NicolaiFransen/Semester-Project-PED1/Reports/P0/P0.tex

\input{../Preamble/Preamble}
\usepackage[export]{adjustbox}

\newcommand\tab[1][1cm]{\hspace*{#1}}

\begin{document}
	
\begin{titlingpage}

\newcommand{\HRule}{\rule{\linewidth}{0.1mm}} % Defines a new command for the horizontal lines, change thickness here

\vspace*{-2cm}
\begin{figure}[htbp]
	\begin{center}
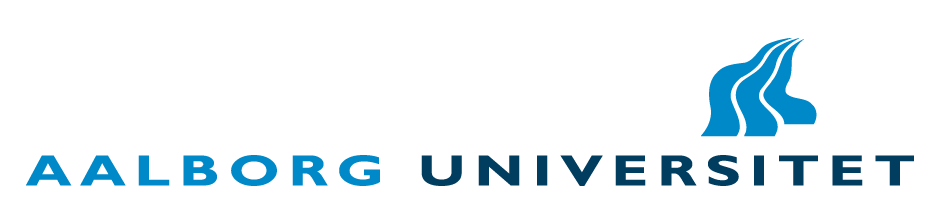
[picture p1: Reports/Pictures/AAU_logo.png]
		
		\label{aau_logo}
	\end{center}	
\end{figure}

\vspace*{2cm}
\begin{figure}[htbp]
	\begin{center}
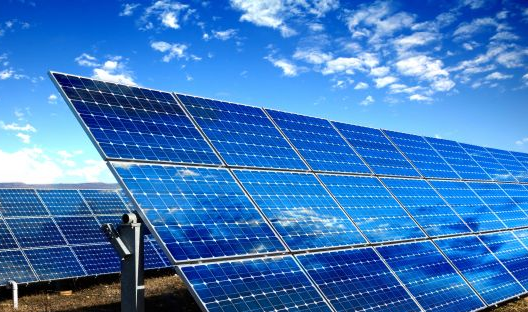
[picture p2: Reports/Pictures/frontpage_pvpanel.png]
		
		\label{frontpage}
	\end{center}	
\end{figure}

\begin{center}
\vspace*{0.5cm}
\HRule \\[0.8cm]
{\huge \bfseries \textsc{DC-DC Converter for PV Module Integration}}\\[0.2cm]
\HRule \\[1.5cm]

\textsc{\textbf{Estefanía Ruiz, Aitor Teran, Nicolai H. Fransen, Jesper Kloster, Thassilo Lang \& Nicolás Murguizur Bustos}}

\vspace*{1cm}
\textsc{\textbf{Supervisors: Lajos Török \& Dezso Sera}}
\end{center}
\end{titlingpage}

\vspace*{1cm}
\begin{table}[H]
	\begin{tabular}{l l} 
		\textbf{Title} &  \textbf{DC-DC Converter for PV Module Integration} \\ 
		\textbf{Semester} & \textbf{$7^{th}$ INTRO}  \\ 
		\textbf{Project Period} & \textbf{10.09.2018 - 19.12.2018}  \\ 
		\textbf{ECTS} &  \textbf{10}\\ 
		\textbf{Supervisors} & \textbf{Lajos Török \& Dezso Sera}  \\ 
		\textbf{Group} & \textbf{INTRO-760}  \\ 
	\end{tabular}
\end{table}

%\vspace*{1cm}
\begin{center}	
	\vspace{40pt}
	\begin{minipage}{0.4\linewidth}
		\centering
		\hrule
		\vspace{12pt}
		Estefanía Ruiz\\ 
		20181097
	\end{minipage}
	\hspace{10pt}
	\vspace{40pt}
	\begin{minipage}{0.4\linewidth}
		\centering
		\hrule
		\vspace{12pt}
		Aitor Teran\\ 
		20186474	
	\end{minipage}
	\hspace{10pt}
	\vspace{40pt}
	\begin{minipage}{0.4\linewidth}
		\centering
		\hrule
		\vspace{12pt}
		Nicolai H. Fransen\\
		20181094
	\end{minipage}
	\hspace{10pt}
	\begin{minipage}{0.4\linewidth}
		\centering
		\hrule
		\vspace{12pt}
		Jesper Kloster\\
		20181081 
	\end{minipage}
	\hspace{10pt}
	\begin{minipage}{0.4\linewidth}
		\centering
		\hrule
		\vspace{12pt}
		Thassilo Lang\\ 
		20186559 
	\end{minipage}
	\hspace{10pt}
	\vspace{20pt}
	\begin{minipage}{0.4\linewidth}
		\centering
		\hrule
		\vspace{12pt}
		Nicolás Murguizur Bustos\\ 
		20181086
	\end{minipage}
\end{center}

%\vspace{3cm}
\begin{tcolorbox}
\textbf{Synopsis:}\newline
PV modules must work at their maximum power point in order to achieve the highest overall efficiency. Several environmental conditions can affect the output power of the PV modules.\newline
This project will address these problems, by implementing a MIC including a MPPT algorithm. The MIC will minimize the power losses and therefore increase the efficiency.\newline
The purpose of this report is to define the boundaries of the project. This includes the main objectives and the initial research. Furthermore there have been included a gantt chart of the entire project.
\end{tcolorbox}

\vspace*{0.5cm}
\textbf{By signing the document, members of the group accepts that the entire group have participated in the work of the report. Therefore, all members vouch for the content of the report, and confirms that it doesn't include plagiarism.}

\clearpage
\tableofcontents

\input{docs/preface.tex}
\input{docs/summary.tex}
\input{docs/Nomenclature.tex}

\input{docs/introduction/introduction.tex}
\input{docs/problemAnalysis/problemAnalysis.tex}
\input{docs/background/background.tex}
\input{docs/futureWork/futureWork.tex}
\input{docs/appendix/appendix}

%\clearpage

\printbibliography

\end{document}
