NicolaiFransen/Semester-Project-PED1/Reports/P1/docs/frontpage.tex

\pdfbookmark[0]{Front page}{label:frontpage}%
\begin{titlepage}
\vspace*{\fill}
    \backgroundsetup{
    scale=1.1,
    angle=0,
    opacity=1.0,  %% adjust
    contents={}
    }
  \addtolength{\hoffset}{0.5\evensidemargin-0.5\oddsidemargin} %set equal margins on the frontpage - remove this line if you want default margins
  \noindent%
  {\color{white}\fboxsep0pt\colorbox{aaublue}{\begin{tabular}{@{}p{\textwidth}@{}}
    \begin{center}
    \Huge{\textbf{
      DC-DC Converter for PV Module Integration% insert your title here
    }}
    \end{center}
    \begin{center}
      \Large{
        %Development of a predictive model% insert your subtitle here
      }
    \end{center}
    %\vspace{0.2cm}
   \begin{center}
    {\Large
     Estefanía Ruiz, Aitor Teran, Nicolai Fransen, Jesper Kloster, Thassilo Lang,  Nicolás Murguizur Bustos% insert names separated by comma
    }\\
    \vspace{0.4cm}
    {\large
      Energy Technology, INTRO-760, 2018-12% insert name of study, group number, year-month
    }
   \end{center}
   \vspace{0.2cm}
%% Comment this section in if you are doing Bachelor or Master Project   
   \begin{center}
    {\Large
      Master's Project
      %Bachelor Project
    }
   \end{center}
  \end{tabular}}}
  \vfill
  \begin{center}
    % comment this line in for English version
    %\includegraphics[width=0.2\paperwidth]{AAUgraphics/aau_logo_circle_da} %comment this line in for Danish version
  \end{center}
\end{titlepage}
\clearpage
