NicolaiFransen/Semester-Project-PED1/Reports/P1/docs/Appendix/openloop_ripple_sim.tex

%%% Appendix including ripple stuf %%%

\chapter{Open-loop ripple results}
\vspace{-1cm}
The measurements of the current and the voltage ripples are included in this section. Furthermore the section is divided in the simulation and experimental results.
 \label{app:OL_ripple}
 
\section{Simulation}
The figures in this section show the waveforms of the current and voltage ripples under worst case conditions. These conditions have been described during the calculations of the passive components in section \ref{component_sizing}. The maximum, minimum and mean values are read and used to calculated the ripples in section \ref{opsimresult}. The data from the simulations have been loaded into Matlab to achieve accurate readings.

Figure \ref{fig:inductor_ripple} shows the current ripple in the inductor. The maximum and minimum currents are read as $I_{max} = 3.465A$ and $I_{min} = 3.135A$, with a mean at $\widebar{I_L} = 3.3A$.

Figure \ref{fig:output_voltage_ripple} shows the voltage ripple at the output capacitor. The maximum and minimum voltages are read as $V_{max} = 55.156$ and $V_{min} = 54.879V$, with a mean at $\widebar{V_{out}} = 55.018V$. 

Figure \ref{fig:input_voltage_ripple} shows the voltage ripple at the input capacitor. The maximum and minimum voltages are measured as $V_{max} = 36.9419V$ and $V_{min} = 36.905V$, with a mean at $\widebar{V_{in}} = 36.9235V$.

\begin{figure}[H]
	\begin{minipage}[c]{0.5\textwidth}
		\centering
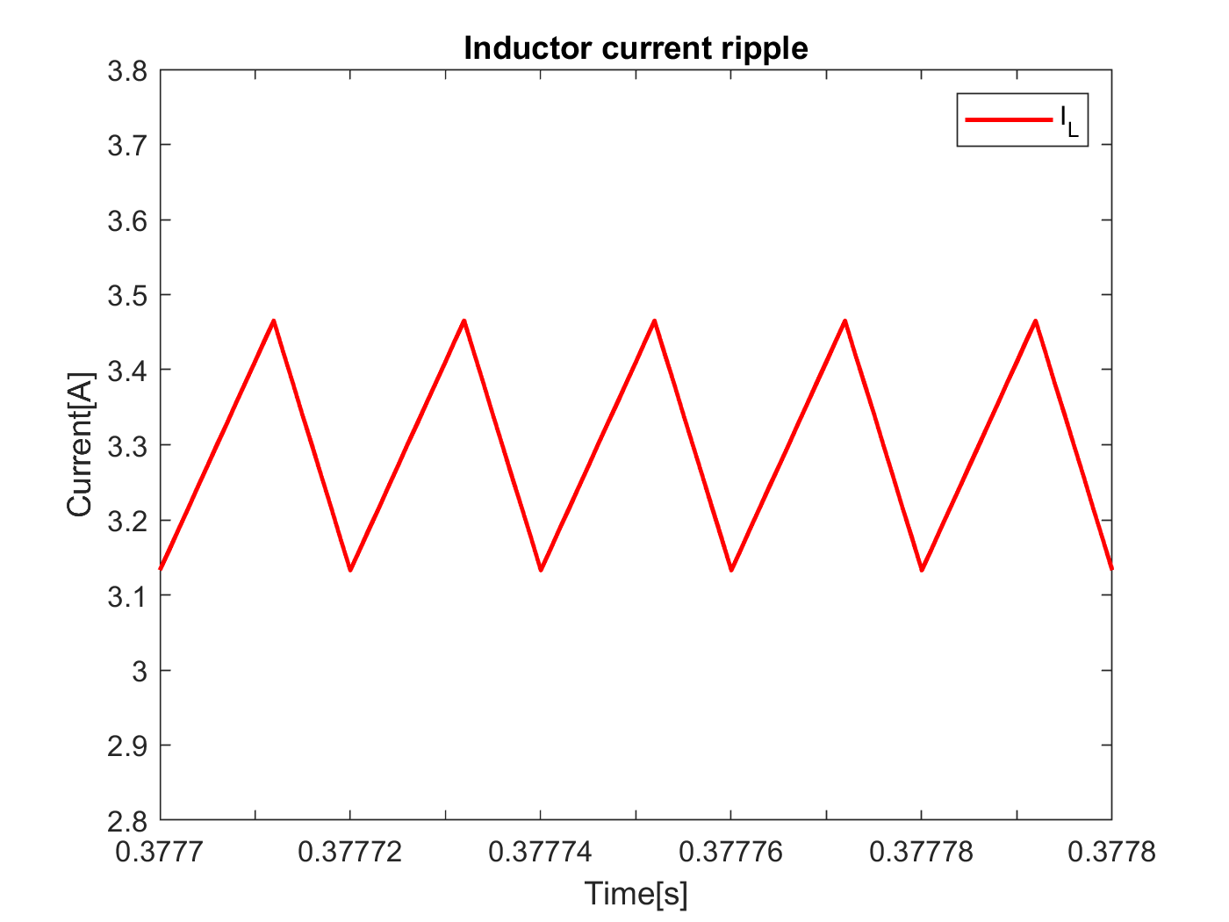
[picture p7: Reports/Pictures/P1/Open_loop_simulation/open_loop_IL_ripple.png]
		 % Left picture
		\caption{Inductor current ripple.}
		\label{fig:inductor_ripple}
	\end{minipage}
	\hfill
	\begin{minipage}[c]{0.5\textwidth}
		\centering
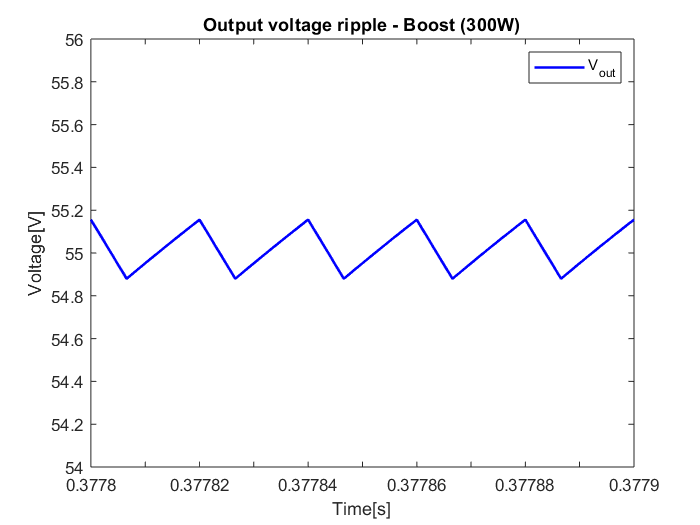
[picture p8: Reports/Pictures/P1/Open_loop_simulation/open_loop_Vout_ripple.png]
		 % Right picture
		\caption{Output voltage ripple.}
		\label{fig:output_voltage_ripple}
	\end{minipage}  
\end{figure}

\begin{figure}[H]
	\begin{center}
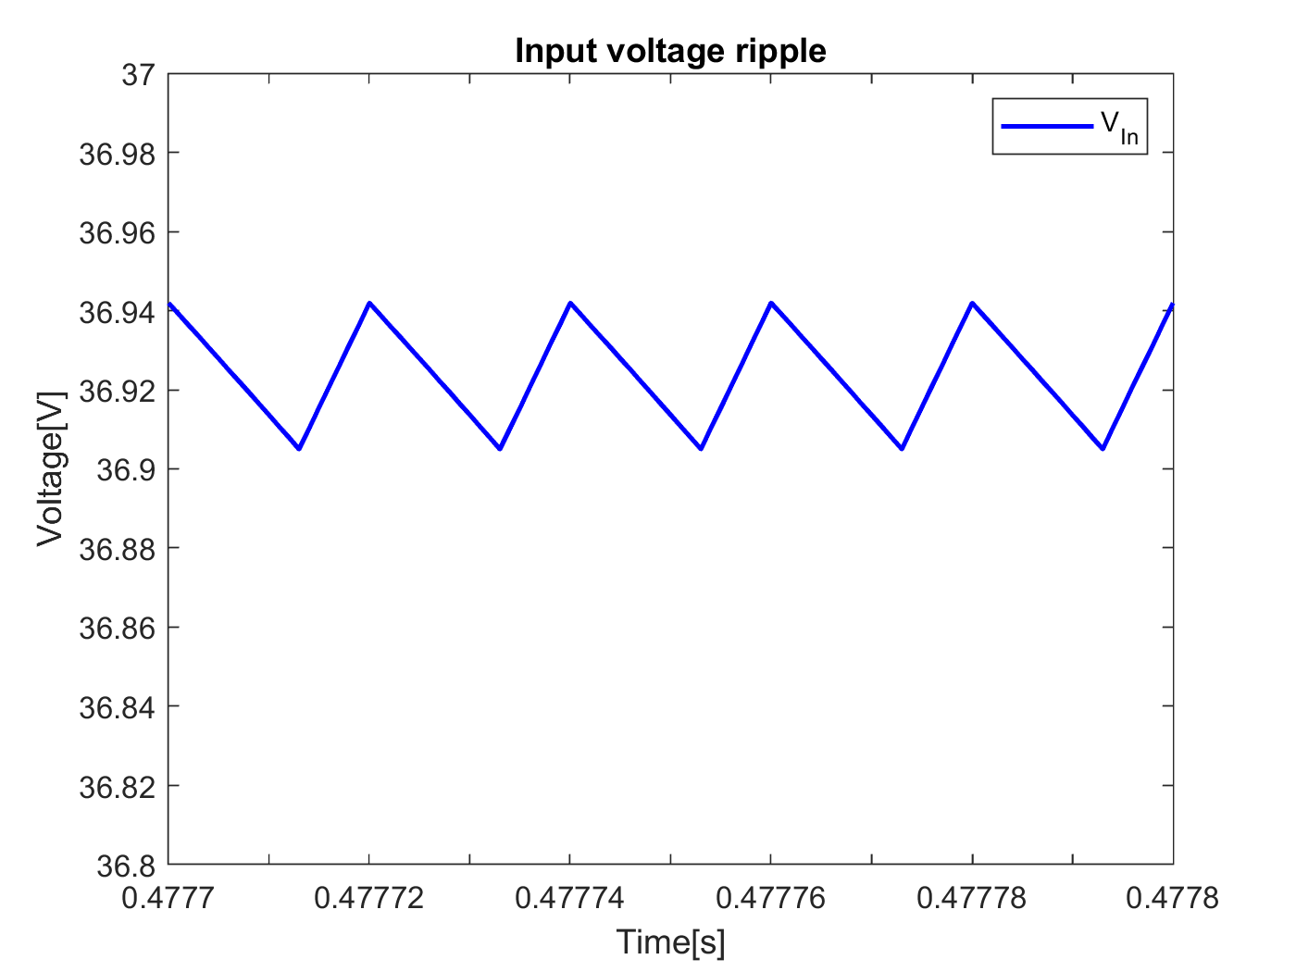
[picture p9: Reports/Pictures/P1/Open_loop_simulation/open_loop_Vin_ripple.png]
		
		\caption{Input voltage ripple.}
		\label{fig:input_voltage_ripple}
	\end{center}	
\end{figure}

\section{Experiment}

The signal of the input capacitor voltage is not clear enough to determine a ripple \ref{Openlooptestinputcapacitor}, the observed behavior might be due to ringing.

\begin{figure}[H]
	\begin{center}
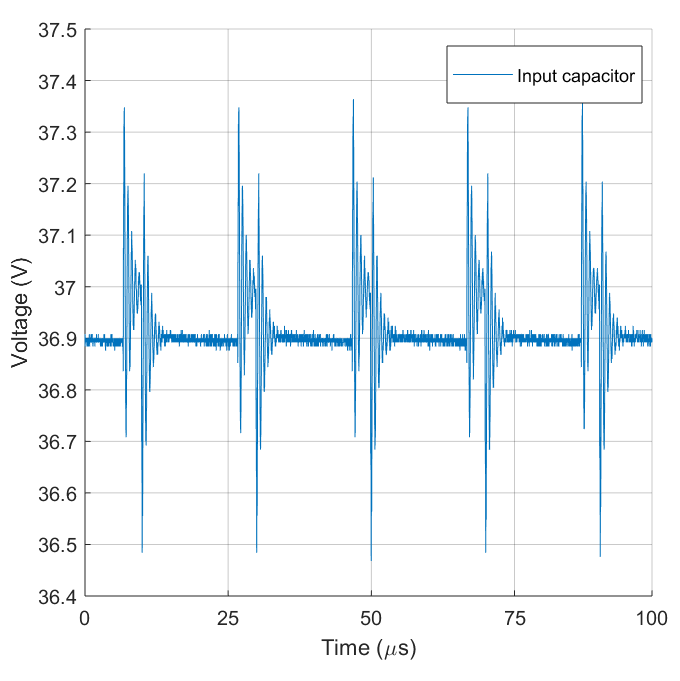
[picture p10: Reports/Pictures/P1/Test/Openloopinputcapacitor.png]
		
		\caption{Open-loop test: Input capacitor ripple.}
		\label{Openlooptestinputcapacitor}
	\end{center}	
\end{figure}

The figure \ref{Openlooptestoutputtcapacitor} presents the voltage ripple at the output capacitor. For the equation \ref{eq:output_voltage_rippleexperiment} the values $V_{out,max} = 23.908V$, $V_{out,min} = 23.895V$ and $\widebar{V_{out}} = 23.902V$ are used from the figure  \ref{Openlooptestoutputtcapacitor}.

\begin{figure}[H]
	\begin{center}
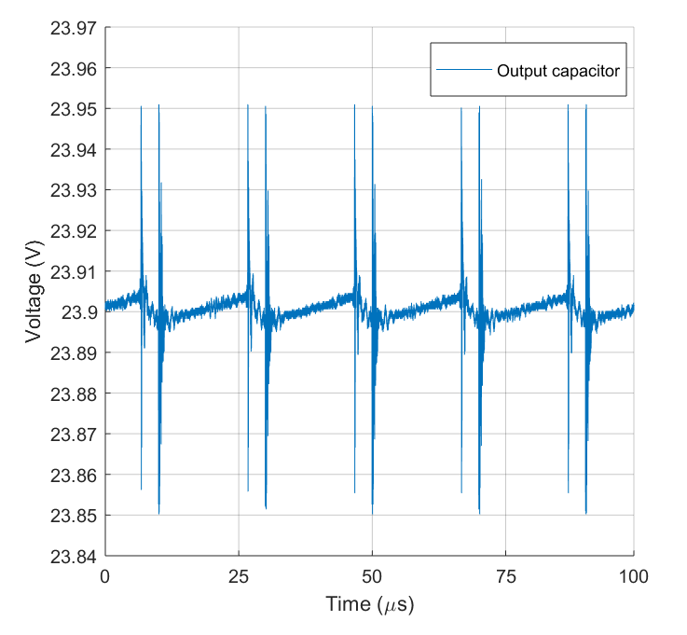
[picture p11: Reports/Pictures/P1/Test/Openloopoutputcapacitor.png]
		
		\caption{Open-loop test: Output capacitor ripple.}
		\label{Openlooptestoutputtcapacitor}
	\end{center}	
\end{figure}

The figure \ref{Openlooptestinductor} shows the current ripple at the inductor. From this figure it can be obtained  the minimum current as $I_{min} = 2.70A$ and the maximum current as $I_{max} = 2.98A$. The mean value for the inductor current is $\widebar{I_L}= 2.84$.

\begin{figure}[H]
	\begin{center}
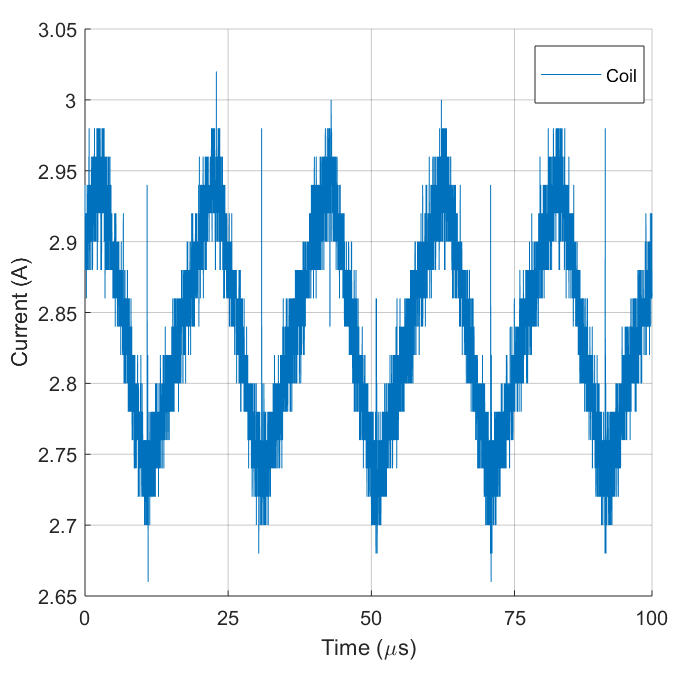
[picture p12: Reports/Pictures/P1/Test/Openloopinductor.png]
		
		\caption{Open-loop test: Inductor current ripple.}
		\label{Openlooptestinductor}
	\end{center}	
\end{figure}
