NicolaiFransen/Semester-Project-PED1/Reports/P1/docs/hardwareImplementation/hardwareImplementation.tex

%%% Chapter 5 - Hardware Implementation %%%

\chapter{Hardware implementation} \label{ch:hardware_implementation}
\input{docs/hardwareImplementation/intro.tex}

\section{Selection of commercial components}

\subsection{Passive components}

Passive components include input and output capacitors and the inductor. The needed values were calculated in section \ref{component_sizing}. However, no tolerance or safety margin are included in those calculations. By the nature of the project, the goal is not to optimize price or size, but to validate the technical feasibility of the MPPT. 

The necessary input capacitance is $1540 \mu F$. A safety margin of $20 \%$ has been applied resulting in a necessary input capacitance of $1850 \mu F$. In order to achieve this value, 4 capacitors have been associated in parallel. When paralleling the capacitors the total parasitic inductance and resistance will decrease and ease the heat dissipation task \cite{capacitor_paracitics}. Four electrolytic capacitors of $470\mu F$ \cite{cin} are placed in parallel to get a summed capacitance of $1880\mu F$. The voltage rating for these is 100V. Because of an early calculation error the output capacitor was selected to be $820\mu F$\cite{cout}, instead of the $88\mu F$ calculated in section \ref{component_sizing}.

Both for the input and output a $100nF$ and a $1\mu F$ capacitors are placed in parallel. These capacitors are SMD technology which have intrinsically low parasitic components. The goal is to support the higher capacitance capacitors during high frequency current peaks\cite{paracitics_stuff}.

The calculated inductance is $1.3 mH$. The inductor is chosen to be a reused inductor from an earlier project, and is measured to have an inductance of $1.93mH$ at $50kHz$. 

\input{docs/converterDesign/Component_sizing/mosfet.tex}
\input{docs/converterDesign/Component_sizing/driver.tex}

\input{docs/converterDesign/sensors/sensors.tex}

\input{docs/converterDesign/component_sizing/power_supplies.tex}

\input{docs/hardwareImplementation/PCB_layout/Schematic.tex}

\input{docs/hardwareImplementation/PCB_layout/PCB_layout.tex}
