NicolaiFransen/Semester-Project-PED1/Reports/P1/docs/controlsystemdesign/controlsystemdesign.tex

%%% This document includes Maximum Power Point Trackingm %%%

\chapter{Maximum power point tracking} \label{MPPT}

\input{docs/controlsystemdesign/MPPT/introduction_MPPT.tex}
%\input{docs/controlsystemdesign/MPPT/Selection_of_MPPT_algorithm.tex}
\input{docs/controlsystemdesign/MPPT/Implementation_of_Perturbobserve_algorithm.tex}
\input{docs/controlsystemdesign/MPPT/Simulation_of_MPPT_algorithm.tex}
