NicolaiFransen/Semester-Project-PED1/Reports/P1/docs/converterDesign/converterDesign.tex

%%% This document includes the Hardware design of the converter %%%

\chapter{Non-inverting buck-boost converter design} \label{converter_design}
\input{docs/converterDesign/intro.tex}

\input{docs/P0/background/selection.tex}

\input{docs/converterDesign/component_sizing/component_sizing.tex}
