NicolaiFransen/Semester-Project-PED1/Reports/P1/docs/converterDesign/intro.tex

%%% Introduction to the chapter: Non-inverting buck-boost converter design %%%

This chapter contains the analysis of the non-inverting buck-boost converter. The first part contains the selection of the converter's topology and the requirements which will be used during the design phase of the project. The second part includes the sizing of the passive components and the results of the open-loop simulation of the converter.
