NicolaiFransen/Semester-Project-PED1/Reports/P1/docs/Appendix/PCBandSCH.tex

\chapter{PCB layout and schematics}\label{ch:AppPCB} 

\begin{figure}[H]
	\begin{center}
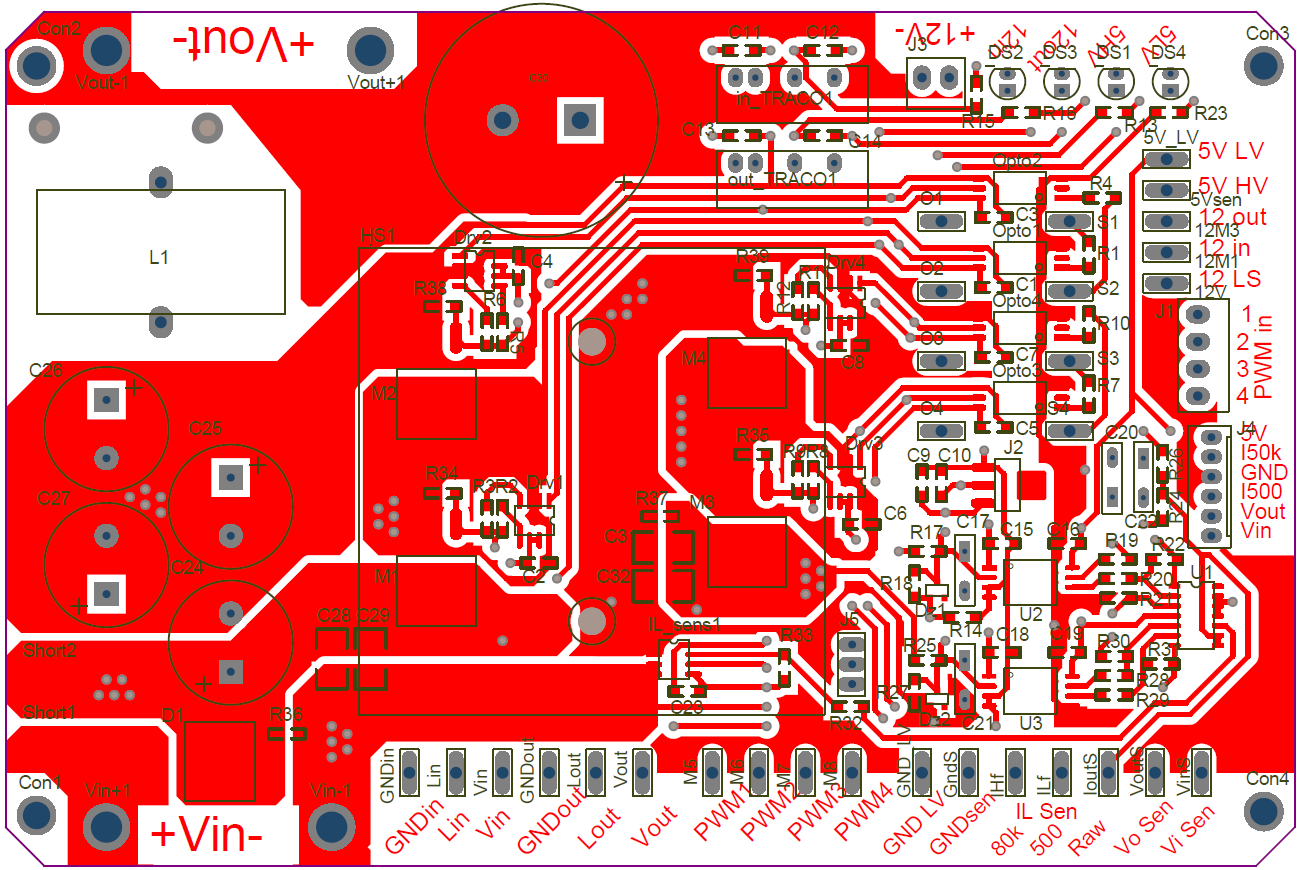
[picture p18: Reports/P1/docs/Appendix/PCB_TopLayer.PNG]
		
		\caption{PCB top layer.}
		\label{PCB_TopLayer}
	\end{center}	
\end{figure}

\begin{figure}[H]
	\begin{center}
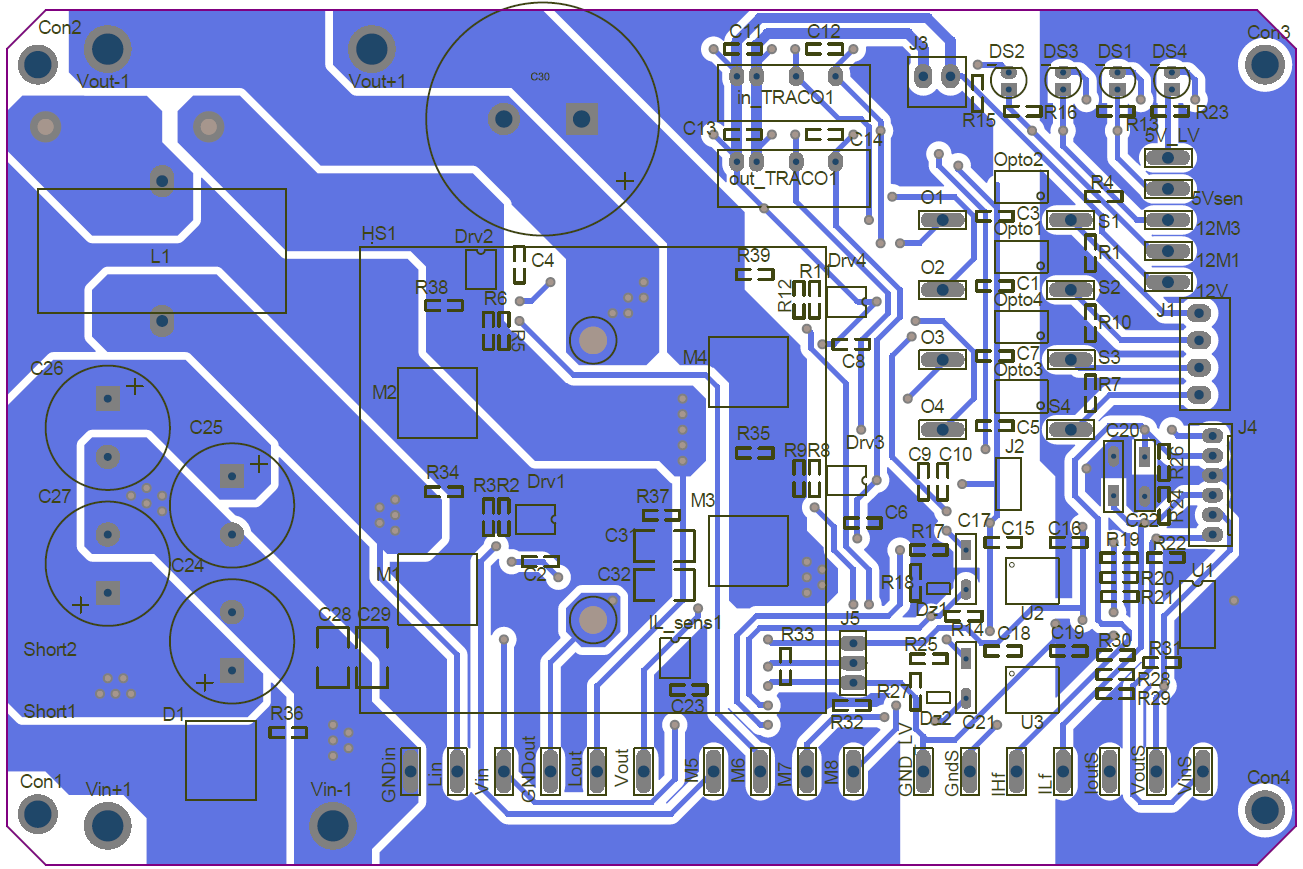
[picture p19: Reports/P1/docs/Appendix/PCB_BottomLayer.PNG]
		
		\caption{PCB bottom layer.}
		\label{PCB_BottomLayer}
	\end{center}	
\end{figure}

\includepdf[pages=-, landscape=true]{docs/Appendix/SCH_MIC_760_V2.pdf}
