NicolaiFransen/Semester-Project-PED1/Reports/P1/docs/controlsystemdesign/MPPT/Simulation_of_MPPT_algorithm.tex

\section{Simulation of the MPPT algorithm} \label{MPPTSimulation}

The results obtained in simulation for the previously explained P\&O algorithm will be shown in this section. First, the results corresponding to the PV panel model will be evaluated without connecting it to the DC-DC converter. Once the model for the PV panel is validated, the results obtained for the complete system will be analyzed in order to show the performance of the MPPT algorithm under different environmental conditions and resistive loads.  

\subsection{Model of the PV panel}

This section shows the model and the results obtained from a commercial solar panel selected for the development of this project. The PV panel which will be utilized for the test of the MPPT is \textit{Suntech STP300-24/Vd} \cite{PV_panel}. As a result of the PV panel's model, the characteristic curves of the panel will be presented showing its behavior under variations in solar irradiance and temperature.

One of the most common methods for modeling a solar panel is using the equivalent circuit of a solar cell shown in figure \ref{fig:eq_circuit_PVcell}. The model can be represented as a current source connected in parallel and reversed polarity with a diode \cite{MPPTResearch}. In addition, to model the non-linear behaviour of the solar panel I-V curve the equivalent series and parallel resistance ($R_{s}$ and $R_{p}$) are inserted \cite{MPPTResearch}.

\begin{figure}[H]
	\begin{center}
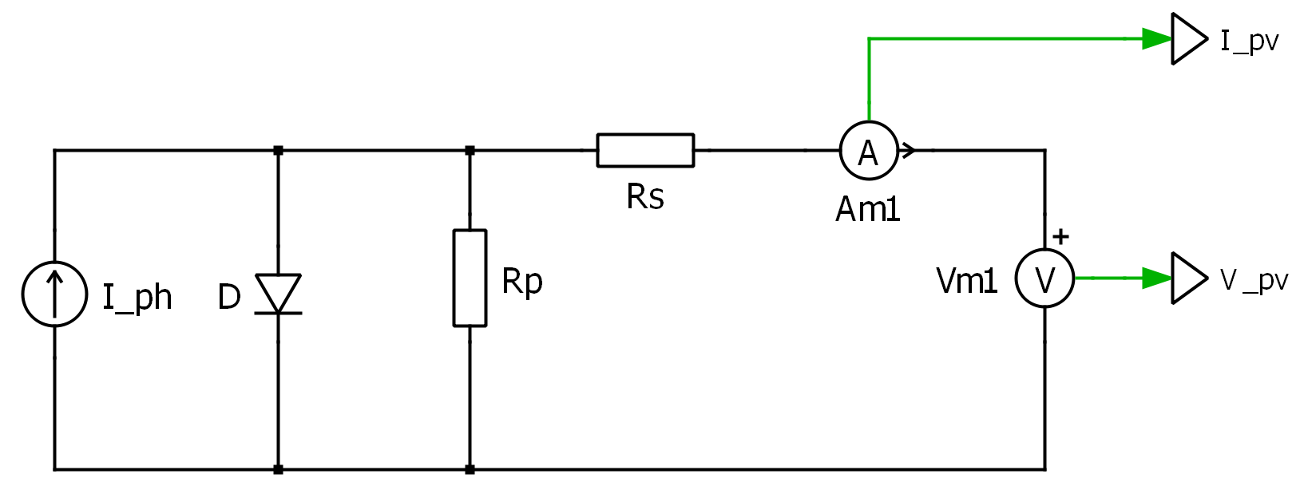
[picture p24: Reports/Pictures/schematic_solar_cell.png]
		
		\caption{Equivalent circuit for modeling a PV cell.}
		\label{fig:eq_circuit_PVcell} 
	\end{center}	
\end{figure}

The mathematical equation that describes the circuit is obtained applying Kirchoff's law to separate the current flowing through the different components of the circuit. This results in equation \ref{eq:pv_cell} where $I_{PV}$ is the panel's current, $I_{ph}$ is the photogenerated current, the second term is the current flow in the diode and the last term is the current flow in the parallel resistance \cite{MPPTResearch}. 

\begin{equation} \label{eq:pv_cell}
I_{PV} = I_{ph} - I_{o} \cdot \left[ e^{\left({\dfrac{V_{PV} + R_s\cdot I_{PV}}{a \cdot V_{t}}}\right)}  - 1 \right]  - \dfrac{V_{PV} + R_{s}\cdot I_{PV}}{R_{p}}
\end{equation}

The second term corresponds to the Shockley equation where $I_{o}$ is the saturation current of the diode, $a$ is the diode's quality factor and $V_{t}$ is the thermal voltage defined by equation \ref{eq:Vt}.

\begin{equation} \label{eq:Vt}
V_{t}=\dfrac{N_{cells}\cdot K\cdot T}{q} 
\end{equation}

$N_{cells}$ is the number of series connected cells (in this case 72), K is the Boltzmann constant ($1.38 \cdot 10^{-23} J/K$), T is the temperature in kelvins and q is the electrical charge ($1.6 \cdot 10^{-19} C$) \cite{MPPTResearch}.

However, as the focus of this project is not the modelling of the PV panel, the value of the PV panel's parameters such as $R_{s}$, $R_{p}$ and $a$ required for the model will not be calculated. Instead, these values will be taken from the corresponding PV array block for the selected panel available in Simulink. All the values for the PV panel's electrical parameters corresponding to Standard Test Conditions (STC) are shown in table \ref{el_charact_PV_panel_Suntech}.

\begin{table}[H]
	\centering
	\begin{tabular}{|p{8cm}|>{\centering}p{6cm}|}
		\hline
		\rowcolor{lightgray}\multicolumn{2}{|l|}{ \textbf{Electrical characteristics under STC}} 
		\\ \hline
		Maximum power ($P_{max}$) & 300.4 [W]  \tabularnewline \hline
		Optimum Operating Voltage ($V_{MPP}$) & 36.9 [V]  \tabularnewline \hline
		Optimum Operating Current ($I_{MPP}$) & 8.14 [A]  \tabularnewline \hline
		Open Circuit Voltage ($V_{OC}$) &  45 [V] \tabularnewline \hline
		Short Circuit Current ($I_{S C}$) & 8.67 [A]  \tabularnewline \hline
		Module Efficiency ($\eta$) & 15.5 \%  \tabularnewline \hline
		Operating Module Temperature & -40$\dec$C to +85$\dec$C \tabularnewline \hline
		Series Resistance ($R_{s}$) & 0.266 [$\Omega$] \tabularnewline \hline
		Parallel Resistance ($R_{p}$) & 665.2 [$\Omega$] \tabularnewline \hline
		Diode quality factor ($a$) & 1.1098 \tabularnewline \hline
	\end{tabular}
	\caption{Electrical characteristics PV module \textit{Suntech STP300-24/Vd} \cite{PV_panel}.}
	\label{el_charact_PV_panel_Suntech}
\end{table}

Using the aforementioned model of the PV panel, it is possible to obtain the characteristic curves of the panel.  Usually, PV panels are tested under STC to indicate the performance of the PV modules. The STC test is carried out with a cell's temperature of $25^\circ$C and at a solar irradiance of 1000 $W/ m^2$ \cite{handbook}. The higher the solar irradiance, the more power is generated from the PV panel. On the other hand, when the temperature of the PV cell increases the PV panel generates less power than at a lower temperature \cite{handbook}. 

Figures \ref{fig:PVcurves_T25} and \ref{fig:IVcurves_T25} show the P-V and I-V curves of the solar panel with constant cell temperature ($T=25\dec C$) and varying the level of irradiance. 
As expected, the lower the level of irradiance the maximum power that the panel is capable of generating decreases. It can be validated that under STC the values for $V_{MPP}$ and $I_{MPP}$ from table \ref{el_charact_PV_panel_Suntech}  correspond to the values obtained in simulation. Table \ref{constantemptable} shows that a change in irradiance has as a consequence a high variation in $I_{MPP}$ but $V_{MPP}$ does not reflect a significant variation.  

\begin{figure}[H]
	\begin{center}
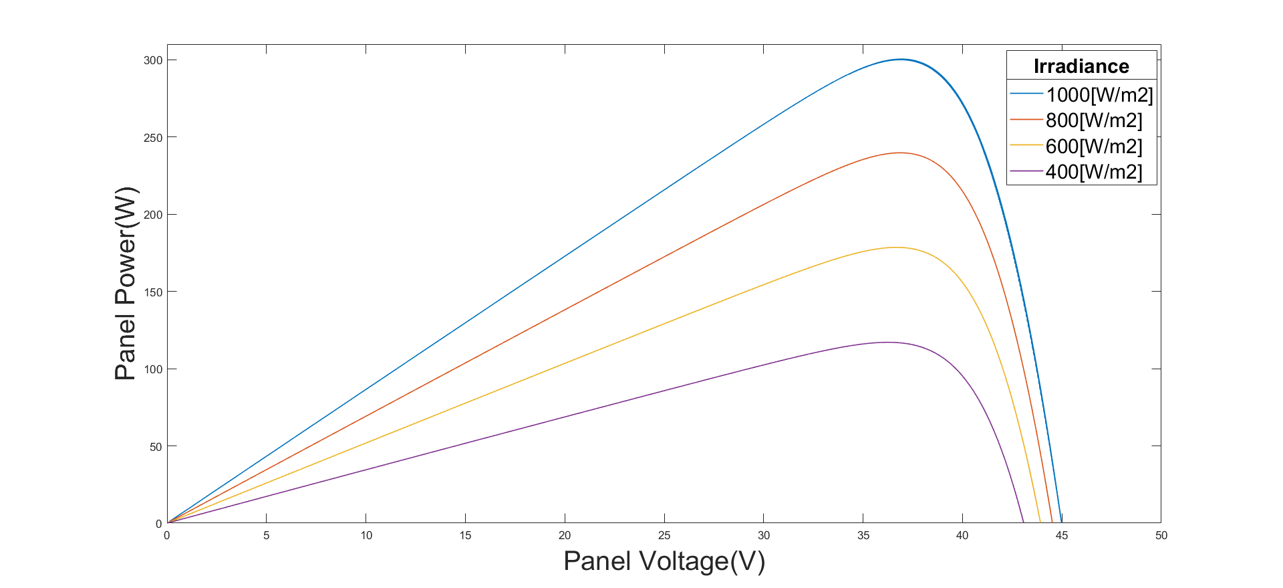
[picture p25: Reports/Pictures/constant_temperature.png]
		
		\caption{P-V curves for constant temperature (25$\dec$C) and change in irradiance.}
		\label{fig:PVcurves_T25} 
	\end{center}	
\end{figure}

\begin{figure}[H]
	\begin{center}
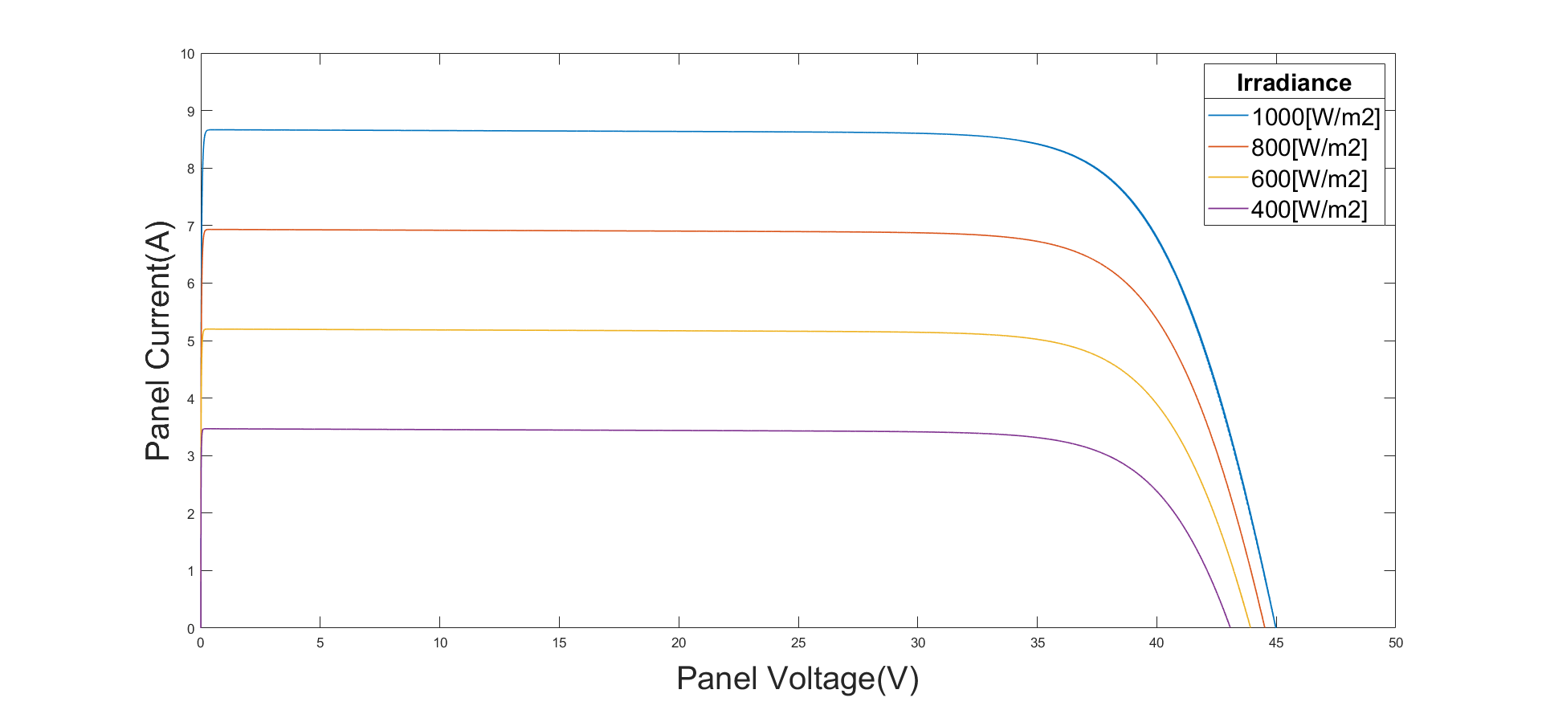
[picture p26: Reports/Pictures/constant_temperature_iv.png]
		
		\caption{I-V curves for constant temperature (25$\dec$C) and change in irradiance.}
		\label{fig:IVcurves_T25} 
	\end{center}	
\end{figure}

\begin{table}[H]
	\centering
	\begin{tabular}{|p{2cm}|>{\centering}p{2cm}|>{\centering}p{2cm}|>{\centering}p{2cm}|>{\centering}p{2cm}|}
		\hline
		\rowcolor{lightgray}\multicolumn{5}{|l|}{ \textbf{Constant temperature and varying irradiance}} 
		\\ \hline
		& 1000$W/ m^2$ & 800$W/ m^2$  & 600$W/ m^2$  & 400$W/ m^2$ \tabularnewline \hline
		$V_{MPP}$ [V] & 36.9 & 36.87 & 36.68 & 36.19 \tabularnewline \hline
		$I_{MPP}$ [A] & 8.14 & 6.49 & 4.86 & 3.23 \tabularnewline \hline
		$P_{MPP}$ [W] &  300.4 &  239.5 &  178.5 &  117 \tabularnewline \hline
	\end{tabular}
	\caption{PV panel parameters for varying irradiance and constant temperature of 25$\dec C$.}
	\label{constantemptable}
\end{table}

On the other hand, figures \ref{fig:PVcurves_Irr1000} and \ref{fig:IVcurves_Irr1000} show the characteristic curves with constant irradiance (1000$W/ m^2$) and under temperature variation.

\begin{figure}[H]
	\begin{center}
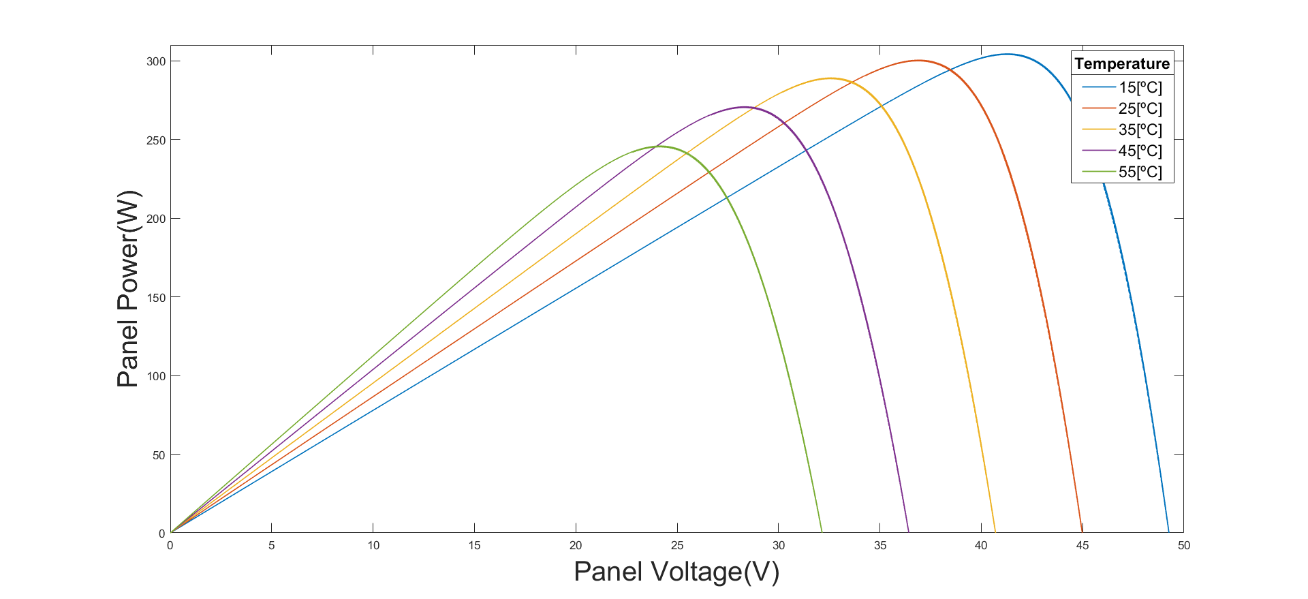
[picture p27: Reports/Pictures/constant_irradiance_T15.png]
		
		\caption{P-V curves for constant irradiance (1000$W/ m^2$) and change in temperature.}
		\label{fig:PVcurves_Irr1000} 
	\end{center}	
\end{figure}

\begin{figure}[H]
	\begin{center}
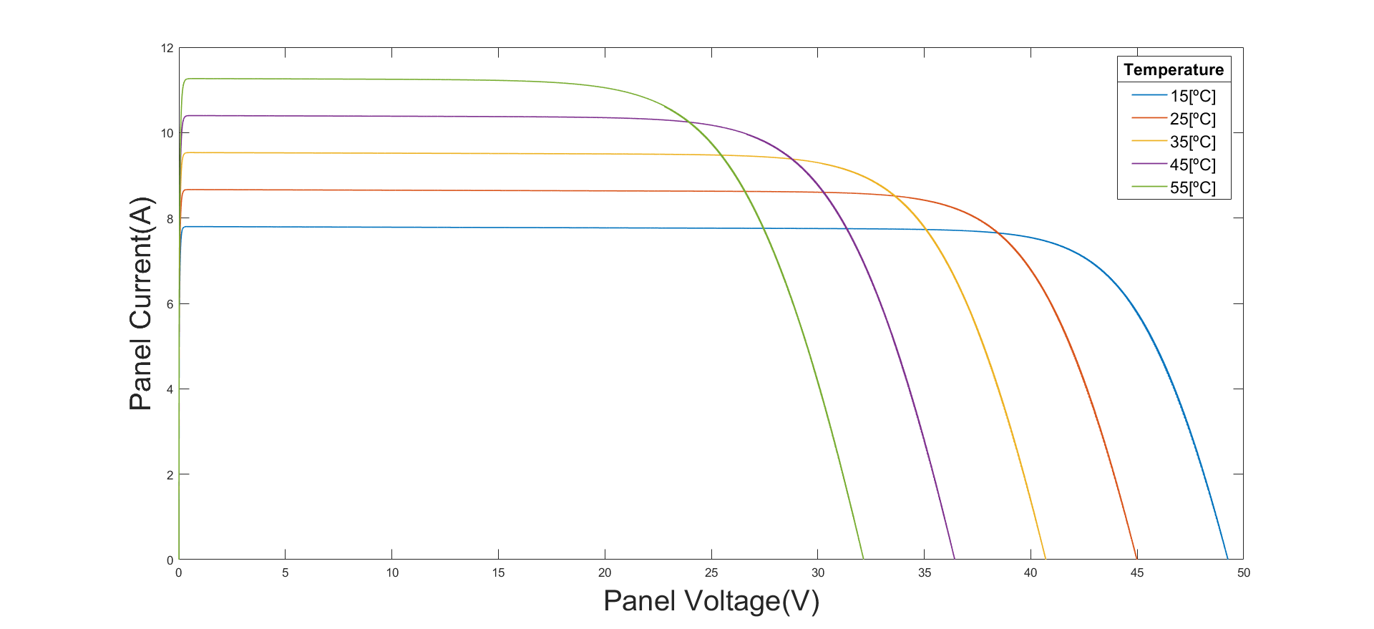
[picture p28: Reports/Pictures/iv_constant_irradiance_T15.png]
		
		\caption{I-V curves for constant irradiance (1000$W/ m^2$) and change in temperature.}
		\label{fig:IVcurves_Irr1000} 
	\end{center}	
\end{figure}

 It is observed from table \ref{constantirradtable} that an increase in the temperature means that the maximum power that the panel is able to generate decreases. In this case, a change in temperature has as a consequence a high variation of $V_{MPP}$. However, the variation is not that significant in $I_{MPP}$.

\begin{table}[H]
	\centering
	\begin{tabular}{|p{1.8cm}|>{\centering}p{1.8cm}|>{\centering}p{1.8cm}|>{\centering}p{1.8cm}|>{\centering}p{1.8cm}|>{\centering}p{1.8cm}|}
		\hline
		\rowcolor{lightgray}\multicolumn{6}{|l|}{ \textbf{Constant irradiance and varying temperature}} 
		\\ \hline
		& T=15$\dec C$  & T=25$\dec C$  & T=35$\dec C$  & T=45$\dec C$  & T=55$\dec C$ \tabularnewline \hline
		$V_{MPP}$ [V] & 41.45 & 36.9 & 32.59 & 28.34 & 24.23\tabularnewline \hline
		$I_{MPP}$ [A] & 7.33 & 8.14 & 8.85 & 9.59 & 10.12 \tabularnewline \hline
		$P_{MPP}$ [W] & 304.3 & 300.4 &  289.1 &  270.7 &  245.8 \tabularnewline \hline
	\end{tabular}
	\caption{Results of the optimum PV panel parameters for varying temperature and constant irradiance of 1000 $W/ m^2$.}
	\label{constantirradtable}
\end{table}

\subsection{Simulation results}

\iffalse
\begin{figure}[H]
	\begin{minipage}[c]{0.6\textwidth}
		\centering
		 % Left picture
	\end{minipage}%
	\hfill
	\begin{minipage}[c]{0.6\textwidth}
		\centering
		 % Right picture
	\end{minipage} \\ % Captions og labels
	\begin{minipage}[t]{0.6\textwidth}
		\caption{buck STC V,I,P.} % Left caption and label
		%\label{buckSTC}
	\end{minipage}%
	\hfill
	\begin{minipage}[t]{0.6\textwidth}
		\caption{boost STC V,I,P} % Right caption and label
		%\label{boostSTC}
	\end{minipage}
\end{figure}

\begin{figure}[H]
	\begin{minipage}[c]{0.6\textwidth}
		\centering
		 % Left picture
	\end{minipage}%
	\hfill
	\begin{minipage}[c]{0.6\textwidth}
		\centering
		 % Right picture
	\end{minipage} \\ % Captions og labels
	\begin{minipage}[t]{0.6\textwidth}
		\caption{buck STC duty vin vs vout} % Left caption and label
		%\label{buckSTC_duty}
	\end{minipage}%
	\hfill
	\begin{minipage}[t]{0.6\textwidth}
		\caption{boost STC duty vin vs vout} % Right caption and label
		%\label{boostSTC_duty}
	\end{minipage}
\end{figure}
\fi 

In this section, the results obtained in simulation for the entire system will be presented. The discussion of the results is carried out in section \ref{MPPT_discussion}. The system includes the solar panel, the non-inverting buck-boost converter and the MPPT controller unit as shown in figure \ref{BD_POalgorithm}. The simulated results will be analyzed to determine the performance of the MPPT and will be divided in three parts: 
\begin{itemize}
	\item[--] Results obtained under STC. The STC test is carried out at a solar cell's temperature of $25^\circ$C and at a solar irradiance of 1000 $W/ m^2$ \cite{handbook}.
	\item[--] Results obtained under STC in the boundary between the modes of operation.
	\item[--] Results obtained under a sudden change in the solar irradiance and temperature.
\end{itemize}

It was decided to use a resistive load to validate the results obtained in the simulation with the experimental results. The simulations will be carried out for two different resistive loads: $R_{L}=3\Omega$ and $R_{L}=27\Omega$. This is done in order to validate the performance of the MPPT controller in both modes of operation. For the case of analyzing the MPPT in the boundary between the modes, resistives loads of values $R_{L}=4.3\Omega$ and $R_{L}=5.3\Omega$ will be used.
 
 \subsubsection*{Standard test conditions}
 
 Figure \ref{buckSTC} shows how the P\&O algorithm searchs for the MPP. The first graph shows a superposition of the PV panel's voltage and current where it is observed that the panel reaches the open-circuit voltage ($V_{OC}=45 V$) and at that moment the MPPT starts searching for the MPP by decreasing the PV voltage. The second graph shows the power generated by the panel which approaches the value of the optimal power under this conditions ($P_{MPP}=300.4 W$). The P\&O algorithm converges to the MPP reaching the steady state in 2 seconds. The MPPT allows to reach the optimal power generated by the panel under these conditions with an efficiency up to $\eta_{MPPT} = 99.96\% $.
\begin{figure}[H]
	\begin{center}
		
		\caption{Voltage, current and power extracted from the PV panel ($R_{L}=3\Omega$).}
		\label{buckSTC} 
	\end{center}	
\end{figure}

The simulation is run under STC and using a resistive load of $3\Omega$. From the first graph of figure \ref{buckSTC_duty} it is observed that the converter is working in buck mode during all the MPPT process. This is because the output voltage does not exceed the input voltage with this resistive load as shown in the second graph. The value of the duty cycle, obtained in simulation under these load and environment conditions, is $D_{buck}= 0.8155$. Using the transfer function of the converter in  buck mode, this value can be validated by calculating the theoretical duty cycle taking as voltage input $V_{MPP}=36.9 V$: 

\begin{equation}\label{buckmodeTF}
D = \frac{V_{out}}{V_{in}} = \frac{30V}{36.9V}= 0.8130 
\end{equation}

\begin{figure}[H]
	\begin{center}
		
		\caption{Converter's mode of operation as a function of the control variable ($R_{L}=3\Omega$).}
		\label{buckSTC_duty} 
	\end{center}	
\end{figure}

The same simulation was performed but in this case using a value of the resistive load of $27\Omega$. From figure \ref{boostSTC} it is observed that the MPPT needs more time than before to converge to the MPP. The P\&O algorithm needs 4 seconds to reach the MPP which means double of the time than with $R_{L}=3\Omega$. This occurs because the output voltage starts increasing from 0 to its final value. This means that the system will start working in buck mode and once the output voltage reaches the value of the input voltage it will switch to boost mode. Despite the higher converging time to the MPP, the P\&O algorithm performance has not experience a significant difference. The MPPT is able to operate with an efficiency up to $\eta_{MPPT} = 99.82\% $.

\begin{figure}[H]
	\begin{center}
		
		\caption{Voltage, current and power extracted from the PV panel ($R_{L}=27\Omega$).}
		\label{boostSTC} 
	\end{center}	
\end{figure}

Figure \ref{boostSTC_duty} shows how the converter starts operating in buck mode until the output voltage equals the input voltage. At this point is the limit between the two modes of operation and the converter starts working in boost mode. The value of the duty cycle under these load and environment conditions is $D_{boost}= 0.5971$. Using the transfer function of the converter in  buck mode, this value can be validated by calculating the theoretical duty cycle taking as voltage input $V_{MPP}=36.9 V$: 
\begin{equation}
\frac{V_{out}}{V_{in}}= \frac{1}{1-D} \rightarrow D = 1 - \frac{V_{in}}{V_{out}} = 1 - \frac{36.9}{90} = 0.5900
\end{equation}
 
\begin{figure}[H]
	\begin{center}
		
		\caption{Converter's mode of operation as a function of the control variable ($R_{L}=27\Omega$).}
		\label{boostSTC_duty} 
	\end{center}	
\end{figure}

As it was mentioned in section \ref{MPPTImplementation}, oscillations around the MPP can be reduced by using a variable perturb step instead of a fixed one. The proposed P\&O algorithm was simulated under STC for both cases. Figures \ref{buckoscillationfix} and \ref{buckoscillationvar} show the oscillations in buck mode around the MPP for fixed perturb step and variable step, respectively. By comparing the figures, it is seen that oscillations are reduced and, therefore, the MPPT's efficiency is improved from $\eta_{MPPT} = 99.38\% $ to $\eta_{MPPT} = 99.96\% $. Furthermore it can be seen that the period of the oscillation increases. 

On the other hand, figures \ref{boostoscillationfix} and \ref{boostoscillationvar} show the oscillations around the MPP in boost mode for fixed perturb step and variable step, respectively. The improvement in the MPPT's performance is higher than in the case of buck mode. The MPPT's efficiency is improved from $\eta_{MPPT} = 96.40\% $ with fixes step to $\eta_{MPPT} = 99.82\% $ with variable step. 

\begin{figure}[H]
	\begin{minipage}[c]{0.5\textwidth}
		\centering
		 % Left picture
	\end{minipage}%
	\hfill
	\begin{minipage}[c]{0.5\textwidth}
		\centering
		 % Right picture
	\end{minipage} \\ % Captions og labels
	\begin{minipage}[t]{0.45\textwidth}
		\caption{PV panel's power showing oscillations around the MPP with fix perturb step under STC ($R_{L}=3\Omega$).} % Left caption and label
		\label{buckoscillationfix}
	\end{minipage}%
	\hfill
	\begin{minipage}[t]{0.45\textwidth}
		\caption{PV panel's power showing oscillations around the MPP with variable perturb step under STC ($R_{L}=3\Omega$).} % Right caption and label
		\label{buckoscillationvar}
	\end{minipage}
\end{figure}

\vspace{1cm}
\begin{figure}[H]
	\begin{minipage}[c]{0.5\textwidth}
		\centering
		 % Left picture
	\end{minipage}%
	\hfill
	\begin{minipage}[c]{0.5\textwidth}
		\centering
		 % Right picture
	\end{minipage} \\ % Captions og labels
	\begin{minipage}[t]{0.45\textwidth}
		\caption{PV panel's power showing oscillations around the MPP with fix perturb step under STC ($R_{L}=27\Omega$).} % Left caption and label
		\label{boostoscillationfix}
	\end{minipage}%
	\hfill
	\begin{minipage}[t]{0.45\textwidth}
		\caption{PV panel's power showing oscillations around the MPP with variable perturb step under STC ($R_{L}=27\Omega$).} % Right caption and label
		\label{boostoscillationvar}
	\end{minipage}
\end{figure}

\subsubsection*{Boundary between modes of operation}

%10 panels    4.3ohms  299.67W, 1.2seconds, Dbuck = 0.98, Vin= 36.625, Vout = 35.9 V

%9 panels    5.3 ohms  299.82W, 1.5seconds, Dboost=0.079 , Vin=36.7V , Vout=39.88 
This section shows the behaviour of the system, under STC, in the boundary between the two modes of operation, buck and boost. Calculations showed that the boundary would be with 9.75 PV panels. Therefore the system was simulated with both 9 and 10 panels.
The simulations were run first for a resistive load of 4.3$\Omega$ which corresponds to 10 PV panels connected in series. Figures \ref{buckboundary1} and \ref{buckboundary2} show that the converter is working in buck mode with duty cycle $D_{buck}=0.98$. The MPPT's efficiency is $\eta_{MPPT} = 99.75\% $. Figures \ref{boostboundary1} and \ref{boostboundary2} were obtained using a load of 5.3$\Omega$ which corresponds to 9 PV panels connected in series. In this case, the converter is working in boost mode with duty cycle $D_{buck}=0.079$ and the MPPT's efficiency is $\eta_{MPPT} = 99.80\% $. The time it takes for the MPPT to track the MPP is practically the same in both cases. It is then concluded that the MPPT can perform efficiently in the boundary between the two modes of operation.

\begin{figure}[H]

	\begin{minipage}[c]{0.5\textwidth}
		\centering
		 % Left picture
	\end{minipage}%
	\hfill
	\begin{minipage}[c]{0.5\textwidth}
		\centering
		 % Right picture
	\end{minipage} \\ % Captions og labels
	\begin{minipage}[t]{0.45\textwidth}
		\caption{Voltage, current and power extracted from the PV panel ($R_{L}=4.3\Omega$).} % Left caption and label
		\label{buckboundary1}
	\end{minipage}%
	\hfill
	\begin{minipage}[t]{0.45\textwidth}
		\caption{Duty cycles, input voltage and output voltage ($R_{L}=4.3\Omega$).} % Right caption and label
		\label{buckboundary2}
	\end{minipage}
\end{figure}

%\vspace{0.2cm}
\begin{figure}[H]
	\begin{minipage}[c]{0.5\textwidth}
		\centering
		 % Left picture
	\end{minipage}%
	\hfill
	\begin{minipage}[c]{0.5\textwidth}
		\centering
		 % Right picture
	\end{minipage} \\ % Captions og labels
	\begin{minipage}[t]{0.45\textwidth}
		\caption{Voltage, current and power extracted from the PV panel $(R_{L}=5.3\Omega)$.} % Left caption and label
		\label{boostboundary1}
	\end{minipage}%
	\hfill
	\begin{minipage}[t]{0.45\textwidth}
		\caption{Duty cycles, input voltage and output voltage ($R_{L}=5.3\Omega$).} % Right caption and label
		\label{boostboundary2}
	\end{minipage}
\end{figure}

\subsubsection*{Change in irradiance and temperature}

This section shows the performance of the MPPT when the PV panel is exposed to a sudden change in irradiance and in temperature. First, figures \ref{buckirradiance} and \ref{boostirradiance} show the results obtained for a change in irradiance for the case of buck and boost mode, respectively. The irradiance change is from 1000 $W/ m^2$ to 800 $W/ m^2$ while the cell temperature is kept constant at 25 $\dec$C. 
Figures \ref{bucktemperature} and \ref{boosttemperature}  show the results for a sudden increase of the solar cell's temperature for both modes of operation. The temperature decreases from 25 $\dec$C to 15 $\dec$C by keeping constant the irradiance to a value of 1000 $W/ m^2$. 
In all the cases the P\&O algorithm can track the MPP by maintaining an efficiency higher than 99\%. This way it is validated that the MPPT algorithm works efficiently under sudden changes of irradiance and temperature. However, in real environmental conditions the sunlight and the temperature will not experience such a sudden change. It is considered a good approach for analyzing the system's capability of adjusting to change.

\begin{figure}[H]
	\begin{minipage}[c]{0.5\textwidth}
		\centering
		 % Left picture
	\end{minipage}%
	\hfill
	\begin{minipage}[c]{0.5\textwidth}
		\centering
		 % Right picture
	\end{minipage} \\ % Captions og labels
	\begin{minipage}[t]{0.45\textwidth}
		\caption{Irradiance 1000-800$W/ m^2$ ($R_{L}=3\Omega$).} % Left caption and label
		\label{buckirradiance}
	\end{minipage}%
	\hfill
	\begin{minipage}[t]{0.45\textwidth}
		\caption{Irradiance 1000-800$W/ m^2$ ($R_{L}=27\Omega$).} % Right caption and label
		\label{boostirradiance}
	\end{minipage}
\end{figure}

%\vspace{0.1cm}
\begin{figure}[H]
	\begin{minipage}[c]{0.5\textwidth}
		\centering
		 % Left picture
	\end{minipage}%
	\hfill
	\begin{minipage}[c]{0.5\textwidth}
		\centering
		 % Right picture
	\end{minipage} \\ % Captions og labels
	\begin{minipage}[t]{0.45\textwidth}
		\caption{Temperature 25-15$\dec C$ ($R_{L}=3\Omega$).} % Left caption and label
		\label{bucktemperature}
	\end{minipage}%
	\hfill
	\begin{minipage}[t]{0.45\textwidth}
		\caption{Temperature 25-15$\dec C$ ($R_{L}=27\Omega$).} % Right caption and label
		\label{boosttemperature}
	\end{minipage}
\end{figure}
