NicolaiFransen/Semester-Project-PED1/Reports/P1/docs/P0/introduction/mic.tex

\section{Module Integrated Converters}

Usually, one MPPT is commonly used for many PV modules as shown in figure \ref{fig:PVsystemblocks}. This approach may lead to suboptimal efficiency of the system since the uneven power generated by the PV modules might lead to a system with a local MPP in addition to a global MPP \cite{AN1521_MC}. In figure \ref{multiple_local_MPP} a system exhibiting two MPP, due to partial shading of one of the system's PV panels, is shown. In order to ensure that the system is working in the global MPP and not in the local MPP, the inverter's controller will have to perform a voltage sweep in order to find the global MPP. This voltage sweep is a higher level of complexity in the MPPT control system \cite{AN1521_MC}. In any case, the system will not be able to get the maximum power generation, as one panel is bypassed by a diode. Whenever a panel in a string is not able to supply enough current, its protection parallel diode might become  forward biased \cite{ArchitectureMIC}. If this happens the bypassed panel will not contribute to the total power generation. This means that even small partial shadings can have a major impact on the power generation of the system \cite{partial_shading_cons}. In a setup with 3 panels in series where one cell in a panel is irradiated with 80\% light in respect to the rest, measurement shows that the loss could be as high as 33\% in the setup \cite{partial_shading_effect}.

\begin{figure}[H]
	\begin{center}
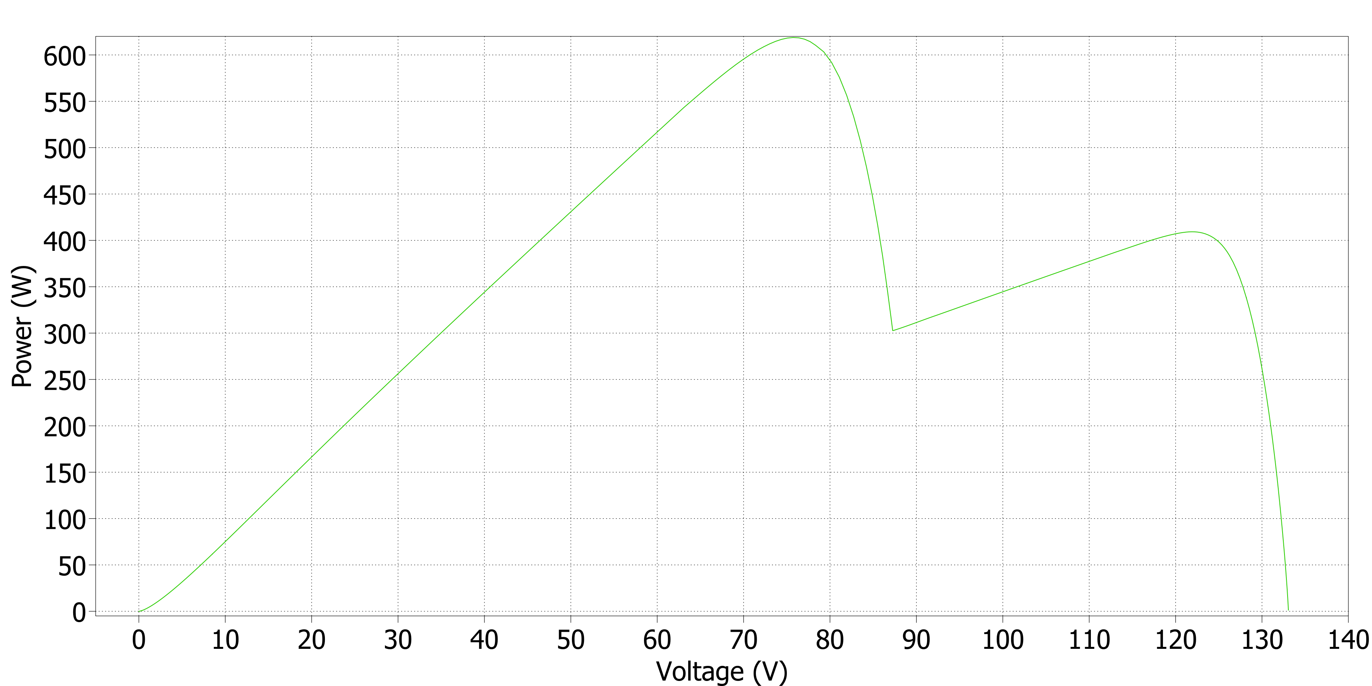
[picture p32: Reports/Pictures/local_MPP_PLECS.png]
		
		\caption{P-V curve of a system with more than one MPP. Three panels string. Two at 1000 $W/m^2$ irradiance, one panel at 400 $W/m^2$ irradiance.}
		\label{multiple_local_MPP}
	\end{center}	
\end{figure} 

Another approach is using a MIC, which is a DC to DC converter featuring a MPPT controller included in each PV module which will result in higher overall efficiencies \cite{ArchitectureMIC}. With this configuration, events like partial shading, uneven dirt, wear distribution or manufacturing imperfections are properly handled and do not affect the rest of the PV modules in the array. Also, a more detailed control of the plant is achieved since separate data from each individual panel is obtained \cite{ArchitectureMIC}. Each PV module will then be connected directly to a MIC allowing the output voltage and current to be defined by the load. This way the system is able to operate at different voltage and current levels whilst maintaining the MPP \cite{ArchitectureMIC}.

MICs can be either microinverters or DC-DC converters. In figure \ref{MIC_dcdc} a PV system using MICs is shown. Notice that $N$ panels might be used. Series or parallel connections can be used to link MICs' outputs and then connect this output to the inverter's input.

\begin{figure}[H]
	\begin{center}
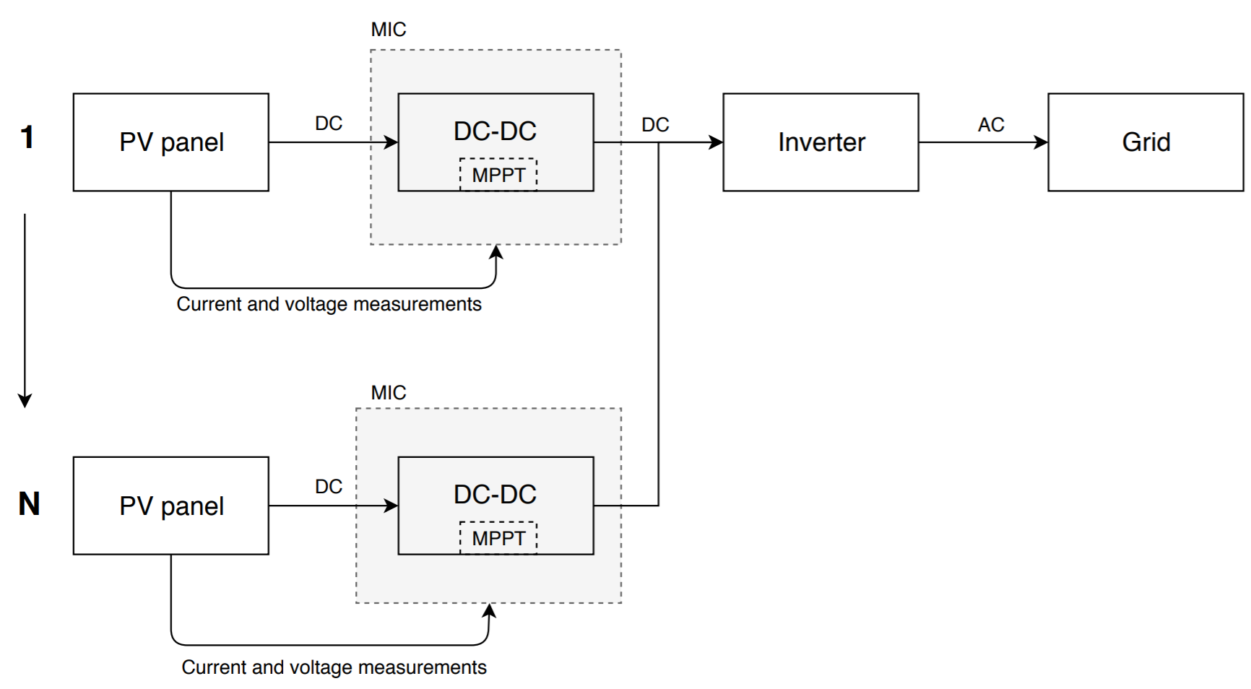
[picture p33: Reports/Pictures/MIC_dcdc.png]
		
		\caption{PV generation with DC-DC MIC system structure.}
		\label{MIC_dcdc}
	\end{center}	
\end{figure}

The panels with a MIC consisting of a microinverter, include a DC-DC converter with MPPT together with an inverter and are directly tied to grid. In figure \ref{microinverter_system} a microinverter system structure can be seen. For the user, this system is simpler, as only the PV must be purchased, the user does not have to worry about selecting and installing an inverter. 

\begin{figure}[H]
	\begin{center}
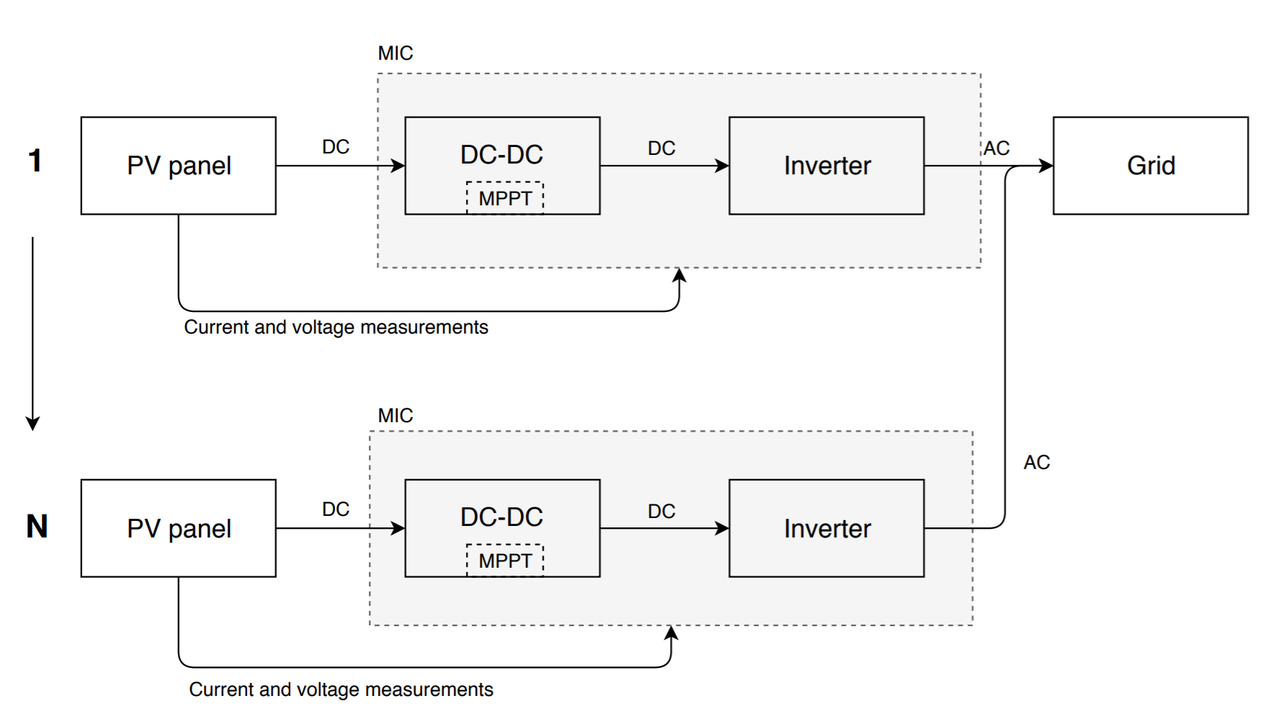
[picture p34: Reports/Pictures/MIC_microinverter.png]
	
		\caption{PV generation with microinverter MIC system structure.}
		\label{microinverter_system}
	\end{center}	
\end{figure}

The main advantage of the microinverter system is that it is simpler for the user, however, it implies an increase in costs and is usually less efficient than a DC-DC system with a single higher power inverter \cite{ArchitectureMIC}. Therefore, for the development of this project a DC-DC MIC will be implemented.
