NicolaiFransen/Semester-Project-PED1/Reports/P1/docs/P0/introduction/pv.tex

\section{Photovoltaic generation}

The generation of DC electricity from solar energy is a phenomenon known as \textit{Photovoltaic effect} which was first discovered by a French physicist named Edmond Becquerel in 1839 \cite{PVeffect}. This phenomenon allows the generation of electrical energy in a solar cell, when it is exposed to the sunlight \cite{PVeffect}. The greater the intensity of the light (irradiance) that is absorbed by the PV panel, the higher the amount of electric power generated. On the other hand, the efficiency of the panel decreases with increasing temperature \cite{handbook}. When the solar cell's temperature increases it results in a slightly increase of the generated current, however, the voltage decreases considerably \cite{handbook}. This results in a reduction of the power generated by the solar panel.

Some of the most important parameters associated to a PV panel’s data sheet are the following: maximum power ($P_{max}$), open-circuit voltage ($V_{OC}$), short-circuit current ($I_{SC}$), MPP voltage ($V_{MPP}$), MPP current ($I_{MPP}$) and efficiency ($\eta$) \cite{handbook}.
These features are important to define the characteristic curves of the PV panel. PV panel's I-V curves are a graphical representation of the relationship between the voltage and current of the solar panel. Different I-V curves are obtained for different temperatures and levels of irradiance \cite{IVcurves}. Figure \ref{fig:mpp} shows the characteristic curves of a generic PV panel. 

\begin{figure}[H]
	\begin{center}
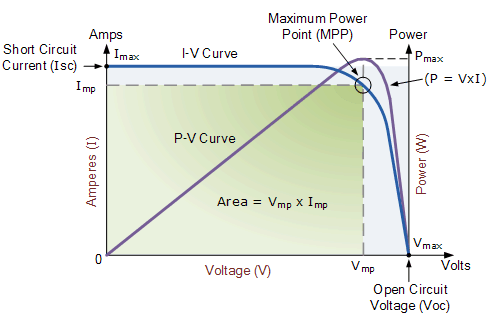
[picture p37: Reports/Pictures/IVcurve1.PNG]
		
		\caption{I-V and P-V curves of a generic solar panel \cite{IVcurves}.}
		\label{fig:mpp}
	\end{center}
\end{figure}

The PV panel's I-V curve is shown in blue in Figure \ref{fig:mpp}
 for a given PV cell's temperature and solar irradiance. As it is well known, the power generated by a PV cell is the product of current and voltage at each point. Hence, the P-V curve of the solar panel can be obtained and it is displayed in purple. From the P-V curve, the maximum power generated by the solar panel ($P_{max}$) is obtained. This maximum power corresponds to the so called MPP and takes place for a specific combination of voltage ($V_{MPP}$) and current ($I_{MPP}$). Therefore, the ideal operating point of a PV panel corresponds to the MPP which varies according to the level of solar radiation and the temperature \cite{handbook}. 

There are different types of photovoltaic systems, however, the most common PV systems implemented nowadays are grid-connected \cite{handbook}. This type of PV system is mainly composed of a solar array, a DC-DC converter with an MPPT controller unit and an inverter, as shown in Figure \ref{fig:PVsystemblocks}. 

\begin{figure}[htbp]
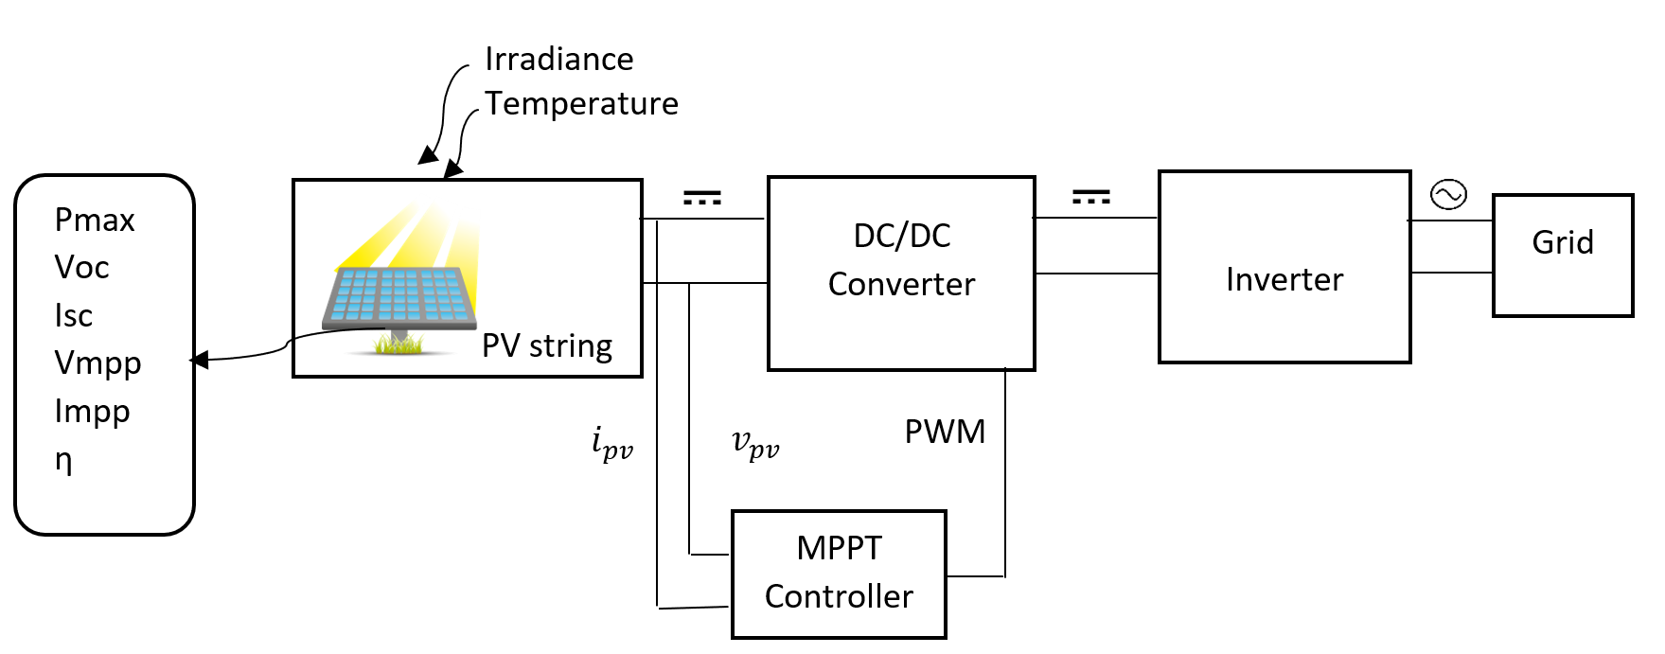
[picture p38: Reports/Pictures/PV_system_blocks.png]
	
	\caption{Basic block diagram of a PV system.}
	\label{fig:PVsystemblocks}
\end{figure}

As mentioned at the begining of the chapter, PV modules can be connected to each other resulting in a PV array which generates electrical energy in the form of DC. The MPPT controller unit takes the PV array's output voltage and current as input variables in order to calculate the corresponding duty cycle for tracking the MPP. The duty cycle is the input of a Pulse Width Modulation (PWM) block. The PWM is used to generate the pulses for the switching components of the DC-DC converter in order to get the PV array to work continuously at its MPP. The output of the DC-DC converter is connected to an inverter to convert the DC electric energy in an AC electrical signal compatible with the grid.\cite{handbook}
