NicolaiFransen/Semester-Project-PED1/Reports/P1/docs/converterDesign/sensors/sensors.tex

%% These sections describes the design and implementation of the chosen sensors.

\subsection{Sensing circuitry} \label{sensors}
To implement the MPPT it is necessary to measure the output voltage and current of the PV module. These measurements will be obtained by placing a voltage and current sensor. A second voltage sensor will be implemented to measure the output voltage of the DC-DC coverter, for possible future use. 

To protect the RT Box, it has been chosen to fully isolate it from the power stage of the converter. To do so, the sensors will have to include isolation between input and output.  

%%% Voltage sensors %%%
\input{docs/converterDesign/sensors/voltage.tex}

%%% Current sensors %%%
\input{docs/converterDesign/sensors/current.tex}
