NicolaiFransen/Semester-Project-PED1/Reports/P1/docs/P0/background/background.tex

\chapter{Existing solutions for module integrated converters}\label{background}

\input{docs/P0/background/introduction_chapter2.tex}

\section{Topologies of DC-DC converters}\label{DC_DC_Converters}

\input{docs/P0/background/buckandboostconverter.tex}

\input{docs/P0/background/2_diode_H_bridge_BB.tex}

\input{docs/controlsystemdesign/MPPT/MPPT_algorithm.tex}
