NicolaiFransen/Semester-Project-PED1/Reports/P1/docs/P0/problemAnalysis/problemStatement.tex

\section{Problem statement}

The problem statement for this project can be formulated as the following question: 
\newline

\textbf{\textit{\large{How can a module integrated converter be designed to maximize the PV power generation under real conditions?}}}
\newline
\newline
The problem statement will be answered by fulfilling the following objectives: 

\begin{itemize}
	\item Design a DC-DC converter for integration with a PV panel.
	\item Implementation of an MPPT algorithm.
	\item Hardware implementation of the MIC components including the Printed Circuit Board (PCB) layout.
	\item Test of the system using a PV simulator and validation of the results. 
\end{itemize}
