NicolaiFransen/Semester-Project-PED1/Reports/P1/docs/controlsystemdesign/MPPT/Selection_of_MPPT_algorithm.tex

\label{MPPTselection}

The advantage of using constant voltage is that only the voltage is measured and the system is controlled by a simple control loop. Therefore, implementation costs are low compared to the other two methods. The use of PV modules with the constant voltage as MPP algorithm is only possible in regions with low temperature fluctuations. The reason for this disadvantage is that the point of the MPP varies greatly with strong temperature fluctuations and the assumption of linear dependence is no longer valid. In addition, it is not possible to find the MPP with the algorithm if the PV module is partially shaded. Another disadvantage is the effort of calculating the optimal K for different irradiance and temperature is very high and therefore the complexity of the algorithm increase. \newline

The required computing power of the perturb and observe algorithm is also low, because it is easy to compute. The algorithm contains the calculation of the power and the comparison with previous power for each step. 
Another advantage of perturb and observe is that a current sensor does not necessarily have to be used. There are scientific paper where only a voltage sensor is used. \cite{} There is a disadvantage when the algorithm is near to the MPP since, at this point, the algorithm oscillates around the MPP, so that the MPP cannot be reached exactly. The oscillation depends on the value of the fixed step. If the fixed step value is high, the MPP will be reached quickly. On the other hand, the oscillation around the MPP is high, which reduces the efficiency. The advantage of a small value is that the oscillation is small, but it takes more time to reach the MPP. \newline
An advantage of incremental conductance is remaining exactly at the MPP that when this is reached. This increases the efficiency of the PV panel. As with perturb and observe, a fixed value is used to change the voltage. If the value is high, the probability is higher that the algorithm oscillated around the MPP. 
Two sensors are used for the implementation. In addition, the microcontroller requires a higher computing power than perturb and observe, since many more commands are called up during an iteration step. The costs for the algorithm development and microcontroller are higher compared to the other two algorithms. \newline
The table\ref{fcinccon} gives an overview of the advantages and disadvantages of the different algorithms.
\begin{table}[H]
	\centering 
		\begin{tabular}{|>{\centering}p{2cm}|>{\centering}p{2cm}|>{\centering}p{2cm}|>{\centering}p{2cm}|>{\centering}p{2cm}|>{\centering}p{2cm}|}
		\hline
		\rowcolor{lightgray}						 \textbf{MPPT Algorithm} & 	
		 \textbf{Sensed Parameters} &
		\textbf{Micro-controller Computation} &
		 \textbf{Complexity}&
		 \textbf{Reliability}	&
		 \textbf{Overall Cost}
		\tabularnewline  \hline
			Constant voltage 	& Voltage 		& Absent/Low &  Very simple & Not accurate & Low 										\tabularnewline \hline
			Perturb and observe & Voltage + Current  & Low  &  Medium & Not so much accurate & Low/ Medium 		\tabularnewline \hline
			Incremental conductance & Voltage + Current & Medium &  Medium/High & Accurate and operate at MPP & Low/ Medium	\tabularnewline	\hline
			\end{tabular}
	\caption{Summary the Pro and Contra from each MPPT algroithm \cite{flowchartVC} }
	\label{tab:summaryMPPT}
\end{table}
\todo{center cells}
Constant voltage is not applied in the project work. One of the requirements of the work is that the algorithm can find the MPP despite changes in the environmental operation and this is not possible with an implementation of constant voltage. Since for the algorithm Incremental conductance the program needs more complex commands, perturb and observe was chosen because of the simpler implementation. For future purposes, the incremental conductance can be implemented to compare the efficiency and reliability of the two methods.
