NicolaiFransen/Semester-Project-PED1/Reports/P1/docs/P0/appendix/appendix.tex

\chapter{Appendix}

\input{docs/appendix/PBL}
\clearpage

%\newgeometry{left=3cm,bottom=0.1cm}
\KOMAoptions{paper=A3, paper = landscape, pagesize}
\addtolength{\hoffset}{-4.0cm}
\addtolength{\voffset}{2.5cm}
\recalctypearea

%\begin{landscape}

\section{Gantt chart}

%\vspace{1cm}
\begin{figure}[H]
	\begin{center}
		
		\caption{Project Gantt chart}
		\label{gantt}
	\end{center}	
\end{figure}
%\end{landscape}

%\section*{Description of colors:}

%\begin{table}[H]
%	\centering
%	\begin{tabular}{|p{3cm}|p{6cm}|} 
%		\hline
%		\textbf{Color} & \textbf{Description} \\ \hline
%		Grey & Normal task  \\ \hline
%		Red & Milestone  \\ \hline
%		Purple & Supervisor interaction  \\ \hline
%		Yellow &  Lab-work\\ \hline
%	\end{tabular}
%	\caption{Description of colors in the Gantt chart}
%	\label{gantt_colors}
%\end{table}

\clearpage
\addtolength{\hoffset}{4.0cm}
\addtolength{\voffset}{-2.5cm}
\KOMAoptions{paper=A4, paper=portrait,pagesize}
\recalctypearea
