NicolaiFransen/Semester-Project-PED1/Reports/P1/docs/P0/futureWork/futureWork.tex

\chapter{Future Work}
The following list contains the subjects which will be addressed after the hand-in of the P0 report.

\renewcommand{\labelenumii}{\arabic{enumii}}
\begin{enumerate}
	\setcounter{enumi}{3}
	\item \textbf{Non-inverting Buck-Boost converter design}
	\begin{enumerate}
		\item Circuit analysis
		\item Component sizing
		\item Open-loop simulation and results
	\end{enumerate}

	\item \textbf{Design of control system}
	\begin{enumerate}
		\item Small-signal model
		\item Evaluation of main MPPT techniques
		\item Selection of MPPT
		\item Simulation and result
	\end{enumerate}
	
	\item \textbf{Hardware implementation}
	\begin{enumerate}
		\item Selection of components
		\item PCB layout
		\item PCB assembling
	\end{enumerate}

	\item \textbf{Test \& validation of the MIC}
	\item \textbf{Conclusion \& further development}
\end{enumerate}
