NicolaiFransen/Semester-Project-PED1/Reports/ReportIndex_Stefversion.docx

1. INTRODUCTION
  1.1 PV generation
  1.2 Module Integrated Converter (MIC)
  1.3 Problem statement
2. STATE OF THE ART
  2.1 Topologies of DC-DC converters
    2.1.1 Buck converter
    2.1.2 Boost converter
    2.1.3 Non-inverting Buck-boost converter
  2.2 Maximum Power Point Tracking techniques
    2.2.1 Constant voltage
    2.2.2 Perturb and Observe
    2.2.3 Incremental conductance
3. NON-INVERTER BUCK-BOOST CONVERTER DESIGN

Intro explaining the reasons for selecting this DC-DC converter(selection of topology)

  3.1 System requirements
  3.2 Circuit analysis
  3.3 Component sizing
  3.4 Simulation results
4. HARDWARE IMPLEMENTATION
  4.1 Selection of commercial components
    4.1.1 Passive components
    4.1.2 Switching circuitry
      4.1.2.1 Switch sizing
      4.1.2.2 Heat sink sizing
      4.1.2.3 Drivers and optocouplers
    4.1.3 Sensoring circuitry
      4.1.3.1 Input voltage sensor
      4.1.3.2 Output voltage sensor
      4.1.3.3 Current sensor
    4.1.4 Power supplies
  4.2 PCB design
    4.2.1 PCB structure (schematics in appendix)
    4.2.2 Design considerations
    4.2.3 Power side
    4.2.4 Control side
5. MAXIMUM POWER POINT TRACKING

Intro explaining the reasons for selecting P&O (selection of topology)

  5.1 Perturb and Observe implementation
  5.2 Simulation of the MPPT
    5.2.1 Model of the PV panel
    5.2.2 Simulation results
6. TEST AND VALIDATION OF RESULTS
  6.1 PCB
    6.1.1 Power Supplies
    6.1.2 Optocouplers
    6.1.3 Drivers
    6.1.4 Sensors
  6.2 MPPT ?? Decide this when the test is defined!!
    6.2.1 RT-box
    6.2.2 PV simulator
    6.2.3 Load
    6.2.4 Experimental results
7. DISCUSSION

Write about the results obtained during the project and mention the + and – results.

  7.1 Encountered problems
  7.2 Future work
8. CONCLUSIONS

Things to remove, write or change in each chapter:

1. INTRODUCTION

I think the first part of the intro gives a general overview, but we can add/remove something if you think so. I consider it is ok like it is.

  1.1 PV generation
- I deleted a paragraph for the STC conditions and included it in “PV panel model”.
- I added an explanation to Thassilo’s comment.
- I modified a bit the text to make it shorter and also corrected some mistakes.
  1.2 Module Integrated Converter
- I would call this section like this instead of MIC implementation because we don’t implement it here. Also, writing the entire name.
- Consider rewriting the first part as it is repetitive. Start explaining what is a MIC and why do we use it. Mention that the efficiency of the MPPT is usually higher than 99%.
- Delete the figure with the two MPP due to partial shading as we are not implementing this.
- Maybe reorganize the structure as mentioned in the comment.
2. STATE OF THE ART
- Delete the flyback converter.
- Brief intro explaining what’s is going to be written in this chapter.
- Include in the MPPT techniques the advantages and disadvantages of each of the algorithms.

………

7. DISCUSSION

This section fulfils several aims:

- It compares your results with previous results from other authors
- It clarifies the innovation (the new added knowledge) of your work •
- It may also be a little self-critical, i.e. by announcing and explaining potential shortcomings of your work
- Therefore, the discussion will contain many citations which will be – at least in part – repetitions of those cited in section "2 State of the art"
- The discussion may be split into subsections covering different aspects/fields of your work
- The discussion demonstrates your ability to think critically about your research. It is therefore the most important section with respect to your intellect •
- Length: dependent on the amount of data and of existing background information. Something between 5 and 15 pages.
8. CONCLUSIONS

This section raises the overall questions of your work:

- What has been achieved?
- What is still missing?
- What should follow -up activities focus on? etc….
- Length: c. 1 page
