NicolaiFransen/Semester-Project-PED1/Reports/ReportIndex.docx

# 1. Introduction

Brief explanation of project and importance of sustainable energy.

## 1.1. Photovoltaic generation

## 1.2. Reaching maximum efficiency

Explain what a MIC is and why it is important. What partial shading and other aspects of our project are.

## 1.3. Problem analysis

What is the overall goal of our project. Now, this section is a new chapter but maybe it would be better to turn it into another section since it really doesn’t differ that much from others.

## 1.4. System requirements

More detailed info about what we are basing our system in. Power balance, PV chosen, requirements…

## 1.5. Problem statement

Brief problem statement.

# 2. State of the art

## 2.1. State of the art

Research on previous solutions for PV generation. Exposition of possible power circuits to be implemented.

## 2.2. Buck converter

## 2.3. Boost converter

## 2.4. Flyback and Buck-boost converters

## 2.5. Non-inverting bidirectional converter

## 2.6. Selection of topology.

# 3. Non-inverting buck-boost converter design

Brief explanation on what the converter needs and what is the scope of this chapter.

## 3.1. Circuit a nalysis

Explain diferente working modes, why there might be problems in transitions, what are the critical paths and other issues that we will face.

## 3.2. Component sizing

Sizing of main components of the power side. Passive components, and also transistor limits.

## 3.3. Open loop simulation

# 4. Component selection and hardware implementation

Introudction to component selection, making a list of the components that are needed, maybe including components that wont be explained later like connectors.

## 4.1. Passive components

## 4.2. Switching circuitry

### 4.2.1. Switch sizing

### 4.2.2. Heat sink sizing

### 4.2.3. Drivers and optocouplers

## 4.3. Sensoring circuitry

### 4.3.1. Input voltage sensor

### 4.3.2. Ouput voltage sensor

## 4.4. Hardware implementation

### 4.4.1. PCB schematics

### 4.4.2. Design considerations

### 4.4.3. Power side

### 4.4.4. Control side

# 5. Maximum Power Point Tracking

Introudction explaining why it is important to implement a maximum power point tracker.

## 5.1. Evaluation of MPPT techniques

### 5.1.1. Constant voltage

### 5.1.2. Perturb and observe

### 5.1.3. Incremental conductance

## 5.2. Selection of MPPT algorithm

## 5.3. Perturb and observe implementation

## 5.4. MPPT simulation

### 5.4.1. PV model

### 5.4.2. Simulation results

# 6. Tests and validation

## 6.1. PCB building

### 6.1.1. Power Supplies

### 6.1.2. Optocouplers

### 6.1.3. Drivers

### 6.1.4. Sensors

## 6.2. MPPT validation

### 6.2.1. RT-box

### 6.2.2. PV simulator

### 6.2.3. Load

### 6.2.4. Integration

# 7. Discussion

## 7.1. Obtained results

This doesn’t have to be the final outline, maybe it is better to separate it differently but it is important to talk about good results and bad results in a very objective manner.

### 7.1.1. Positive results

### 7.1.2. Negative results

## 7.2. Encountered problems

Brief description of the problems and then it could be a subsection for each one of the problems that we talk about.

It can be both solved problems and problems that are still there.

Things to improve can be another subsection of encountered problems or another separate section.

### 7.2.1. Future work

# 8. Conclusions

# 9. References

# 10. Appendixes
