NicolaiFransen/Semester-Project-PED1/Schematic_PCB/CHECKLIST PCB LAYOUT 13_11_18.docx

CHECKLIST PCB LAYOUT 13/11/18:

- FOOTPRINTS:
- Input capacitors
- Output capacitor
- Capacitors 100nF
- Optocouplers
- Voltage sensor
- Current sensor
- Operational Amplifier
- MOSFETs
- Drivers
- Traco
- Regulator
- Diode
- Decoupling capacitors (measure in real life)
- Connectors (measure in real life)
- Inductor (measure in real life)
- DECOUPLING CAPACITORS
- INDUCTOR POSITION
- TRACES
