NicolaiFransen/Semester-Project-PED1/Schematic_PCB/Schematic comments _V1.docx

Schematic comments

1. MOSFET pinouts may miss.
2. Input power connection to converter

Looks like multiple test points regarding the driver

5. OA2+ connection between resistors

MOSFET resistors

6. Opamp supply connections floating

5V_HV_sensor GND may be wrong - Warning

Naming of different VDD and GND - Warning

7. GND unused opamp.
1. C18 miss value

Decoupling caps at sensors

6. Maybe use LED’s at power supplies to indicate that it’s working.

SC opportunity of the protection diode?

Is connection type for RT-box considered?
