NicolaiFransen/Semester-Project-PED1/Reports/P0/2018_09_13 P0 structure.docx

9. October -> PO

Deadline: 30/09/18

*Preface

*Summary

*Nomenclature

*Table of figures/tables

1.Introduction

1.1 PV generation Stef

1.2 Module Integrated Converters (MIC) Aitor

2. Background of converter topologies

2.1 Buck converter Thassilo

2.2 Boost converter Thassilo

2.3 Flyback converter Jesper

2.4 Non-inverting buck-boost converter – 2 switches Nico

2.5 Non-inverting buck-boost converter – 4 switches Nico

2.6 Selection of topology Nicolai / Report structure

3. Problem analysis

3.1 System Requirements

3.2 Problem statement

3.3 Objectives

---------------------------- P0

Future work:

4. Non-inverting Buck-Boost converter design

4.1 Circuit analysis

4.2 Component sizing

4.3 Simulations and results

5. Design of the control system

5.1 Small-signal model

5.2 Evaluation of main MPPT techniques

5.3 Selection of the final MPPT

5.4 Simulations and results

6. Hardware implementation

6.1 Selection of components

6.2 PCB layout

7. Experimental test of the MIC and validation

8. Conclusions and future work

Bibliography

Appendices: GANTT Chart
