NicolaiFransen/Semester-Project-PED1/Exam/Presentation_AT.pptx

## What is a MIC?


- Module integrated converter.
- Is located next to each PV module.
- Prevents mismatch losses.

## MIC advantages

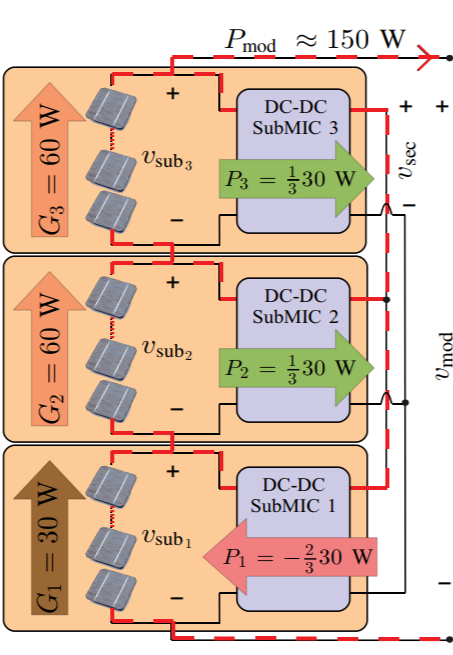
[picture p52: figure]

- Allows individual maximum power point tracking.
- Replaces bypass diode.
- Higher efficiencies achieved.
- Certain topologies allow bidirectionality.

## Converter design, change random picture

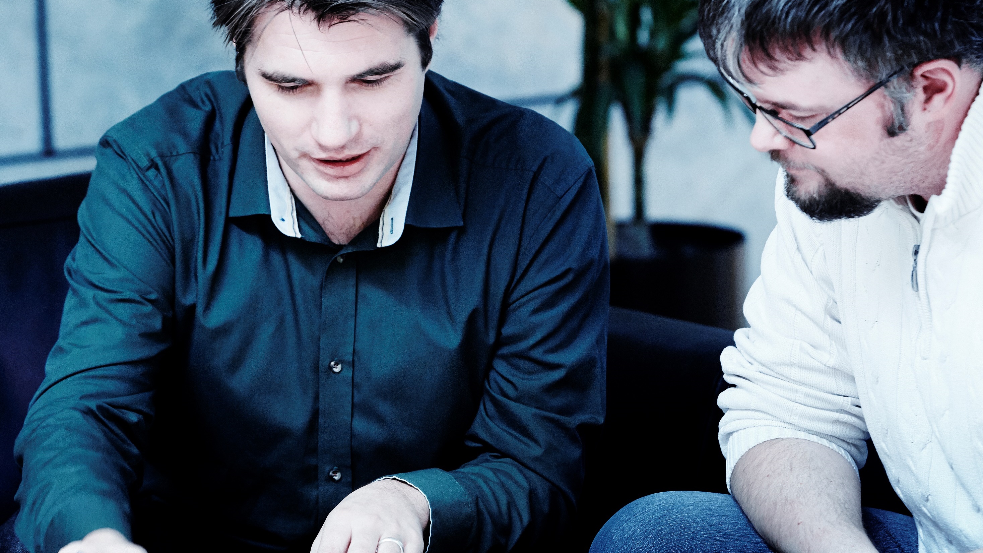
[picture p53: figure]

## Power circuitry

- Discharging resistors.
- Protection diodes.
- High frequency capacitors.

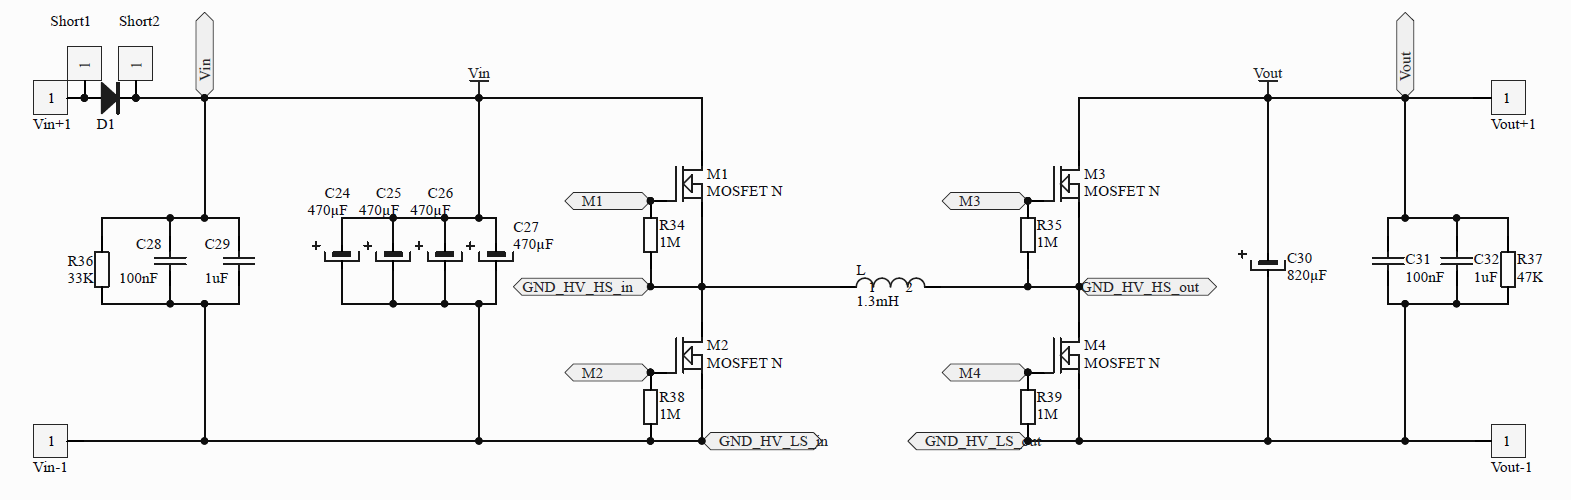
[picture p54: figure]

## Driving circuitry

- Optocouplers for isolation.
- Decoupling capacitors.
- Current limiting resistors.

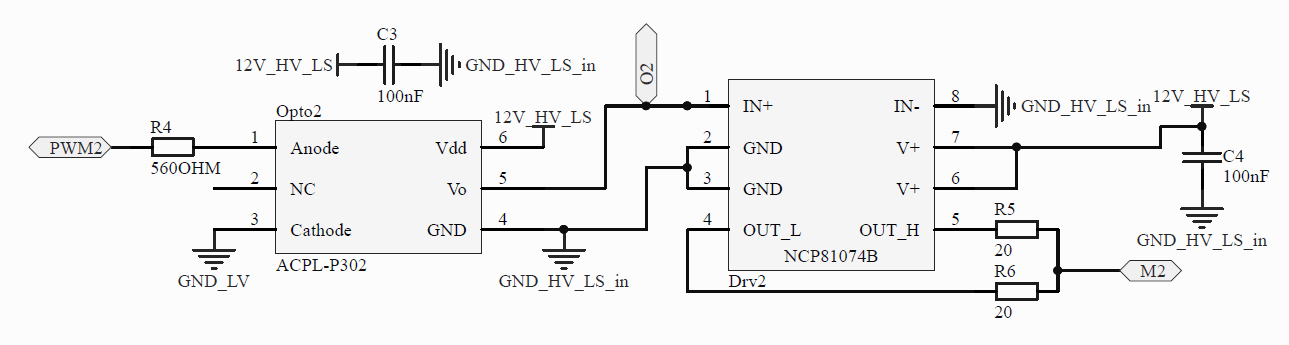
[picture p55: figure]

## PCB layout


Considerations:
- Hot and cold spots.
- Isolations.
- Interferences.
- Others.

## Hot and cold spots

- Clear separation of hot and cold sides.

High power.

Low power,
Main side.

Low power,
Isolated side.

## Interferences

- Minimal current loops.
- Hall sensor location.
- Ground planes.
- Removed ground plane under inductor.

## Isolations

- Isolation bridge under high and low voltage..

## Others

- Test points.
- Other measuring points and user communication.
- Heat sink location.
- 10mm power traces.
