NicolaiFransen/Semester-Project-PED1/Exam/Individual_questions/Questions_murgui.pptx

## MPPT – Running frequency

- Low frequency will lead to low reaction speed and oscillations
- High frequency increases computational requirements
- The system has a specific time constant (Tau) and having an MPPT faster than Tau is an overkill which can lead to instabilities as the variables are read during transients.

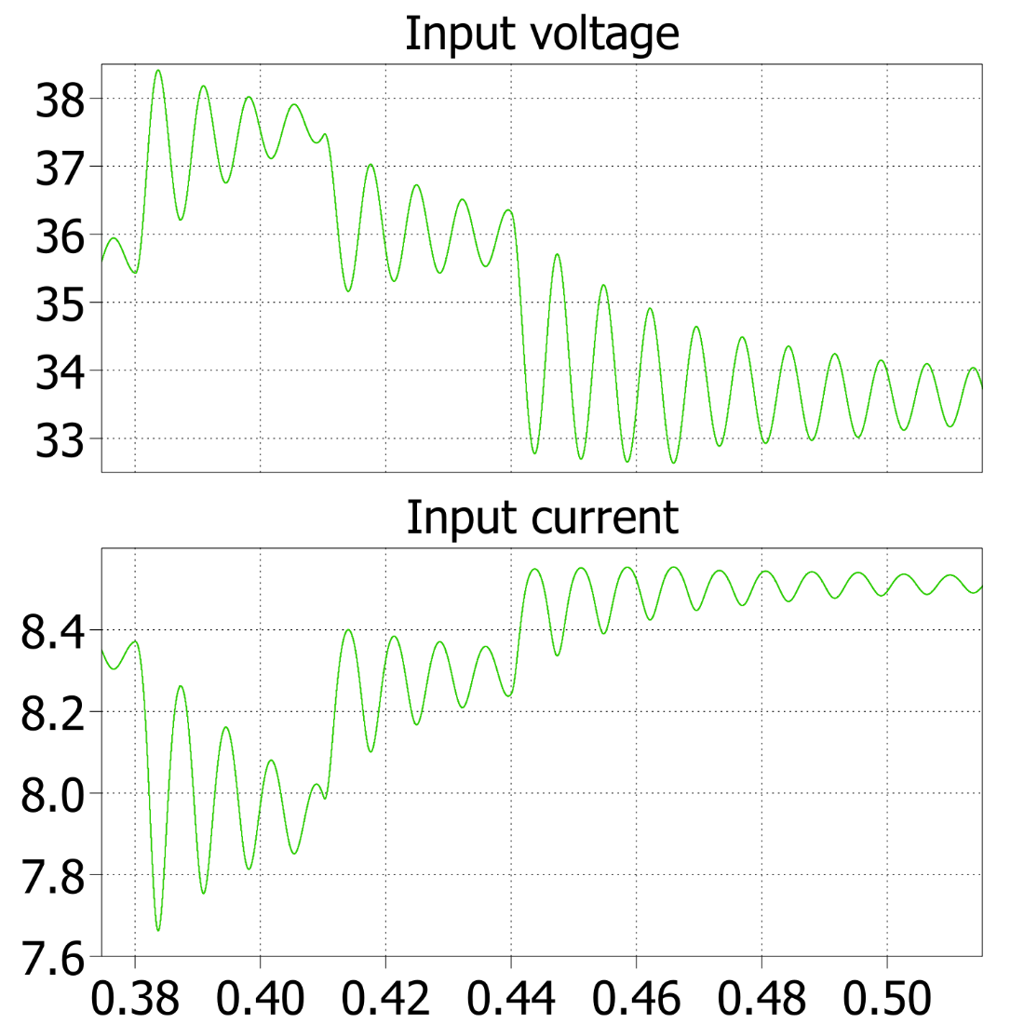
[picture p56: figure]

Oscillations of the system start-up working at 100 Hz. Working at a higher frequency would lead to too early measurements.

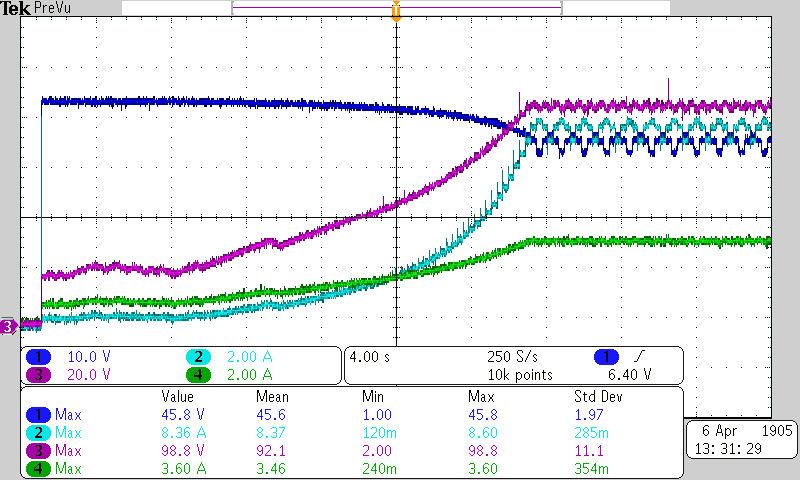
[picture p57: figure]

Τ = (√(LC))/(D^(′))=3 ms|_(D=0,5)

10 Hz MPPT
oscillations

## Hardware current sensor filtering

Different frequencies for different goals
- 50 Hz → Low frequency allows reliable MPPT information
- 80 kHz → In case a current controller is desired to be implemented, full sensor’s bandwidth is also available.

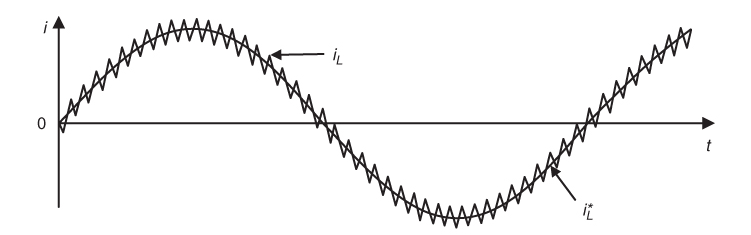
[picture p58: figure]

Further filtering can be achieved
through software

Hysteresis current control,
example of current control
that requires full bandwidth

Predictive Control of Power Converters and Electrical Drives. P. Cortes. 2012
