NicolaiFransen/Semester-Project-PED1/Others/HighVoltage/EXAM HINTS/High voltage exam.docx

High voltage exam

- Theoretical questions more important than practical exercises.
- Questions regarding definitions.
- Everything is on the slides.
- No book references.
- Need to pass both, hv and emi.
- DC and AC generation entra seguro.
- No gasous discharge calculations.
- Not that much in impulse generation.
