NicolaiFransen/Semester-Project-PED1/Others/HighVoltage/LabExercise4/Calculations LAb 4.docx

Horizontal supply conductor is a 10m long wire with a diameter of 2mm. It has an average height of 1.6m over the ground plane. Based on arrangements and dimensions of circuit, the students need to conduct following calculations:

− Calculate the impedance of horizontal supply conductor;

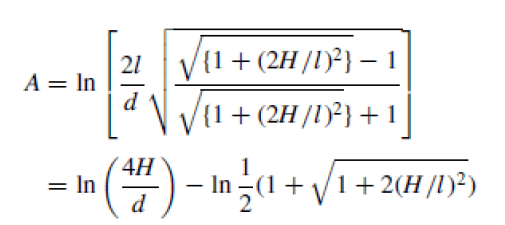
[picture p59: figure]

A = 8.0583 Ω

(Z_L )_(hor) = 60*A = 483.5 Ω

− Calculate the capacitance C_L and inductance L_L of the supply conductor;

ε_0 = 8.85 ×10⁻¹² F⋅m⁻¹

C_L =69 pF

L_L =16 μH

− Calculate the wave propagation velocity v in the lead;

v =30.1×(10^6 m)/s~ 3.01 cm/ns

− Calculate the transfer ratio n based on values of the capacitors.

n= (C_1 +C_2)/(C_1)

C_1 =600 pF ; C_2 =119.5 nF

n = 200.166 ~ 200

- Measure u1(t) and u2(t) with an oscilloscope, and comment the appearance of the curves. Then import the date files to eg. MATLAB to calculate the response time T.

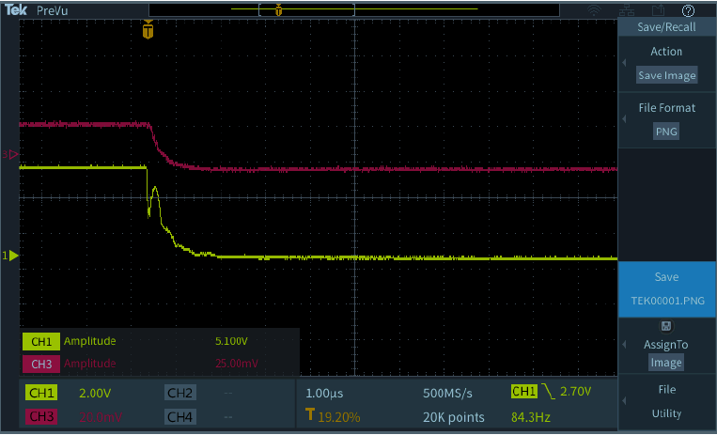
[picture p60: figure]

From the scope the input voltage (5V amplitude) is the yellow curve and the voltage after the capacitive voltage divider is the red curve (25mV amplitude). If we compare both curves it can be validated the transfer ratio found previously:

5V /25mV = 200 = n

Moreover, the output voltage does not reach the final value of the input step voltage because of the capacitors of the voltage divider. In this case the value of Rd = 470 Ω which allows to damp the input voltage and that is why in the output voltage there is no overshoot.

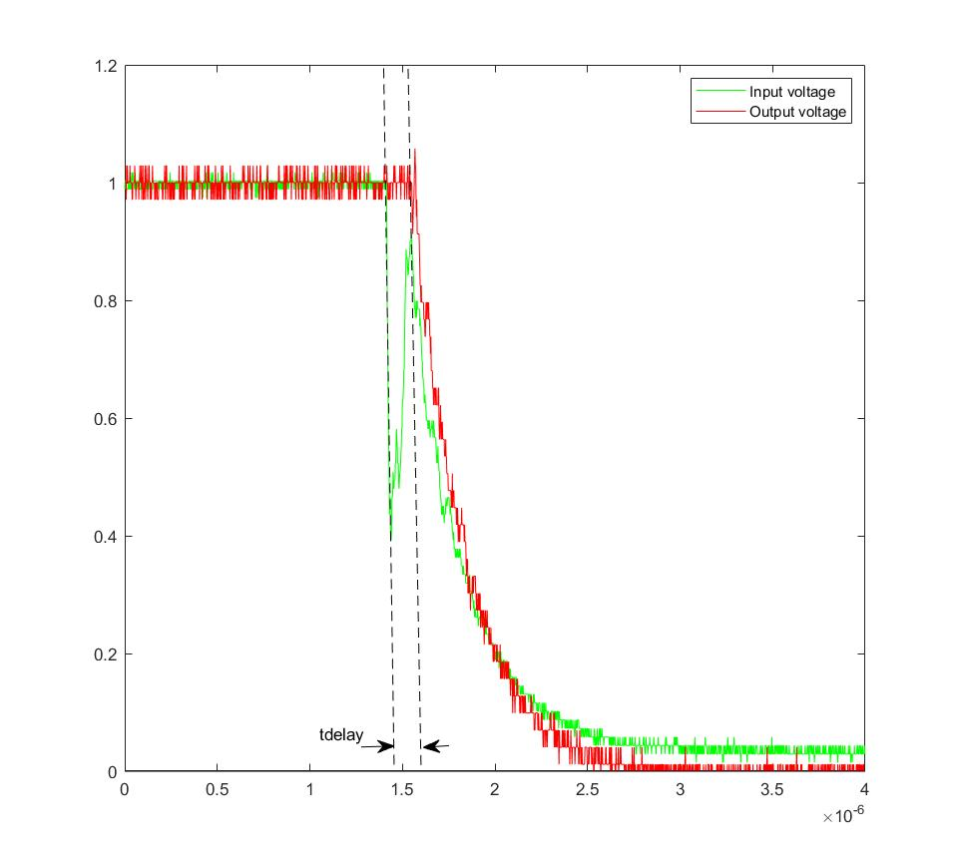
[picture p61: figure]

The response time is calculated as stated in the following equations:

T = T^0 – tde = 265.5 ns

Where tde is the is the time delay at which the output voltage starts falling from 1 to 0.

- Short circuit Rd and measure u1(t) and u2(t) again. Calculate the response time T in this case.

If the value of Rd is 0 then the system will be undamped and therefore more oscillations will appear in the time response. The next figure reflects these oscillations and even though it seems that the response time in this case is higher than the damped system it is not. This is because when the output voltage gets lower than 0 it is necessary to subtract this time periods as: T=T1−T2+T3−T4+T5 - ……

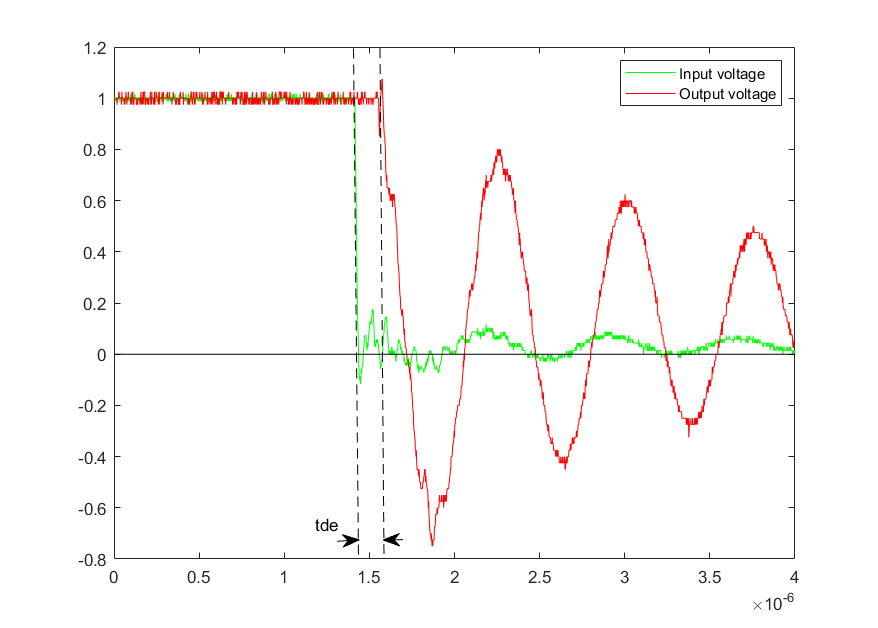
[picture p62: figure]

The response time is:

T = T1 -T2 + T3 - T4 + T5 -T6 + T7 – tde = - 35.25 ns

- Calculate the impulse voltage peak measuring error ΔV for the linearly rising impulse voltages with different front steepness S=2MV/μs, 200 kV/μs and 20 kV/μs.

S = 2MV/μs:

T = 265.5 ns → ΔV = 531 kV

T = - 35.25 ns → ΔV = -70.5 kV

S= 200 kV/μs

T = 265.5 ns → ΔV = 53.1 kV

T = - 35.25 ns → ΔV = -7.05 kV

S= 20 kV/μs

T = 265.5 ns → ΔV = 5.31 kV

T = - 35.25 ns → ΔV = -0.705 kV
