NicolaiFransen/Semester-Project-PED1/Others/HighVoltage/Labexercise3/New Microsoft Office Word Documentv2.docx

35kv no breakdown

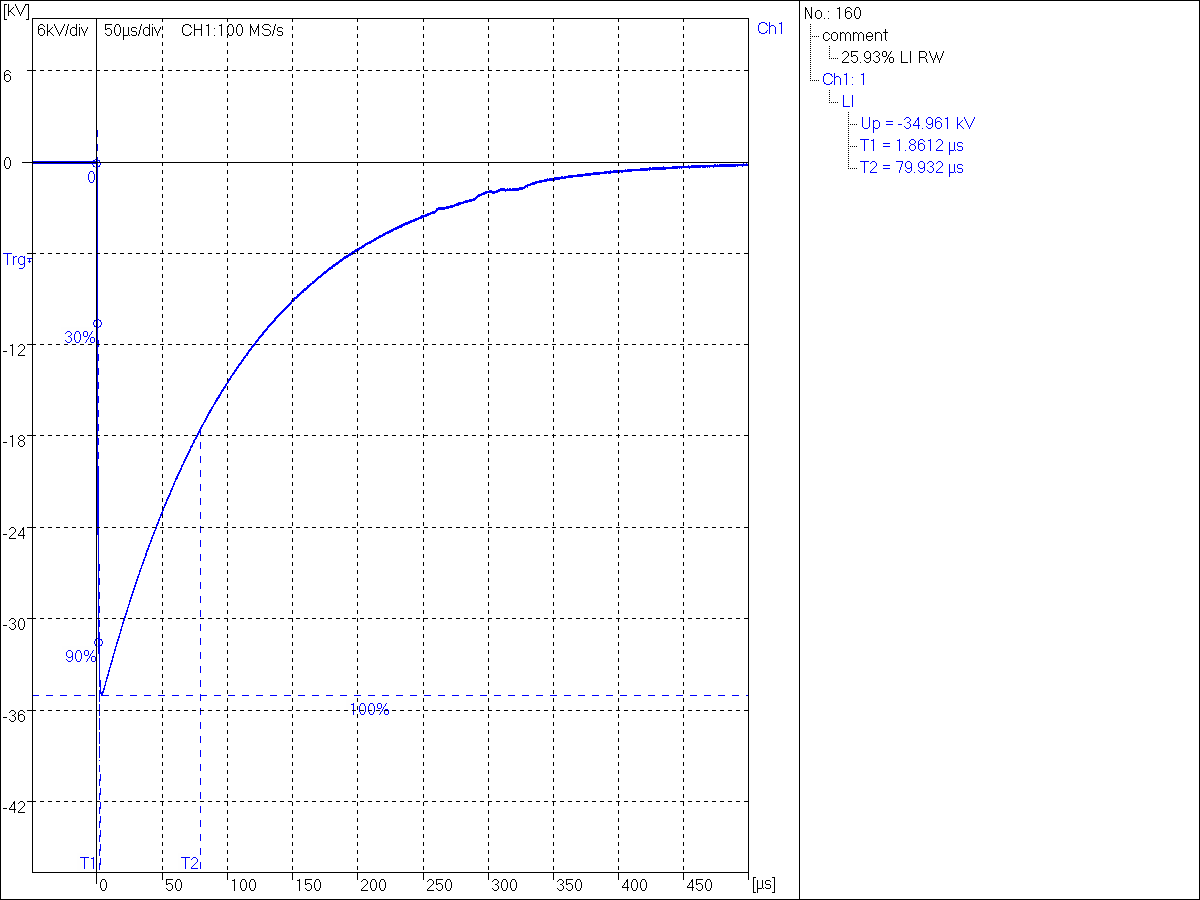
[picture p63: figure]

38kv breakdown

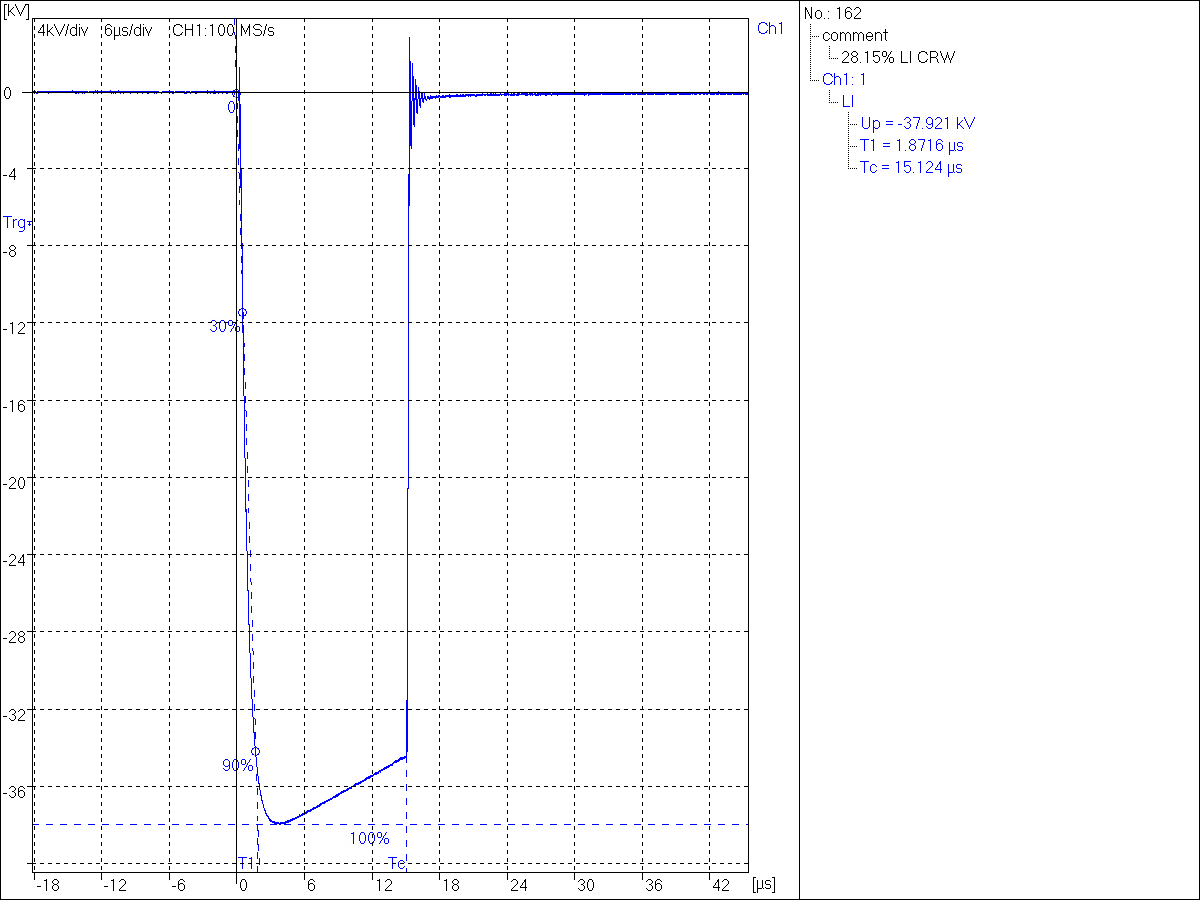
[picture p64: figure]

-45kv

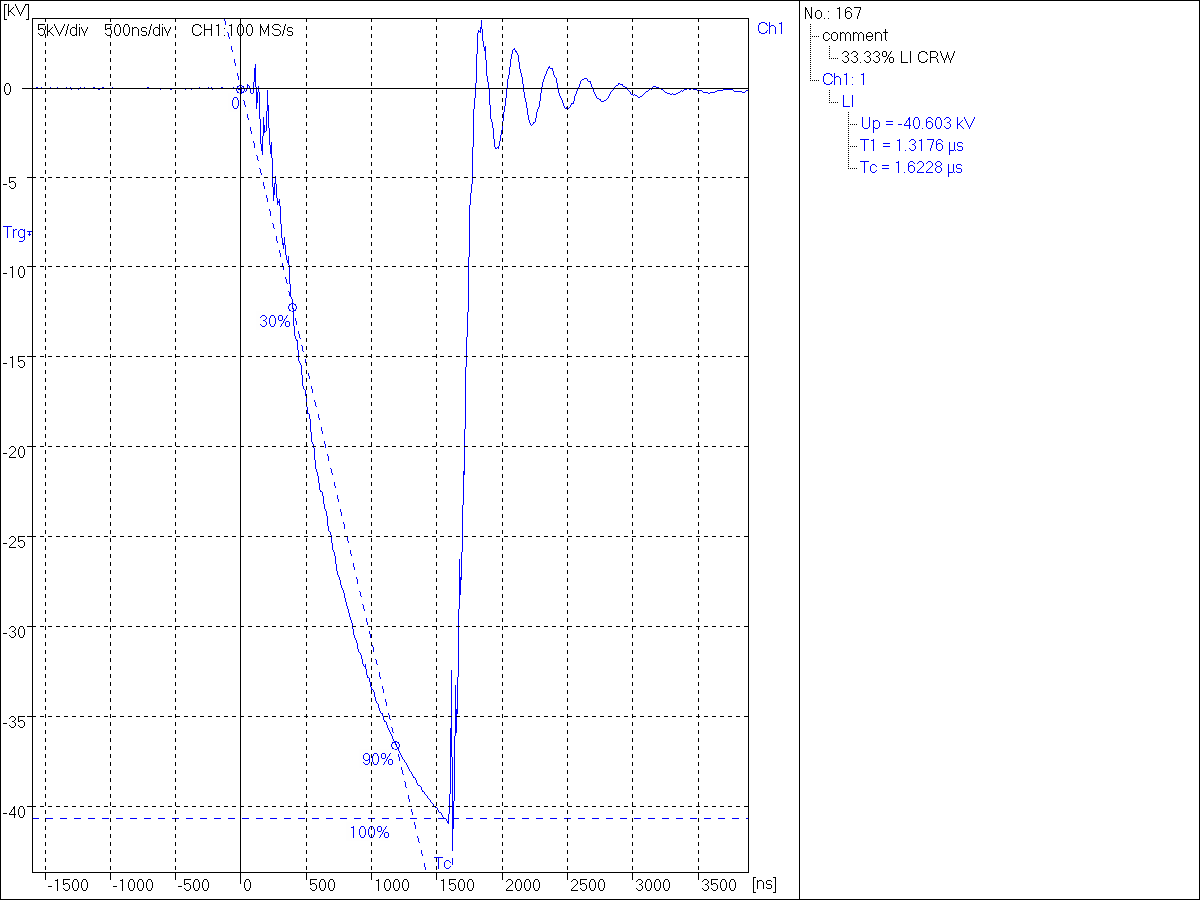
[picture p65: figure]

-55kv

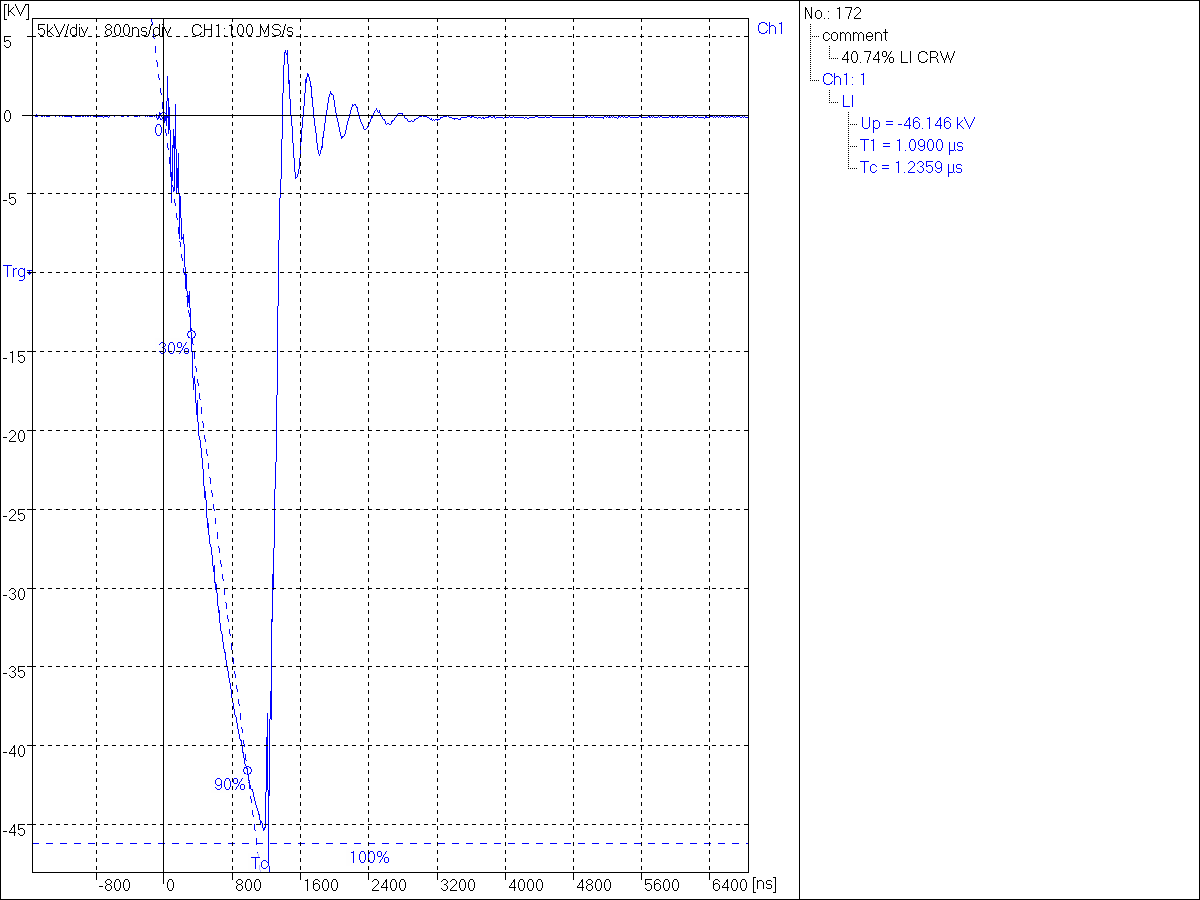
[picture p66: figure]

55 kv with surge arrestor

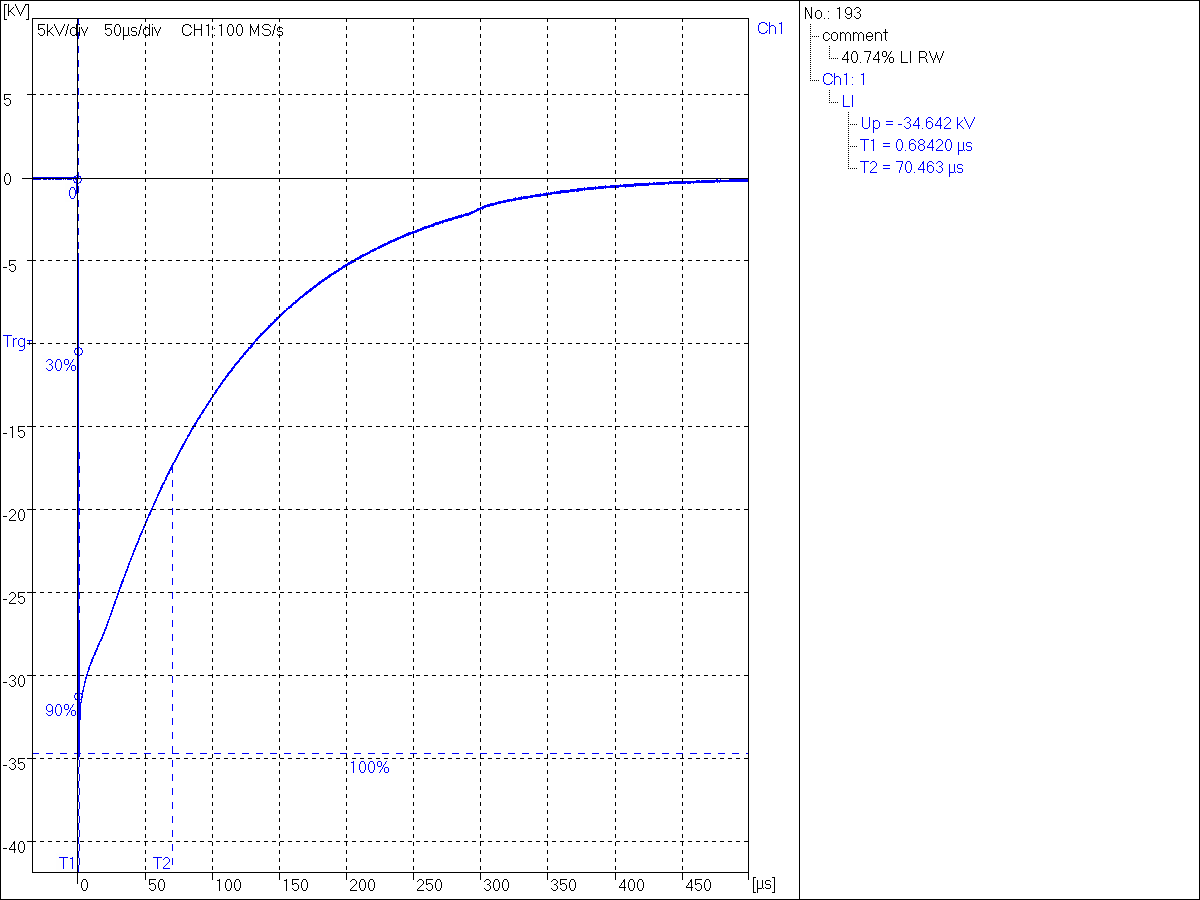
[picture p67: figure]

-45 kv with breakdown 10mm

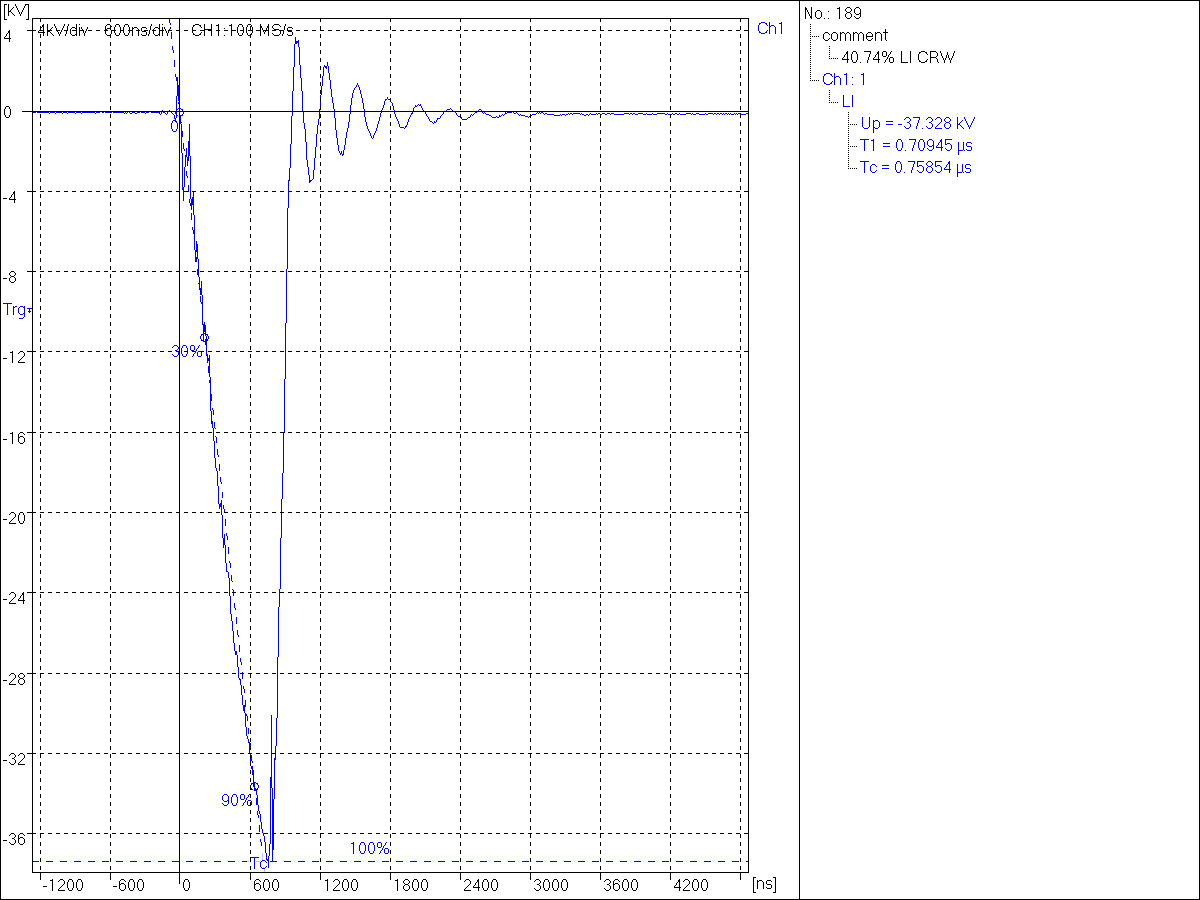
[picture p68: figure]

-55kv 10mm

AC voltage rectified by the two diodes to charge C1 with a DC voltage. The test is carried out first before without the test object to see the impulse voltage waveform that is generated in C2 and, therefore, efficiency of the system. The SW assumes the efficiency is 1 so the test need to be carried out without the test object to calculate the real efficiency. The test’s procedure consists in using a software to apply a peak DC impulse voltage to C1. The distance of the sphere gap is changed automatically based on the charging voltage of C1. A negative lightning impulse voltage is applied to C1 to see the breakdown voltage between the sphere’s gap. This value is noted down together with the time it takes to reach the breakdown point.
