NicolaiFransen/Semester-Project-PED1/Others/HighVoltage/AA Final Reports/Lab exercise 4.pdf

# 4. Unit step response of an impulse measuring system

### 4.1 Objectives

The student must gain the following knowledge and comprehension in the following topics:
- General description of problems in the impulse voltage measurement derived from the dynamic behavior of measuring system;
- General description of unit step response (USR) method;
- Evaluation of measurements of transient voltages measured with a capacitive voltage divider system;
- Design of capacitive voltage divider impulse voltage measuring systems for specific cases.

### 4.2 General Description

### 4.2.1 Measuring system for impulse voltage

Impulse voltages are fast (ns-ms) transients with a relatively high (kV-MV) amplitude. To measure the impulse voltages, it will be necessary to reduce (downscale) the amplitude to a magnitude recordable by the chosen measuring equipment, normally an oscilloscope or an impulse voltmeter. The reduced voltage should ideally be an accurate, downscaled copy of the physical high voltage impulse impressed to the test object with a known, non-varying transfer ratio against all frequency components and other parameter. For practical applications one should be aware of the fact that the measured voltage (on the oscilloscope) would differ from the “real” high voltage because:
− Limitations in the transfer function of the measuring system;
− Noise signals induced/influenced to the measuring system. Generally speaking measuring problems grows worse the larger and faster the voltages are.

SAFETY MEASURES: Interlocks are provided to prevent high voltage to be switched on while the gates/ doors are open. Despite these measures it is necessary to connect the safety earth stick to the HV parts before touching. (There could be some charge left on the capacitors). Special safety rules for the High Voltage laboratory must be read, understood, signed and always followed to every detail!

1

Figure 1 shows the principle layout and components of the impulse voltage measuring system. Every possible current and voltage waveform present in the connection (supply) lead can be resolved into two waves travelling in each direction with a speed of vv[mm/ss]. The waves would, in the case of a

lossless conductor, satisfy the condition stating that the ratio of the voltage and current in any point of the conductor would be constant and equal to the characteristic impedance of the supply conductor.

This characteristic impedance is pronounced ZZBB and can be determined on the basis of inductance and

capacitance per unit length according to:

# ZZBB = LL⁄CC , vv = 1⁄LL (1)

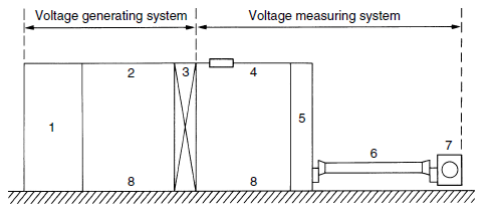
[picture p171: figure]

Fig.1 Impulse voltage test setup (principle drawing), 1. Impulse voltage generator (IVG), 2. Conductor between IVG and EUT, 3. Equipment under test (EUT), 4. Conductor for voltage divider, 5. Voltage divider, 6.measuring cable, 7. Oscilloscope, 8. Ground return conductor
The speed of the waves (wave propagation speed) would for a lossless conductor in the air be equal to the speed of light, vvllllllℎtt = 30 cc /nn . The characteristics impedance ZZBB would normally equal

approximately 400 -500Ω.
The voltage uu(tt) at the top (HV terminal) of the voltage divider would be given by the impressed

impulse voltage and the reflection / transmission of the waves propagating in time on the supply conductor.
This voltage uu(tt) at the HV terminal of the voltage divider will be divided into a lower voltage

impressed to the measuring cable. The voltage divider is in principle constructed be means of two serial connected impedances.
The primary HV impedance ZZ1 is normally of a high value while the secondary LV impedance ZZ2 is very small in comparison to ZZ1. Sometimes one uses the simple method by using the characteristic

impedance of the measuring cable as LV impedance.
The transfer ratio of the voltage divider can be calculated by:

# nn = (ZZ1 + ZZ2 )⁄ZZ2

This value, n, will be practical applications normally be equal to the ratio of the input-to-output voltage and could be pronounced nominal transfer ratio.

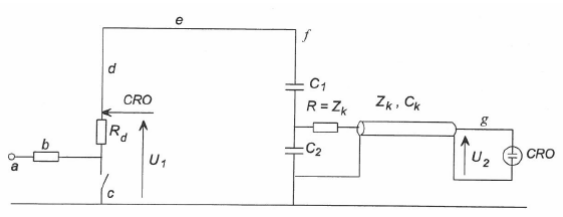
[picture p172: figure]

2

### 4.2.2 Unit step response

The measuring system can be analyzed in the laboratory by means of the transfer function (amplitude and phase frequency characteristics) or the unit step response.
Fig. 2 below shows the principles of the unit step response method for analyzing the dynamic behavior of the impulse measuring system.

Fig.2 Experimental setup for the determination of the unit step response of an impulse measuring system. a. DC supply; b, charging resistor; c. mercury relay; d. vertical conductor with impedance matching Rd; e. supply conductor with length l and height h above ground; f. capacitive voltage divider; g. to oscilloscope.

An unit step voltage is impressed on the measuring system via resistor b. This unit step voltage is present at point d and will be the reference input signal for the unit step response test. The reply of the measuring system on this unit step unit is pronounced the step response of the measuring system and can be recorded with the oscilloscope connected in g. By means of the step response it will be possible to predict the transfer function of the measuring system and thereby be able to estimate the measuring error for an arbitrary input voltage.
The step response of the measuring system provides information on the following characteristic parameters:
− The rise time of the step response reflects the upper frequency limit of the measuring system. − Oscillations in the step response reflects the resonant frequency of the measuring system.
− The area between the unit (amplitude =1) step unit voltage and the normalized step response (limiting value) is pronounced response time T and defined in the following way:

# TT = (1 − gg(tt))dd

∞
0

With g(t) as the voltage waveform of the step response as a function of time. This is illustrated in Fig. 3(a), where the response time TT = TT1 − TT2 + TT3 − TT4 + TT5.
The principle unit step response of the system shown in Fig. 2 with different values of RRdd is shown

in Fig. 3 (b).
Oscillations in s step response normally originate from reflections on the supply conductor, because of the impedance mismatch between the characteristic impedance of the conductor and the high (in

3

comparison to the conductor) impedance of the voltage divider and at the other end of the conductor – to HV generator mismatch.

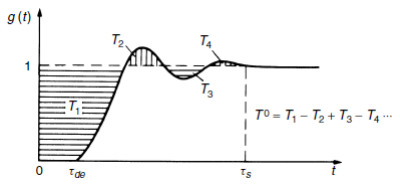
[picture p173: figure]

(a)

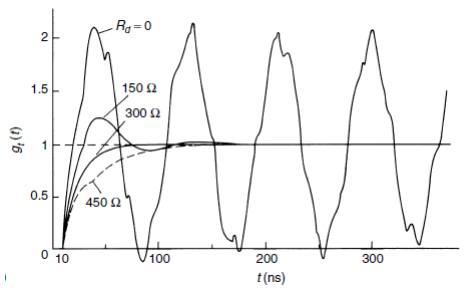
[picture p174: figure]

(b)
Fig. 3 Unit step response of a measuring system
The impedance of a practical impulse measuring application would not be zero, but in the range of the characteristic impedance of the supply conductor. This explains the use of the resistor

RRdd ≈(characteristic impedance of supply conductor) in Fig. 2. The principle response of a practical measuring system would be more like curves in Fig. 3(b) with RRdd = 300Ω oooo 450Ω, and pronounced

“infinite line response”.
It can be shown that the measuring system would react linearly to varying input voltages beyond the time, where the “infinite line” response has reached its final value.
A mathematical approximation of the infinite-line response would be a double-exponential function, which for practical applications would have reached the final value after 4-5 times the response time of the “infinite lime” response (pronounced TT∞ and defined according to the hatched area of Fig 3

(b)).
Practical measuring systems normally react in a way, which will justify the use of the infinite-line response time TT∞ as a guideline to the performance of a measuring system in connection with

measuring fast rising voltages.
I t can also be shown that the peak voltage measuring error ΔVV[kk ] for linearly rising voltages can be calculated as the product of the response time TT[ss] and the steepness SS [kk /ss] of the rising voltage

according to Fig. 4.

4

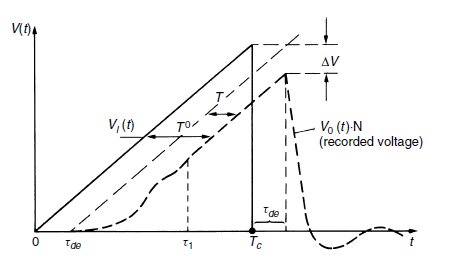
[picture p175: figure]

Please explain components in the circuit and how they work.

# ΔVV = SS ∙ TT

International standards for impulse measuring systems are given in IEC 60-1 to 60-4 “High Voltage test techniques”.

Fig.4 Peak voltage measuring error

### 4.3 Laboratory tasks

The main task is to use the principles outlined above by testing one of the capacitive impulse measuring systems of the high voltage laboratory.

### 4.3.1 Calculations

The students should take a picture of the USR test circuit and explain the components and how they work.

The
The

5

Horizontal supply conductor is a 10m long wire with a diameter of 2mm. It has an average height of 1.6m over the ground plane. Based on arrangements and dimensions of circuit, the students need to conduct following calculations:
− Calculate the impedance of horizontal supply conductor ZZℎoooo;
− Calculate the capacitance CC and inductance LLof the supply conductor;
− Calculate the wave propagation velocityvv in the lead;

− Calculate the transfer ratio n based on values of the capacitors.

### 4.3.2 Unit step response test

The students need do following tasks:
− Conduct the unit step response test according the circuit constructed in section 4.3.1.

− Measure uu1(tt) and uu2(tt) with an oscilloscope, and comment the appearance of the curves.

Then import the date files to eg. MATLAB to calculate the response time T.

− Short circuit RRdd and measure uu1(tt) and uu2(tt) again. Calculate the response time T in this

case.

− Calculate the impulse voltage peak measuring error ΔVV for the linearly rising impulse voltages
with different front steepness SS = 2MM /μμ , 200kk /μμ and 20kk /μμ .

Horizontal supply conductor is a 10m long wire with a diameter of 2mm. It has an average height of 1.6m over the ground plane. Based on arrangements and dimensions of circuit, the students need to conduct following calculations:

− Calculate the impedance of horizontal supply conductor;

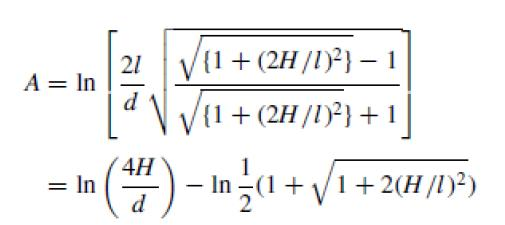
[picture p176: figure]

A = 8.0583 Ω

(ZL)hor | = | 60 ∗ A | = | 483. 5 Ω

− Calculate the capacitance CL and inductance LLof the supply conductor;

ε0 = 8.85 ×10⁻¹² F⋅m⁻¹

CL = 69 pF

LL = 16 μH

− Calculate the wave propagation velocity v in the lead;

v = 30. 1 ×

106 m
s

~ 3. 01 cm/ns

− Calculate the transfer ratio n based on values of the capacitors.

n =

C1+C2
C1

C1 = 600 pF ; C2 = 119.5 nF

n = 200. 166 ~ 200

- Measure u1(t) and u2(t) with an oscilloscope, and comment the appearance of the curves. Then import the date files to eg. MATLAB to calculate the response time T.

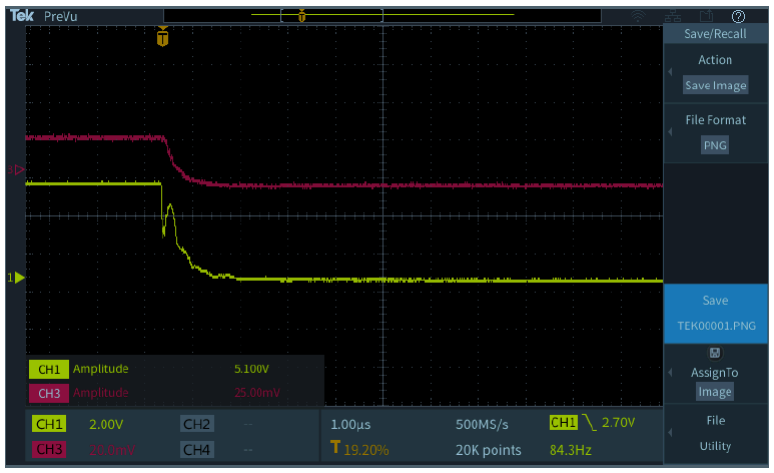
[picture p177: figure]

From the scope the input voltage (5V amplitude) is the yellow curve and the voltage after the capacitive voltage divider is the red curve (25mV amplitude). If we compare both curves it can be validated the transfer ratio found previously:

5V /25mV = 200 = n

Moreover, the output voltage does not reach the final value of the input step voltage because of the capacitors of the voltage divider. In this case the value of Rd = 470 Ω which allows to damp the input voltage and that is why in the output voltage there is no overshoot.

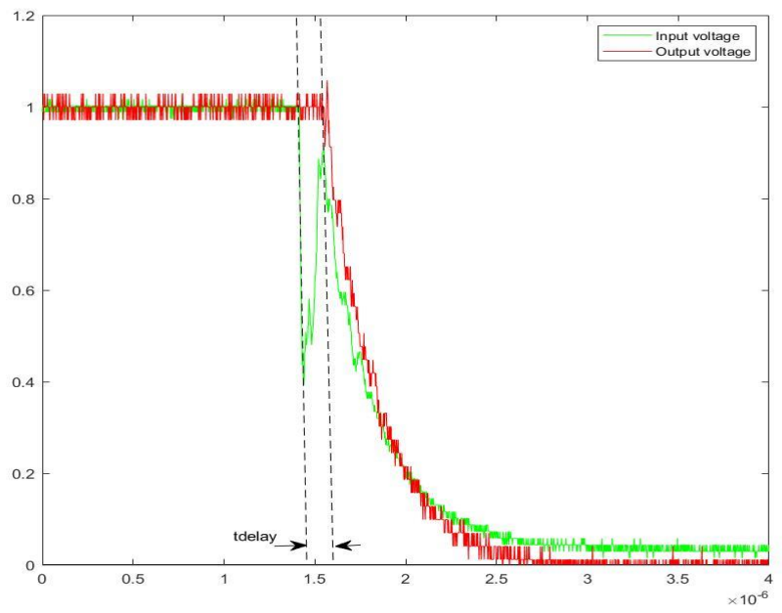
[picture p178: figure]

The response time is calculated as stated in the following equations:

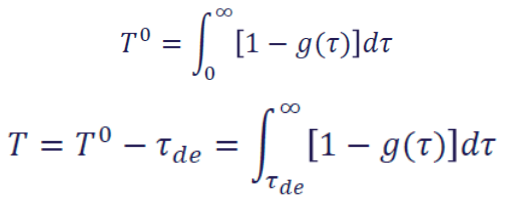
[picture p179: figure]

T = T

0 – tde = 265.5 ns

Where tde is the is the time delay at which the output voltage starts falling from 1 to 0.

- Short circuit Rd and measure u1(t) and u2(t) again. Calculate the response time T in this case.

If the value of Rd is 0 then the system will be undamped and therefore more oscillations will appear in the time response. The next figure reflects these oscillations and even though it seems that the response time in this case is higher than the damped system it is not. This is because when the output voltage gets lower than 0 it is necessary to subtract this time periods as: T=T1−T2+T3−T4+T5 - ……

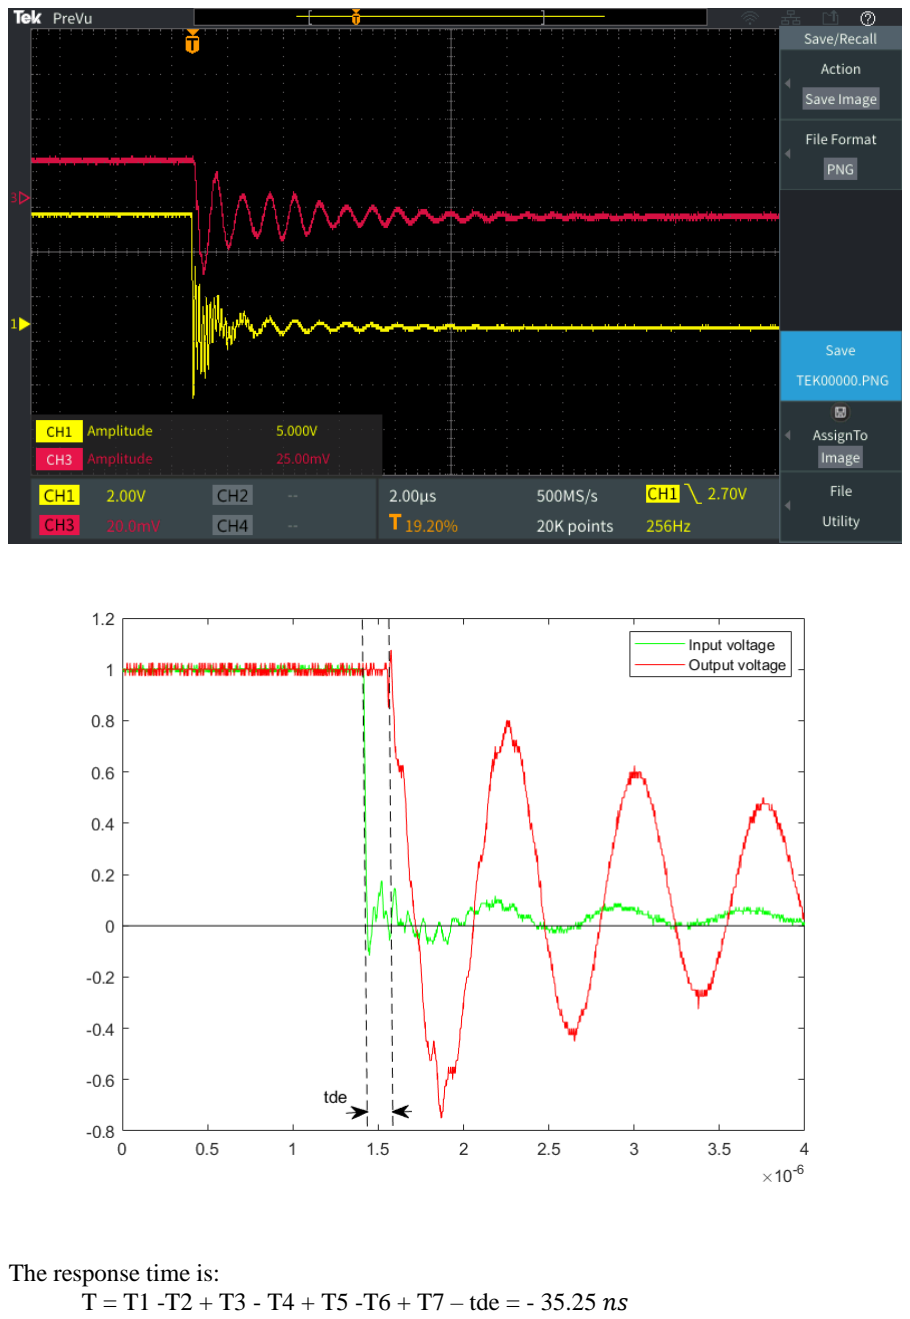
[picture p180: page 10]

The response time is:
T = T1 -T2 + T3 - T4 + T5 -T6 + T7 – tde = - 35.25 ns

- Calculate the impulse voltage peak measuring error ΔV for the linearly rising impulse voltages with different front steepness S=2MV/μs, 200 kV/μs and 20 kV/μs.

S = 2MV/μs:

T = 265.5 ns → ΔV = 531 kV

T = - 35.25 ns → ΔV = -70.5 kV

S= 200 kV/μs

T = 265.5 ns → ΔV = 53.1 kV

T = - 35.25 ns → ΔV = -7.05 kV

S= 20 kV/μs

T = 265.5 ns → ΔV = 5.31 kV

T = - 35.25 ns → ΔV = -0.705 kV
