NicolaiFransen/Semester-Project-PED1/Others/HighVoltage/AA Final Reports/Lab exercise 6.pdf

# 6. Paschen’s curve for atmospheric air

### 6.1 Objectives

The student must gain the following knowledge and comprehension in the following topics:
- Determine the breakdown voltage for atmospheric air in a homogeneous field (Paschen’s law) as a function of the product of gap length and pressure, Vb = f(pd) corrected to standard atmospheric conditions.
- Determine the constants (E/p)c og KK/CC (see page 338 in Kuffel) for

atmospheric air.

### 6.2 General Description

For a homogeneous field, there is an unambiguous relation between the product of gap length, d and pressure, p and the breakdown voltage for a certain gas and a certain electrode material, due to the following relations:

# ∆WW = ee ∙ EE ∙ λλ

λλ ∝

1

# pp , EE = VV

dd

# ∆WW ∝ ee ∙

1
pp ∙

UU
dd
For a certain gas and a certain electrode material, ∆W is a constant which stands

for the energy needed to ionize the gas. Thus:

# VV = ff(pp )

Fig.1 shows the curve which descripts V = f(pd), i.e. the Paschen’s law.

SAFETY MEASURES: Interlocks are provided to prevent high voltage to be switched on while the gates/ doors are open. Despite these measures it is necessary to connect the safety earth stick to the HV parts before touching. (There could be some charge left on the capacitors). Special safety rules for the High Voltage laboratory must be read, understood, signed and always followed to every detail!

1

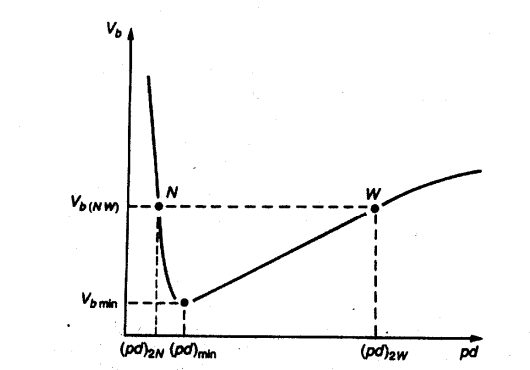
[picture p186: figure]

Fig.1 Paschen’s law
It can be figured out that for each kind of gas, there is a minimum breakdown voltage Vmin corresponding a minimum product of pressure and the gap length, (pd)min. Table I shows the values of Vmin and (pd)min of typical gases.

Table 1 Minimum breakdown voltage for various gases

### 6.3 Laboratory tasks

### 6.3.1 Test description

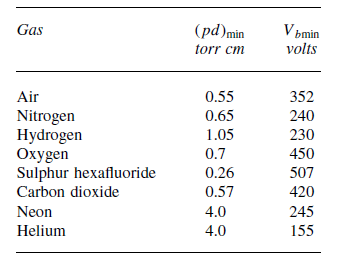
[picture p187: figure]

Create a setup in the HV laboratory as shown in Figure 2. It is important, that the sphere electrodes in the pressure vessel are cleaned (i.e. dust, greasy fingerprints etc.).
For each value of pd is recorded 5 meaurements. After this the pressure vessel must undergo a completely renewal of the air i.e. exchange the content of air to clean, new air. This can be done by opening the vessel and/or pumping by the vacuum pump. Explain why this step is important and include your explanation in the report.
The experiments are performed with AC power frequency. Breakdown in a homogeneous field will be unaffected of the polarity of the applied voltage and will happen for the peak value of the AC-voltage.

2

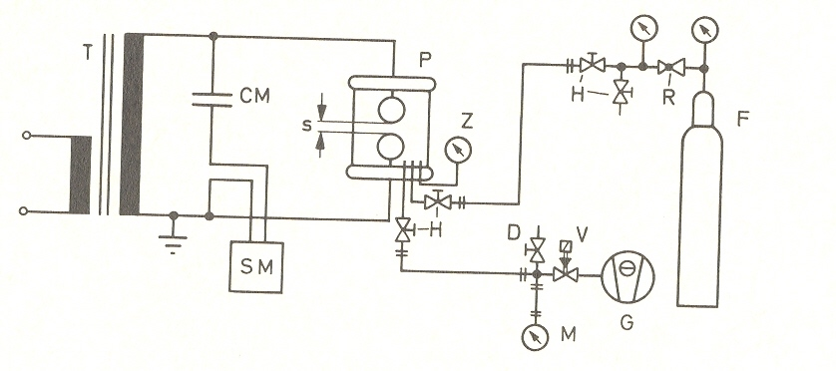
[picture p188: figure]

Fig. 2 The principle of the test setup for measuring the breakdown voltages for Paschen’s law. Furthermore, the processes of the gaseous discharge, are of so great rapidness, that the 50 Hz is acting as DC.
Pressures below 1 bar are established by means of the vacuum pump and pressures above 1 bar with the compressor. Take care no condensation water is present in the pressurized air.
The pressure vessel must not be pressurized to more than 3 bars!

### 6.3.2 Tests

Take 5 measuring points of the breakdown voltage for each value of pd for the gap lengths d=10 mm and d=20 mm, varying the pressure between 0,2 bar and 3 bar. The abscissa should be ”covered” with app. 5 measuring points, which each are averages of 5 points for each gap length

### 6.3.3 Calculation and curves

All breakdown voltages should be referred to standard atmospheric conditions, i.e. p=p0=1,013 bar and T=T0=293 K.

| Pressure [bar] | Average breakdown Gap length d [mm] voltage [kV]

10

Note the sound and visual appearance of the breakdown phenomena at the varying pressures (lower the light of the lab.)

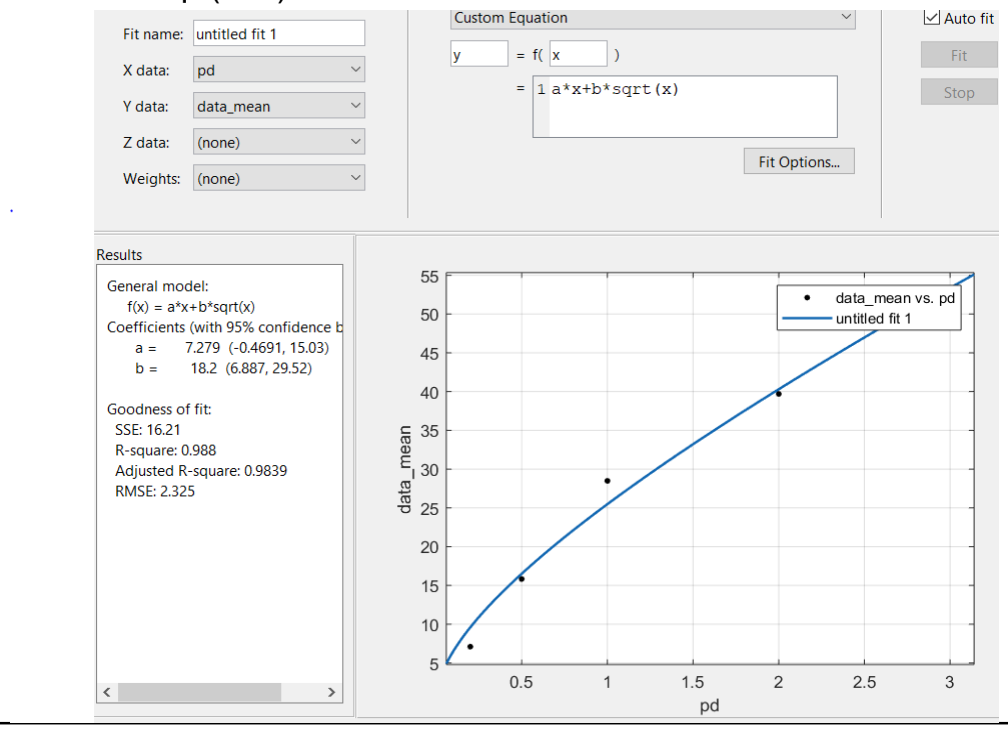
[picture p189: figure]

3

Please draw the Paschen’s law curve.

- Calculate the standard deviation for each measuring point and mark in a semilogarithmic graph as i.e. figure 5.23 in HVE pp. 338. Use the signature ”x” for d=10 mm and the signature ”o” for d=20 mm. The standard deviation is shown with horisontal bars around the measuring points. Draw the Paschen’s law curve below. Compare with figure 5.23 and table 3.3 pp. 83 –

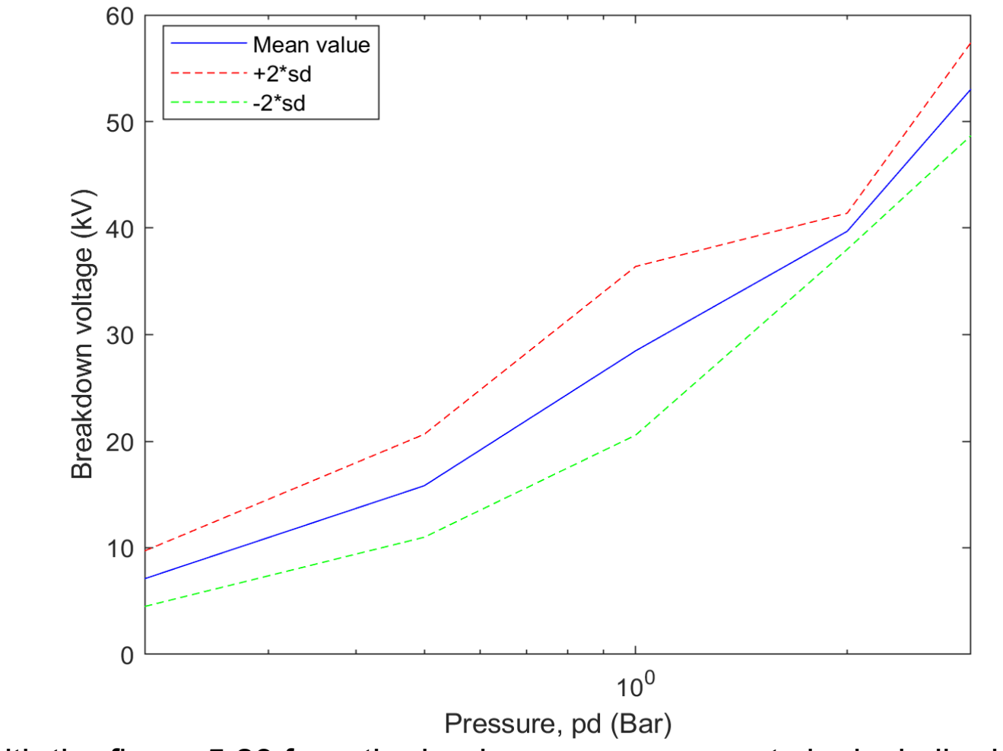
[picture p190: figure]

COMMENT !
- By means of MATLAB and the routine FMINS you should determine the optimum values of

(E/p)c andKK CC⁄ , see eq. 5.102 and 5.103 in HVE pp. 338. These should be compared with the standard values for air; (E/p)c = 24,36 kV/cm and KK CC⁄ = 6,72 kV/cm½ .The fitted curve based on 5.102 with your own values for (E/p)c and KK CC⁄ should be drawn in the same graph

as the measurements together with the ”official” one from figure 5.23 – COMMENTS PLEASE !

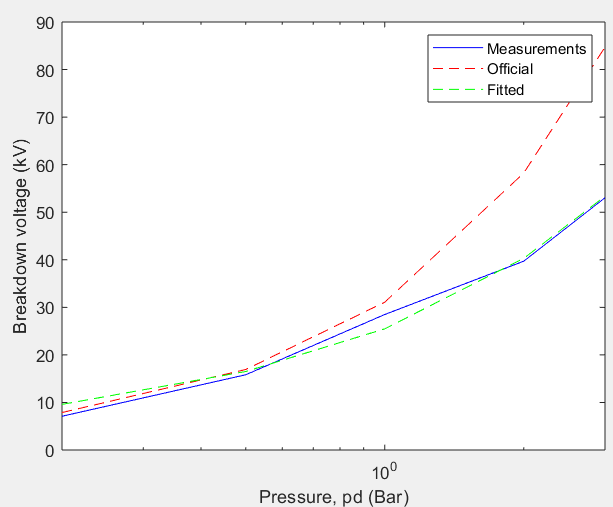
[picture p191: figure]
