NicolaiFransen/Semester-Project-PED1/Others/HighVoltage/AA Final Reports/Lab exercise 8 - with solution.pdf

# 8. Dielectric Loss Angle

SAFETY MEASURES: Interlocks are provided to prevent high voltage to be switched on while the gates/ doors are open. Despite these measures it is necessary to connect the safety earth stick to the HV parts before touching. (There could be some charge left on the capacitors). Special safety rules for the High Voltage laboratory must be read, understood, signed and always followed to every detail!

### 8.1 Objectives

The student must gain the following knowledge and comprehension in the following topics:

- General description of the non-destructive high voltage test method: Schering-bridge.
- Assessment of the capacitance, Cx, and the dissipation factor, tan δx: ABB inductive voltage transformer.
- Assessment of the capacitance, Cx, and the dissipation factor, tan δx: ideal homemade capacitor.

### 8.2 General Description: Schering-bridge

The loss factor or dissipation factor, tan δ, is an indicator of the quality of solid or liquid dielectrics. In order to measure the capacitance and dissipation factor, tan δ, a non-destructive test is performed with the high voltage Schering-bridge, which schematic is shown in Figure 1 and the test equipment is shown in Figure
2. Such tests are usually carried out at different voltage levels in order to ensure that both capacitance and dissipation factor are constant, i.e., linear with respect to voltage. The Schering-bridge adjusts the resistance and capacitance values automatically. In case that some deviations are observed when measuring the loss angle at different applied voltage levels; two possible explanations can be given: i) non linearity of the system (please explain this with the polarization processes as being non-linear), ii) indication of partial discharges.

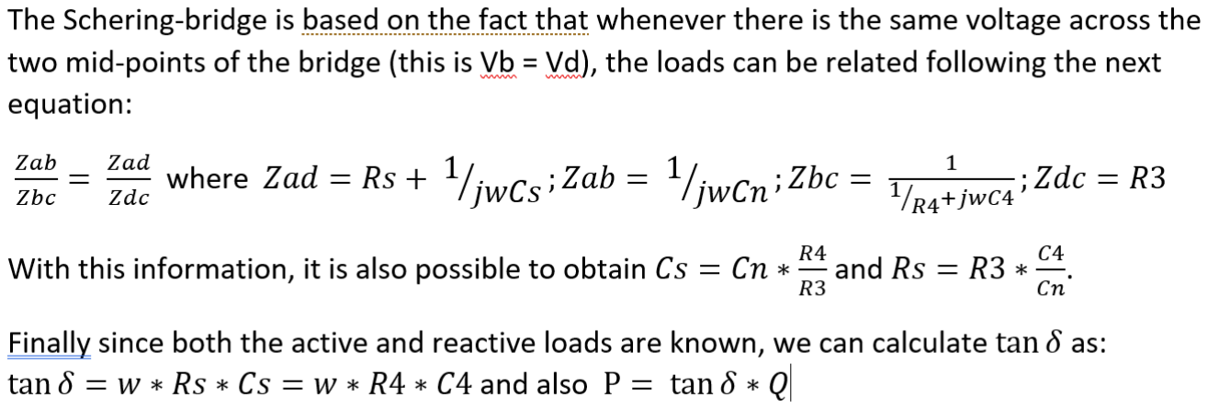
[picture p192: figure]
▪ Operating principle.; Schering-bridge.

The student must provide a general description of the Schering-bridge:

- Schematic of the Schering-bridge including all its components.
- Mathematical expression to calculate the dielectric losses, Pdiel, the dielectric loss factor, tan δ, and the capacitance, C, of the balanced

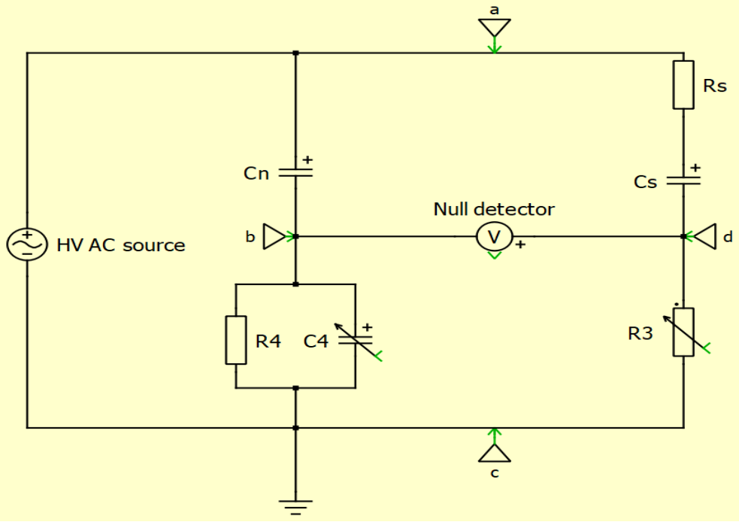
[picture p193: figure]
Measuring Bridge Type TG-3MOD.

1

Figure 1. Typical Schering-bridge setup. | Figure 2. Capacitance and Dissipation Factor

### 8.3 ABB Inductive Voltage Transformer

### 8.3.1 Setup Description

During the first experiment, the capacitance and the loss angle of the 60 kV ABB inductive voltage transformer EMF (EMF 52‐170) will be measured. The test object is connected between the primary

terminals (High Voltage side, point (a) from Figure 1) and the secondary terminal (point (d) from Figure 1). The normal capacitor, CN, consists of a pressurized gas capacitor which represents an ideal capacitor, therefore it can be assumed that φN = 0. The low voltage branch is included inside the measuring equipment (capacitance and tan δ measuring bridge).

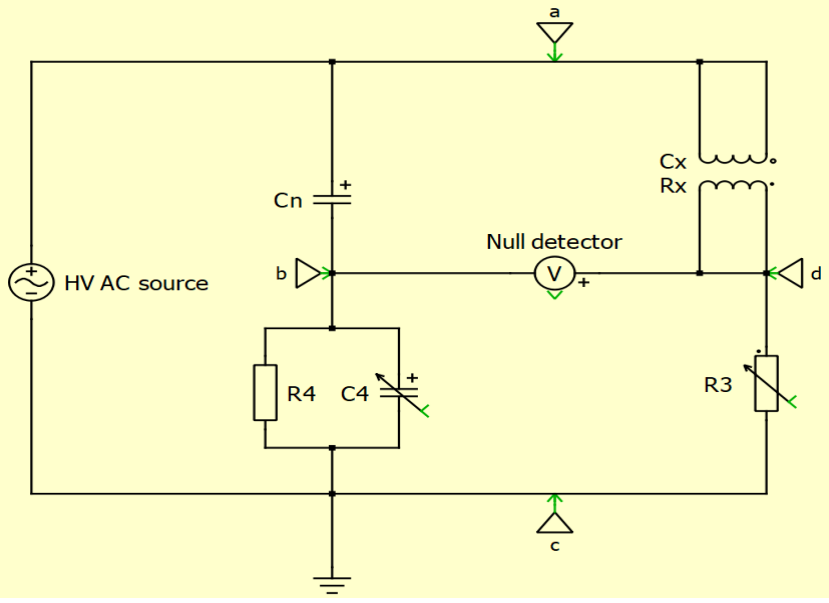
[picture p194: figure]
inductive voltage transformer.

### 8.3.2. Results and discussions

Please draw a schematic of the Schering-bridge including the current path inside ABB

adsf The operation principle of the Schering-bridge is based on the fact that whenever the voltage at the middle point of the two loads is equal (meaning Vb = Vd), the two loads can be related to each other following the next equation:

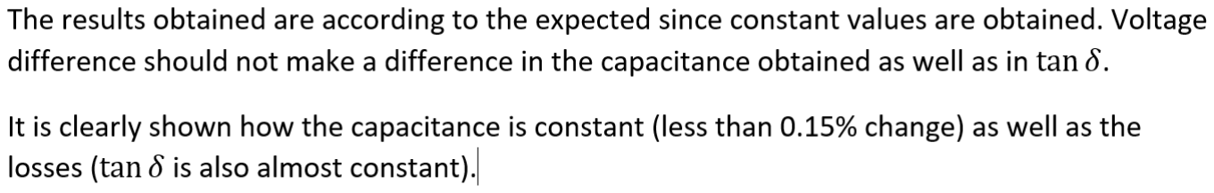
[picture p195: figure]
▪ Are the results reasonable? Why?; for all your statements.

2

The 60 kV inductive voltage transformer must be tested at different voltage levels in a range between

# 0 kkkk − 60

√3
kV.
V [kV] | Cx [pF] | tanδx | δx [º] | I [µA]
1.5 | 686 | 0.021 | 1.203 | 337
2.0 | 686 | 0.021 | 1.203 | 440
2.5 | 686 | 0.021 | 1.203 | 559
3.0 | 686 | 0.0214 | 1.226 | 670
4.0 | 686 | 0.0215 | 1.232 | 885
4.5 | 686 | 0.0218 | 1.249 | 993
5.0 | 687 | 0.0219 | 1.255 | 1102

Please make sure to discuss the following:

- Are the capacitance and the loss angle constant? Remember to provide a detailed explanation

### 8.4 Homemade Capacitor

### 8.4.1 Setup Description

During the third experiment, the inductive voltage transformer will be replaced with a homemade capacitor which is purely capacitive. The purpose is to conclude with a clearer idea of the experimental setup and understand the fundamental principle of the Schering-bridge.

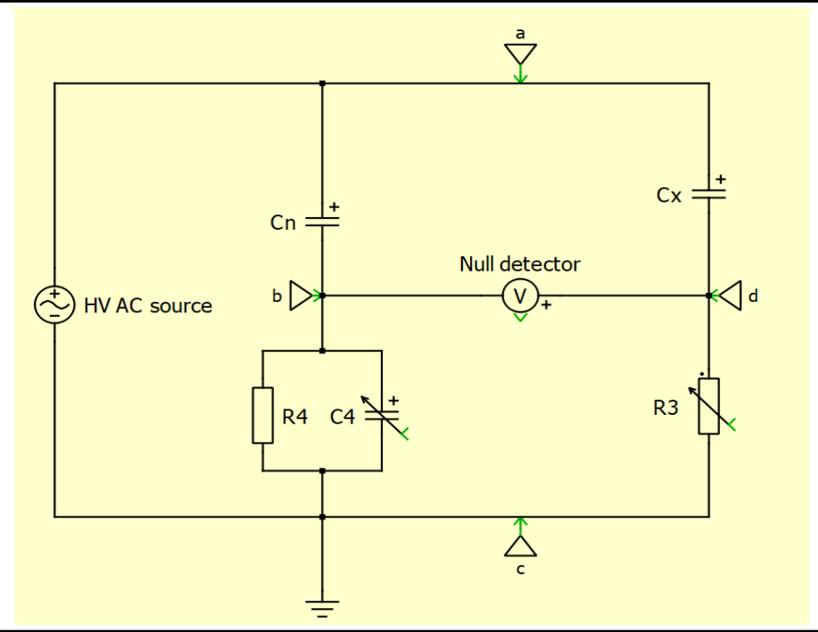
[picture p196: figure]
voltage transformer.

### 8.4.2 Results and Discussions

Please draw a schematic of the Schering-bridge including the current path inside ABB inductive

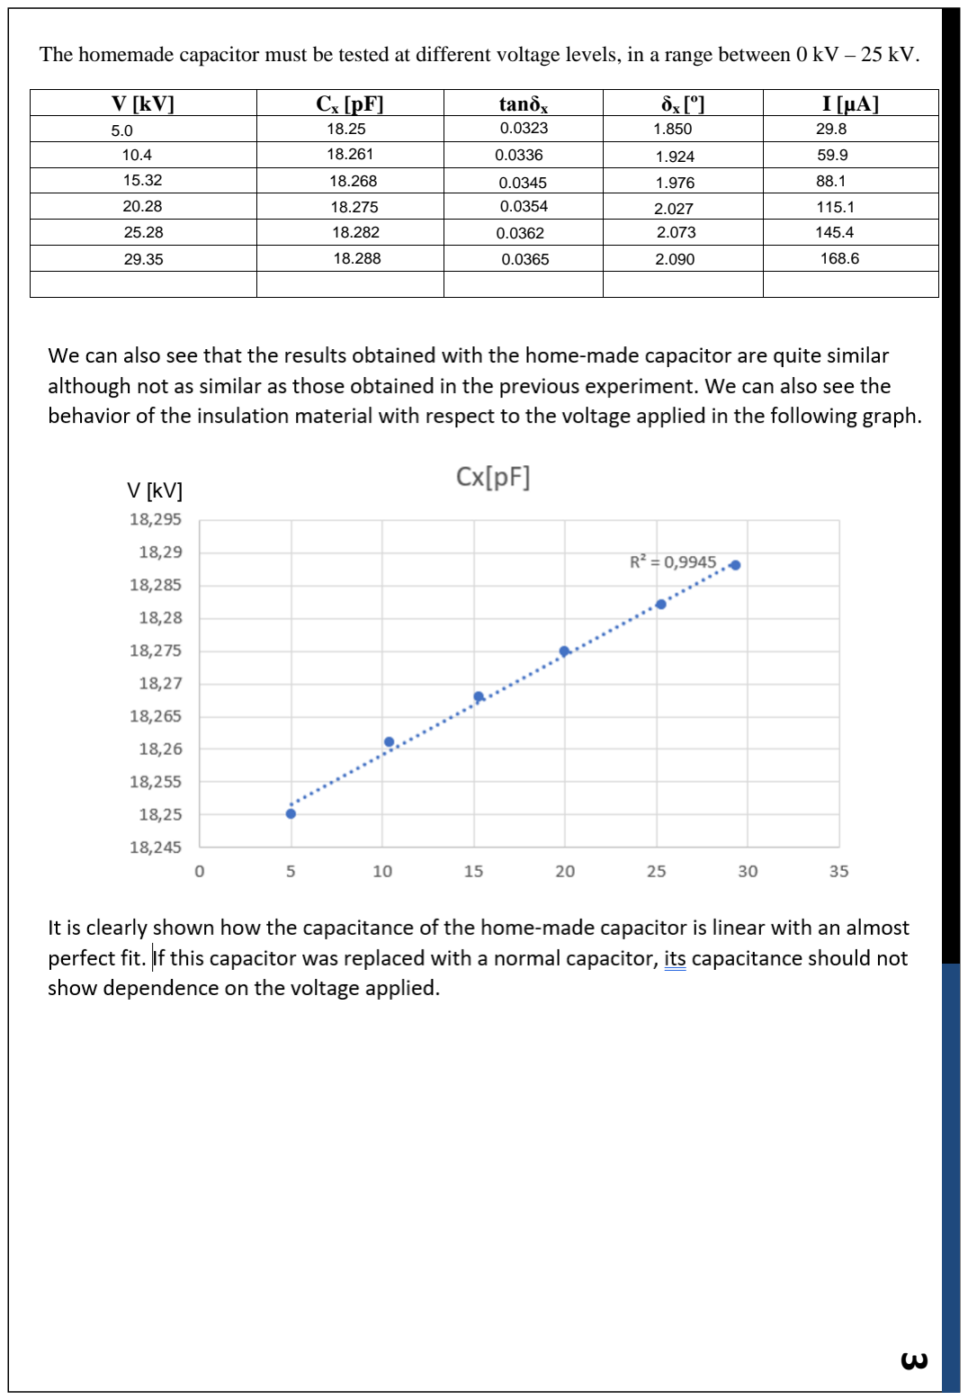
[picture p197: page 4]

3

The homemade capacitor must be tested at different voltage levels, in a range between 0 kV – 25 kV.

V [kV] | Cx [pF] | tanδx | δx [º] | I [µA]
5.00 | 18.25 | 0.0323 | 1.850 | 29.8
10.4 | 18.261 | 0.0336 | 1.924 | 59.9
15.32 | 18.268 | 0.0345 | 1.976 | 88.1
20.28 | 18.275 | 0.0354 | 2.027 | 115.1
25.28 | 18.282 | 0.0362 | 2.073 | 145.4
29.35 | 18.288 | 0.0365 | 2.090 | 168.6

Please make sure to discuss the following:

- Which are the main differences between using a voltage transformer or an ideal capacitor as a test object?
- In case that the test object is replaced with a normal capacitor (e.g., any HV capacitor), what do you expect to observe?
- Comment on the linearity or non-linearity of the insulation material.

V [kV]
