NicolaiFransen/Semester-Project-PED1/Others/HighVoltage/AA Final Reports/Lab exercise 3.pdf

# 3. IMPULSE VOLTAGES: LIGHTNING IMPULSE

SAFETY MEASURES: Interlocks are provided to prevent high voltage to be switched on while the gates/ doors are open. Despite these measures it is necessary to connect the safety earth stick to the HV parts before touching. (There could be some charge left on the capacitors). Special safety rules for the High Voltage laboratory must be read, understood, signed and always followed to every detail!

### 3.1 Objectives

The student must gain the following knowledge and comprehension in the following topics:
- General description of the lightning test procedure and become familiar with the experimental setup.
- Conduct first lightning test without DUT (Device Under Test) and describe the procedure.

# - Measure the volt-time characteristics for sphere-sphere gaps and

rod-rod gaps.
- Examine the effect of a surge arrester.

### 3.2 General Description

There are two types of overvoltage pulses which power systems should withstand – lightning and switching. In the field, these transients can take different wave shapes. Lightning overvoltage typically occur due to lightning strokes hitting the phase wires of overhead lines or outdoor bus bars. Amplitudes are very high (i.e., 1000 kV), therefore the insulation may breakdown and the voltage is chopped, however it is also possible that the insulation may not breakdown and withstand the overvoltage. In case that the insulation does not breakdown a full lightning impulse voltage shape can be observed. In case that the there is a breakdown of the insulation; the voltage can be chopped on the front or on the tail.
Lightning impulses have very fast voltage rise, the standard lightning impulse is described as 1.2/50 μs wave. On the other hand, switching impulses have slower voltage rise, typically 250/2500 μs. Switching impulses are not the scope of this laboratory session; therefore no further details are given.

### 3.3 Laboratory tasks

### 3.3.1 Experimental circuit

1

In order to generate a wave with TT1/TT2 = 1.2/50μμμμ, a single-stage generator circuit is used. The

student must carry out the following tasks:

- Calculate the values of RR1 and RR2 , as the values of CC1 and CC2 are known. Calculate the efficiency ηη.
- Compare the measured ηη, chosen values of RR1 and RR2 in the circuit with the calculated

values, comment on it.

Remember to take a picture of the setup and include it in the mini-project.

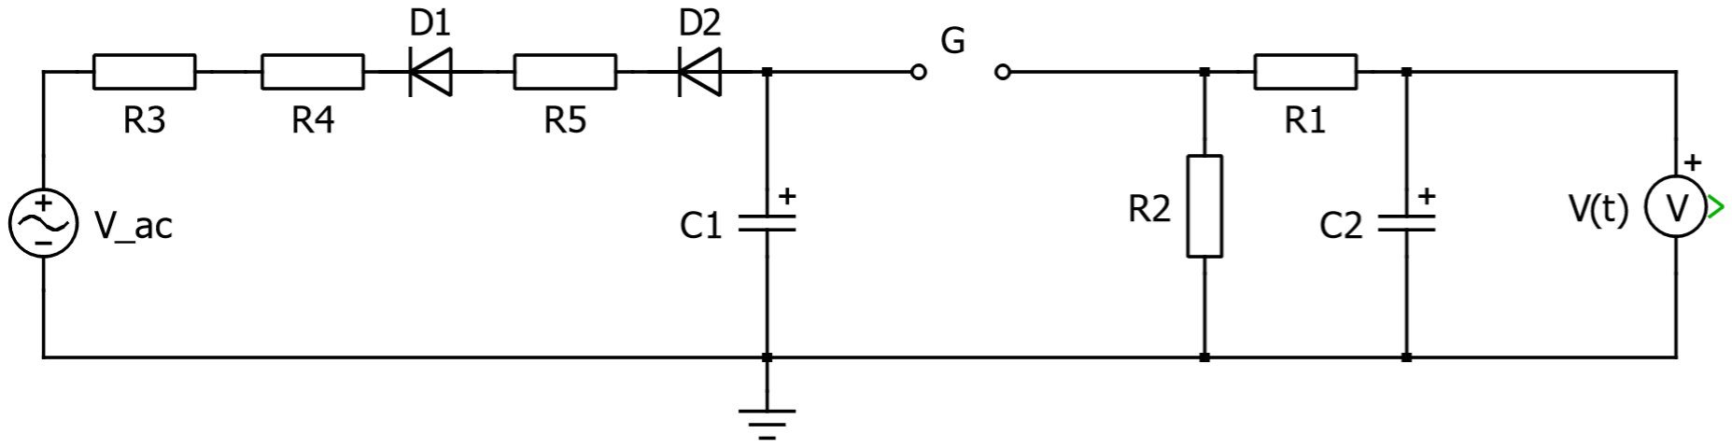
[picture p198: figure]

### 3.3.2 Lightning test

Once the student becomes familiar with the setup and understands the principle of the lightning impulse, the next step is to conduct the first lightning impulse without any device under test.
The procedure will be explained during the laboratory session so the student is expected to take notes

Please draw a schematic of the setup with all the equipment that has been used:

- Draw as detailed as possible the schematic of the setup, equipment, etc., and explain the charging and discharging processes.
- Which type of single‐stage impulse generator circuit is implemented?
- How is the impulse generator adjusted to obtain a higher impulse?
- Identify from the setup the type of lightning impulse: positive or negative? Why?

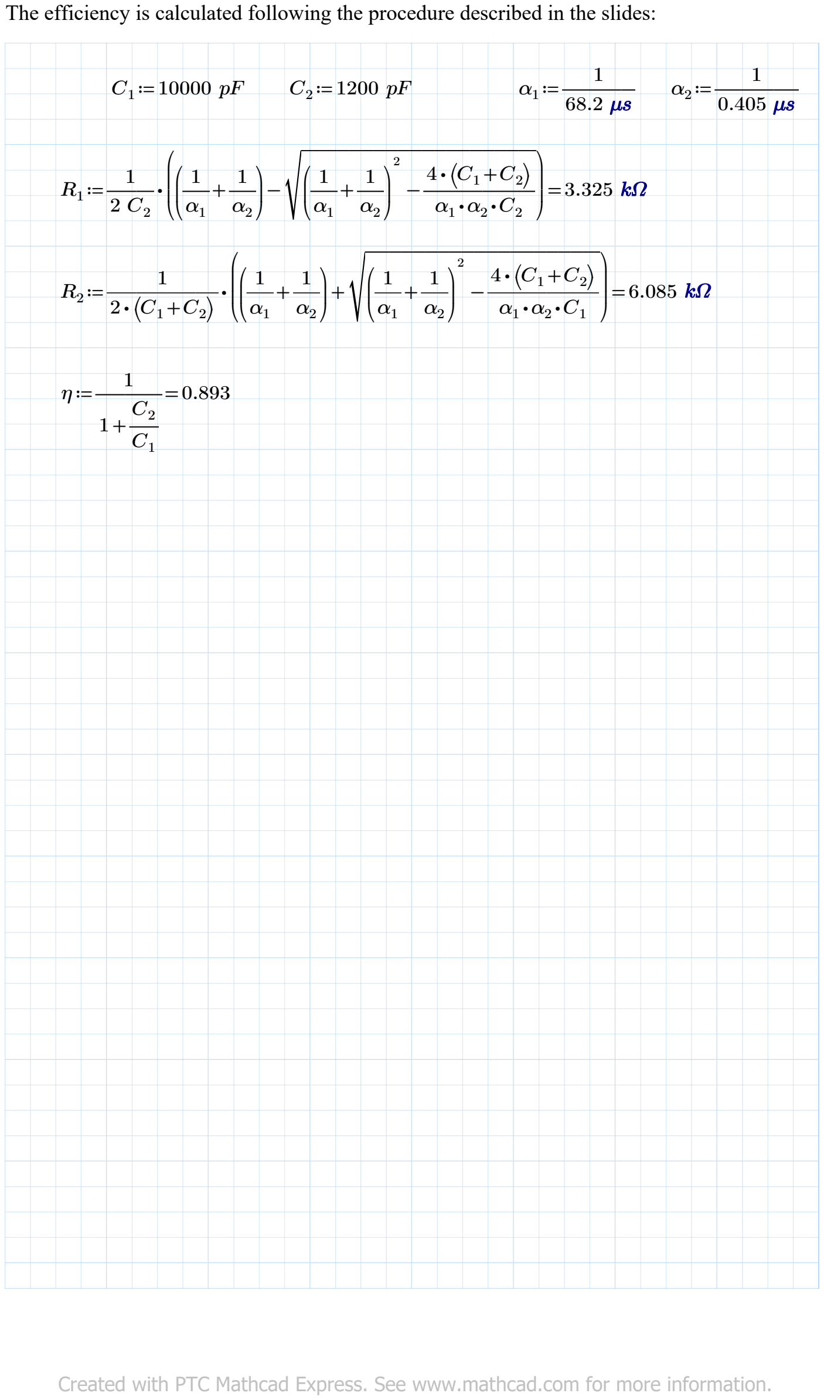
[picture p199: page 3]

C1≔10000 pF | C2≔1200 pF | α1≔――1 ― 68.2 μs

α2≔――1 ― 0.405 μs

R1≔――⋅ | =

1
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
