NicolaiFransen/Semester-Project-PED1/Calculation/MOSFET/MOSFETcurrent.pdf

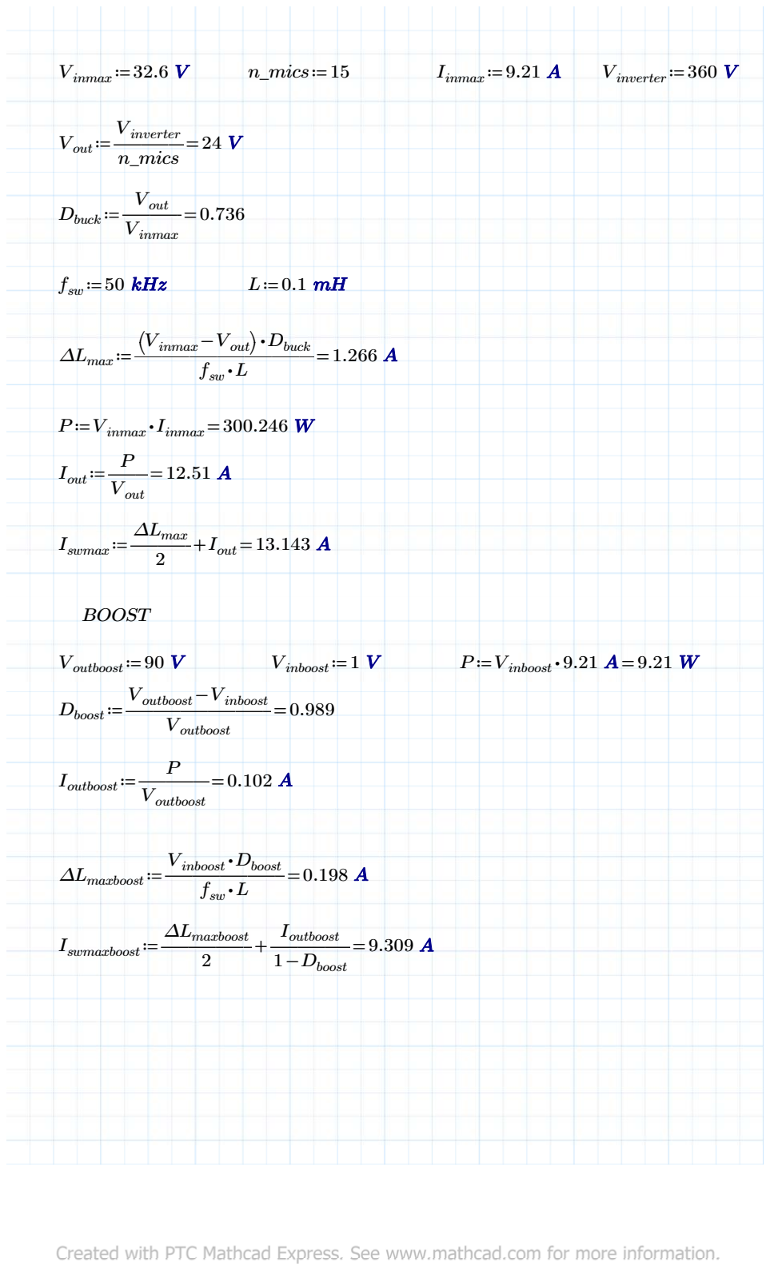
[picture p200: page 1]

Vinmax≔32.6 V | n_mics≔15 | ≔ Iinmax | 9.21 A | Vinverter≔360 V

Vout≔―――= Vinverter

n_mics

24 V

Dbuck≔―――= Vout

Vinmax

0.736

fsw≔50 kHz | L≔0.1 mH
ΔLmax≔―――――――= ⎛ | ⋅ ⎝Vinmax-Vout⎞ ⎠ Dbuck

f ⋅ sw L

| 1.266 A

P≔Vinmax ⋅ Iinmax=300.246 W

Iout≔――= P

Vout

12.51 A

Iswmax≔―――+ = ΔLmax

2

Iout 13.143 A

BOOST

Voutboost≔90 V | Vinboost≔1 V | P≔Vinboost⋅ 9.21 A =9.21 W
Dboost≔――――――= Voutboost-Vinboost Voutboost | 0.989

Ioutboost≔―――= P

Voutboost

0.102 A

ΔLmaxboost≔―――――= V | ⋅ inboost Dboost

f ⋅ sw L

0.198 A

Iswmaxboost≔――――+ | = ΔLmaxboost
2 | ――― Ioutboost
| 1- Dboost

9.309 A
