NicolaiFransen/Semester-Project-PED1/Calculation/MOSFET/MOSFET_body_diode-recovery_reverse.png

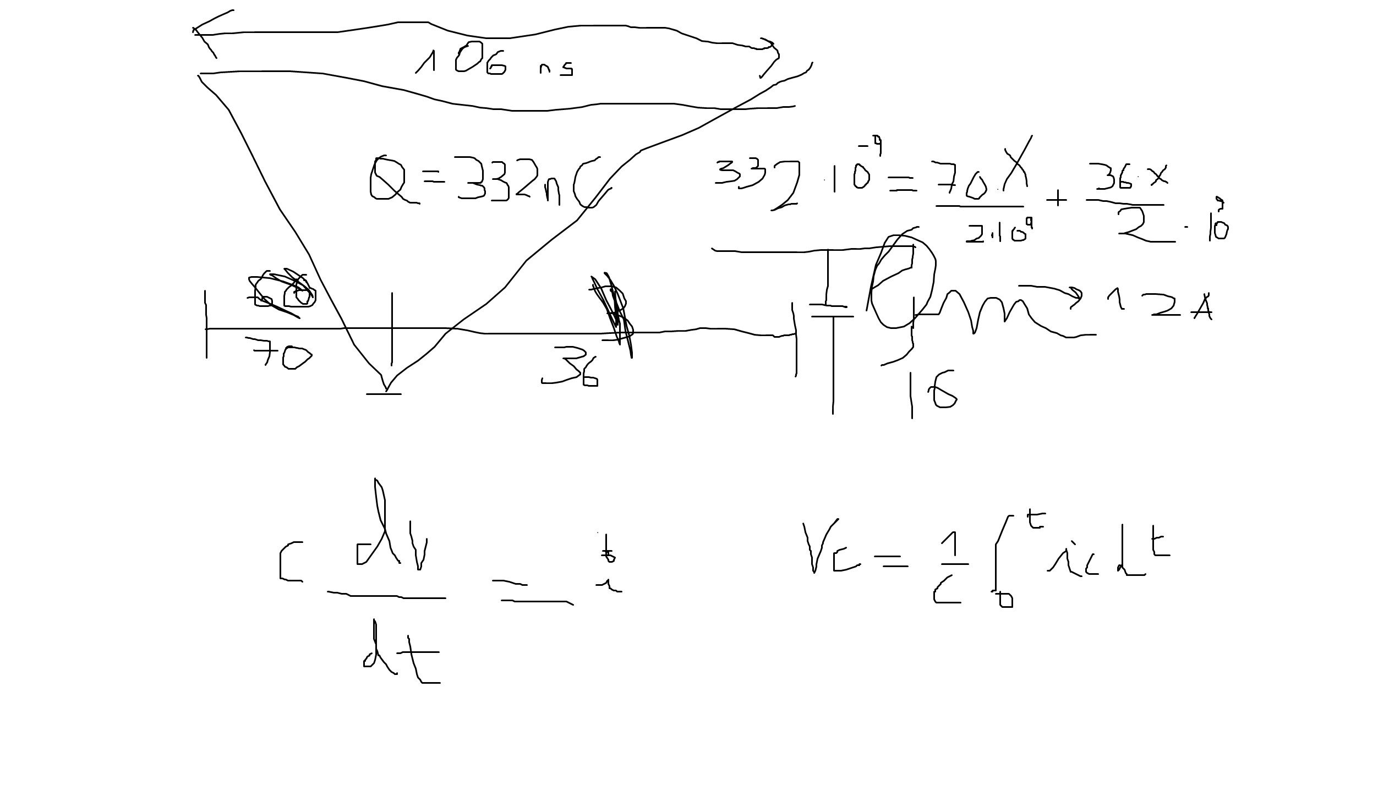
Calculation/MOSFET/MOSFET_body_diode-recovery_reverse.png
