NicolaiFransen/Semester-Project-PED1/Calculation/Sensors/Current_sensor_explained.jpg

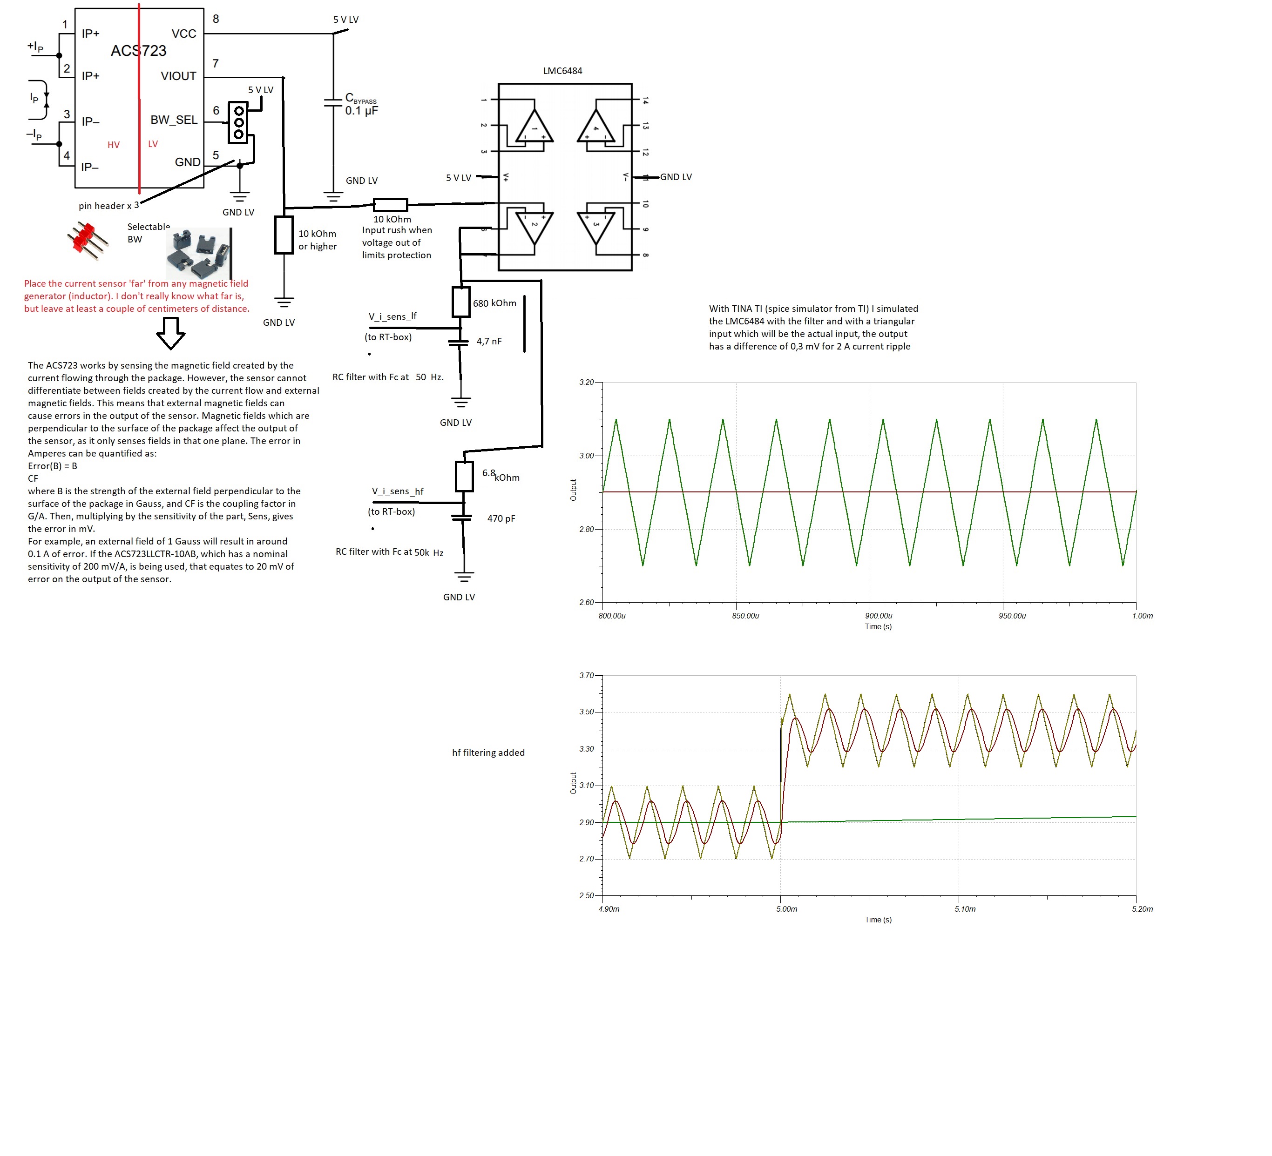
Calculation/Sensors/Current_sensor_explained.jpg
