NicolaiFransen/Semester-Project-PED1/Exam/Pictures/fsm2.png

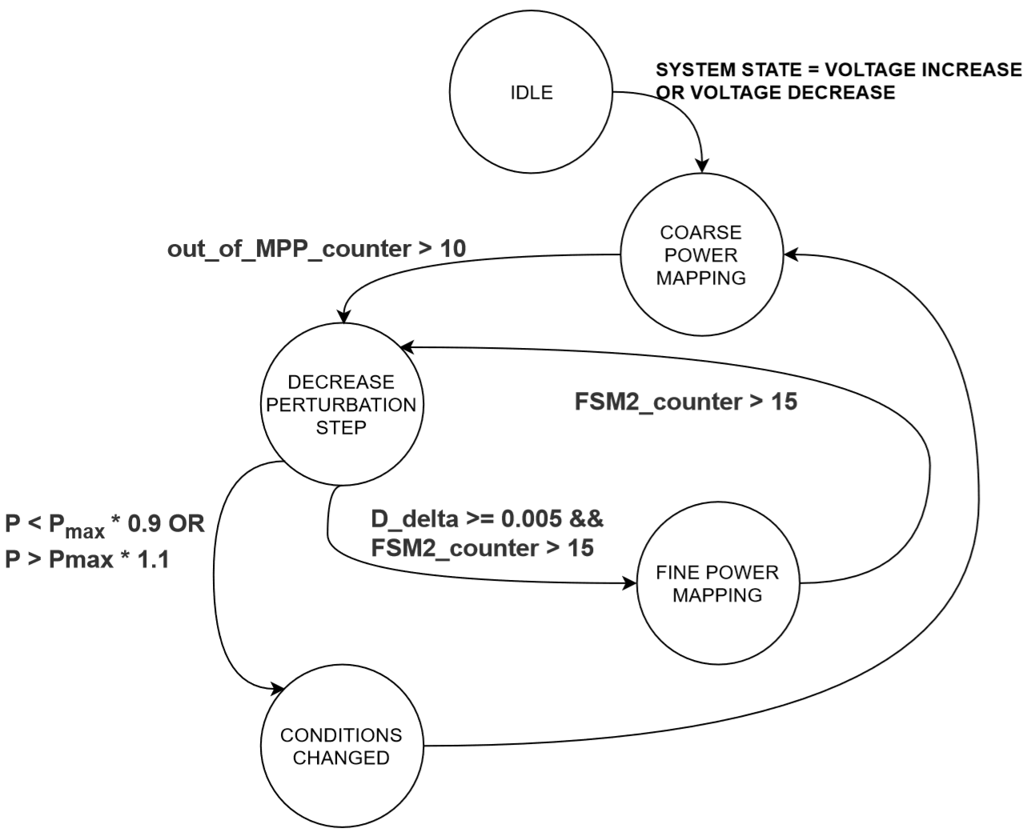
Exam/Pictures/fsm2.png
