NicolaiFransen/Semester-Project-PED1/Exam/Pictures/MIC_dcdc.png

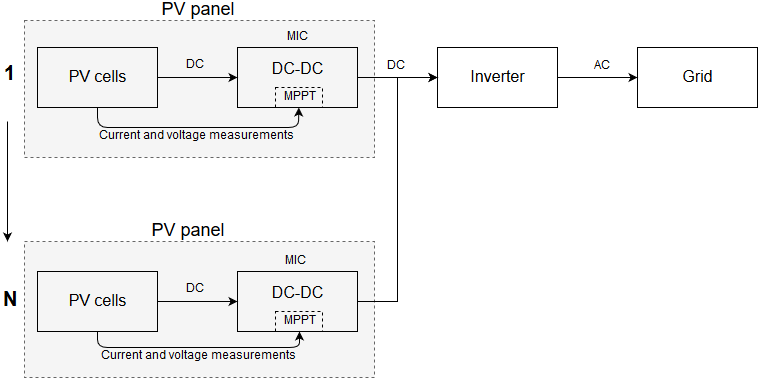
Exam/Pictures/MIC_dcdc.png
