NicolaiFransen/Semester-Project-PED1/Exam/Pictures/MPPT_V2.gif

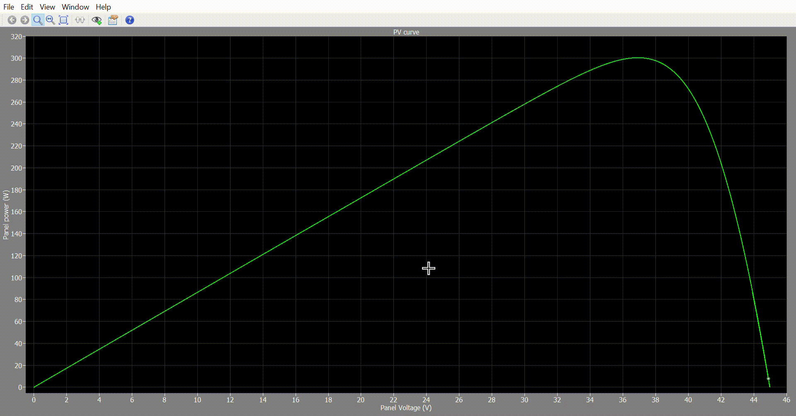
Exam/Pictures/MPPT_V2.gif
