NicolaiFransen/Semester-Project-PED1/Exam/Pictures/Partial_shading.jpg

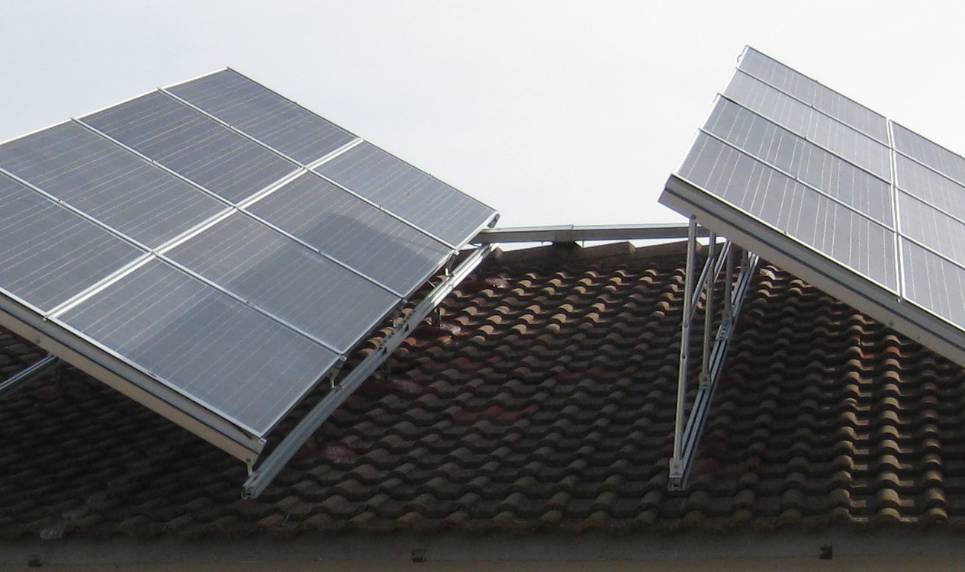
Exam/Pictures/Partial_shading.jpg
