NicolaiFransen/Semester-Project-PED1/Exam/Pictures/schematic_MPPT_lab.png

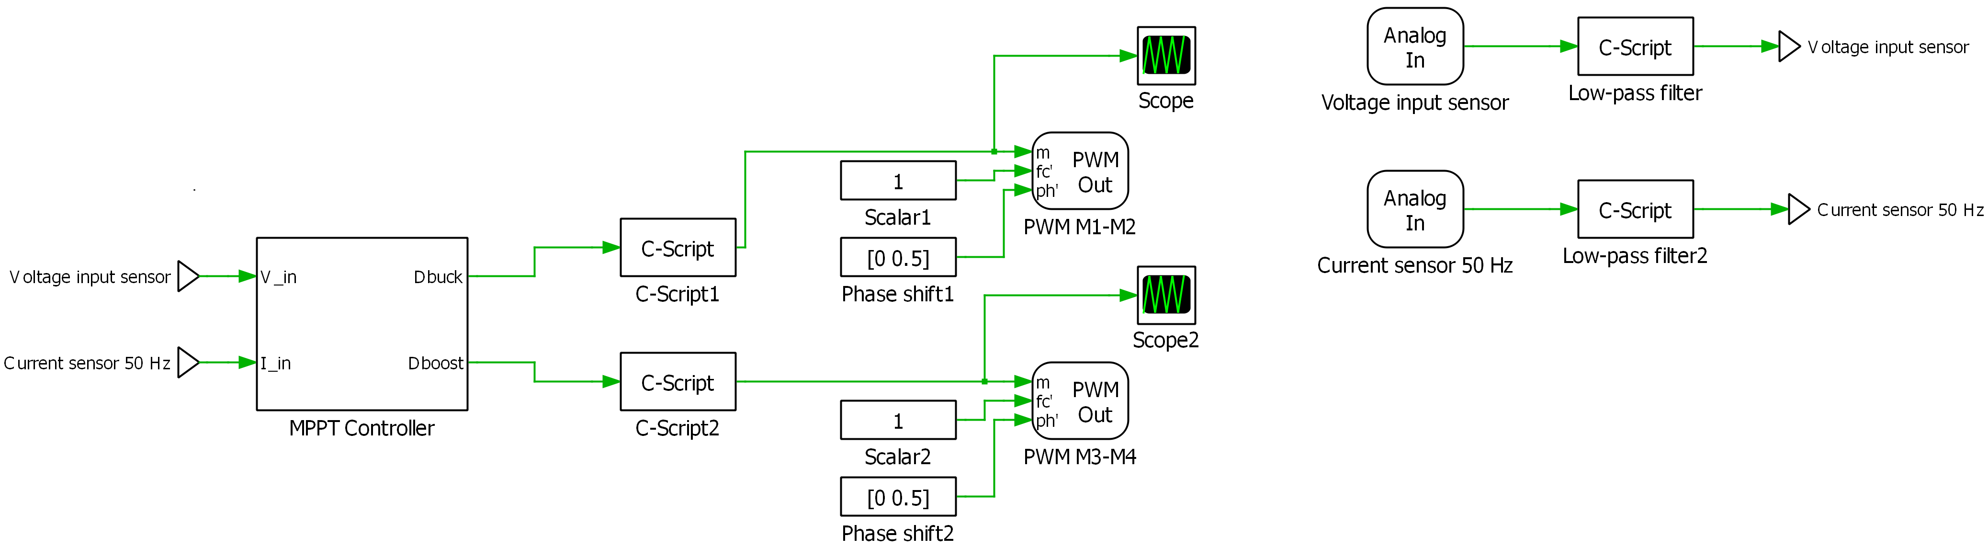
Exam/Pictures/schematic_MPPT_lab.png
