NicolaiFransen/Semester-Project-PED1/Exam/Questions/BypassDiode_vs_mic/BypassDiode.PNG

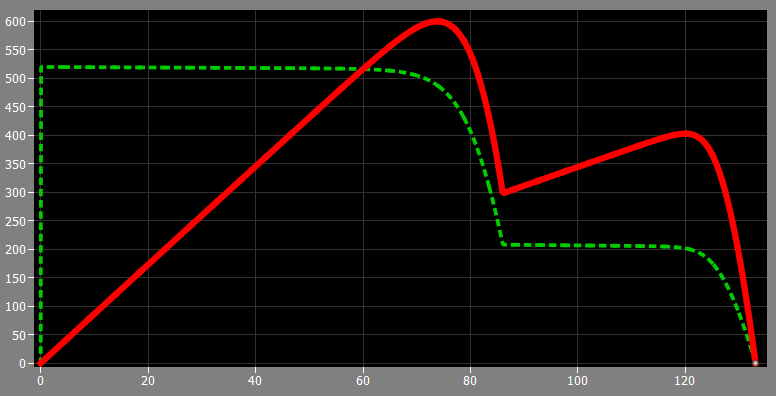
Exam/Questions/BypassDiode_vs_mic/BypassDiode.PNG
