NicolaiFransen/Semester-Project-PED1/Exam/Questions/Cout/Cout_P_Vout.png

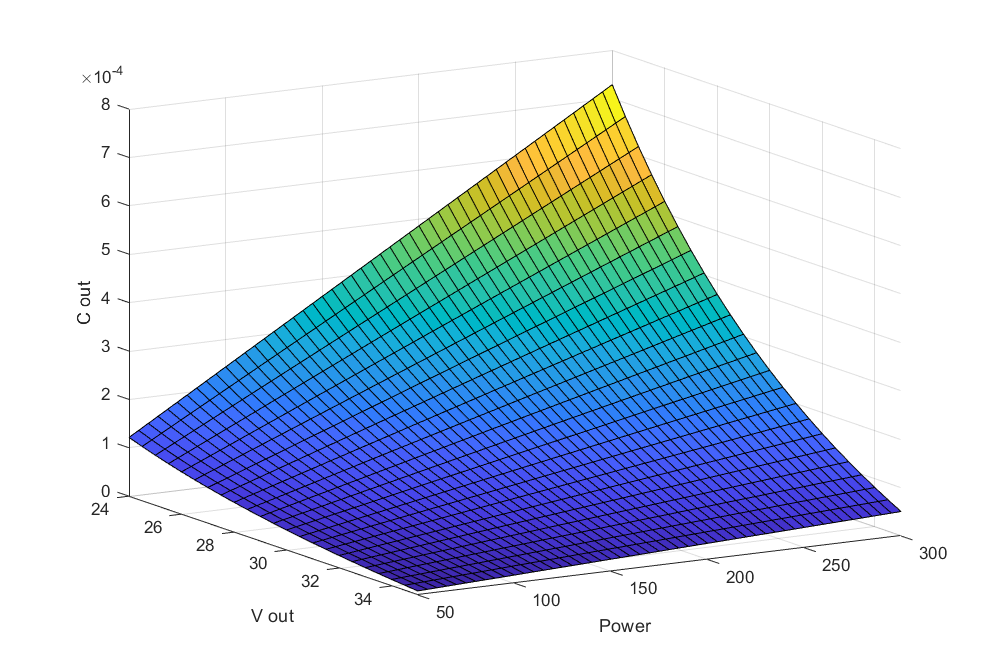
Exam/Questions/Cout/Cout_P_Vout.png
