NicolaiFransen/Semester-Project-PED1/Exam/Questions/DCM/Axis.jpg

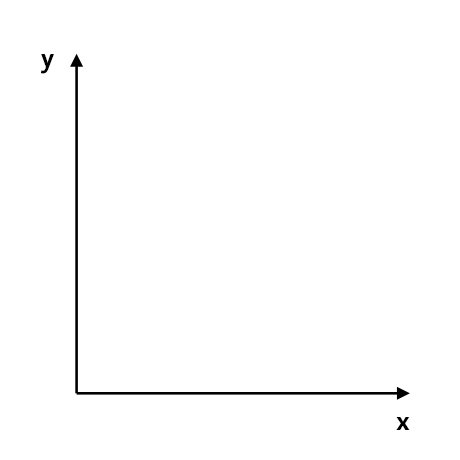
Exam/Questions/DCM/Axis.jpg
