NicolaiFransen/Semester-Project-PED1/Exam/Questions/DCM/Stage1.png

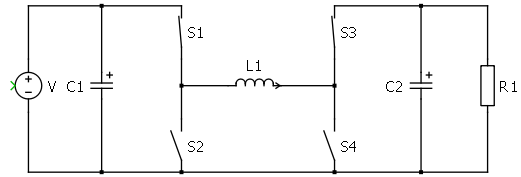
Exam/Questions/DCM/Stage1.png
