NicolaiFransen/Semester-Project-PED1/Others/EXAMS PED/CONTROL/Juan&Martin soluciones apuntes/IMG_7958.JPG

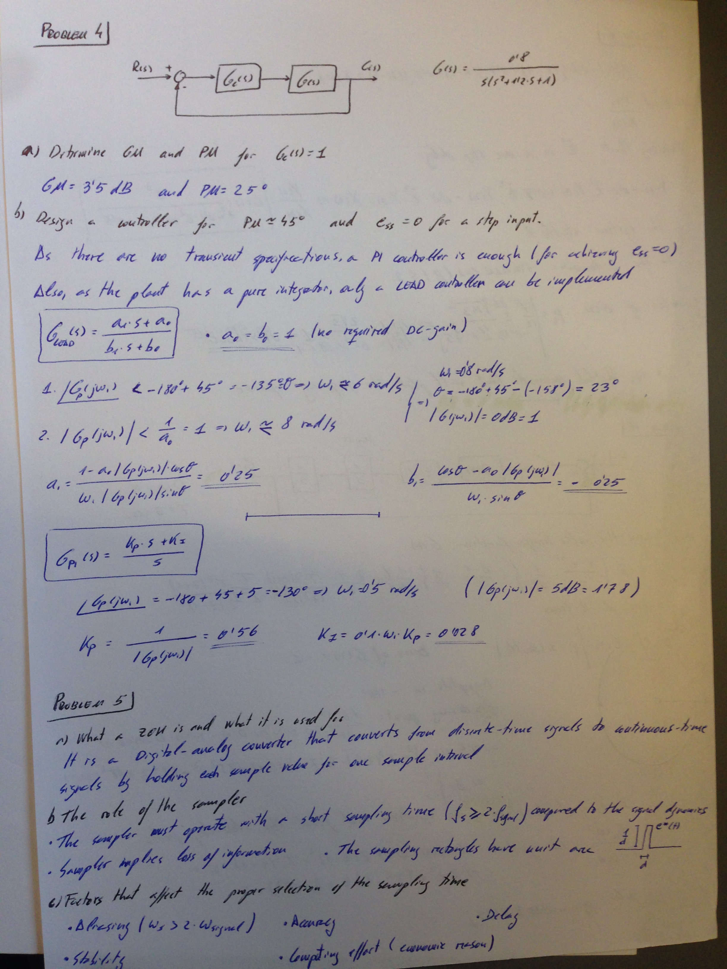
Others/EXAMS PED/CONTROL/Juan&Martin soluciones apuntes/IMG_7958.JPG
