NicolaiFransen/Semester-Project-PED1/Others/EXAMS PED/CONTROL/Juan&Martin soluciones apuntes/Nueva carpeta/IMG_7862.JPG

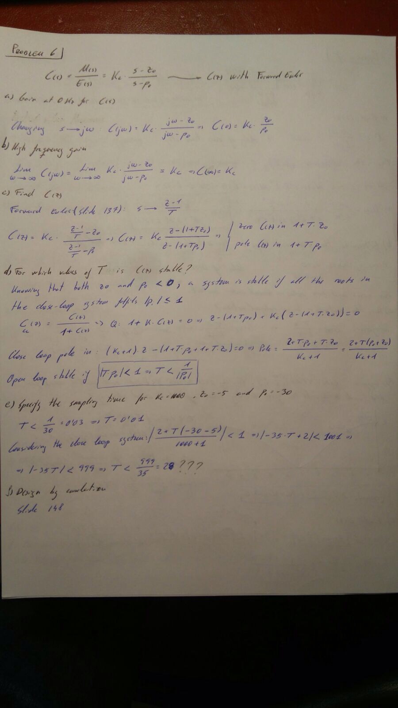
Others/EXAMS PED/CONTROL/Juan&Martin soluciones apuntes/Nueva carpeta/IMG_7862.JPG
