NicolaiFransen/Semester-Project-PED1/Others/EXAMS PED/HV/Exam 2015/20151130_131406.jpg

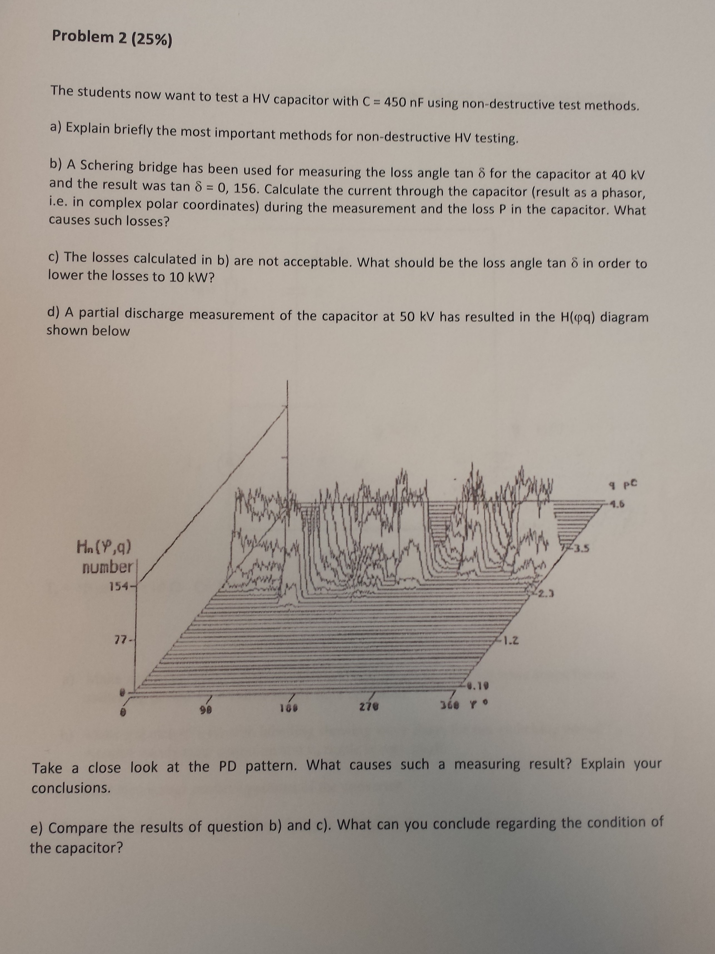
Others/EXAMS PED/HV/Exam 2015/20151130_131406.jpg
