NicolaiFransen/Semester-Project-PED1/Others/EXAMS PED/HV/Exam 2016/Eds sol to no 6/16295466_10211816353749339_934448328_n.jpg

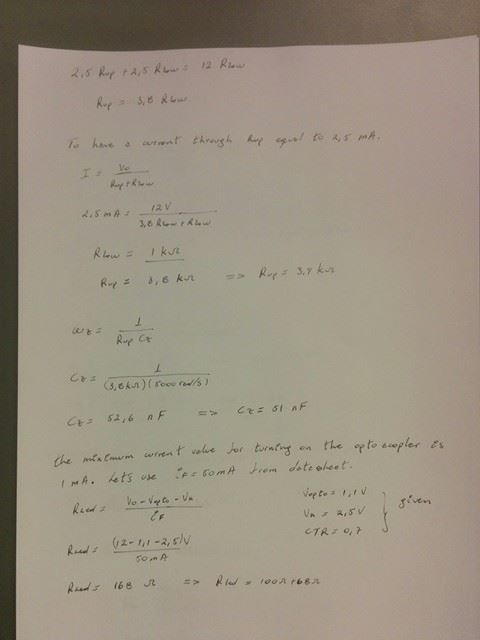
Others/EXAMS PED/HV/Exam 2016/Eds sol to no 6/16295466_10211816353749339_934448328_n.jpg
