NicolaiFransen/Semester-Project-PED1/Others/EXAMS PED/HV/Exam 2016/Eds sol to no 6/16344164_10211816353709338_1617860643_n.jpg

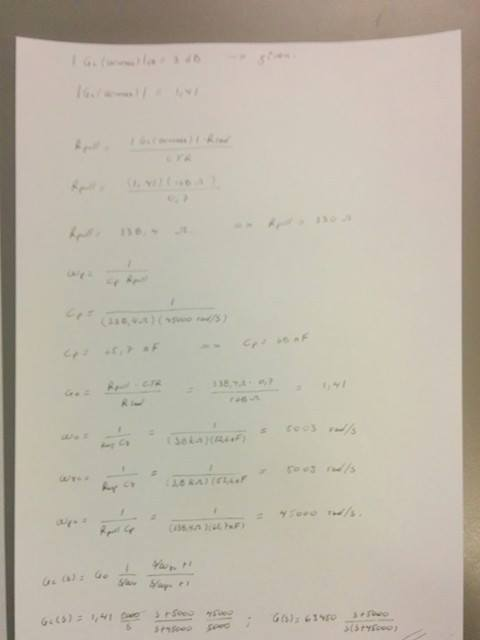
Others/EXAMS PED/HV/Exam 2016/Eds sol to no 6/16344164_10211816353709338_1617860643_n.jpg
