NicolaiFransen/Semester-Project-PED1/Others/EXAMS PED/HV/Exam 2016/Eds sol to no 6/16358405_10211816353829341_1488338208_n.jpg

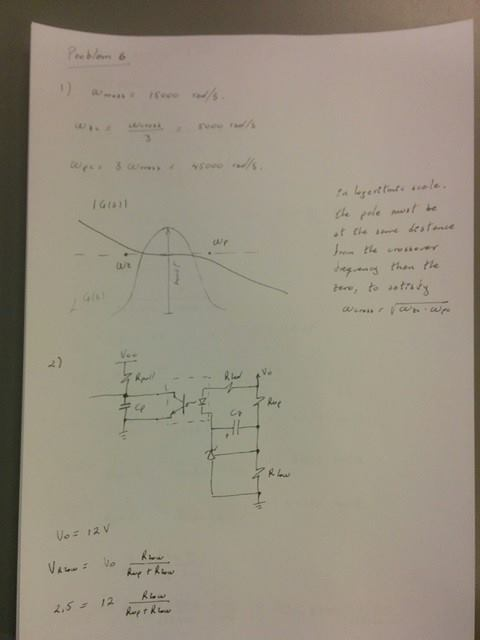
Others/EXAMS PED/HV/Exam 2016/Eds sol to no 6/16358405_10211816353829341_1488338208_n.jpg
