NicolaiFransen/Semester-Project-PED1/Others/EXAMS PED/HV/Exam 2016/SMC5Ast.jpg

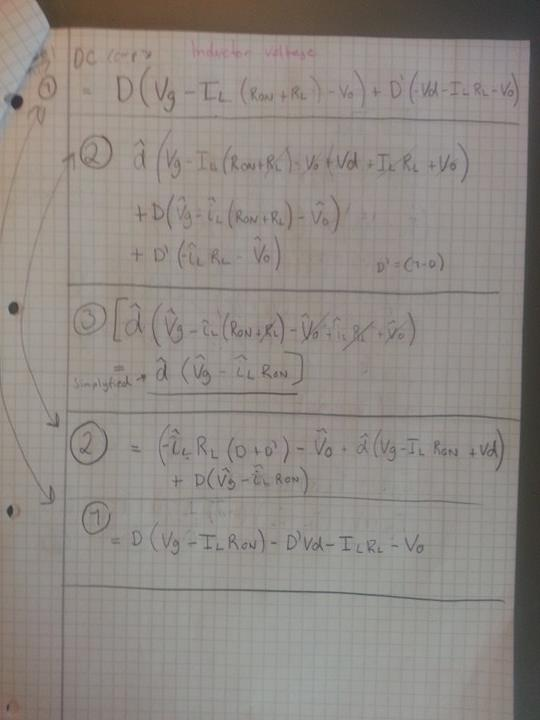
Others/EXAMS PED/HV/Exam 2016/SMC5Ast.jpg
