NicolaiFransen/Semester-Project-PED1/Others/HighVoltage/LabExercise1_2/08.jpeg

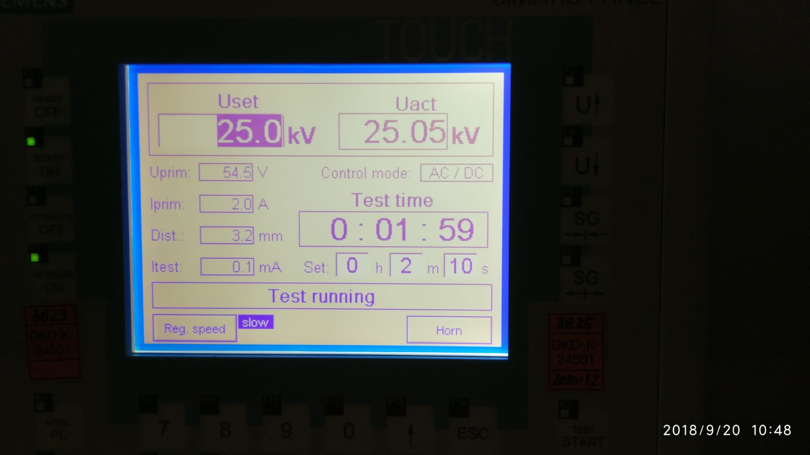
Others/HighVoltage/LabExercise1_2/08.jpeg
