NicolaiFransen/Semester-Project-PED1/Others/HighVoltage/LabExercise1_2/14.jpeg

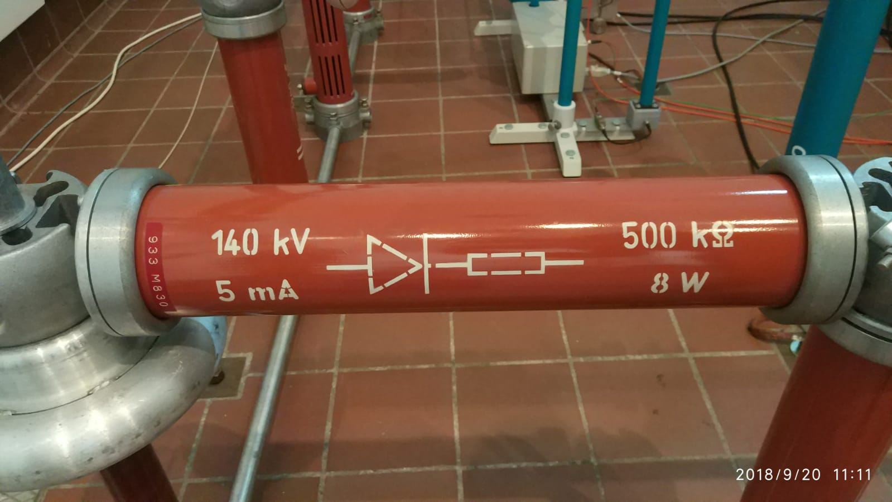
Others/HighVoltage/LabExercise1_2/14.jpeg
