NicolaiFransen/Semester-Project-PED1/Others/HighVoltage/LabExercise1_2/26.jpg

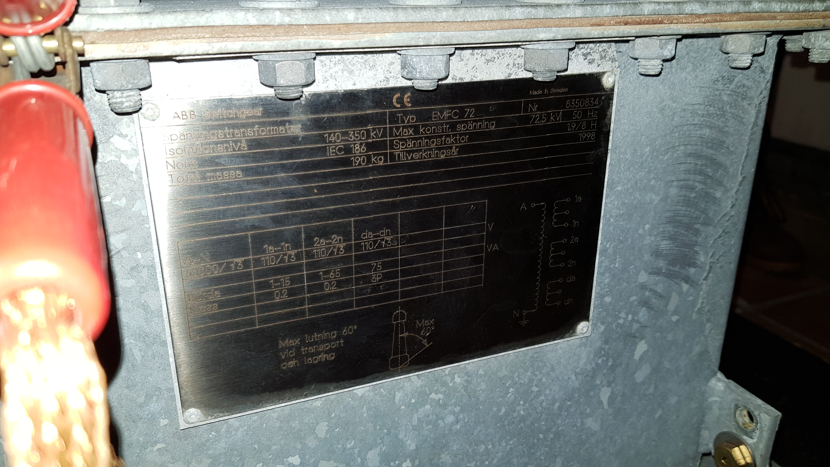
Others/HighVoltage/LabExercise1_2/26.jpg
