NicolaiFransen/Semester-Project-PED1/Others/HighVoltage/Labexercise3/Pictures/IMG_20181005_133222.jpg

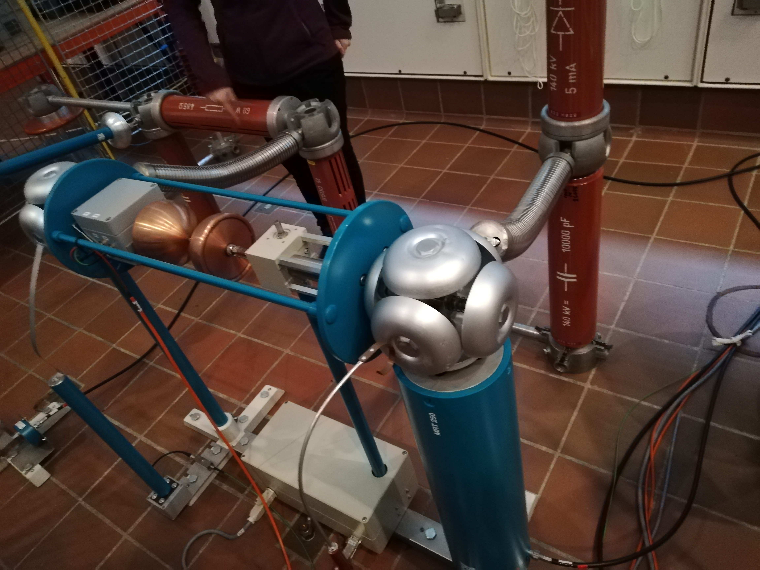
Others/HighVoltage/Labexercise3/Pictures/IMG_20181005_133222.jpg
