NicolaiFransen/Semester-Project-PED1/Others/HighVoltage/Labexercise3/Pictures/IMG_20181005_133232.jpg

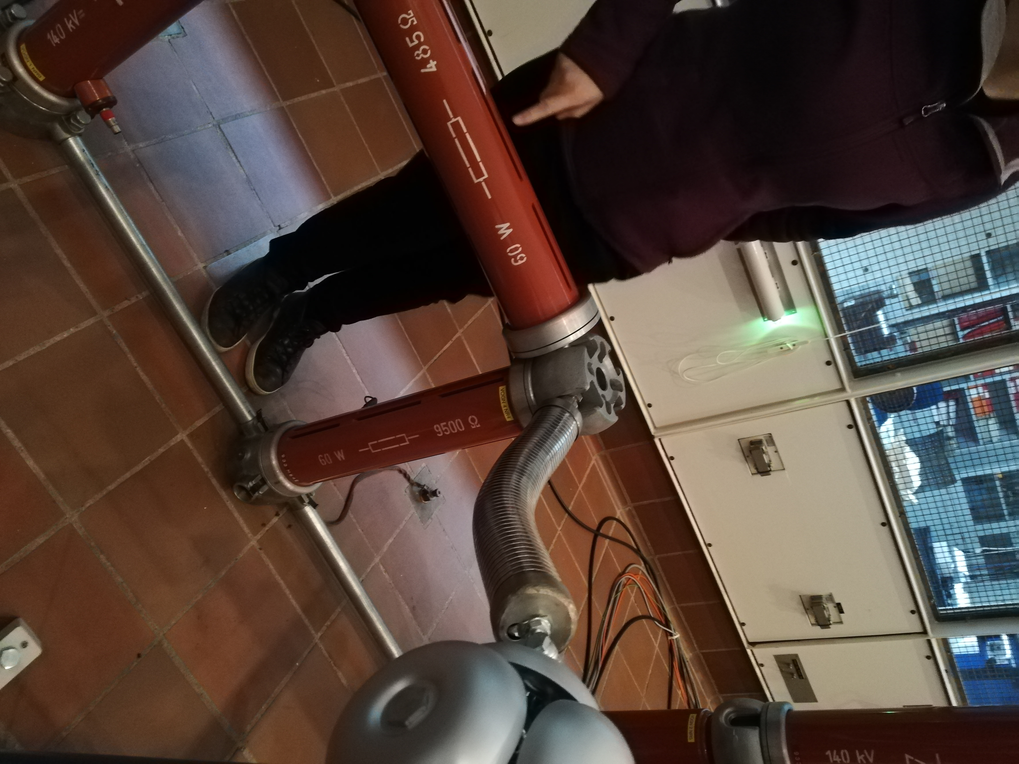
Others/HighVoltage/Labexercise3/Pictures/IMG_20181005_133232.jpg
