NicolaiFransen/Semester-Project-PED1/Others/HighVoltage/LabExercise4/2018-10-12 13.22.46.jpg

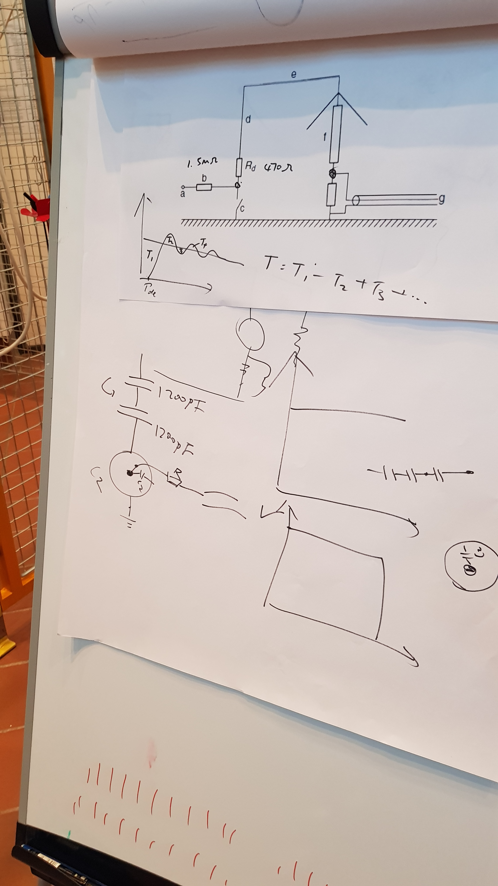
Others/HighVoltage/LabExercise4/2018-10-12 13.22.46.jpg
