NicolaiFransen/Semester-Project-PED1/Others/HighVoltage/LabExercise6/Paschen_graph.png

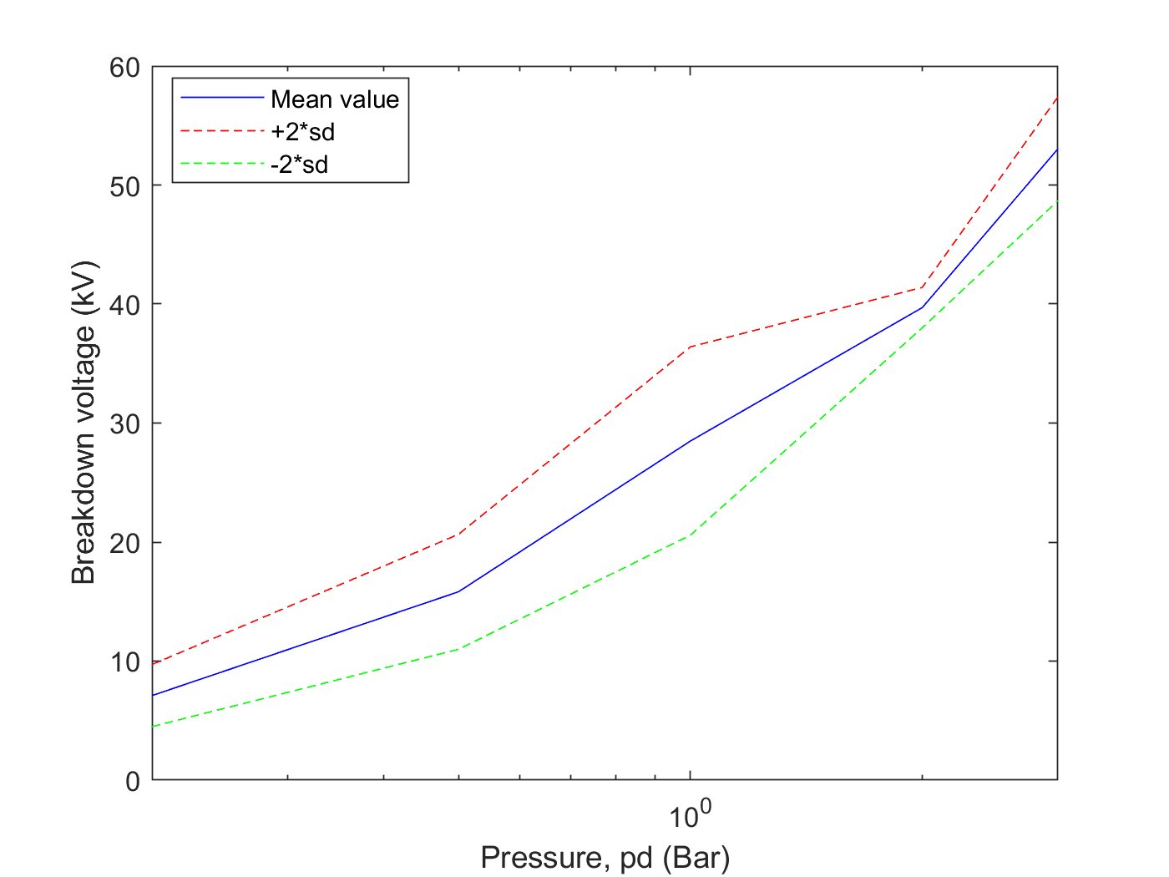
Others/HighVoltage/LabExercise6/Paschen_graph.png
