NicolaiFransen/Semester-Project-PED1/Others/HighVoltage/LabExercise7/Pictures/pic2.png

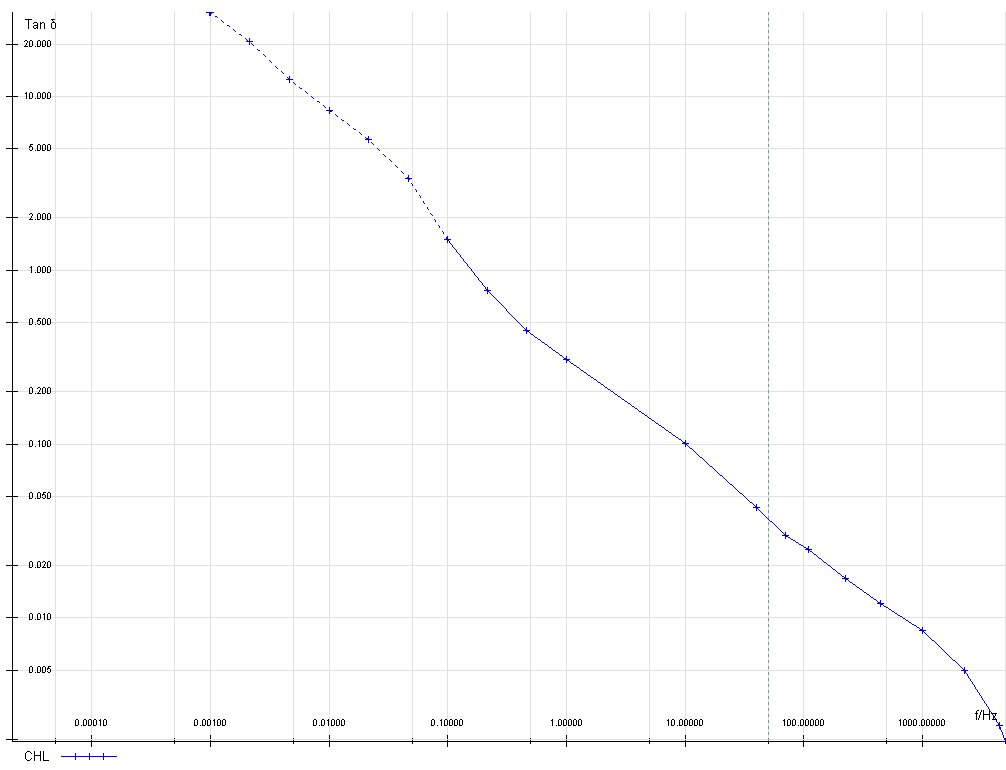
Others/HighVoltage/LabExercise7/Pictures/pic2.png
