NicolaiFransen/Semester-Project-PED1/Others/HighVoltage/LabExercise7/Pictures/pic3.PNG

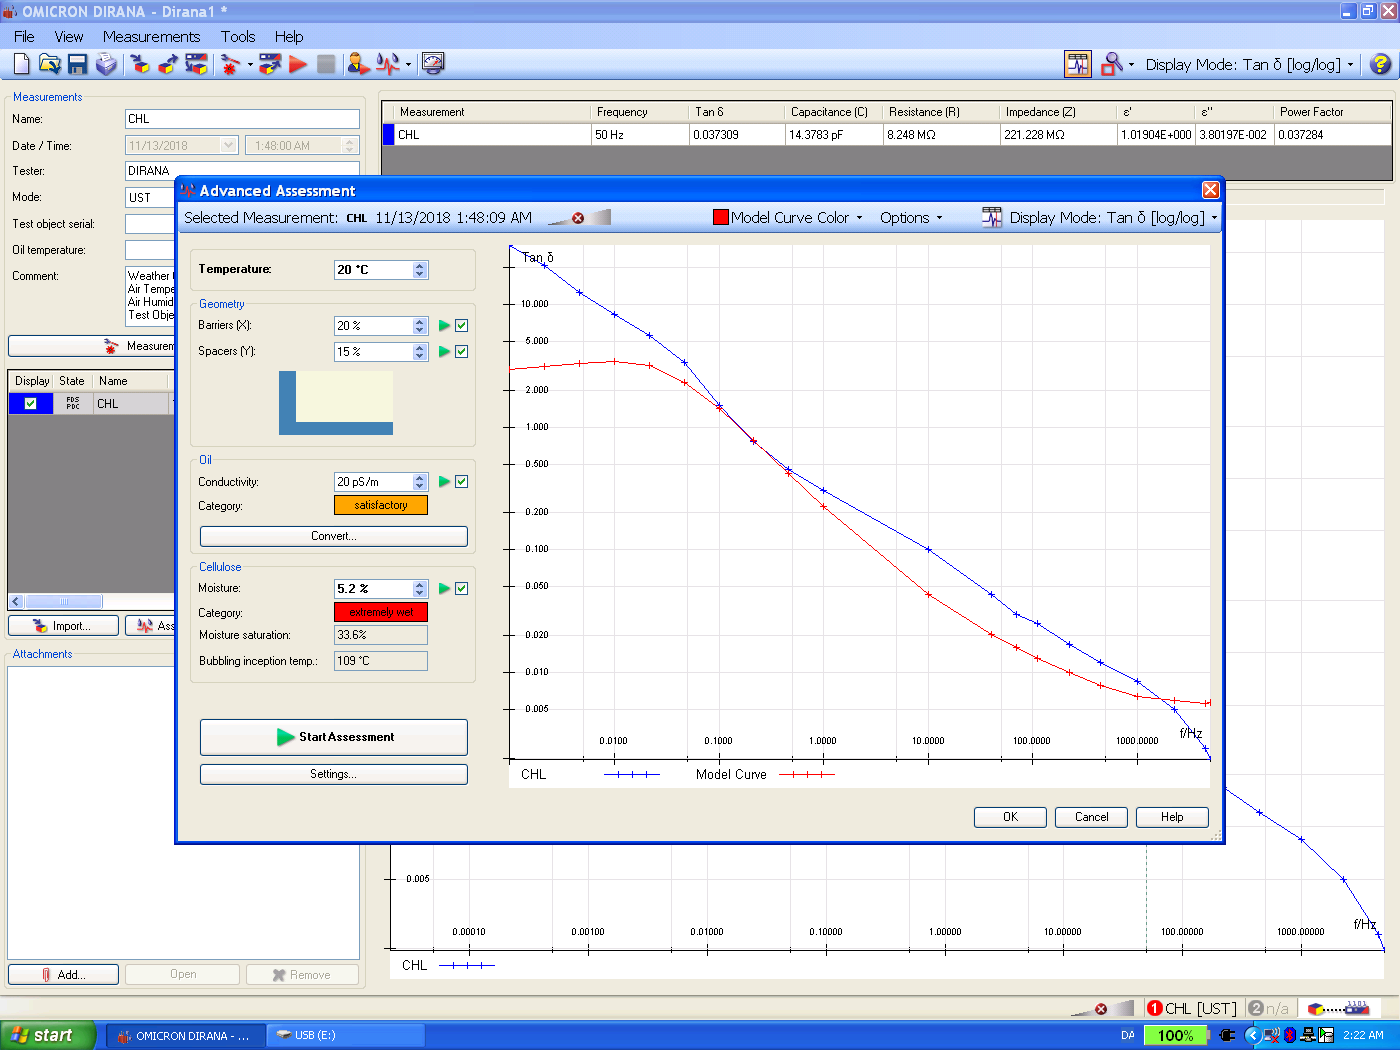
Others/HighVoltage/LabExercise7/Pictures/pic3.PNG
