NicolaiFransen/Semester-Project-PED1/Others/HighVoltage/LabInit/2018_09_11_WhatsApp Image 2018-09-11 at 11.09.16.jpeg

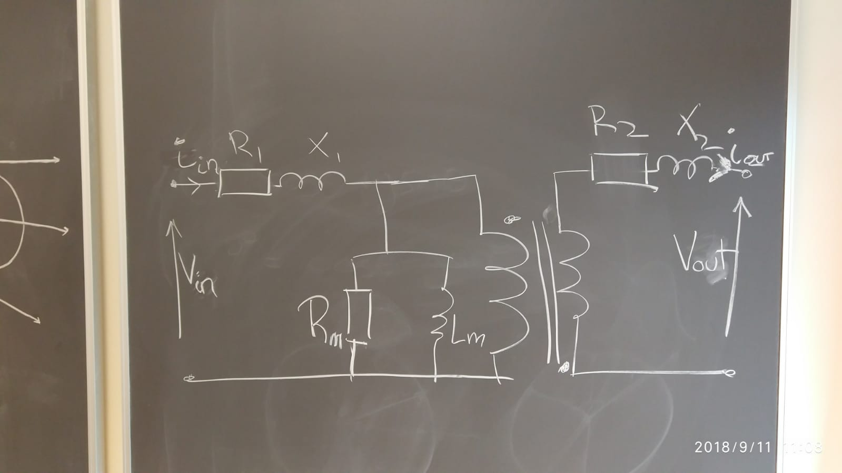
Others/HighVoltage/LabInit/2018_09_11_WhatsApp Image 2018-09-11 at 11.09.16.jpeg
