NicolaiFransen/Semester-Project-PED1/Others/ProgramLicenses/WhatsApp Image 2018-09-13 at 09.05.19.jpeg

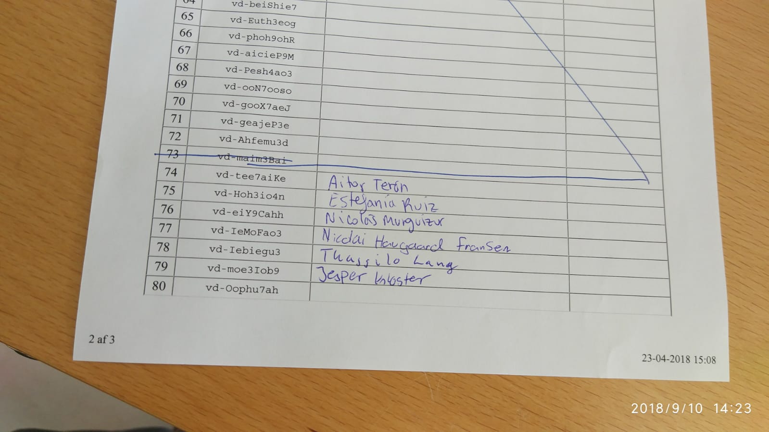
Others/ProgramLicenses/WhatsApp Image 2018-09-13 at 09.05.19.jpeg
