NicolaiFransen/Semester-Project-PED1/Reports/Group_image.jpg

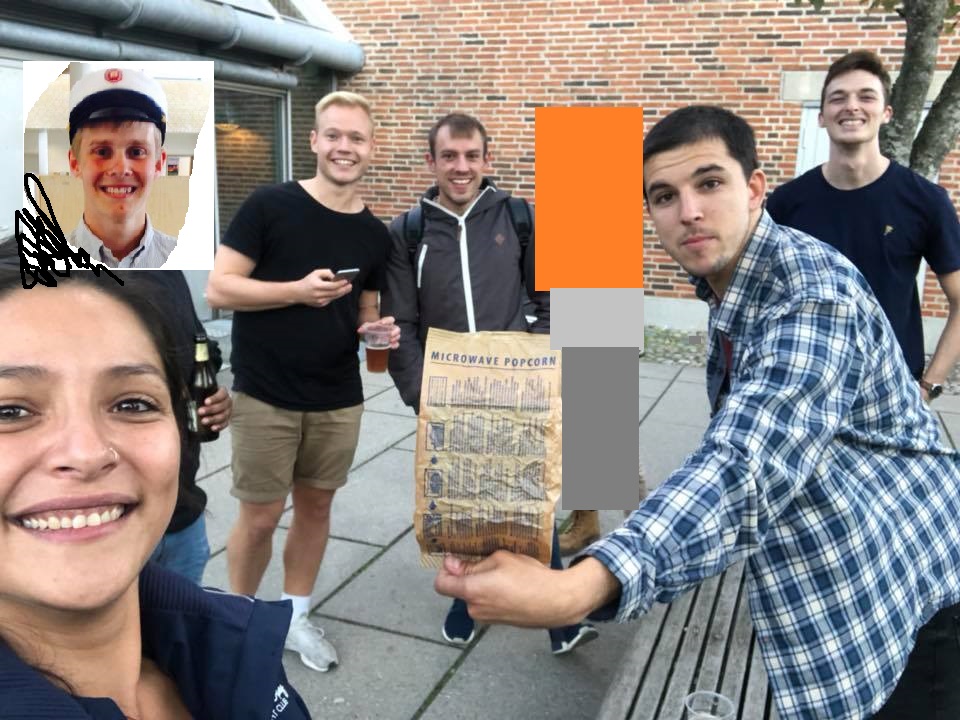
Reports/Group_image.jpg
