NicolaiFransen/Semester-Project-PED1/Reports/Pictures/2_d_H_B_BB.PNG

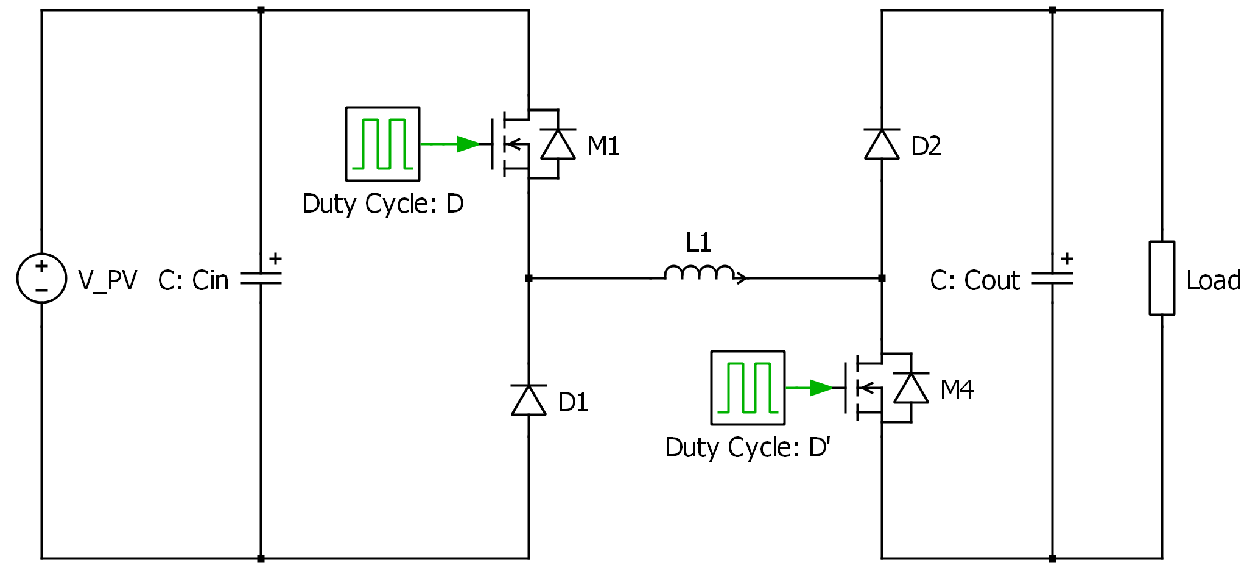
Reports/Pictures/2_d_H_B_BB.PNG
