NicolaiFransen/Semester-Project-PED1/Reports/Pictures/2018_10_04_Gantt/RightBottom.JPG

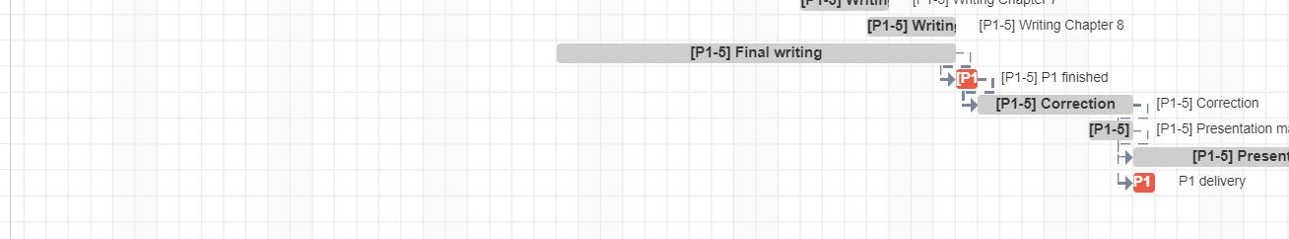
Reports/Pictures/2018_10_04_Gantt/RightBottom.JPG
