NicolaiFransen/Semester-Project-PED1/Reports/Pictures/2018_10_05_Gantt_V2/4.1.JPG

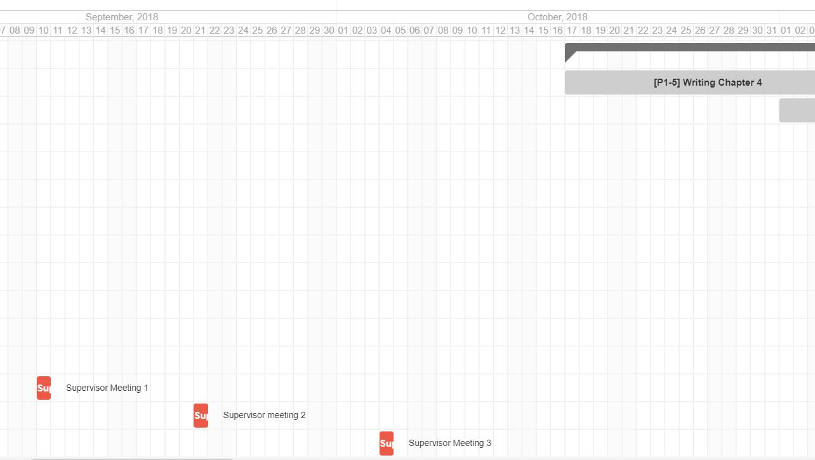
Reports/Pictures/2018_10_05_Gantt_V2/4.1.JPG
