NicolaiFransen/Semester-Project-PED1/Reports/Pictures/2018_10_05_Gantt_V2/GanttV2.png

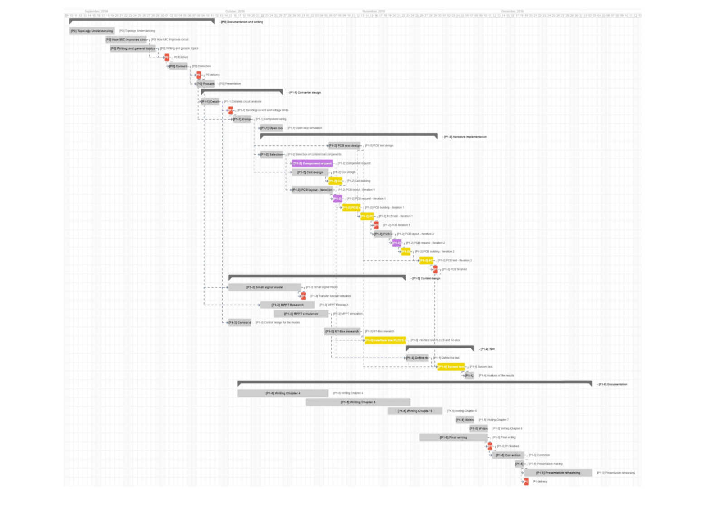
Reports/Pictures/2018_10_05_Gantt_V2/GanttV2.png
