NicolaiFransen/Semester-Project-PED1/Reports/Pictures/BID_H_B_BB.PNG

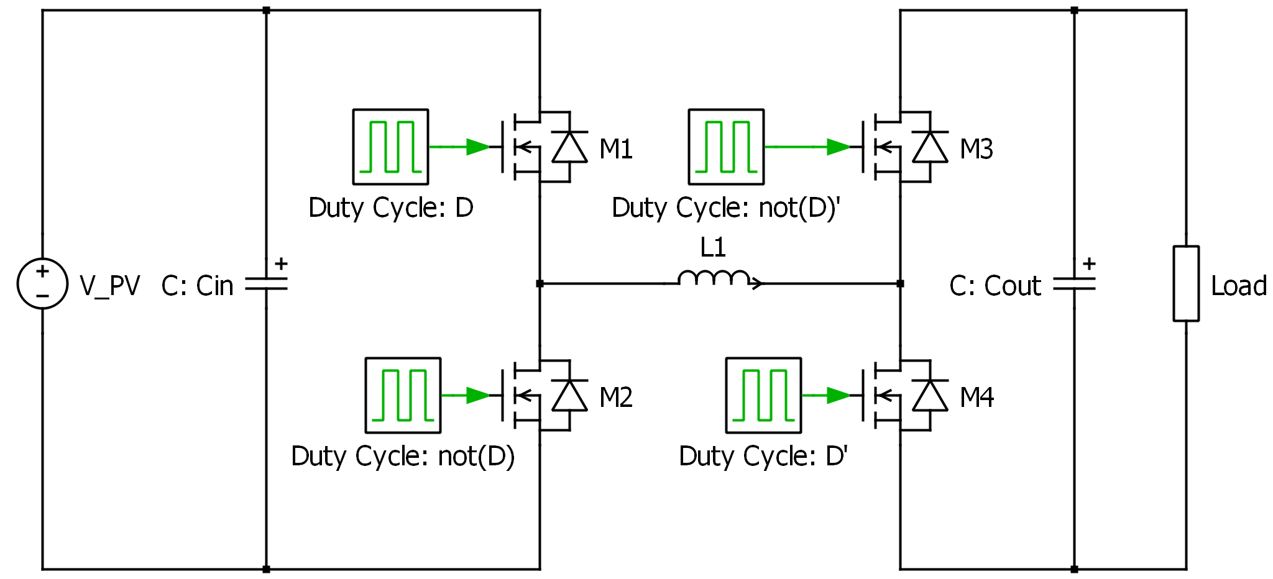
Reports/Pictures/BID_H_B_BB.PNG
