NicolaiFransen/Semester-Project-PED1/Reports/Pictures/BID_H_B_BB_without_duty.PNG

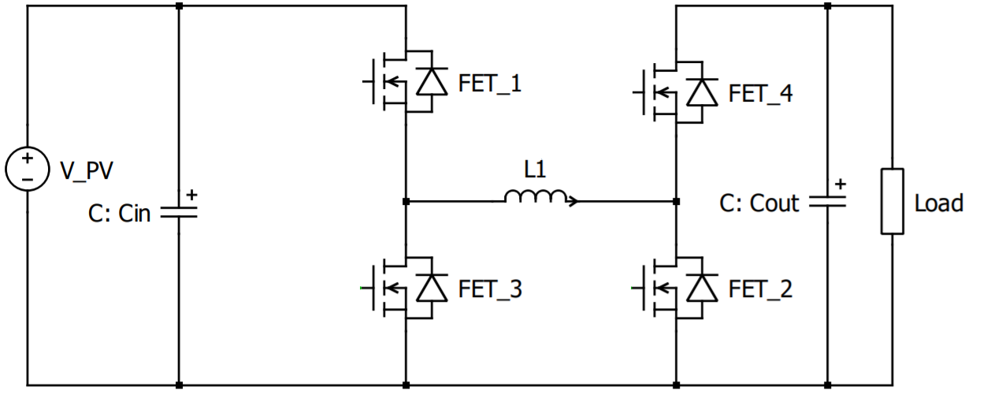
Reports/Pictures/BID_H_B_BB_without_duty.PNG
