NicolaiFransen/Semester-Project-PED1/Reports/Pictures/boostsim.PNG

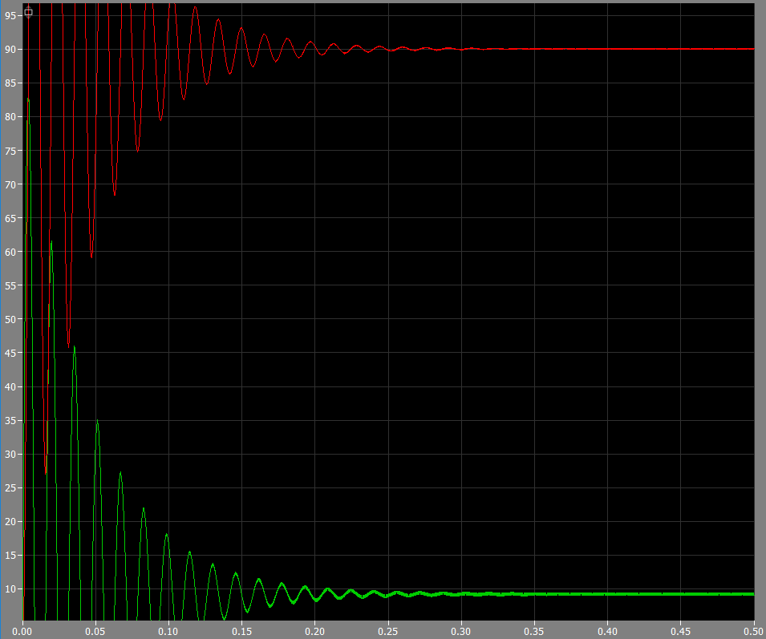
Reports/Pictures/boostsim.PNG
