NicolaiFransen/Semester-Project-PED1/Reports/Pictures/bucksimulation24.PNG

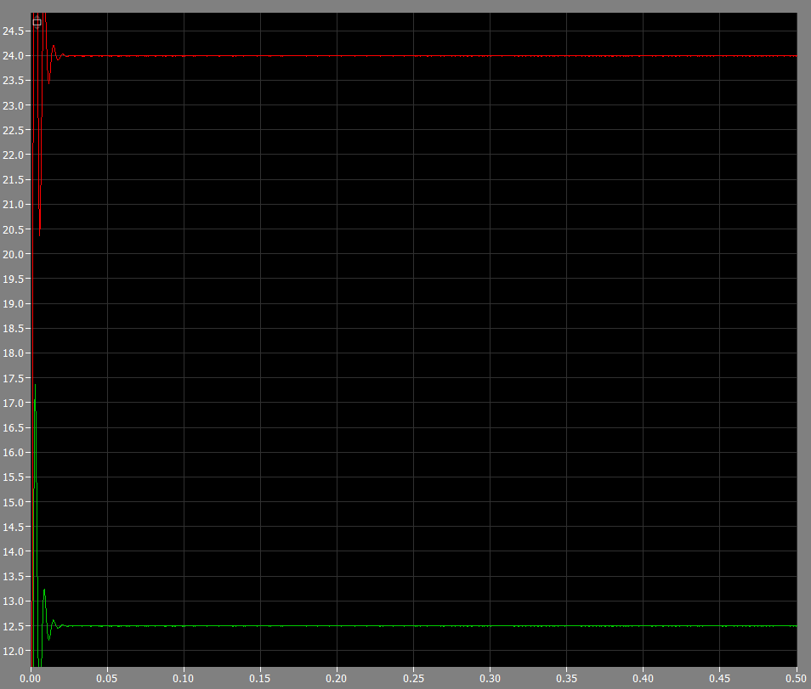
Reports/Pictures/bucksimulation24.PNG
