NicolaiFransen/Semester-Project-PED1/Reports/Pictures/bucksimulation24V.PNG

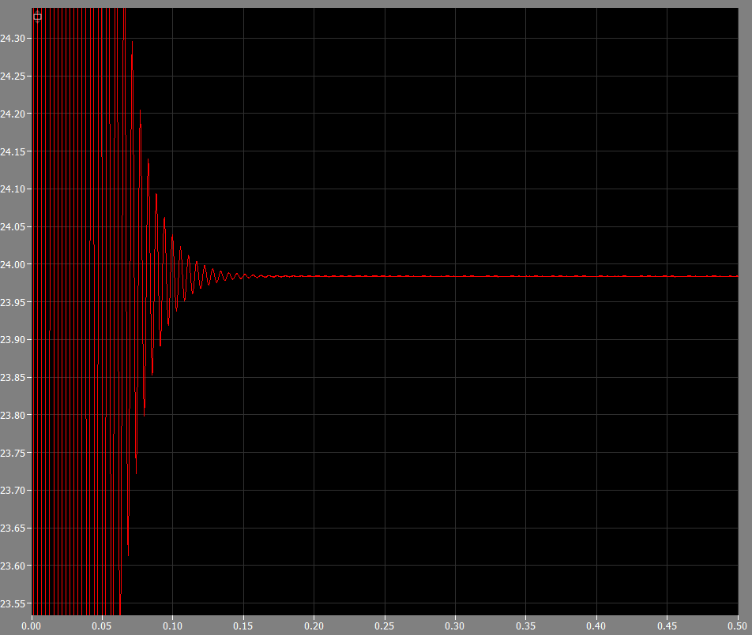
Reports/Pictures/bucksimulation24V.PNG
