NicolaiFransen/Semester-Project-PED1/Reports/Pictures/CCM_boost.PNG

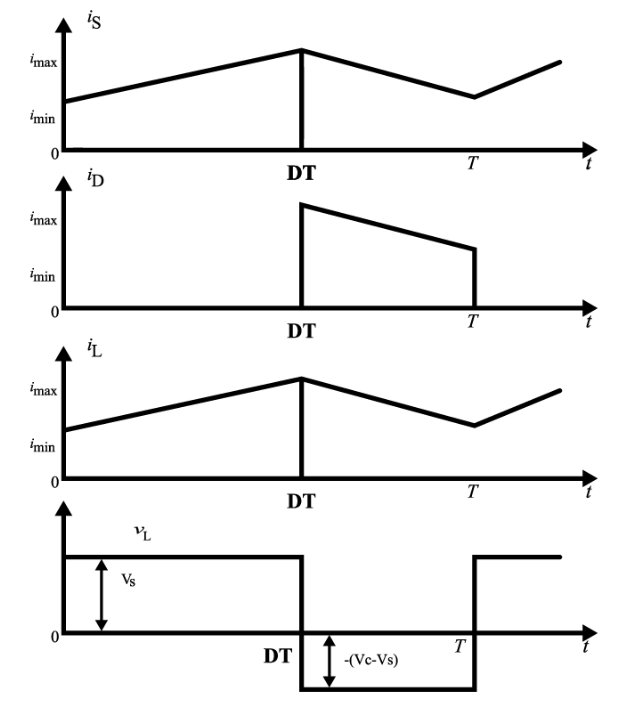
Reports/Pictures/CCM_boost.PNG
