NicolaiFransen/Semester-Project-PED1/Reports/Pictures/constant_irradiance.png

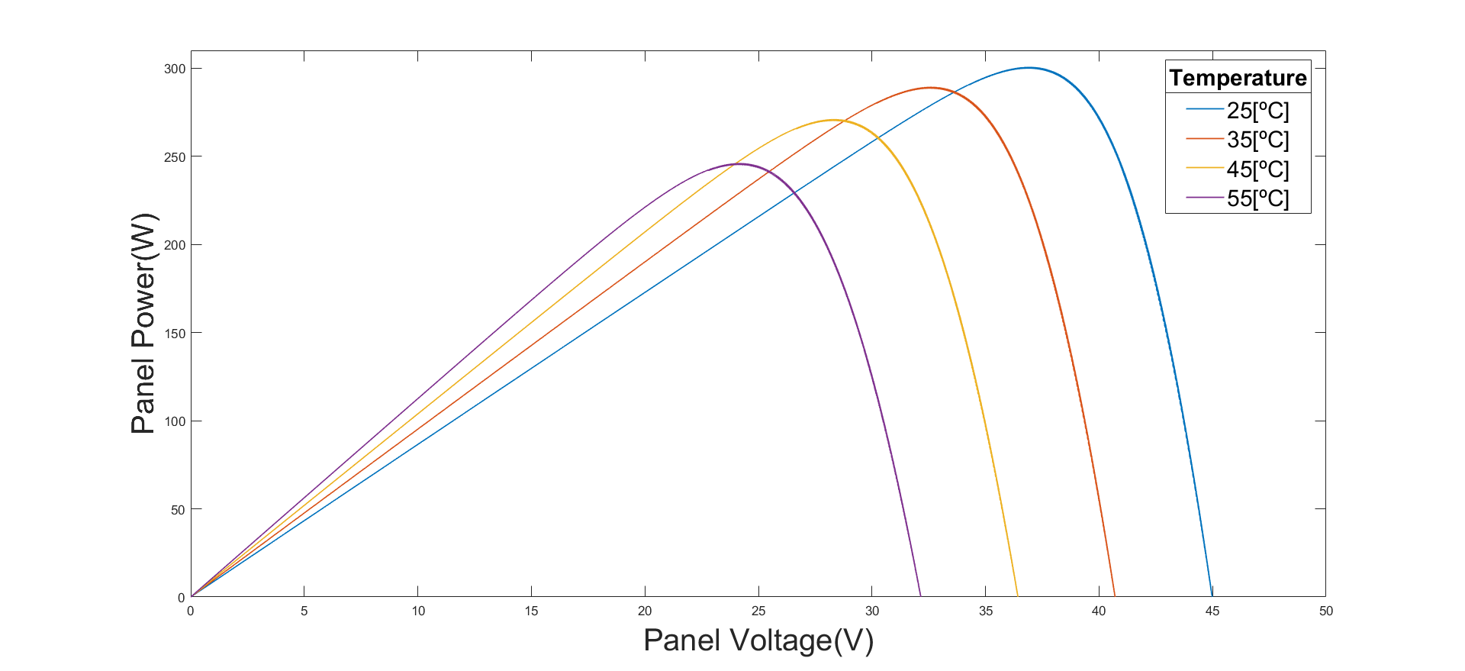
Reports/Pictures/constant_irradiance.png
