NicolaiFransen/Semester-Project-PED1/Reports/Pictures/frontpage_pvpanel.jpeg

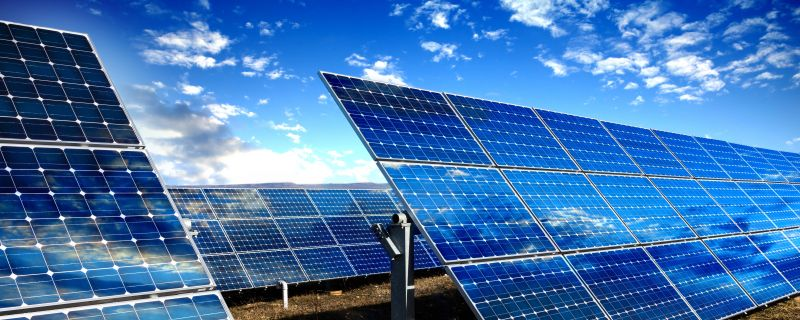
Reports/Pictures/frontpage_pvpanel.jpeg
