NicolaiFransen/Semester-Project-PED1/Reports/Pictures/Gantt_diagram.png

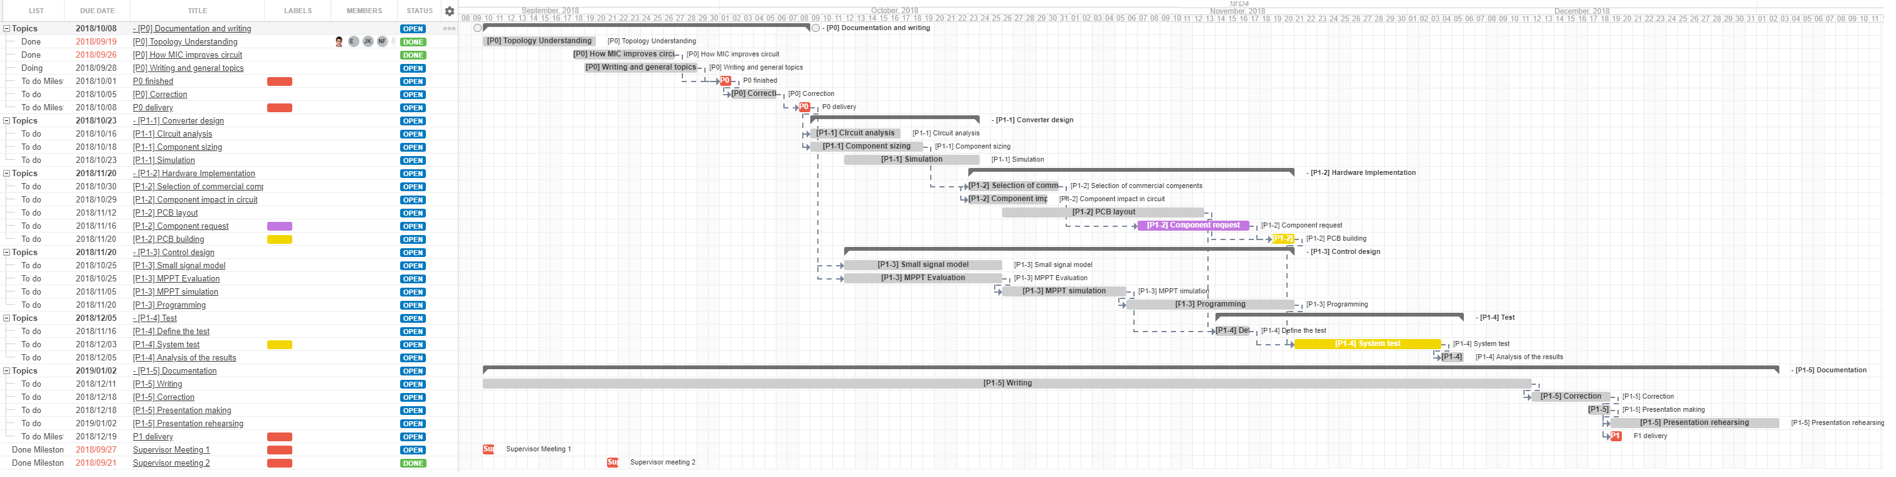
Reports/Pictures/Gantt_diagram.png
