NicolaiFransen/Semester-Project-PED1/Reports/Pictures/Gantt_diagram_without_left_panel.png

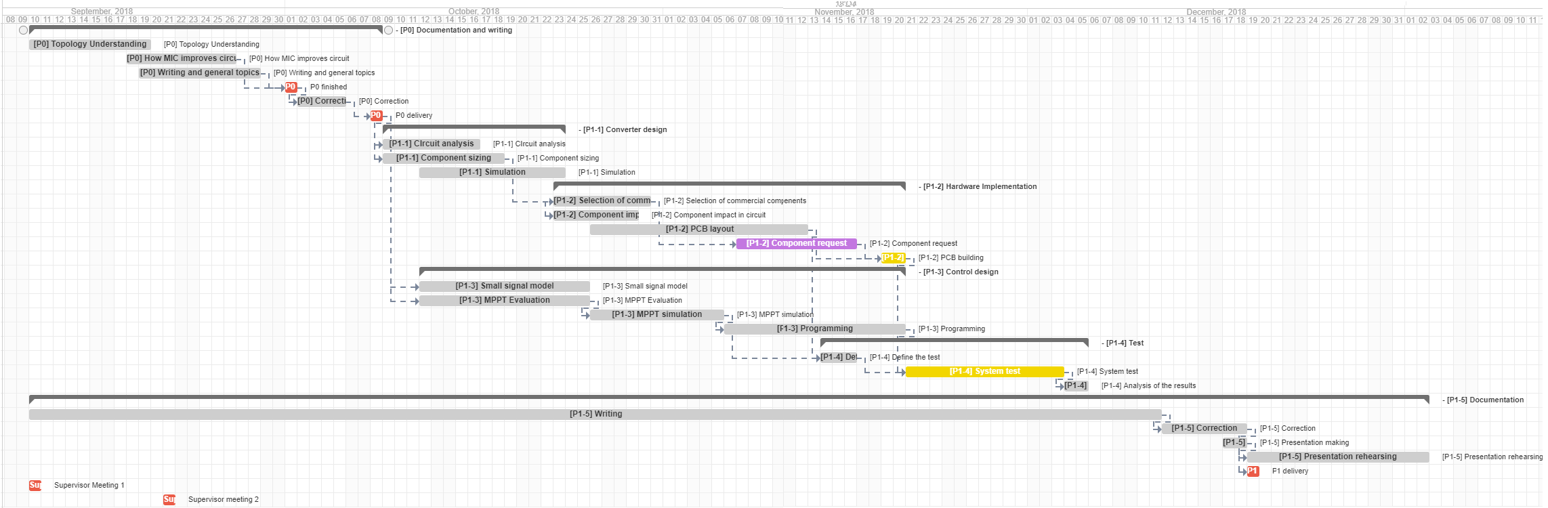
Reports/Pictures/Gantt_diagram_without_left_panel.png
