NicolaiFransen/Semester-Project-PED1/Reports/Pictures/idealopenloop.PNG

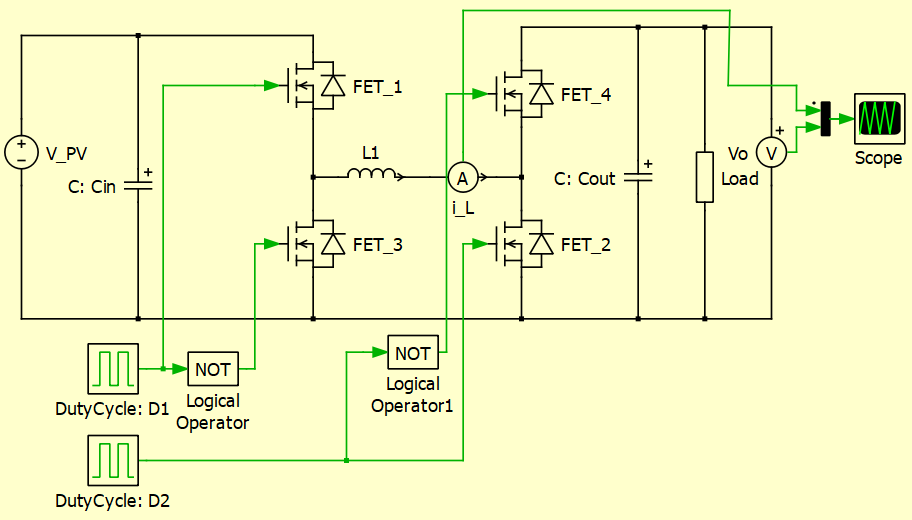
Reports/Pictures/idealopenloop.PNG
