NicolaiFransen/Semester-Project-PED1/Reports/Pictures/iv_constant_irradiance.png

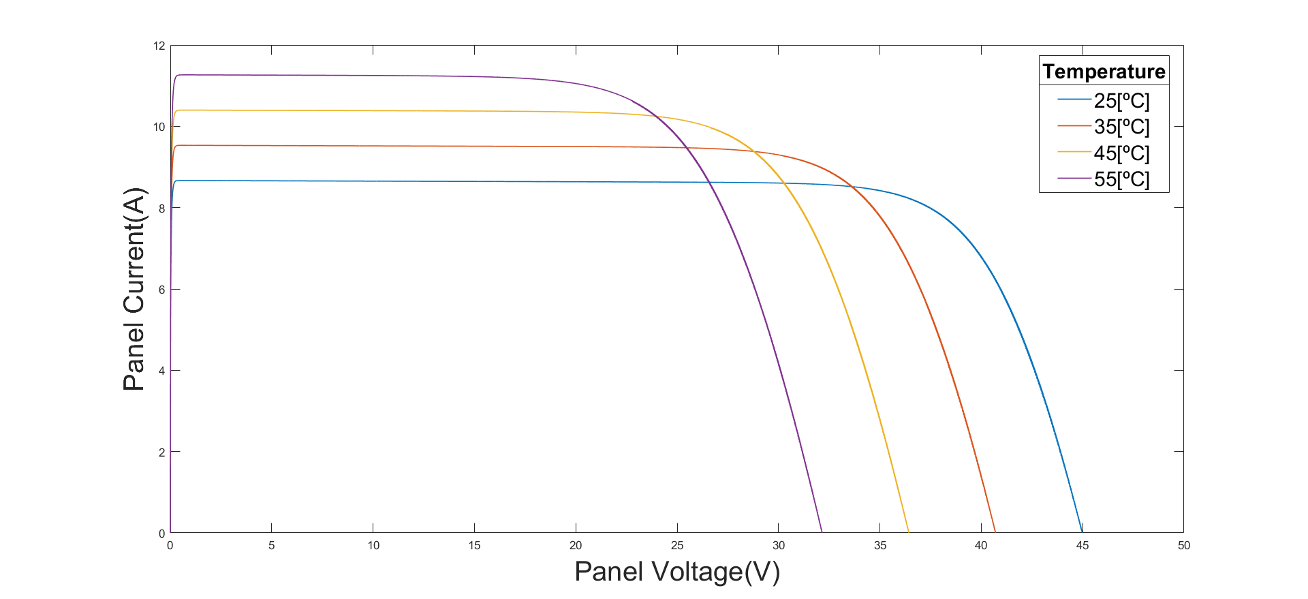
Reports/Pictures/iv_constant_irradiance.png
