NicolaiFransen/Semester-Project-PED1/Reports/Pictures/local_MPP.png

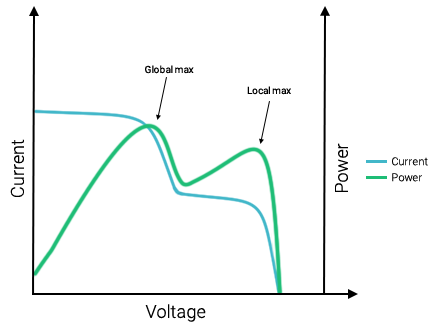
Reports/Pictures/local_MPP.png
