NicolaiFransen/Semester-Project-PED1/Reports/Pictures/mpp_graph.jpg

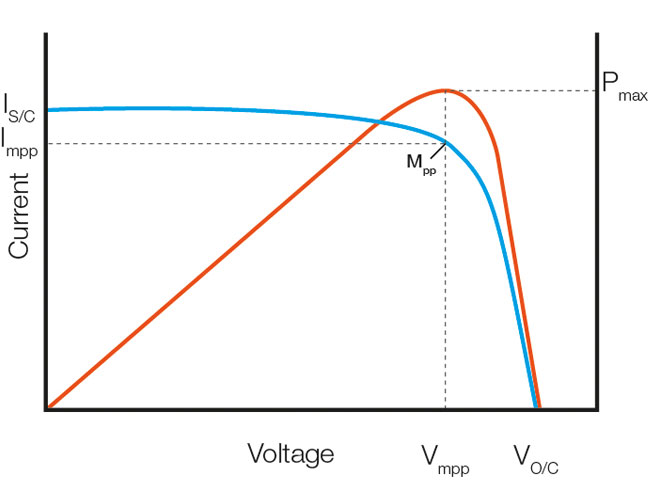
Reports/Pictures/mpp_graph.jpg
