NicolaiFransen/Semester-Project-PED1/Reports/Pictures/multiple_local_MPP.png

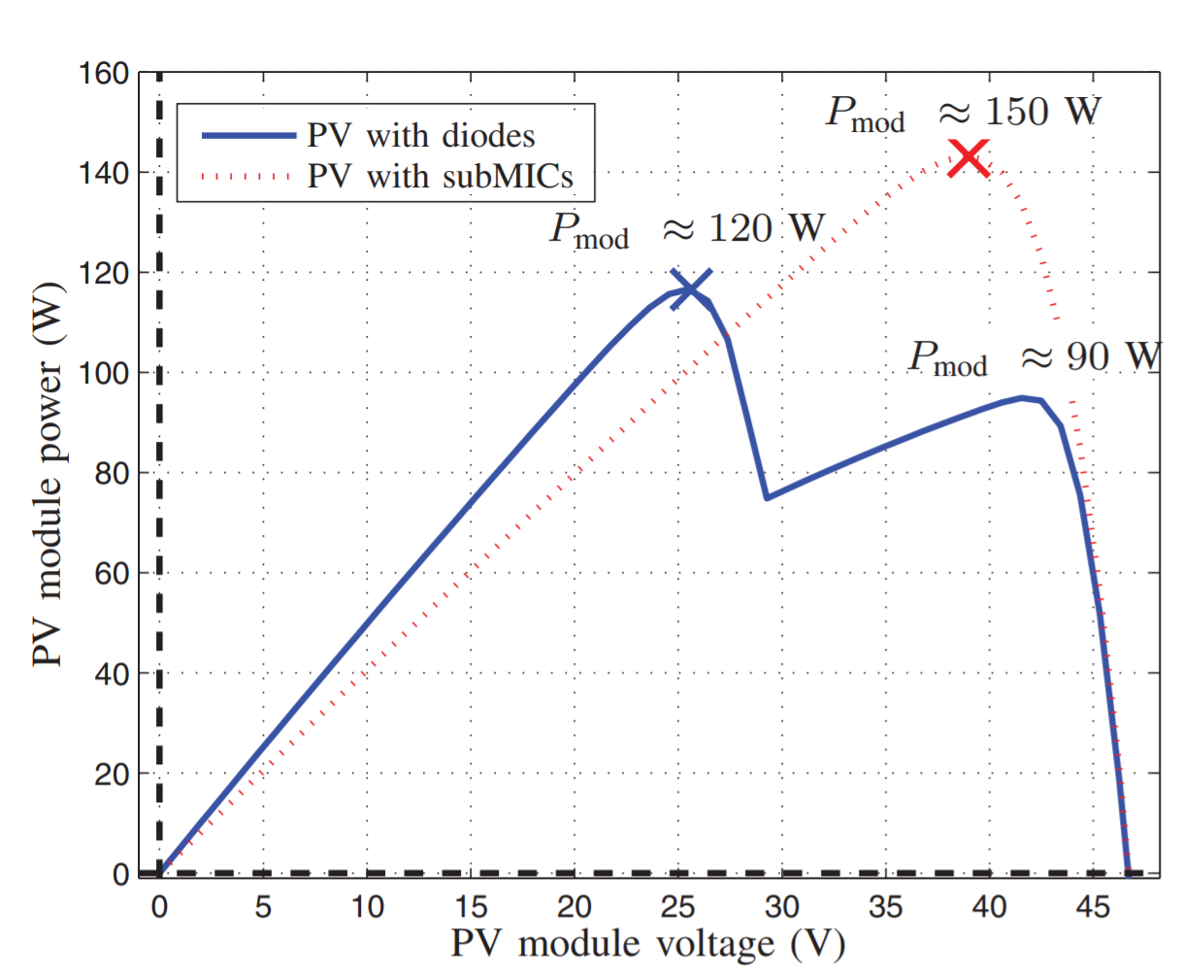
Reports/Pictures/multiple_local_MPP.png
