NicolaiFransen/Semester-Project-PED1/Reports/Pictures/openloop.png

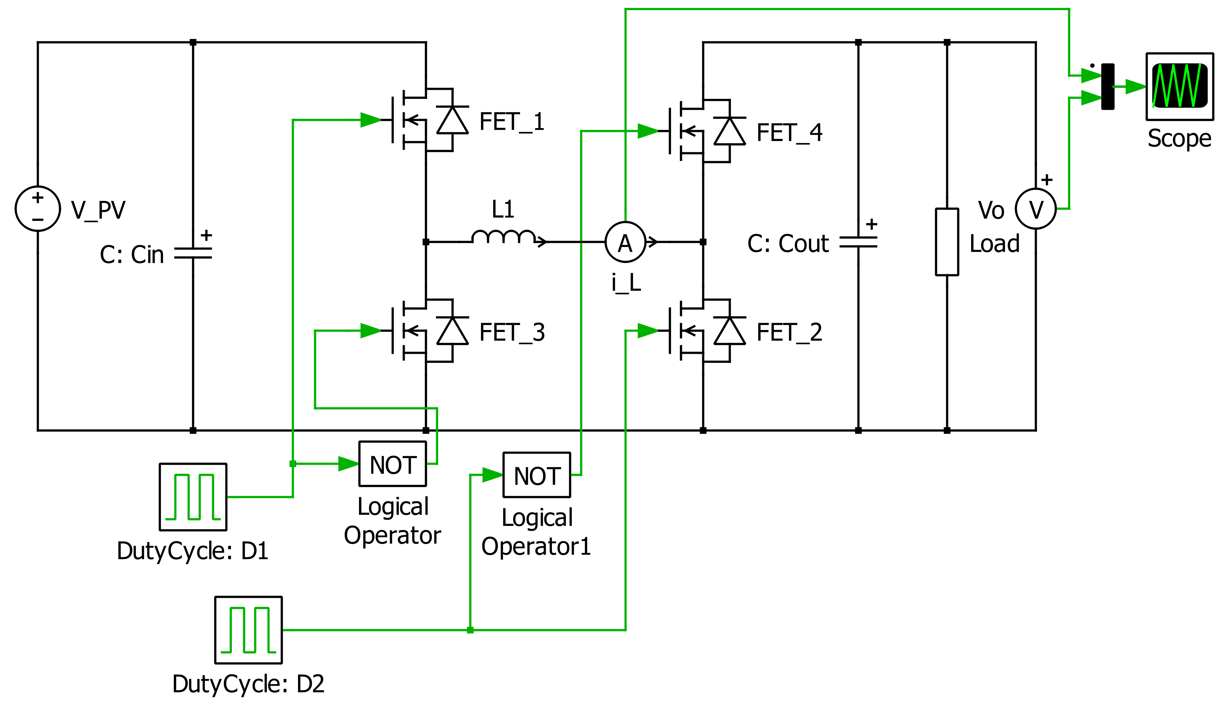
Reports/Pictures/openloop.png
