NicolaiFransen/Semester-Project-PED1/Reports/Pictures/P1/Open_loop_simulation/open_loop_buck.png

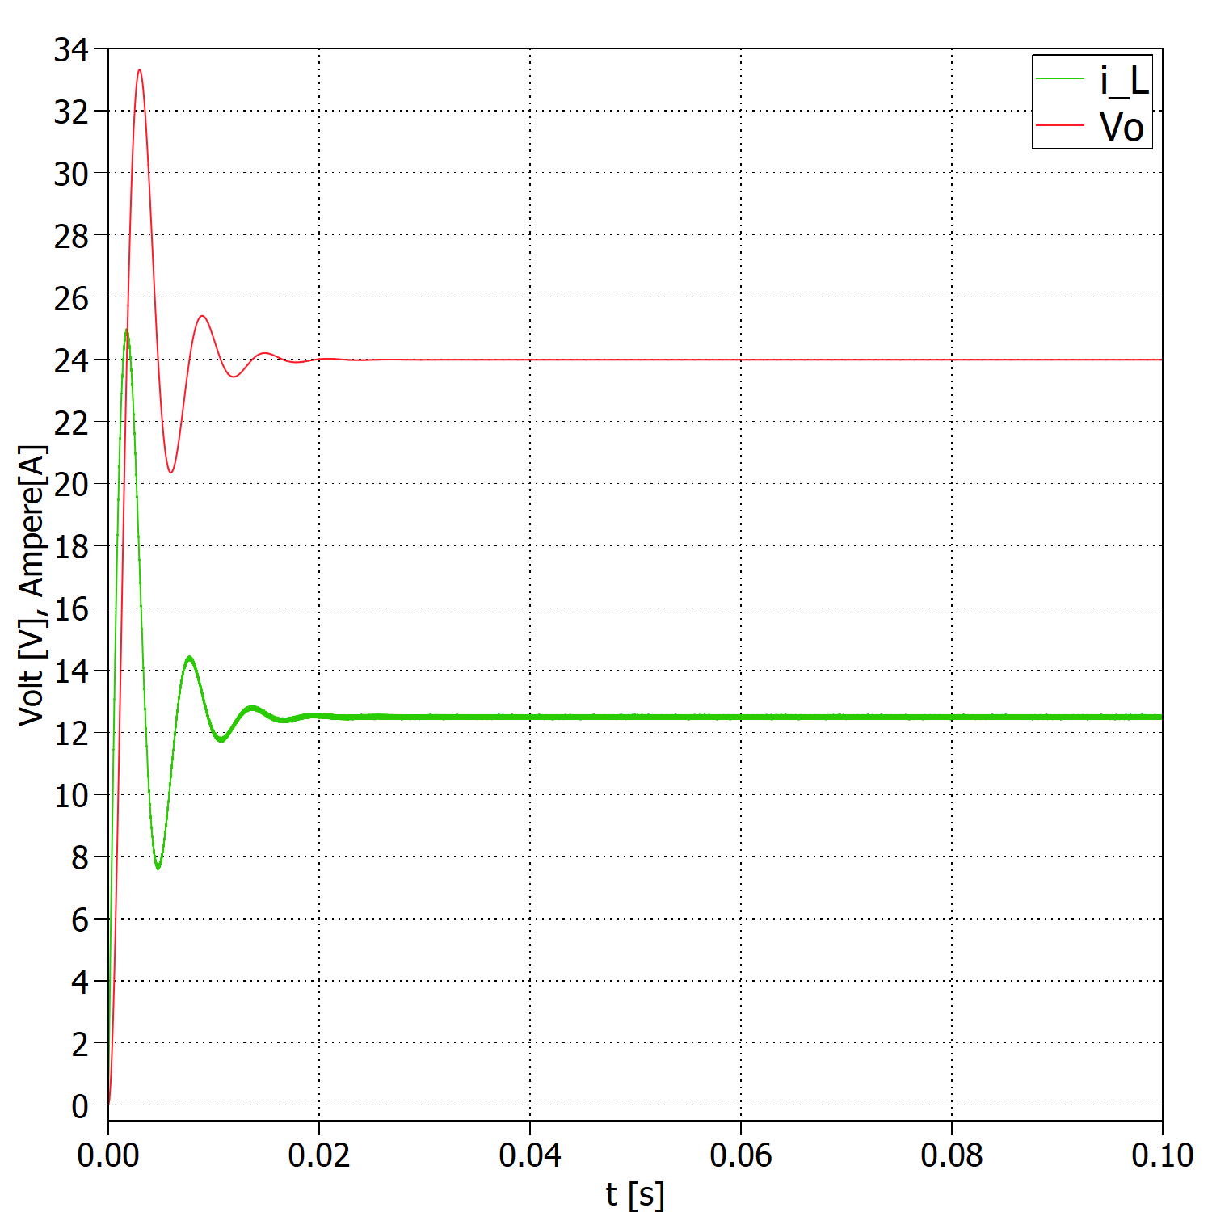
Reports/Pictures/P1/Open_loop_simulation/open_loop_buck.png
