NicolaiFransen/Semester-Project-PED1/Reports/Pictures/schematic_pv_cell.png

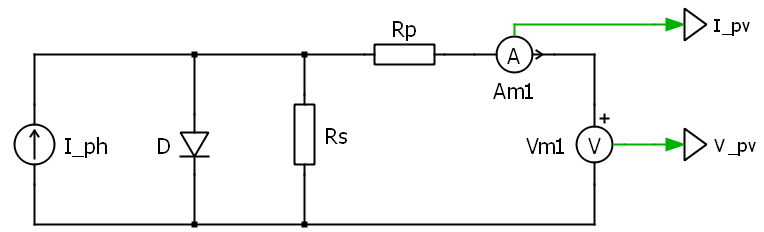
Reports/Pictures/schematic_pv_cell.png
