NicolaiFransen/Semester-Project-PED1/Simulations/MOSFET_spice_simulation/LTSpice_simulation/turn_on_losses.png

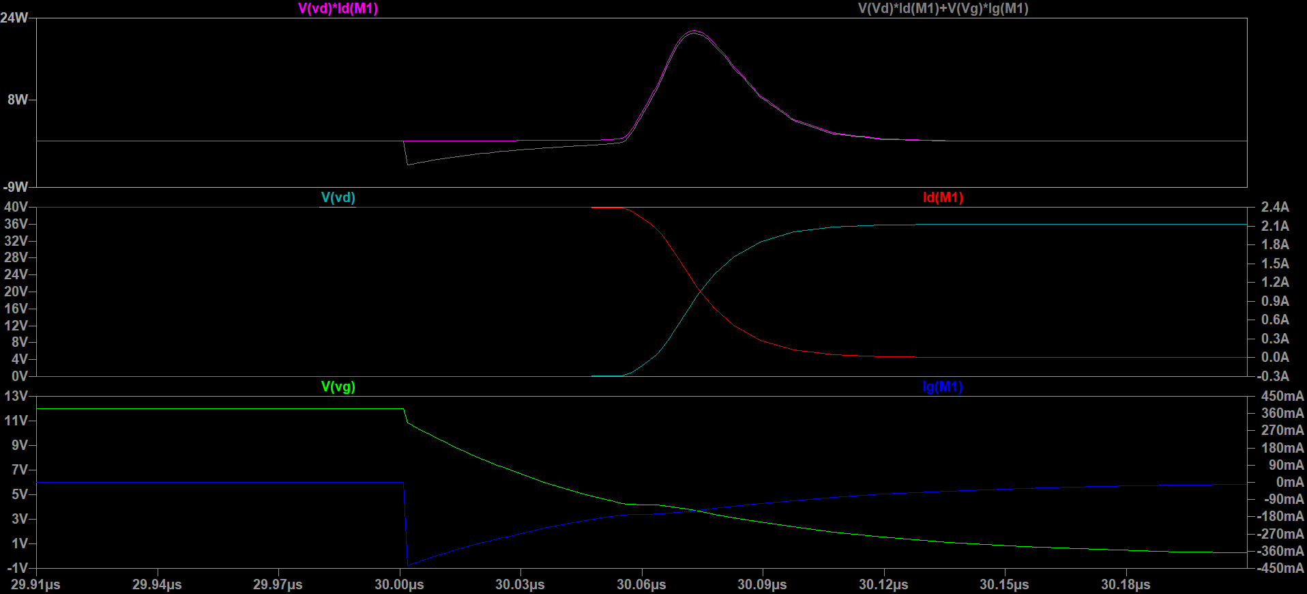
Simulations/MOSFET_spice_simulation/LTSpice_simulation/turn_on_losses.png
