NicolaiFransen/Semester-Project-PED1/Simulations/MOSFET_spice_simulation/LTSpice_simulation/Turn_on_time.png

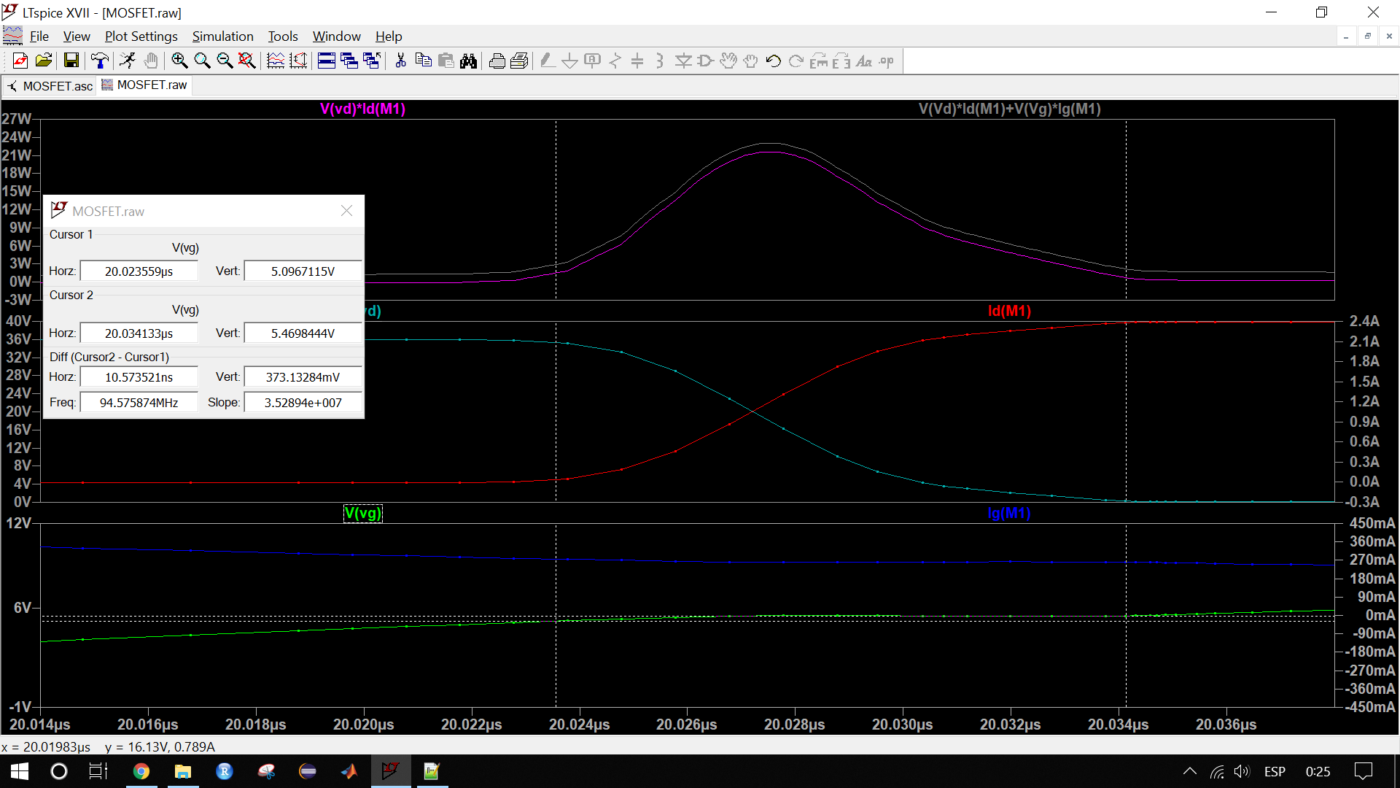
Simulations/MOSFET_spice_simulation/LTSpice_simulation/Turn_on_time.png
