NicolaiFransen/Semester-Project-PED1/Simulations/PLECS_circuits/Openloop.PNG

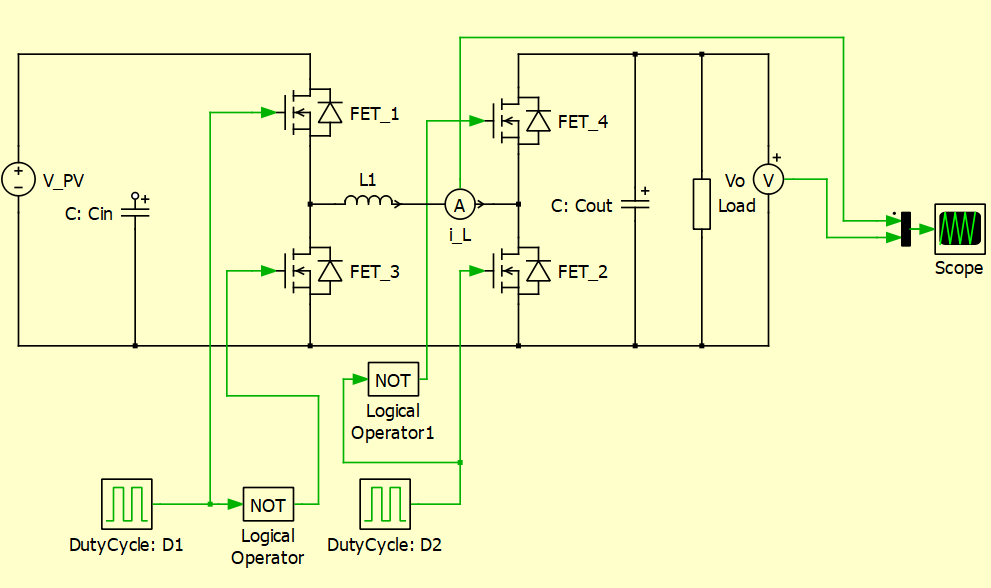
Simulations/PLECS_circuits/Openloop.PNG
