NicolaiFransen/Semester-Project-PED1/Simulations/PLECS_circuits/Openloopresult.PNG

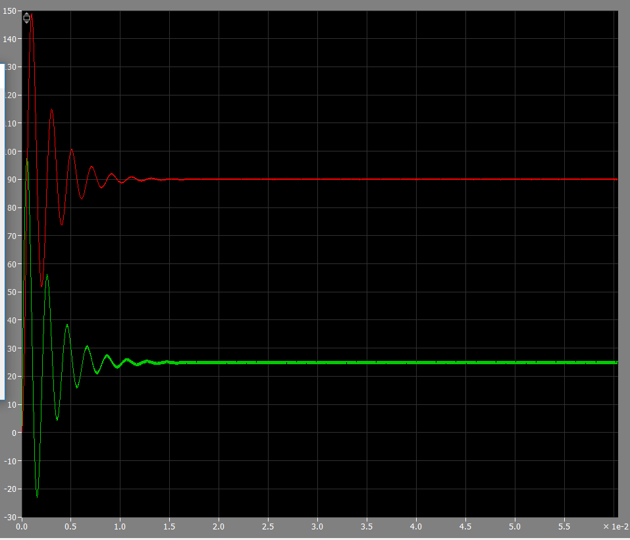
Simulations/PLECS_circuits/Openloopresult.PNG
