NicolaiFransen/Semester-Project-PED1/Simulations/PLECS_circuits/Openloopvalues.PNG

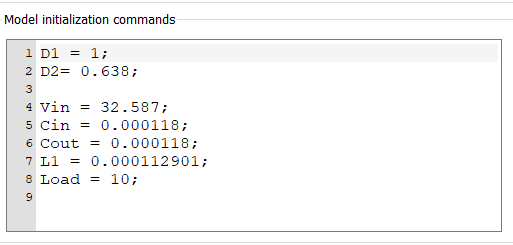
Simulations/PLECS_circuits/Openloopvalues.PNG
