NicolaiFransen/Semester-Project-PED1/Reports/P1/docs/P0/nomenclature.tex

\chapter*{Nomenclature}

\vspace{-10mm} %Vertical space in mm
\textit{Abbreviations:}\newline
\begin{tabular}{ll} %ll for left left
AC & Alternating Current\\
ADC & Analog to Digital Converter \\
BW & Bandwidth \\
%CNC & Computer numerical control\\
CCM & Continuous Conduction Mode\\
CPU & Central Processing Unit \\
DC & Direct Current\\
DCM & Discontinuous Conduction Mode\\
%EMI & Electromagnetic Interference\\
%FET & Field-Effect Transistor\\
FSM & Finite State Machine \\
IC & Integrated Circuit\\
IGBT & Insulated Gate Bipolar Transistor \\
LPF & Low Pass Filter\\
LTspice & Linear Technology SPICE \\
MIC & Module Integrated Converter\\
MOSFET & Metal Oxide Semiconductor Field-Effect Transistor\\
MPP & Maximum Power Point\\
MPPT & Maximum Power Point Tracking\\
PBL & Problem Based Learning\\
PCB & Printed Circuit Board\\
PLECS & Piecewise Linear Electrical Circuit Simulation\\
PV & Photovoltaic\\
PWM & Pulse Width Modulation\\
P\&O & Perturb and Observe\\
%SEPIC & Single Ended Primary Inductance Converter\\
RT Box & Response Time Box \\
SMD & Surface Mount Device \\
SPI & Serial Peripheral Interface\\
SPICE & Simulation Program with Integrated Circuits Emphasis \\
STC & Standard Test Conditions\\
\end{tabular}

\vspace{5mm} %Vertical space in mm
\newpage
\noindent\textit{Symbols:}\newline
\begin{tabular}{ll}
$\Delta I_{L}$ & Inductor current ripple\\
$\Delta I_{L,max}$ & Maximum inductor current ripple\\
$\Delta V_{in}$ & Input voltage ripple\\
$\Delta V_{in,max}$ & Maximum input voltage ripple\\
$\Delta V_{out}$ & Output voltage ripple\\
$\Delta V_{out,max}$ & Maximum output voltage ripple\\
$\eta$ & Efficiency\\
$\eta_{converter}$ & Converter efficiency\\
$\eta_{MPPT}$ & MPPT efficiency\\
$\tau$ & Time constant\\
$a$ & Diode's quality factor \\
$C$ & Capacitance\\
$C_{in}$ & Input capacitance\\
$C_{iss}$ & MOSFET input capacitance \\ 
$C_{out}$ & Output capacitance\\
$D$ & Duty cycle\\
$D_{boost}$ & Boost mode duty cycle\\
$D_{buck}$ & Buck mode duty cycle\\
$D_{max}$  & Maximum duty cycle limit \\
$D_{min}$  & Minimum duty cycle limit \\ 
$E$ & Energy\\
$f$ & Switching frequency\\
$f_{c}$ & Corner frequency \\
$f_{filter}$ & Execution frequency of filter\\
$G$ & Gain \\
$I$ & Current\\
$I_{DS}$ & Drain-to-source current \\
$I_{in}$ & Input current \\
$I_{MPP}$ & MPP current\\
$I_{out}$ & Output current \\
$I_{o}$ & Diode's saturation current \\
$I_{ph}$ & Photogenerated current \\
$I_{PV}$ & PV panel's current \\
$I_{SC}$ & Short-circuit current\\
$k$ & Constant \\
$K$ & Boltzmann constant \\
$L$ & Inductance\\
$N$ & Number of PV panels \\
$N_{cells}$ & Number of series connected solar cells \\ 
$N_{max}$ & Maximum number of series connected PV panels \\
$N_{min}$ & Minimum number of series connected PV panels \\
$OA$ & Operational Amplifier \\
$P$ & Power\\
$P_{cond}$ & Conduction losses \\
$P_{diode}$ & Power losses in the diode \\
\end{tabular}
\newpage

\begin{tabular}{ll}
$P_{max}$ & Maximum power under STC\\
$P_{loss}$ & Power loss with constant \\
$P_{MOSFET}$ & Conduction losses in the MOSFET \\
$P_{MPP}$ & MPP power \\
$q$ & Electrical charge \\
$R$ & Resistance\\
$R_{driver out}$ & Output resistance of the driver\\
$R_{DS}$ & Drain-to-source resistance\\
$R_{L}$ & Load resistance\\
$R_{limiting}$ & Gate current limiting resistor\\ 
$R_{MOSFET}$ & Internal gate resistor\\
$R_{p}$ & Parallel resistance \\
$R_{s}$ & Series resistance \\
$R_{thermal}$ & Thermal resistance\\
$t$ & Time\\
$T$ & Temperature \\
$T_{housing}$ & Housing temperature \\
$T_{J}$ & Junction temperature \\
$T_{sw}$ & Switching period \\
$V$ & Voltage\\
$valg$ & Control variable for MPPT \\
$v_{current}$ & Output voltage of current the sensor \\
$V_{DC}$ & DC-link voltage \\
$V_{DD}$ & Supply voltage\\
$V_{DS}$ & Drain-to-source voltage\\
$V_{GS}$ & Gate-to-source voltage\\
$V_{in}$ & Input voltage \\
$V_{MPP}$ & MPP voltage\\
$V_{OC}$ & Open-circuit voltage\\
$V_{OCM}$ & Output common-mode voltage \\
$V_{out}$ & Output voltage \\
$V_{PV}$ & PV panel's voltage \\
$V_{t}$ & Thermal voltage \\
$V_{th}$ & Threshold voltage \\
\end{tabular}
