NicolaiFransen/Semester-Project-PED1/Calculation/ComponentSizing/Calculation input and output voltage and current.docx

Calculation Input and Output for different number of panels

String=[4,15] V= 40 V I

V_DClink=360V

Boost (N=4)

V_MPP=V_in=32,6 V

V_out=V_DClink/4=90V

Pout=Pin= 300W

4:

Duty Cycle =V_in/V-out-1=0,63

I_outputaverage= P_out/V-out= 300W/90V=3,3A

I_inputaverage=I_outputaverage*(1-D)= 9,11 A

Buck(15)

V_input=32,1V

P_input=300W

I_input= 9,2A (all MPP)

V_out=P_out/N=360V/15=24V

V_out/V_in=D=0,73

I_inputaverage=9,2 A

I_maximunaverage= I_inputaverage/D=9,2/0,73= 12,6 A

Boost(Aitor)

V=40V

I_sc=10 A

I_max = I_o +1/L*V_g*(D*T)

I_o=I_m+1/L(V_g-V_out)((1-D)*T)

Buck and boost mode
