NicolaiFransen/Semester-Project-PED1/Datasheet/ComponentsNeeded.xlsx

Product Number | Component | Reference | RS Link | Datasheet | Units needed | Units to buy | Price | Total price | Comments | TOTAL PRICE
754-5443 | MOSFET | IPB200N15N3GATMA1 | https://dk.rs-online.com/web/p/mosfet-transistorer/7545443/ | https://docs-emea.rs-online.com/webdocs/1090/0900766b810908e8.pdf | 4 | 8 | 16.721 | 133.768 |  | 1095.098
920-9830 | Drivers | NCP81074BDR2G | https://dk.rs-online.com/web/p/mosfet-power-drivere/9209830/ | https://docs-emea.rs-online.com/webdocs/14b9/0900766b814b9961.pdf | 4 | 10 | 7.94 | 79.4
686-9381 | Power Supply 5 | LD1117S50CTR | https://dk.rs-online.com/web/p/spaendingsregulatorer-lav-dropout/6869381/ | https://docs-emea.rs-online.com/webdocs/0dbd/0900766b80dbda35.pdf | 1 | 25 | 2.17 | 54.25 | Minimum 25 units (only 1 necessary)
191-4988 | Power Supply 12 | TMA 1212S | https://dk.rs-online.com/web/p/dc-dc-konvertere-isolerende/1914988/ | https://docs-emea.rs-online.com/webdocs/153a/0900766b8153aa01.pdf | 2 | 3 | 36.9 | 110.7
866-0764 | Current Sensor | ACS723-20AB | https://dk.rs-online.com/web/p/products/8660764/ | https://docs-emea.rs-online.com/webdocs/13b5/0900766b813b538e.pdf | 1 | 2 | 28.75 | 57.5
768-7893 | Voltage Sensor | ACPL-C870 | https://dk.rs-online.com/web/p/products/7687893/ | https://docs-emea.rs-online.com/webdocs/116c/0900766b8116c0f3.pdf | 2 | 2 | 33.81 | 67.62
534-4175 | Quad Op Amp | LMC6484 | https://dk.rs-online.com/web/p/operationsforstaerkere/5344175/ | http://www.ti.com/lit/ds/symlink/lmc6484.pdf | 1 | 1 | 22.49 | 22.49
742-7859 | Coil | 470uH | https://dk.rs-online.com/web/p/tradviklede-spoler-til-overflademontering/7427859/ | https://docs-emea.rs-online.com/webdocs/0fe2/0900766b80fe229e.pdf | 2 | 2 | 42.4 | 84.8
315-1101 | Cin | 470 uF | https://dk.rs-online.com/web/p/aluminium-kondensatorer/3151101/ | https://docs-emea.rs-online.com/webdocs/1489/0900766b8148953c.pdf | 5 | 5 | 14.55 | 72.75
871-4035 | Cout | 820 uF | https://dk.rs-online.com/web/p/aluminium-kondensatorer/8714035/ | https://docs-emea.rs-online.com/webdocs/13e5/0900766b813e53d3.pdf | 1 | 1 | 40.82 | 40.82
500-2376 | Cfilter | 100 nF | https://dk.rs-online.com/web/p/keramiske-flerlags-kondensatorer/5002376/ | https://docs-emea.rs-online.com/webdocs/1515/0900766b815152a6.pdf | 2 | 5 | 9.73 | 48.65 | Minimum 5 units (only 2 necessary)
916-3096 | Cfilter | 1 uF | https://dk.rs-online.com/web/p/keramiske-flerlags-kondensatorer/9163096/ |  | 2 | 5 | 10.31 | 51.55 | Minimum 5 units (only 2 necessary)
693-6040P | Optocouplers | ACPL-W70L-000E | https://dk.rs-online.com/web/p/optoelektroniske-switches/6936040P/ | https://docs-emea.rs-online.com/webdocs/14ca/0900766b814cad79.pdf | 4 | 5 | 18.87 | 94.35
158-562 | Heat Sink | TDEX6015/TH | https://dk.rs-online.com/web/p/koleplader/0158562/ | https://docs-emea.rs-online.com/webdocs/0b05/0900766b80b0587d.pdf | 1 | 1 | 99.28 | 99.28
818-4370 | Protection Diodes | VB20100C-E3 | https://dk.rs-online.com/web/p/dioder-ensretter-og-schottky-dioder/8184370/ | https://docs-emea.rs-online.com/webdocs/1301/0900766b813012df.pdf | 2 | 5 | 15.05 | 75.25 | Minimum 5 units (only 2 necessary)
545-0624 | Zenner | BZX84C4V7LT1G (4,7V) | https://dk.rs-online.com/web/p/zenerdioder/5450624/ | https://docs-emea.rs-online.com/webdocs/078e/0900766b8078eabb.pdf | 2 | 2 | 0.96 | 1.92
