NicolaiFransen/Semester-Project-PED1/Reports/P1/docs/converterDesign/component_sizing/component_sizing.tex

\section{Component sizing} \label{component_sizing}

\input{docs/converterDesign/Component_sizing/passives.tex}
\input{docs/converterDesign/Component_sizing/openloop.tex}
