NicolaiFransen/Semester-Project-PED1/Others/EXAMS PED/Old Exam/more exams_lennart/High Voltage and Switch mode Converters/Lek 11  Design equations and model parameters of components/Intro_763.docx

Characterization of a capacitor and inductor

Capacitor

-Picture

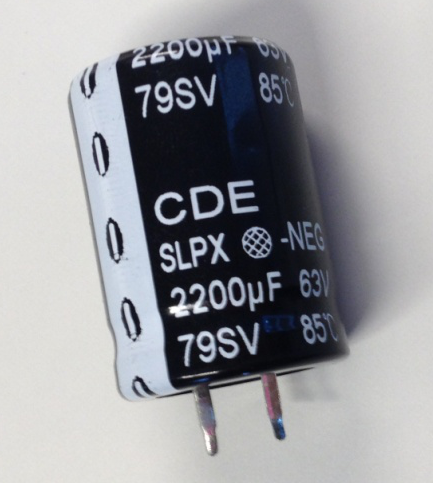
[picture p336: figure]

- Electrical model circuit

- Measured model parameters

At low frequencies the effect of the capacitance dominates:

C=1/(2πfX_C)=1/(2π·20·3.89)=1999.4 µF

At the resonant frequency ( 7962,14 Hz) the effect of the inductance and capacitance compensate and the gain is the resistance:

ESL_C =C/((2πf)^2)=1999.4/(2π·7962,14^2)=12.7 nH

ESR_C =0.0339 Ω

- Plot of impedance

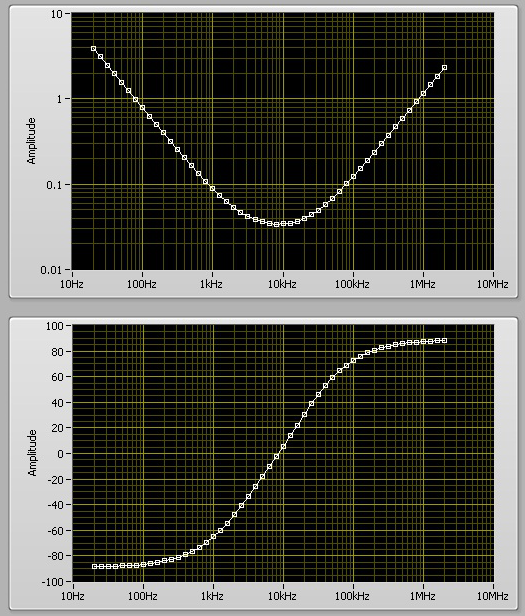
[picture p337: figure]

Inductor

-Picture

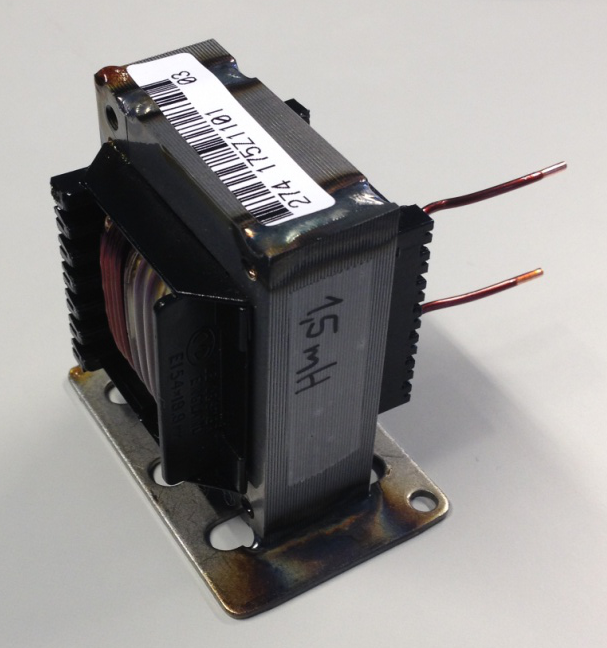
[picture p338: figure]

- Electrical model circuit

- Measured model parameters

With a phase angle of 90º (low frequencies) the effect of the inductance dominates:

L=(X_L)/(2πf)=2.46/(2π·251.8)=1.55 mH

For calculating the resistance we use 20Hz which is the lowest frequency measured (the ideal measurement would be with DC)

ESR_L =0.208 Ω

- Plot of impedance

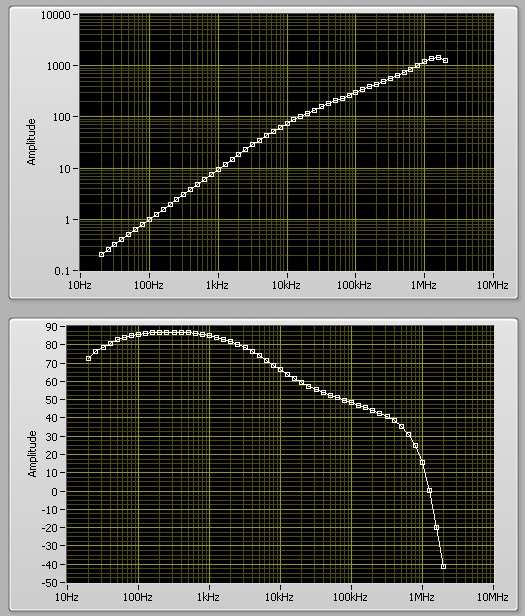
[picture p339: figure]

Type of instrument used for the measurements:

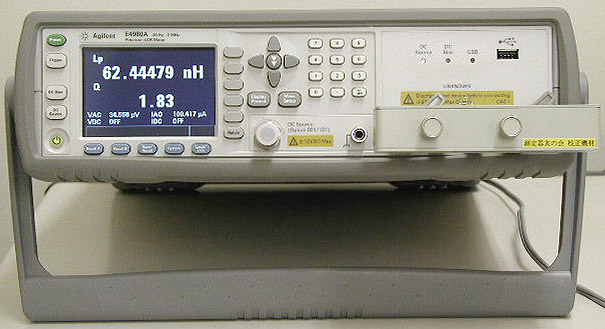
[picture p340: figure]

Agilent E4980A
