NicolaiFransen/Semester-Project-PED1/Calculation/ComponentSizing/beautiful output capacitor.png

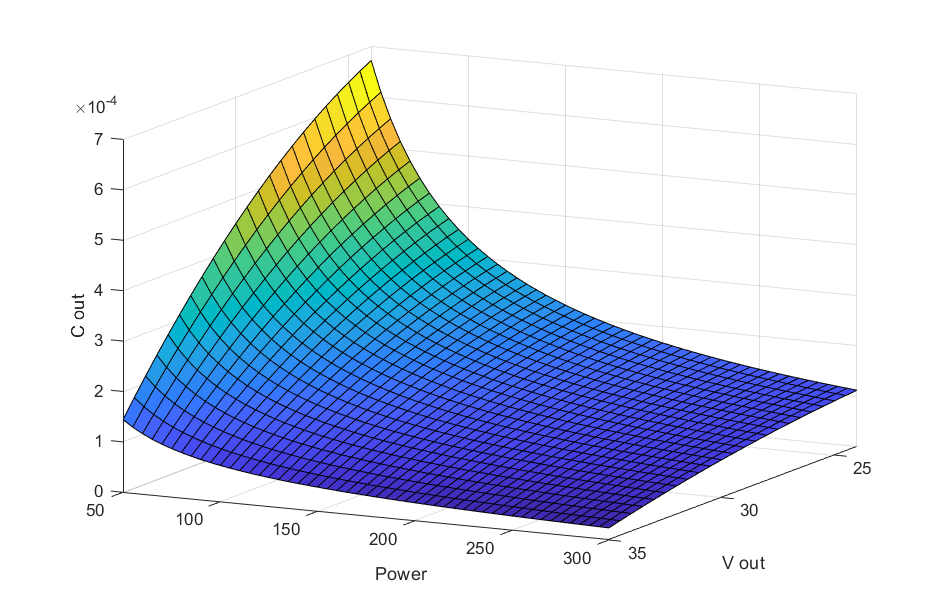
Calculation/ComponentSizing/beautiful output capacitor.png
