NicolaiFransen/Semester-Project-PED1/Calculation/ComponentSizing/Presentation pictures/Output capacitor sizing_low power.png

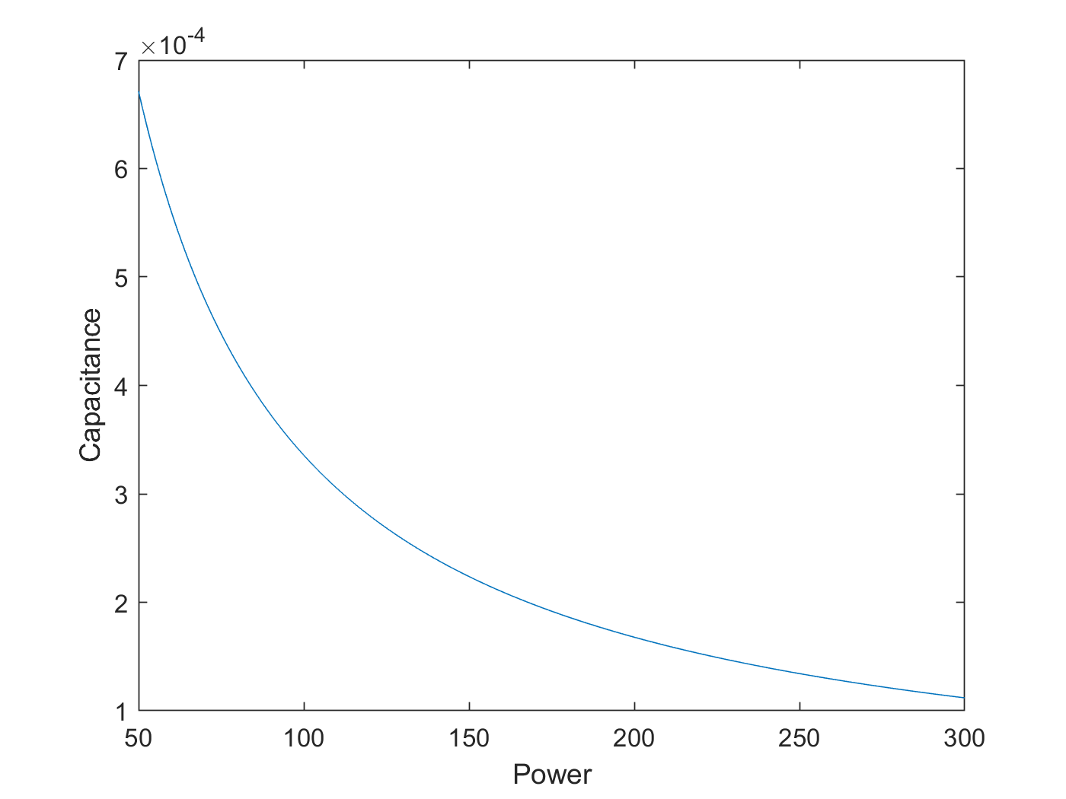
Calculation/ComponentSizing/Presentation pictures/Output capacitor sizing_low power.png
