NicolaiFransen/Semester-Project-PED1/Calculation/ComponentSizing/Presentation pictures/Output capacitor sizing_new.png

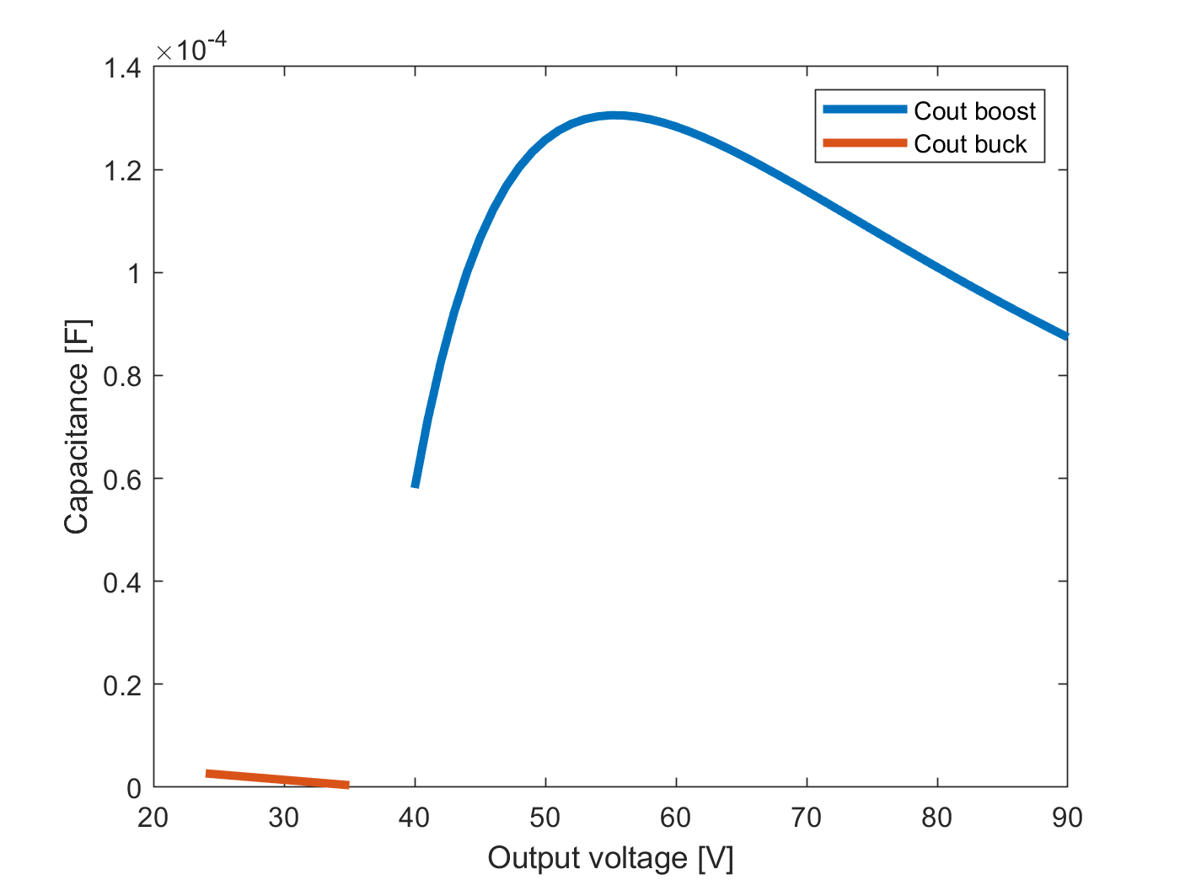
Calculation/ComponentSizing/Presentation pictures/Output capacitor sizing_new.png
