NicolaiFransen/Semester-Project-PED1/Exam/Questions/Passive components/Boost.PNG

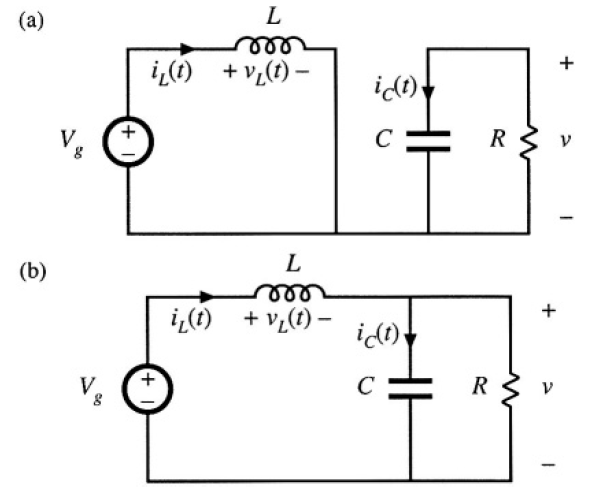
Exam/Questions/Passive components/Boost.PNG
