NicolaiFransen/Semester-Project-PED1/Exam/Questions/Passive components/Capacitance.PNG

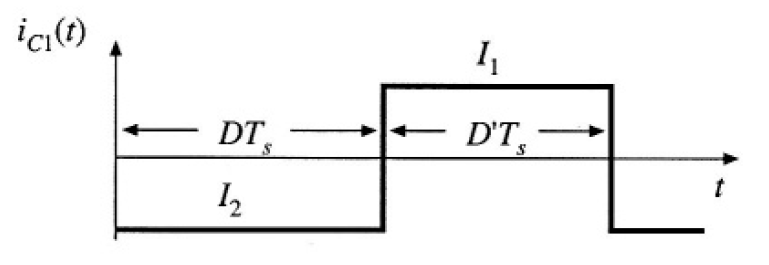
Exam/Questions/Passive components/Capacitance.PNG
