NicolaiFransen/Semester-Project-PED1/Exam/Questions/Passive components/Inductance.PNG

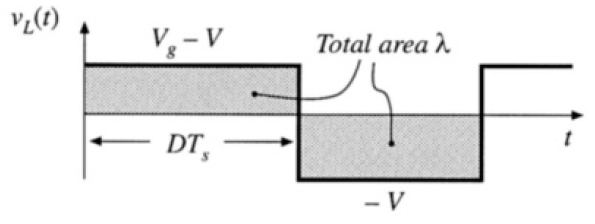
Exam/Questions/Passive components/Inductance.PNG
