NicolaiFransen/Semester-Project-PED1/Schematic_PCB/Components_models/connector_dimensions.jpg

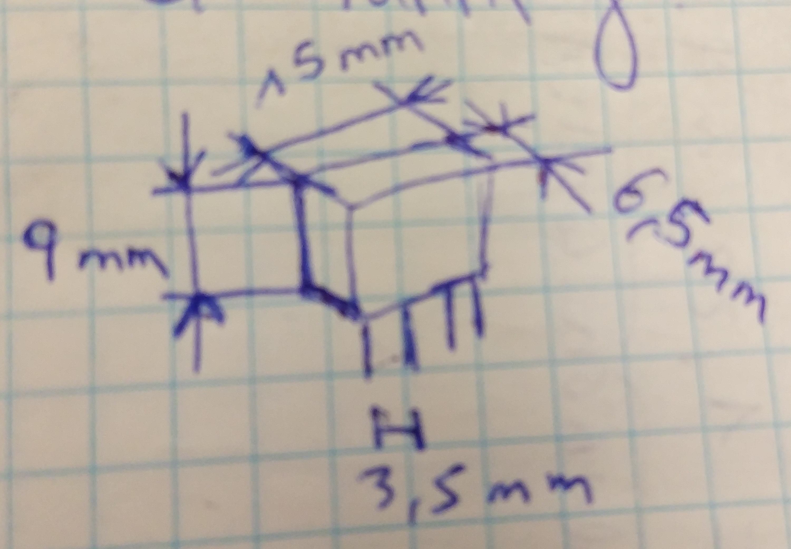
Schematic_PCB/Components_models/connector_dimensions.jpg
