NicolaiFransen/Semester-Project-PED1/Reports/P1/setup/preamble.tex

  \documentclass[11pt,twoside,a4paper,openright]{report}
%%%%%%%%%%%%%%%%%%%%%%%%%%%%%%%%%%%%%%%%%%%%%%%%
% Language, Encoding and Fonts
% http://en.wikibooks.org/wiki/LaTeX/Internationalization
%%%%%%%%%%%%%%%%%%%%%%%%%%%%%%%%%%%%%%%%%%%%%%%%
% Select encoding of your inputs. Depends on
% your operating system and its default input
% encoding. Typically, you should use
%   Linux  : utf8 (most modern Linux distributions)
%            latin1 
%   Windows: ansinew
%            latin1 (works in most cases)
%   Mac    : applemac
% Notice that you can manually change the input
% encoding of your files by selecting "save as"
% an select the desired input encoding. 
\usepackage[utf8]{inputenc}
% Make latex understand and use the typographic
% rules of the language used in the document.
\usepackage[danish,english]{babel}
% Use the palatino font
\usepackage[sc]{mathpazo}
\linespread{1.05}         % Palatino needs more leading (space between lines)
% Choose the font encoding
\usepackage[T1]{fontenc}

%%%%%%%%%%%%%%%%%%%%%%%%%%%%%%%%%%%%%%%%%%%%%%%%
% Graphics and Tables
% http://en.wikibooks.org/wiki/LaTeX/Importing_Graphics
% http://en.wikibooks.org/wiki/LaTeX/Tables
% http://en.wikibooks.org/wiki/LaTeX/Colors
%%%%%%%%%%%%%%%%%%%%%%%%%%%%%%%%%%%%%%%%%%%%%%%%
% load a colour package
\usepackage{xcolor}
\usepackage{colortbl}
\definecolor{aaublue}{RGB}{33,26,82}% dark blue
%\definecolor{black}{RGB}{0,0,0}
% The standard graphics inclusion package
\usepackage{graphicx}
% Set up how figure and table captions are displayed
\usepackage{caption}
\captionsetup{%
  font=footnotesize,% set font size to footnotesize
  labelfont=bf % bold label (e.g., Figure 3.2) font
}
% Make the standard latex tables look so much better
\usepackage{array,booktabs}
% Enable the use of frames around, e.g., theorems
% The framed package is used in the example environment
\usepackage{framed}

% Adds support for full page background picture
\usepackage[contents={},color=gray]{background}
%\usepackage[contents=draft,color=gray]{background}
\usepackage{float}

% Adds support of multi cols and rows
\usepackage{multirow}                		
\usepackage{multicol}         	        

%%%%%%%%%%%%%%%%%%%%%%%%%%%%%%%%%%%%%%%%%%%%%%%%
% Mathematics
% http://en.wikibooks.org/wiki/LaTeX/Mathematics
%%%%%%%%%%%%%%%%%%%%%%%%%%%%%%%%%%%%%%%%%%%%%%%%
% Defines new environments such as equation,
% align and split 
\usepackage{amsmath}
% Adds new math symbols
\usepackage{amssymb}
\usepackage{mathabx}
% Use theorems in your document
% The ntheorem package is also used for the example environment
% When using thmmarks, amsmath must be an option as well. Otherwise \eqref doesn't work anymore.
\usepackage[framed,amsmath,thmmarks]{ntheorem}

%%%%%%%%%%%%%%%%%%%%%%%%%%%%%%%%%%%%%%%%%%%%%%%%
% Page Layout
% http://en.wikibooks.org/wiki/LaTeX/Page_Layout
%%%%%%%%%%%%%%%%%%%%%%%%%%%%%%%%%%%%%%%%%%%%%%%%
% Change margins, papersize, etc of the document
\usepackage[
  inner=28mm,% left margin on an odd page
  outer=41mm,% right margin on an odd page
  top=1.25in,
  bottom=1.25in
  ]{geometry}
  
% Modify how \chapter, \section, etc. look
% The titlesec package is very configureable
\usepackage{titlesec}
%\titleformat{\chapter}[display]{\normalfont\huge\bfseries}{\chaptertitlename\ \thechapter}{20pt}{\Huge}

%\definecolor{gray75}{gray}{0.75}
%\newcommand{\hsp}{\hspace{20pt}}
%\titleformat{\chapter}[hang]{\Huge\bfseries}{\thechapter\hsp\textcolor{gray75}{|}\hsp}{0pt}{\Huge\bfseries}

%Options: Sonny, Lenny, Glenn, Conny, Rejne, Bjarne, Bjornstrup
\usepackage[Bjornstrup]{fncychap}
\ChTitleVar{\raggedleft\Huge}

\titleformat*{\section}{\normalfont\Large\bfseries}
\titleformat*{\subsection}{\normalfont\large\bfseries}
\titleformat*{\subsubsection}{\normalfont\normalsize\bfseries}
\titleformat*{\paragraph}{\normalfont\normalsize\bfseries}
\titleformat*{\subparagraph}{\normalfont\normalsize\bfseries}

% Clear empty pages between chapters
\let\origdoublepage\cleardoublepage
\newcommand{\clearemptydoublepage}{%
  \clearpage
  {\pagestyle{empty}\origdoublepage}%
}
\let\cleardoublepage\clearemptydoublepage

% Change the headers and footers
\usepackage{fancyhdr}
\pagestyle{fancy}
\fancyhf{} %delete everything
\renewcommand{\headrulewidth}{0pt} %remove the horizontal line in the header
\fancyhead[RE]{\small\nouppercase\leftmark} %even page - chapter title
\fancyhead[LO]{\small\nouppercase\rightmark} %uneven page - section title
\fancyhead[LE,RO]{\thepage} %page number on all pages
% Do not stretch the content of a page. Instead,
% insert white space at the bottom of the page
\raggedbottom
% Enable arithmetics with length. Useful when
% typesetting the layout.
\usepackage{calc}

%%%%%%%%%%%%%%%%%%%%%%%%%%%%%%%%%%%%%%%%%%%%%%%%
% Bibliography
% http://en.wikibooks.org/wiki/LaTeX/Bibliography_Management
%%%%%%%%%%%%%%%%%%%%%%%%%%%%%%%%%%%%%%%%%%%%%%%%
%\usepackage[backend=biber,
%  bibencoding=utf8
%  ]{biblatex}
%\addbibresource{bib/mybib}

\usepackage[backend=biber, sorting=none, style=numeric]{biblatex}
\bibliography{../bibliography.bib}

%%%%%%%%%%%%%%%%%%%%%%%%%%%%%%%%%%%%%%%%%%%%%%%%
% Misc
%%%%%%%%%%%%%%%%%%%%%%%%%%%%%%%%%%%%%%%%%%%%%%%%
% Add bibliography and index to the table of
% contents
\usepackage[nottoc]{tocbibind}
% Add the command \pageref{LastPage} which refers to the
% page number of the last page
\usepackage{lastpage}
% Add todo notes in the margin of the document
\usepackage[
%  disable, %turn off todonotes
  colorinlistoftodos, %enable a coloured square in the list of todos
  textwidth=\marginparwidth, %set the width of the todonotes
  textsize=scriptsize, %size of the text in the todonotes
  ]{todonotes}

%%%%%%%%%%%%%%%%%%%%%%%%%%%%%%%%%%%%%%%%%%%%%%%%
% Hyperlinks
% http://en.wikibooks.org/wiki/LaTeX/Hyperlinks
%%%%%%%%%%%%%%%%%%%%%%%%%%%%%%%%%%%%%%%%%%%%%%%%
% Enable hyperlinks and insert info into the pdf
% file. Hypperref should be loaded as one of the 
% last packages

\usepackage[hidelinks]{hyperref}
\hypersetup{%
	pdfpagelabels=false,%
	plainpages=false,%
	pdfauthor={Author(s)},%
	pdftitle={Title},%
	pdfsubject={Subject},%
	bookmarksnumbered=false,%
	colorlinks=false,%
	%citecolor=Black,%
	%filecolor=Black,%
	%linkcolor=Black,% you should probably change this to black before printing
	%urlcolor=Black,%
	%colorlinks,
	%linkcolor={black!50!black},
	%citecolor={black!50!black},
	%urlcolor={black!80!black}
	pdfstartview=FitH%
}

%Package used for capital delta letter

\usepackage{ upgreek }

%Packages used for fancy table in switch sizing
%\usepackage[table,xcdraw]{xcolor}
\usepackage[normalem]{ulem}
\useunder{\uline}{\ul}{}

%Package for inserting pdf file in document.
\usepackage[final]{pdfpages}

%%%% Special signs %%%%
\newcommand{\decC}{^{\circ}\text{C}}
\newcommand{\dec}{^{\circ}}
\newcommand{\m}{\cdot}
