NicolaiFransen/Semester-Project-PED1/Reports/P1/docs/Appendix/Openlooptestresult.tex

\chapter{Open loop test result} \label{appopenloop} 

\begin{figure}[H]
\begin{center}
	
	\caption{Open loop test: Input capacitor.}
	\label{Openlooptestinputcapacitor}
\end{center}	
\end{figure}

\begin{figure}[H]
\begin{center}
	
	\caption{Open loop test: Output capacitor.}
	\label{Openlooptestoutputtcapacitor}
\end{center}	
\end{figure}
