NicolaiFransen/Semester-Project-PED1/Others/HighVoltage/Labexercise3/Experimental circuit.pdf

explain the charging and discharging processes.
The capacitor C1 is charging until the breakdown voltage. If the breakdown voltage is reach, the gap will closed and current will flow trough to C2,R1 and R2. So C1 is discharging and C2 is charging at this time. The gap will open, if the voltage dropped under the breakdown voltage value.

Which type of single‐stage impulse generator circuit is implemented?
We use the type b.
- How is the impulse generator adjusted to obtain a higher impulse?
The gap length have to larger to obtain a higher impulse
- Identify from the setup the type of lightning impulse: positive or negative? Why? It is a negative impulse because the diode are revearse biased
