NicolaiFransen/Semester-Project-PED1/Reports/P1/docs/Appendix/testsetup.tex

\chapter{Test setup}

\begin{figure}[H]
	\begin{center}
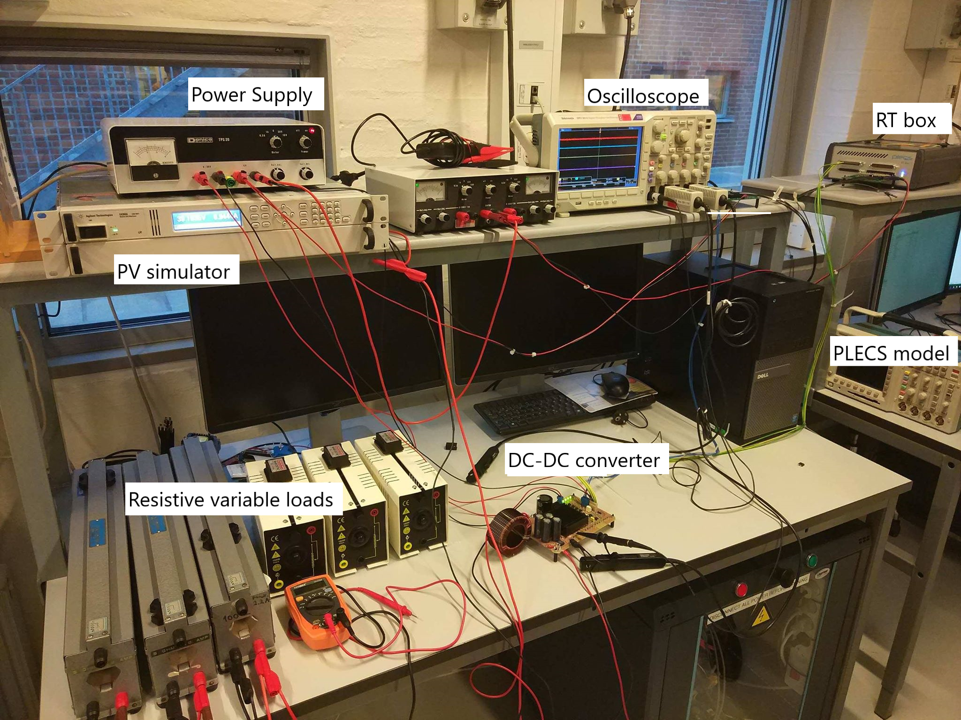
[picture p355: Reports/Pictures/P1/Appendix/testsetup.png]
		
		\caption{Test setup for functional test.}
		\label{testsetup}
	\end{center}	
\end{figure}
