NicolaiFransen/Semester-Project-PED1/Others/HighVoltage/Labexercise3/Volt-time_characteristic.pdf

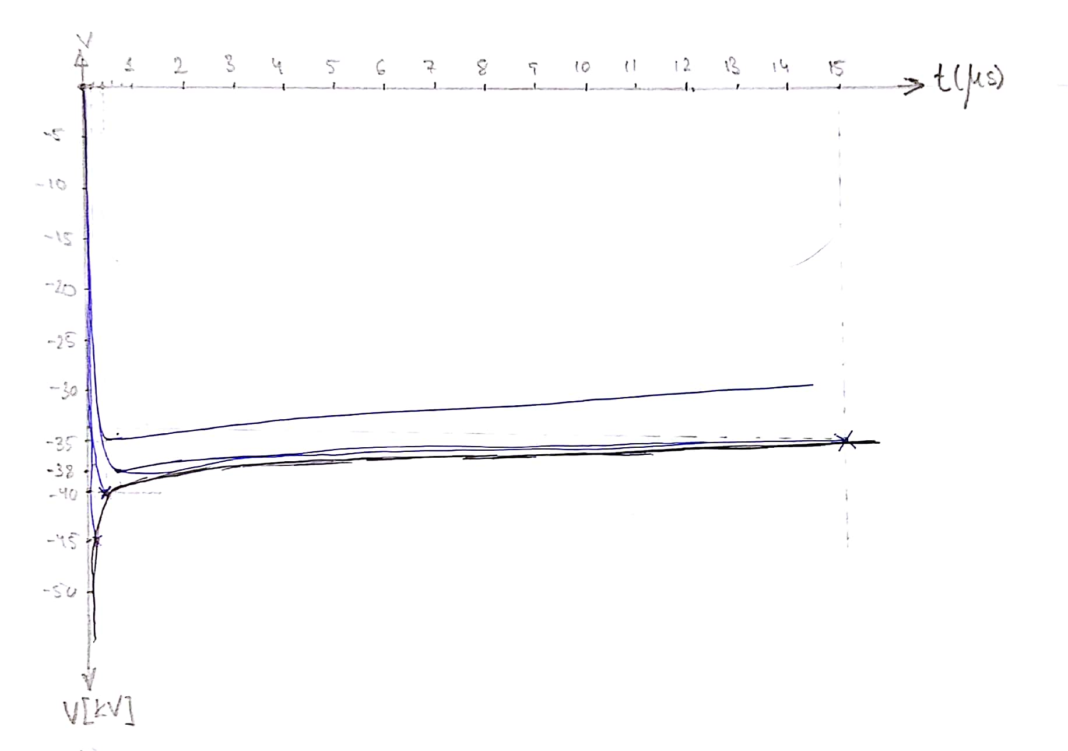
[picture p356: figure]

Scanned by CamScanner
