NicolaiFransen/Semester-Project-PED1/Test/Thermal/Thermal test final.xlsx

BUCK | Vin=36.9 | Iin=8.31 | Rload = 2ohms
 | Time | Coil | Heatsink
 | 0 | 18.2 | 18.7 | 18.2 | 18.2 | 20
 | 2 | 40.2 | 32.8 | 20.2 | 20 | 20
 | 4 | 48.3 | 44.3 | 28.3 | 24.3 | 20
 | 6 | 55.9 | 51.9 | 35.9 | 31.9 | 20
 | 8 | 62.8 | 60.3 | 42.8 | 40.3 | 20
 | 10 | 67.1 | 66.3 | 47.1 | 46.3 | 20
 | 12 | 73 | 72.2 | 53 | 52.2 | 20
 | 14 | 77.6 | 76.1 | 57.6 | 56.1 | 20
 | 16 | 82.3 | 80.8 | 62.3 | 60.8 | 20
 | 18 | 86.5 | 84.1 | 66.5 | 64.1 | 20
 | 20 | 90.2 | 86.8 | 70.2 | 66.8 | 20
 | 22 | 94.2 | 90 | 74.2 | 70 | 20
 | 24 | 96.6 | 90.7 | 76.6 | 70.7 | 20
 | 26 | 98.8 | 92.6 | 78.8 | 72.6 | 20
 | 28 | 101 | 94.1 | 81 | 74.1 | 20
 | 30 | 103 | 94.8 | 83 | 74.8 | 20
 | 32 | 106 | 96.6 | 86 | 76.6 | 20
 | 34 | 108 | 96.6 | 88 | 76.6 | 20
 | 36 | 110 | 97.7 | 90 | 77.7 | 20
 | 38 | 113 | 98.4 | 93 | 78.4 | 20
 | 40 | 114 | 98.9 | 94 | 78.9 | 20
 | 42 | 115 | 99.6 | 95 | 79.6 | 20
 | 44 | 118 | 99.6 | 98 | 79.6 | 20
 | 46 | 118 | 100 | 98 | 80 | 20
 | 48 | 119 | 101 | 99 | 81 | 20
 | 50 | 122 | 101 | 102 | 81 | 20
 | 52 | 124 | 101 | 104 | 81 | 20
 | 54 | 124 | 101 | 104 | 81 | 20
 | 56 | 124 | 101 | 104 | 81 | 20
 | 58 | 124 | 101 | 104 | 81 | 20
 | 60 | 124 | 101 | 104 | 81 | 20
