NicolaiFransen/Semester-Project-PED1/Simulations/PLECS_circuits/Open-loop results/input_ripple_exp.csv

-9.9600e-02 | 0.0112
-9.9580e-02 | 0.0152
-9.9560e-02 | 0.0132
-9.9540e-02 | 0.0112
-9.9520e-02 | 0.0108
-9.9500e-02 | 0.0108
-9.9480e-02 | 0.0092
-9.9460e-02 | 0.0052
-9.9440e-02 | 0.01
-9.9420e-02 | 0.0044
-9.9400e-02 | 0.004
-9.9380e-02 | 0.0064
-9.9360e-02 | 0.0024
-9.9340e-02 | 0.0044
-9.9320e-02 | 0.002
-9.9300e-02 | 0.0016
-9.9280e-02 | 0.0012
-9.9260e-02 | 0.0004
-9.9240e-02 | -0.0036
-9.9220e-02 | 0.0008
-9.9200e-02 | -0.002
-9.9180e-02 | -0.004
-9.9160e-02 | -0.0052
-9.9140e-02 | -0.0032
-9.9120e-02 | -0.0052
-9.9100e-02 | -0.0056
-9.9080e-02 | -0.0076
-9.9060e-02 | -0.0076
-9.9040e-02 | -0.006
-9.9020e-02 | -0.008
-9.9000e-02 | -0.0096
-9.8980e-02 | -0.0092
-9.8960e-02 | -0.0088
-9.8940e-02 | -0.0084
-9.8920e-02 | -0.0092
-9.8900e-02 | -0.0096
-9.8880e-02 | -0.01
-9.8860e-02 | -0.0104
-9.8840e-02 | -0.0108
-9.8820e-02 | -0.0132
-9.8800e-02 | -0.008
-9.8780e-02 | -0.0148
-9.8760e-02 | -0.0096
-9.8740e-02 | -0.0112
-9.8720e-02 | -0.0112
-9.8700e-02 | -0.0128
-9.8680e-02 | -0.0104
-9.8660e-02 | -0.0108
-9.8640e-02 | -0.0112
-9.8620e-02 | -0.0088
-9.8600e-02 | -0.014
-9.8580e-02 | -0.012
-9.8560e-02 | -0.0084
-9.8540e-02 | -0.0124
-9.8520e-02 | -0.0124
-9.8500e-02 | -0.01
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
