NicolaiFransen/Semester-Project-PED1/Test/graphs test MPPT 12_12_18/boost/voltages_currents_boost_100Hz.csv

-4.0000e+00 | 0.2 | -0.12 | 0.4 | 0.16
-3.9900e+00 | 0.6 | -0.04 | 0.4 | 0.24
-3.9800e+00 | 0.6 | -0.12 | 2 | 0.16
-3.9700e+00 | 0.2 | -0.04 | 0.4 | 0.08
-3.9600e+00 | -0.2 | -0.12 | 0.4 | 0.16
-3.9500e+00 | -0.6 | -0.12 | -0.4 | 0.08
-3.9400e+00 | 0.2 | -0.04 | -0.4 | 0
-3.9300e+00 | -0.6 | -0.04 | -0.4 | 0.32
-3.9200e+00 | 0.2 | 0.04 | 0.4 | 0.16
-3.9100e+00 | 0.2 | -0.12 | 1.2 | 0.08
-3.9000e+00 | 0.6 | 0.04 | 0.4 | 0.08
-3.8900e+00 | 0.2 | -0.04 | 2 | 0.08
-3.8800e+00 | -0.2 | -0.04 | 1.2 | 0.16
-3.8700e+00 | 0.2 | -0.12 | 1.2 | 0
-3.8600e+00 | 0.6 | -0.2 | 0.4 | 0
-3.8500e+00 | -0.2 | -0.12 | 1.2 | 0
-3.8400e+00 | 0.2 | -0.04 | 0.4 | 0.08
-3.8300e+00 | 0.6 | -0.12 | 2 | 0.16
-3.8200e+00 | 0.2 | -0.12 | 1.2 | 0.16
-3.8100e+00 | -0.6 | -0.12 | 1.2 | 0.24
-3.8000e+00 | -0.6 | -0.04 | 0.4 | 0
-3.7900e+00 | -0.2 | 0.04 | 0.4 | 0.08
-3.7800e+00 | 0.2 | -0.04 | 0.4 | 0.08
-3.7700e+00 | 0.6 | -0.2 | 0.4 | 0.08
-3.7600e+00 | -0.2 | 0.04 | 0.4 | 0.08
-3.7500e+00 | 0.2 | -0.2 | 0.4 | 0.08
-3.7400e+00 | 0.2 | -0.04 | 0.4 | 0.08
-3.7300e+00 | -0.2 | -0.12 | 0.4 | -0.08
-3.7200e+00 | 0.2 | 0.04 | 0.4 | -0.08
-3.7100e+00 | -0.2 | -0.12 | 0.4 | 0.08
-3.7000e+00 | -0.2 | -0.04 | 1.2 | 0.16
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
