NicolaiFransen/Semester-Project-PED1/Test/graphs test MPPT 12_12_18/boost/200irr.csv

-2.0000e+01 | 0.2 | -0.02 | 0 | 0.06
-1.9996e+01 | 0.2 | -0.06 | -0.4 | 0.1
-1.9992e+01 | 0.2 | -0.06 | -0.8 | 0.06
-1.9988e+01 | 0.2 | 0.02 | -0.4 | 0.1
-1.9984e+01 | -0.2 | -0.06 | 0.4 | 0.06
-1.9980e+01 | -0.2 | -0.02 | -0.4 | 0.1
-1.9976e+01 | 0.2 | -0.06 | -0.4 | 0.06
-1.9972e+01 | 0.6 | -0.02 | 0 | 0.06
-1.9968e+01 | 0.2 | -0.02 | 0 | 0.1
-1.9964e+01 | 0.6 | -0.06 | -0.4 | 0.06
-1.9960e+01 | -0.2 | -0.1 | 0 | 0.02
-1.9956e+01 | -0.6 | 0.02 | 0.4 | 0.06
-1.9952e+01 | 0.2 | -0.06 | 0 | 0.06
-1.9948e+01 | 0.2 | -0.06 | -0.4 | 0.06
-1.9944e+01 | -0.2 | -0.06 | 0.4 | 0.06
-1.9940e+01 | 0.6 | -0.02 | -0.4 | 0.06
-1.9936e+01 | 0.2 | -0.06 | 0 | 0.06
-1.9932e+01 | -0.6 | -0.06 | 0 | 0.06
-1.9928e+01 | 0.2 | -0.06 | 0 | 0.02
-1.9924e+01 | 0.6 | -0.02 | 0 | -0.02
-1.9920e+01 | -0.6 | -0.14 | 0 | -0.02
-1.9916e+01 | -0.6 | -0.02 | 0 | 0.06
-1.9912e+01 | 0.2 | -0.06 | -0.4 | 0.02
-1.9908e+01 | 0.6 | 0.02 | 0 | 0.06
-1.9904e+01 | 0.6 | -0.06 | 0 | 0.1
-1.9900e+01 | 0.2 | -0.06 | 0 | 0.06
-1.9896e+01 | 0.6 | -0.1 | 0 | 0.06
-1.9892e+01 | 0.6 | -0.06 | -0.8 | 0.02
-1.9888e+01 | -0.6 | -0.1 | -0.4 | 0.06
-1.9884e+01 | 1 | -0.06 | 0 | 0.1
-1.9880e+01 | -0.6 | -0.06 | 0.4 | -0.06
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
