NicolaiFransen/Semester-Project-PED1/Test/graphs test MPPT 12_12_18/boost/voltages_currents_boost_10Hz.csv

-2.0000e+01 | 0.6 | -0.04 | 0.4 | 0.16
-1.9996e+01 | -0.6 | -0.04 | 0.4 | 0
-1.9992e+01 | 0.2 | 0.04 | 1.2 | 0.24
-1.9988e+01 | -0.2 | -0.12 | 0.4 | 0.08
-1.9984e+01 | 1 | 0.04 | 1.2 | 0
-1.9980e+01 | 0.6 | -0.04 | -0.4 | 0
-1.9976e+01 | 0.6 | -0.12 | 1.2 | 0.16
-1.9972e+01 | 0.2 | 0.04 | -0.4 | 0.08
-1.9968e+01 | -0.2 | -0.04 | -0.4 | 0
-1.9964e+01 | 0.2 | -0.04 | 0.4 | 0
-1.9960e+01 | -0.2 | -0.12 | 0.4 | 0
-1.9956e+01 | -1 | -0.12 | 2 | 0.08
-1.9952e+01 | -0.2 | -0.12 | -0.4 | 0.08
-1.9948e+01 | 0.2 | -0.04 | 1.2 | 0
-1.9944e+01 | 0.2 | 0.04 | 1.2 | 0.16
-1.9940e+01 | 0.2 | 0.04 | 0.4 | 0
-1.9936e+01 | 1 | 0.04 | -0.4 | 0.08
-1.9932e+01 | 1 | -0.04 | 0.4 | 0.08
-1.9928e+01 | 0.2 | -0.04 | -0.4 | 0.16
-1.9924e+01 | -0.2 | -0.04 | 0.4 | 0.08
-1.9920e+01 | 0.2 | 0.04 | 2 | 0.24
-1.9916e+01 | -0.6 | -0.12 | 0.4 | 0.24
-1.9912e+01 | 0.2 | -0.12 | 1.2 | 0.16
-1.9908e+01 | -1 | -0.12 | 0.4 | 0.16
-1.9904e+01 | 0.6 | 0.12 | 1.2 | 0.08
-1.9900e+01 | 0.6 | 0.04 | 0.4 | 0.08
-1.9896e+01 | 0.2 | -0.2 | 0.4 | 0.08
-1.9892e+01 | 0.6 | 0.04 | 0.4 | 0
-1.9888e+01 | 0.2 | -0.12 | 0.4 | 0.08
-1.9884e+01 | -0.6 | -0.12 | 0.4 | 0.16
-1.9880e+01 | -0.6 | -0.04 | 1.2 | 0
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
