NicolaiFransen/Semester-Project-PED1/Test/Matlabcode/240.csv

3.00E+00 | 37 | 6.16 | 27.2
3.01E+00 | 36.6 | 6.16 | 25.6
3.01E+00 | 37 | 6.08 | 25.6
3.01E+00 | 36.2 | 6.32 | 26.4
3.01E+00 | 36.6 | 6.08 | 28
3.01E+00 | 35.8 | 6.24 | 26.4
3.01E+00 | 36.6 | 6.24 | 26.4
3.01E+00 | 36.2 | 6.24 | 25.6
3.01E+00 | 36.2 | 6.24 | 25.6
3.01E+00 | 36.2 | 6.24 | 25.6
3.01E+00 | 36.6 | 6.24 | 26.4
3.02E+00 | 36.2 | 6.16 | 28
3.02E+00 | 35.8 | 6.24 | 27.2
3.02E+00 | 35.8 | 6.24 | 27.2
3.02E+00 | 36.2 | 6.16 | 27.2
3.02E+00 | 36.2 | 6.16 | 27.2
3.02E+00 | 35.8 | 6.4 | 25.6
3.02E+00 | 36.6 | 6.16 | 25.6
3.02E+00 | 36.6 | 6.16 | 27.2
3.02E+00 | 36.6 | 6.24 | 27.2
3.02E+00 | 36.2 | 6.32 | 25.6
3.03E+00 | 35.8 | 6.24 | 25.6
3.03E+00 | 35.8 | 6.08 | 27.2
3.03E+00 | 37 | 6.24 | 26.4
3.03E+00 | 36.2 | 6.32 | 27.2
3.03E+00 | 36.2 | 6.16 | 26.4
3.03E+00 | 35.8 | 6.24 | 26.4
3.03E+00 | 37 | 6.16 | 26.4
3.03E+00 | 35.8 | 6.08 | 25.6
3.03E+00 | 36.2 | 6.24 | 27.2
3.03E+00 | 36.2 | 6.32 | 26.4
3.04E+00 | 36.2 | 6.16 | 26.4
3.04E+00 | 37 | 6.32 | 27.2
3.04E+00 | 36.6 | 6.32 | 26.4
3.04E+00 | 35.8 | 6.16 | 27.2
3.04E+00 | 36.6 | 6.24 | 27.2
3.04E+00 | 36.2 | 6.24 | 25.6
3.04E+00 | 36.2 | 6.4 | 26.4
3.04E+00 | 35.8 | 6.08 | 26.4
3.04E+00 | 35.8 | 6.24 | 25.6
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
