NicolaiFransen/Semester-Project-PED1/Test/Matlabcode/300.csv

-5.00E+00 | 38.2 | 7.52 | 30.4
-5.00E+00 | 38.6 | 7.36 | 29.6
-5.00E+00 | 39 | 7.52 | 30.4
-5.00E+00 | 38.6 | 7.52 | 29.6
-5.00E+00 | 38.2 | 7.52 | 29.6
-5.00E+00 | 38.2 | 7.52 | 28.8
-4.99E+00 | 38.6 | 7.44 | 31.2
-4.99E+00 | 38.2 | 7.44 | 30.4
-4.99E+00 | 39 | 7.52 | 31.2
-4.99E+00 | 38.6 | 7.52 | 29.6
-4.99E+00 | 39 | 7.52 | 30.4
-4.99E+00 | 39 | 7.6 | 28.8
-4.99E+00 | 39 | 7.44 | 28.8
-4.99E+00 | 39 | 7.44 | 31.2
-4.99E+00 | 39.4 | 7.44 | 29.6
-4.99E+00 | 39 | 7.44 | 30.4
-4.98E+00 | 39 | 7.52 | 31.2
-4.98E+00 | 39 | 7.52 | 29.6
-4.98E+00 | 38.6 | 7.44 | 28.8
-4.98E+00 | 38.6 | 7.52 | 30.4
-4.98E+00 | 38.6 | 7.52 | 29.6
-4.98E+00 | 39 | 7.52 | 29.6
-4.98E+00 | 38.6 | 7.52 | 29.6
-4.98E+00 | 38.6 | 7.52 | 30.4
-4.98E+00 | 39 | 7.52 | 30.4
-4.98E+00 | 38.6 | 7.52 | 30.4
-4.97E+00 | 38.6 | 7.52 | 29.6
-4.97E+00 | 39 | 7.52 | 28.8
-4.97E+00 | 39 | 7.52 | 28.8
-4.97E+00 | 39 | 7.44 | 28
-4.97E+00 | 38.6 | 7.44 | 29.6
-4.97E+00 | 38.6 | 7.6 | 29.6
-4.97E+00 | 38.6 | 7.44 | 29.6
-4.97E+00 | 39 | 7.52 | 31.2
-4.97E+00 | 39 | 7.44 | 29.6
-4.97E+00 | 38.6 | 7.44 | 28.8
-4.96E+00 | 38.6 | 7.36 | 30.4
-4.96E+00 | 39 | 7.52 | 28.8
-4.96E+00 | 38.6 | 7.44 | 29.6
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
