NicolaiFransen/Semester-Project-PED1/Reports/P1/docs/discussion/CoilTests/CoilComparison50kHz.png

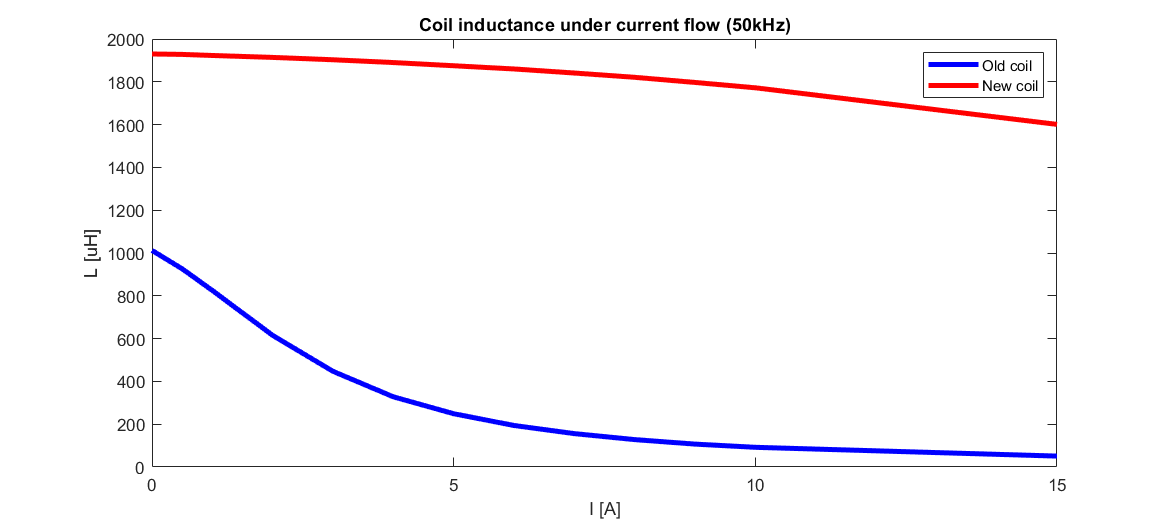
Reports/P1/docs/discussion/CoilTests/CoilComparison50kHz.png
