NicolaiFransen/Semester-Project-PED1/Reports/P1/docs/discussion/CoilTests/NewCoil.jpg

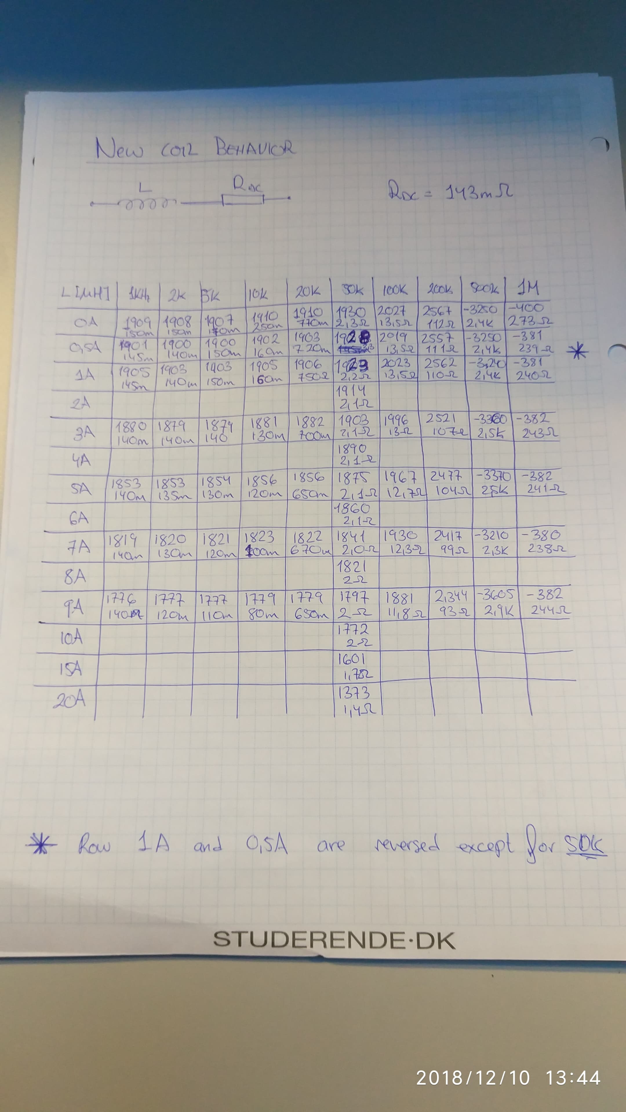
Reports/P1/docs/discussion/CoilTests/NewCoil.jpg
