NicolaiFransen/Semester-Project-PED1/Reports/Pictures/P1/Test/Buck_mode_MPPT_Vin_Vout_Iin_Pin_Pout.png

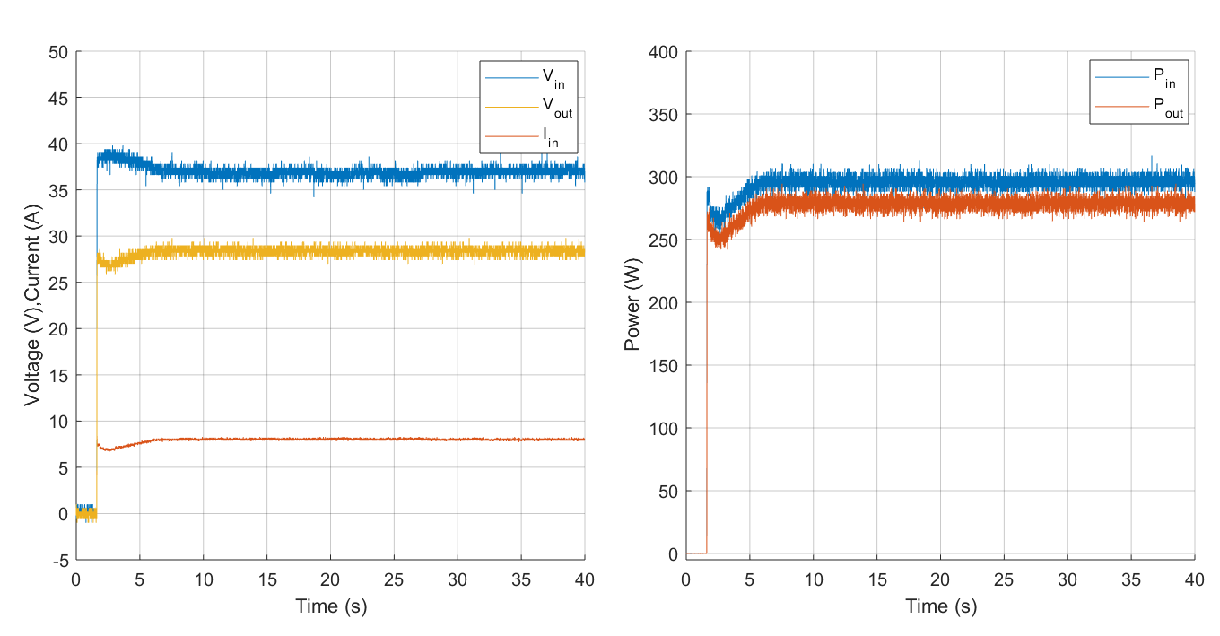
Reports/Pictures/P1/Test/Buck_mode_MPPT_Vin_Vout_Iin_Pin_Pout.png
