NicolaiFransen/Semester-Project-PED1/Reports/Pictures/test.PNG

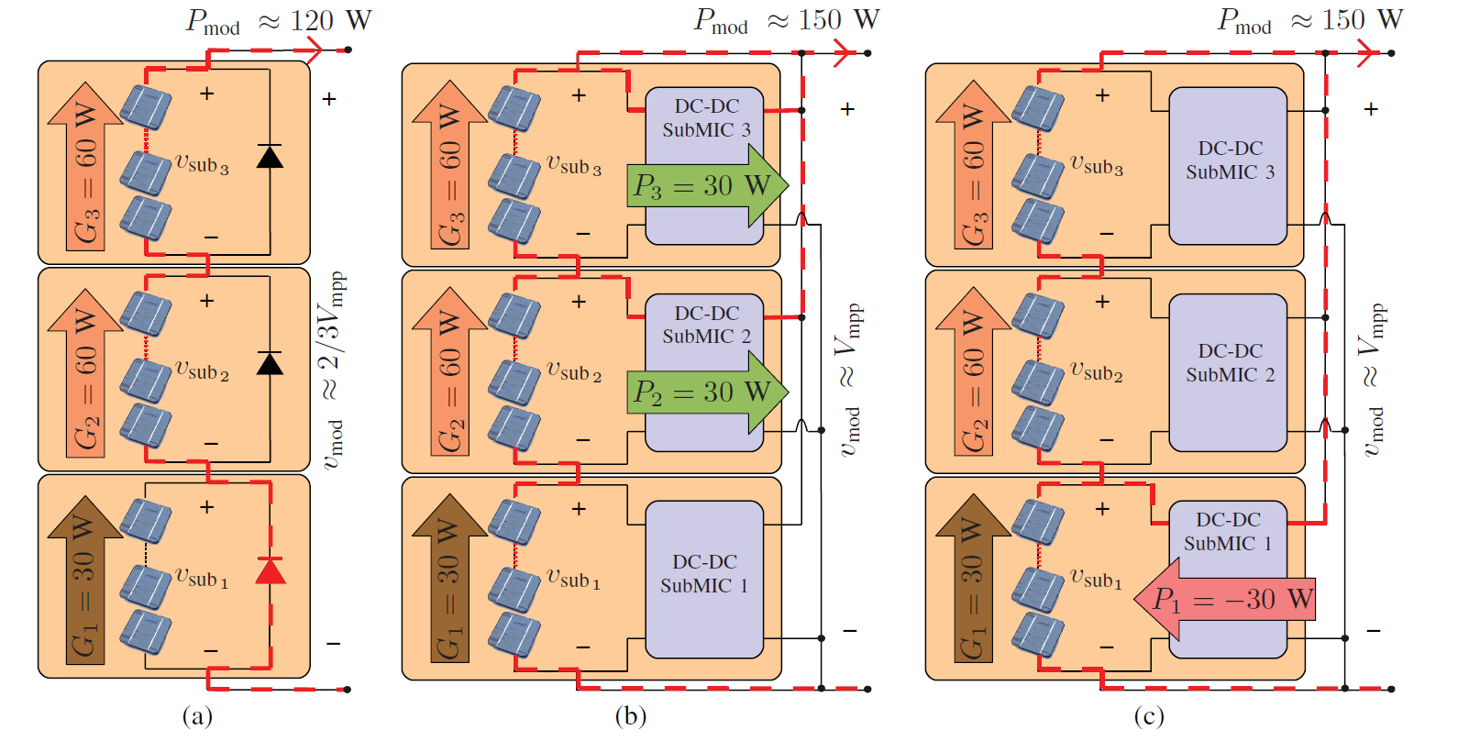
Reports/Pictures/test.PNG
