NicolaiFransen/Semester-Project-PED1/Test/graphs test MPPT 11_12_18/10Hz/tek00000.png

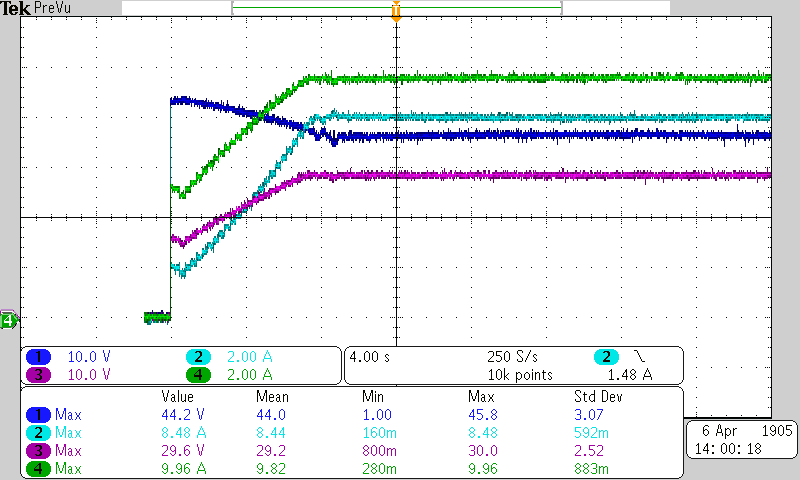
Test/graphs test MPPT 11_12_18/10Hz/tek00000.png
