NicolaiFransen/Semester-Project-PED1/Test/graphs test MPPT 11_12_18/100Hz/100Hz_all.png

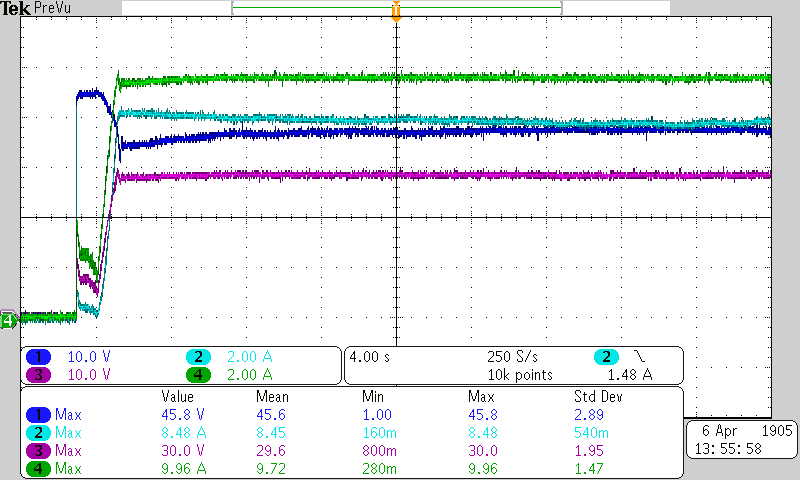
Test/graphs test MPPT 11_12_18/100Hz/100Hz_all.png
