NicolaiFransen/Semester-Project-PED1/Test/graphs test MPPT 11_12_18/tek00005.png

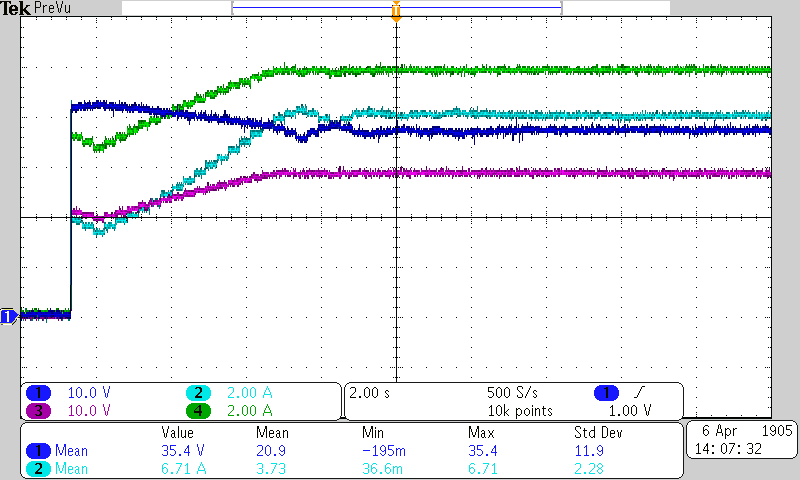
Test/graphs test MPPT 11_12_18/tek00005.png
