NicolaiFransen/Semester-Project-PED1/Test/graphs test MPPT 11_12_18/voltages_currents_ALL.png

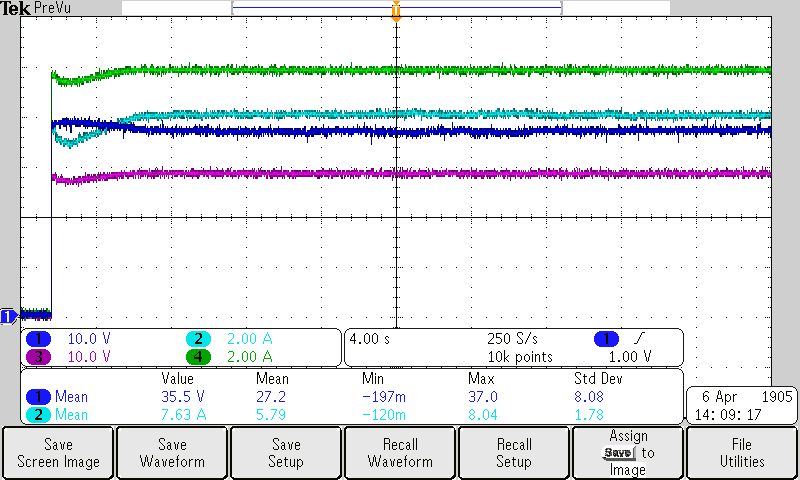
Test/graphs test MPPT 11_12_18/voltages_currents_ALL.png
