NicolaiFransen/Semester-Project-PED1/Test/graphs test MPPT 12_12_18/boost/voltages_currents_boost_100Hz.png

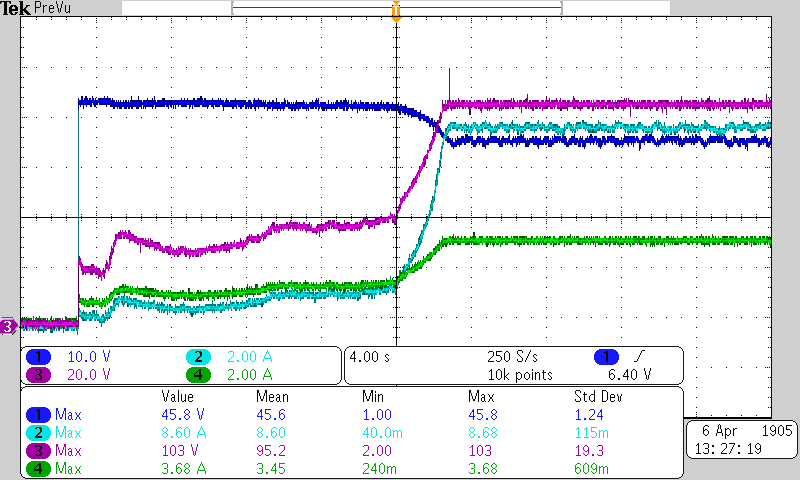
Test/graphs test MPPT 12_12_18/boost/voltages_currents_boost_100Hz.png
