NicolaiFransen/Semester-Project-PED1/Test/graphs test MPPT 12_12_18/graphs open loop simulation/current_inductor.png

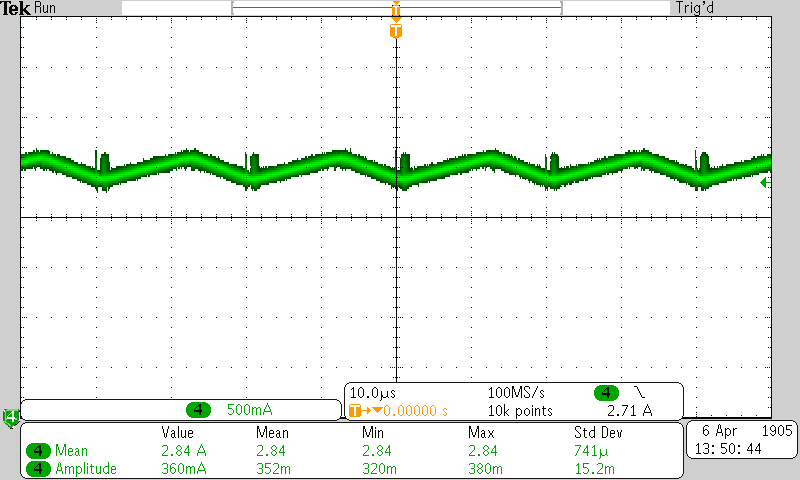
Test/graphs test MPPT 12_12_18/graphs open loop simulation/current_inductor.png
