NicolaiFransen/Semester-Project-PED1/Test/graphs test MPPT 12_12_18/graphs open loop simulation/input_voltage_ripple.png

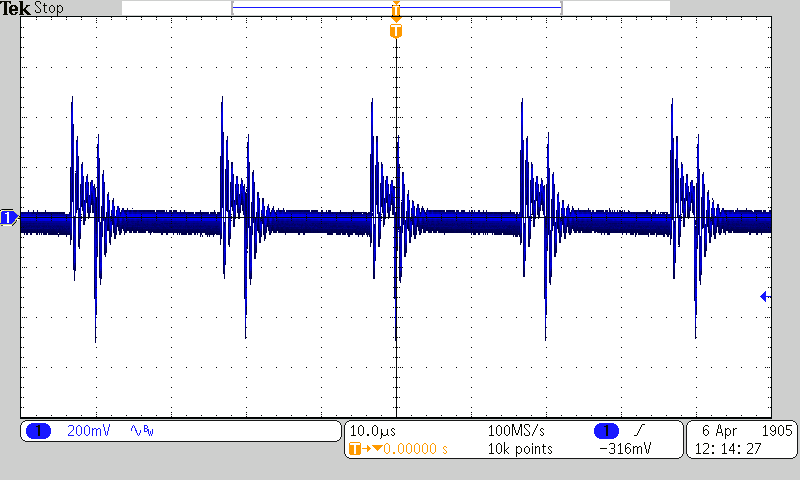
Test/graphs test MPPT 12_12_18/graphs open loop simulation/input_voltage_ripple.png
