NicolaiFransen/Semester-Project-PED1/Test/graphs test MPPT 12_12_18/graphs open loop simulation/tek00000.tif

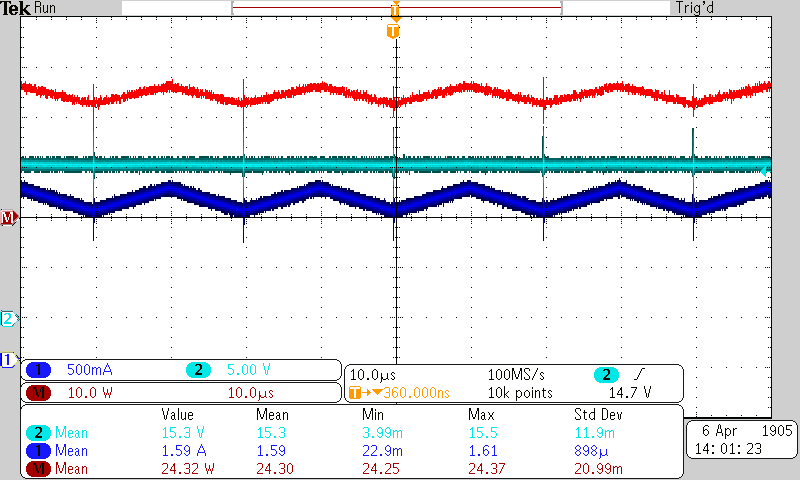
Test/graphs test MPPT 12_12_18/graphs open loop simulation/tek00000.tif
