NicolaiFransen/Semester-Project-PED1/Test/graphs test MPPT 13_12_18/changing 1 to 0.8.png

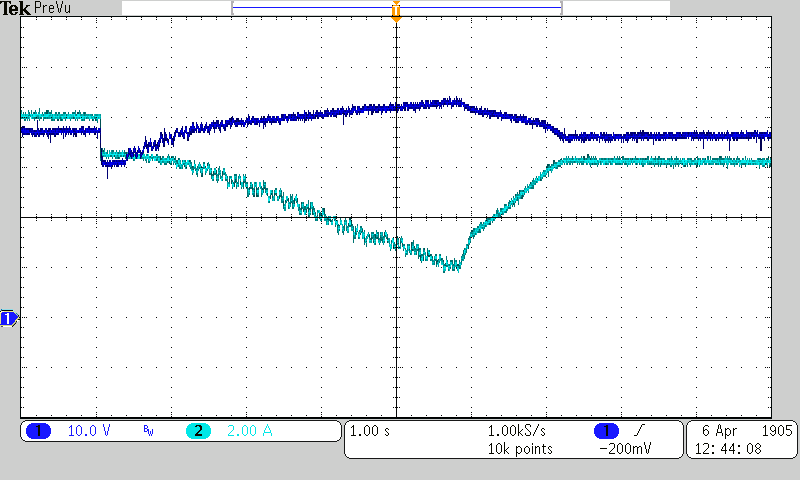
Test/graphs test MPPT 13_12_18/changing 1 to 0.8.png
