NicolaiFransen/Semester-Project-PED1/Test/graphs test MPPT 13_12_18/changing 25 to 20.png

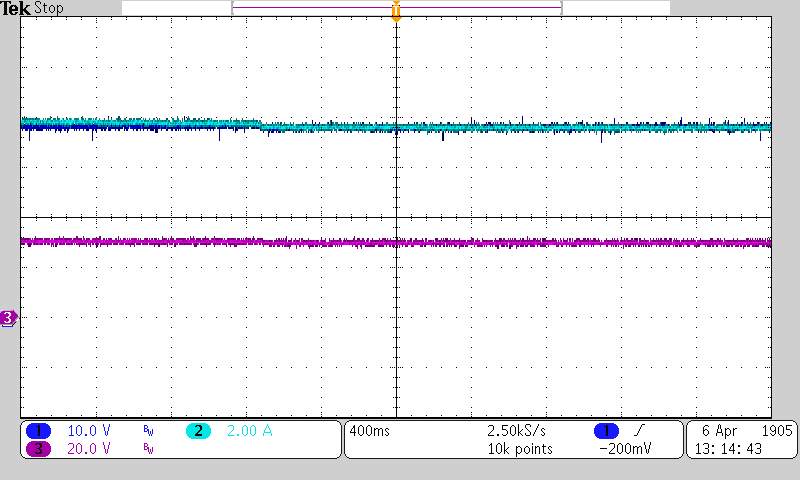
Test/graphs test MPPT 13_12_18/changing 25 to 20.png
