NicolaiFransen/Semester-Project-PED1/Test/OpenLoop/Cin/tek00000.png

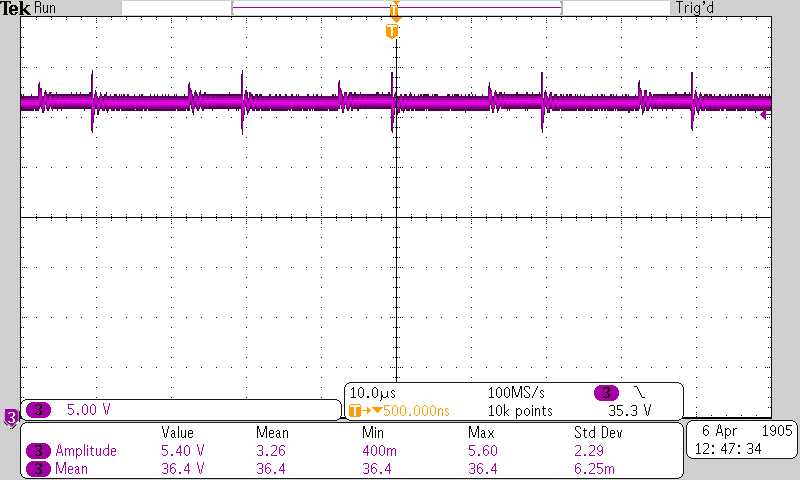
Test/OpenLoop/Cin/tek00000.png
