NicolaiFransen/Semester-Project-PED1/Test/picture from thermal test/FLIR0087.jpg

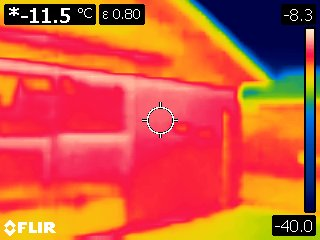
Test/picture from thermal test/FLIR0087.jpg
