NicolaiFransen/Semester-Project-PED1/Test/picture from thermal test/FLIR0095.jpg

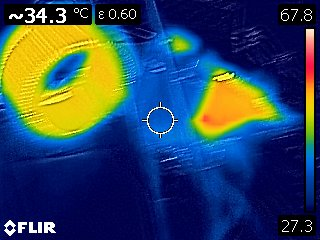
Test/picture from thermal test/FLIR0095.jpg
