NicolaiFransen/Semester-Project-PED1/Test/picture from thermal test/FLIR0099.jpg

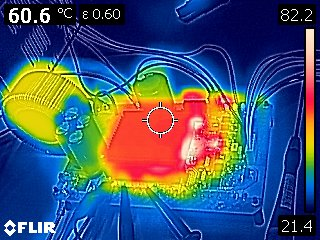
Test/picture from thermal test/FLIR0099.jpg
