NicolaiFransen/Semester-Project-PED1/Test/Pictures/Inductor measurements/tek00003.tif

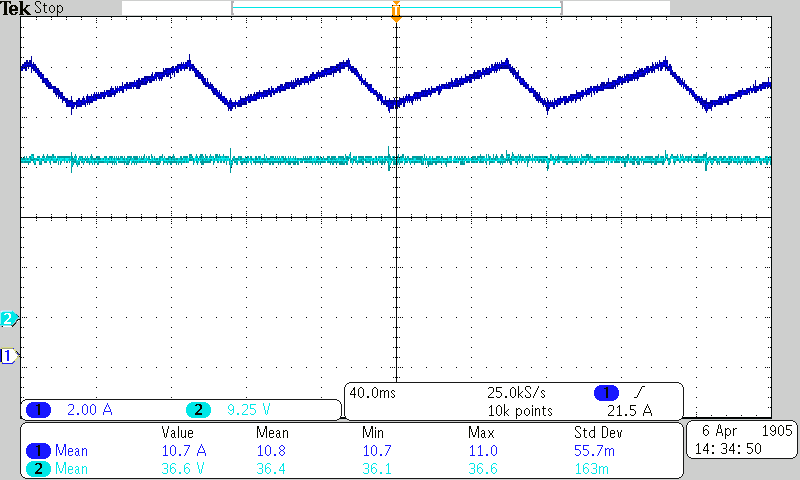
Test/Pictures/Inductor measurements/tek00003.tif
