NicolaiFransen/Semester-Project-PED1/Test/Pictures/Inductor measurements/tek00004.tif

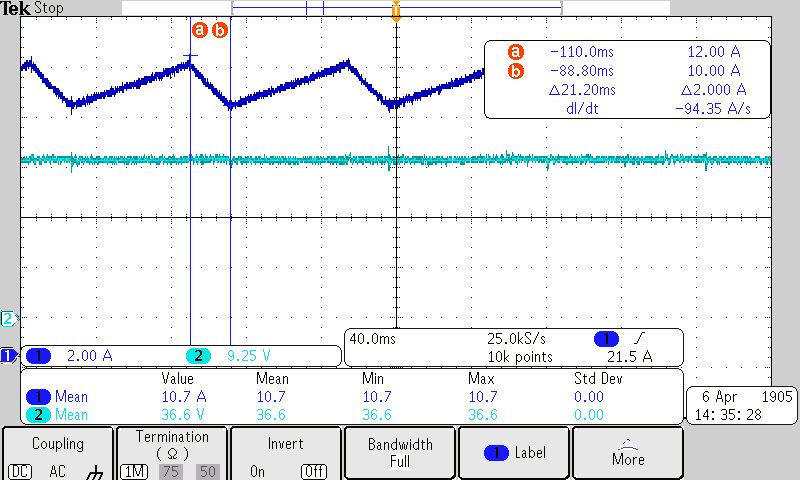
Test/Pictures/Inductor measurements/tek00004.tif
