NicolaiFransen/Semester-Project-PED1/Test/Pictures/Inductor measurements/tek00005.tif

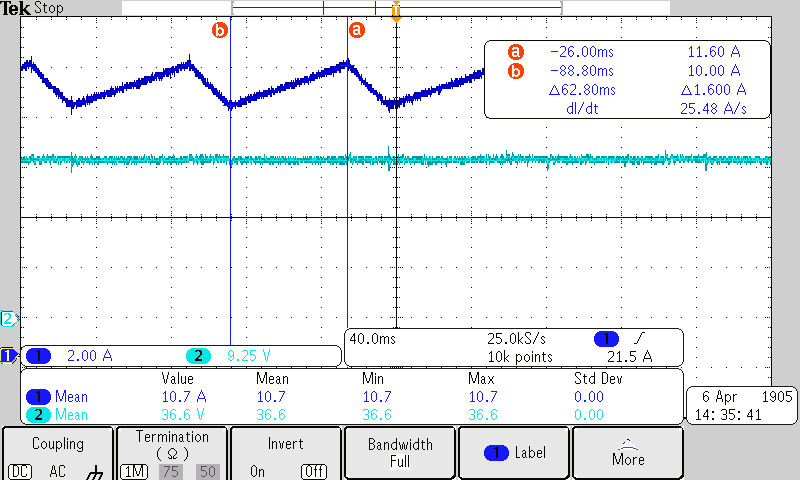
Test/Pictures/Inductor measurements/tek00005.tif
