NicolaiFransen/Semester-Project-PED1/Test/Pictures/Inductor measurements/tek00006.tif

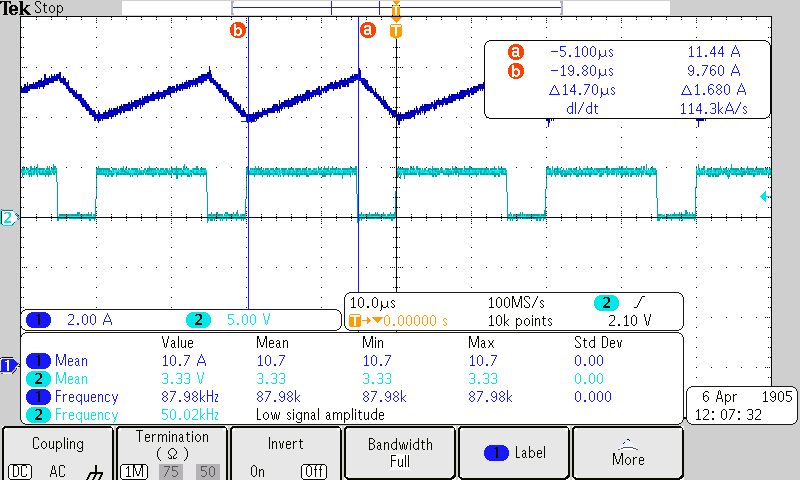
Test/Pictures/Inductor measurements/tek00006.tif
