NicolaiFransen/Semester-Project-PED1/Test/Pictures/Inductor measurements/tek00007.tif

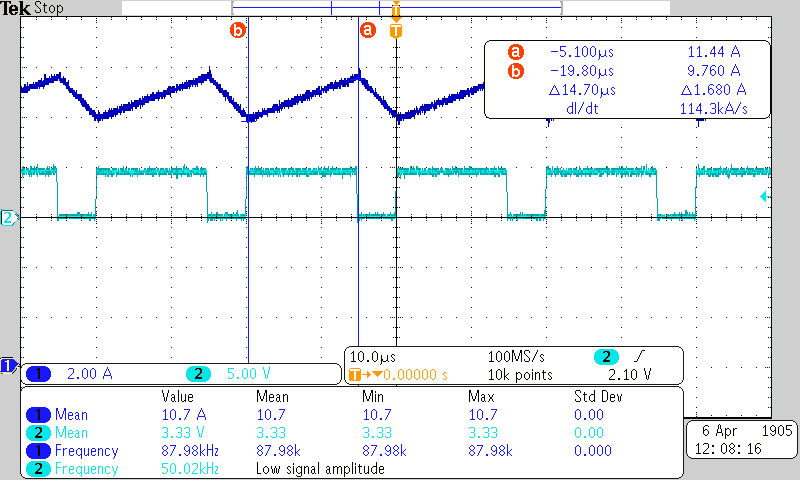
Test/Pictures/Inductor measurements/tek00007.tif
