NicolaiFransen/Semester-Project-PED1/Test/Pictures/Open-loop/Boost/2018_12_06_Boost_open_loop_input.png

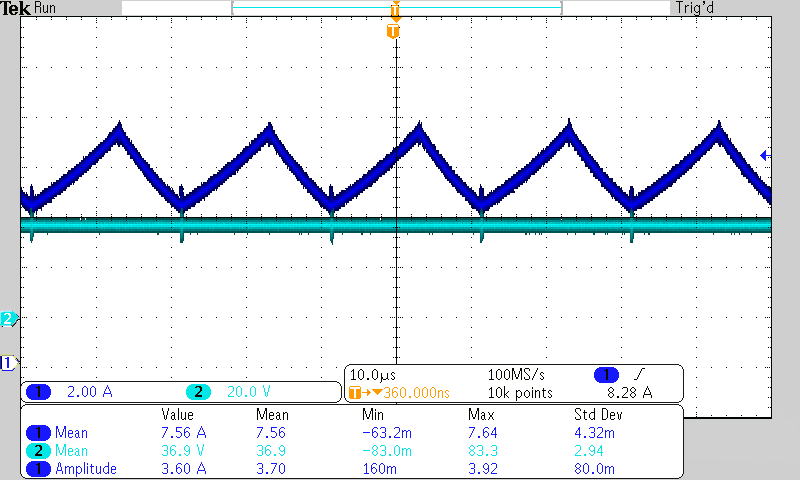
Test/Pictures/Open-loop/Boost/2018_12_06_Boost_open_loop_input.png
