NicolaiFransen/Semester-Project-PED1/Test/Pictures/Open-loop/Buck/2018_12_06_Buck_open_loop_input.png

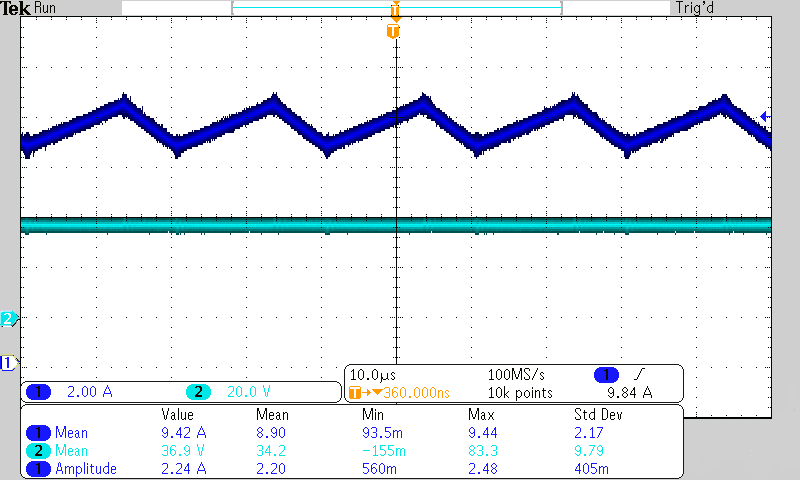
Test/Pictures/Open-loop/Buck/2018_12_06_Buck_open_loop_input.png
