NicolaiFransen/Semester-Project-PED1/Test/Pictures/Open-loop/Buck/2018_12_06_Buck_open_loop_output.png

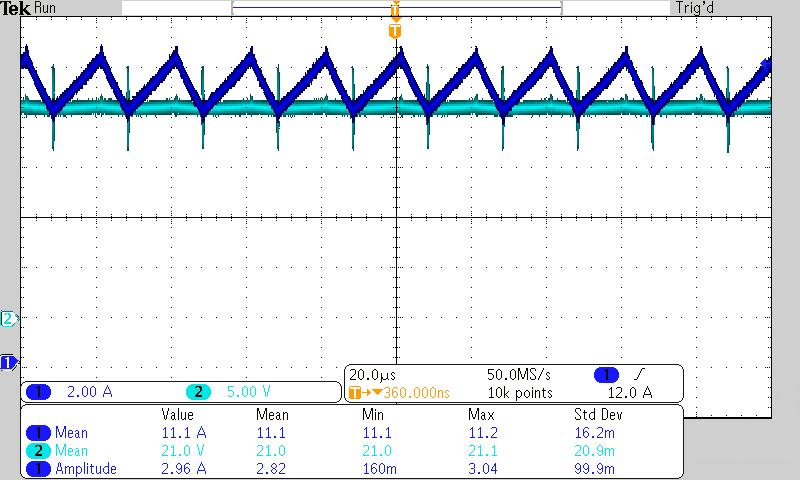
Test/Pictures/Open-loop/Buck/2018_12_06_Buck_open_loop_output.png
