NicolaiFransen/Semester-Project-PED1/Test/Pictures/Transients/tek00002.tif

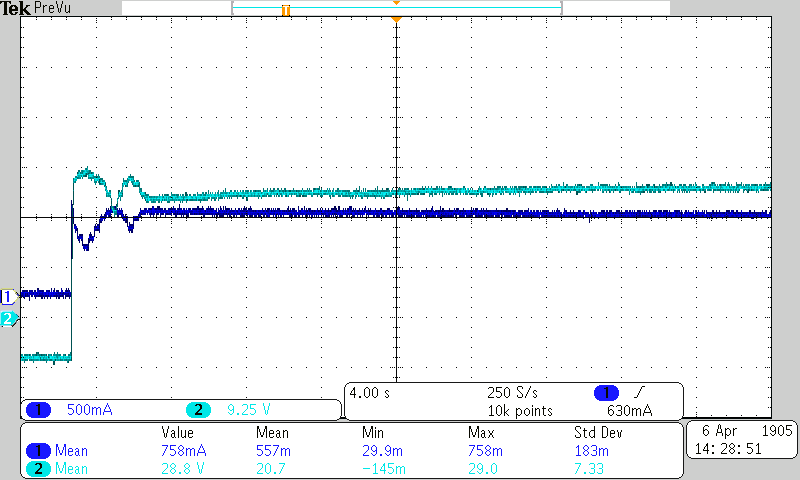
Test/Pictures/Transients/tek00002.tif
