NicolaiFransen/Semester-Project-PED1/Test/Thermal/Pictures/FLIR0110.jpg

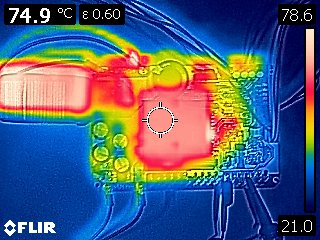
Test/Thermal/Pictures/FLIR0110.jpg
