NicolaiFransen/Semester-Project-PED1/Test/Thermal/Pictures/FLIR0111.jpg

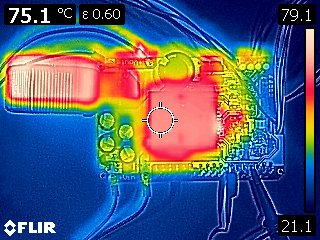
Test/Thermal/Pictures/FLIR0111.jpg
