NicolaiFransen/Semester-Project-PED1/Test/Thermal/Pictures/FLIR0112.jpg

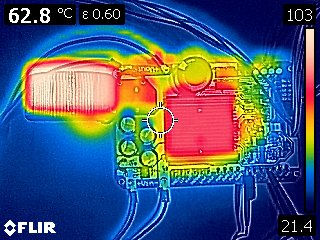
Test/Thermal/Pictures/FLIR0112.jpg
