NicolaiFransen/Semester-Project-PED1/Test/Thermal/Pictures/FLIR0113.jpg

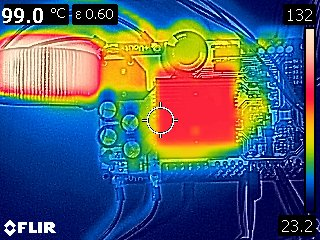
Test/Thermal/Pictures/FLIR0113.jpg
