NicolaiFransen/Semester-Project-PED1/Test/Thermal/Pictures/FLIR0114.jpg

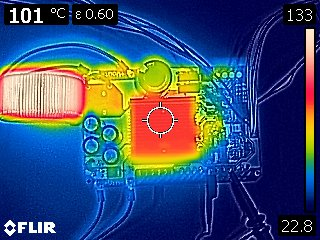
Test/Thermal/Pictures/FLIR0114.jpg
