NicolaiFransen/Semester-Project-PED1/Test/Thermal/Pictures/FLIR0115.jpg

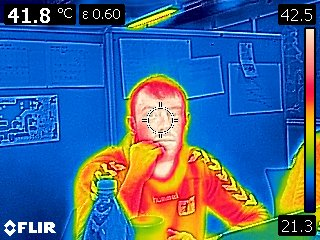
Test/Thermal/Pictures/FLIR0115.jpg
