NicolaiFransen/Semester-Project-PED1/Others/EXAMS PED/Old Exam/more exams_lennart/High Voltage and Switch mode Converters/Lek 10 Pulse width modulated rectifiers/problem18_1.pdf

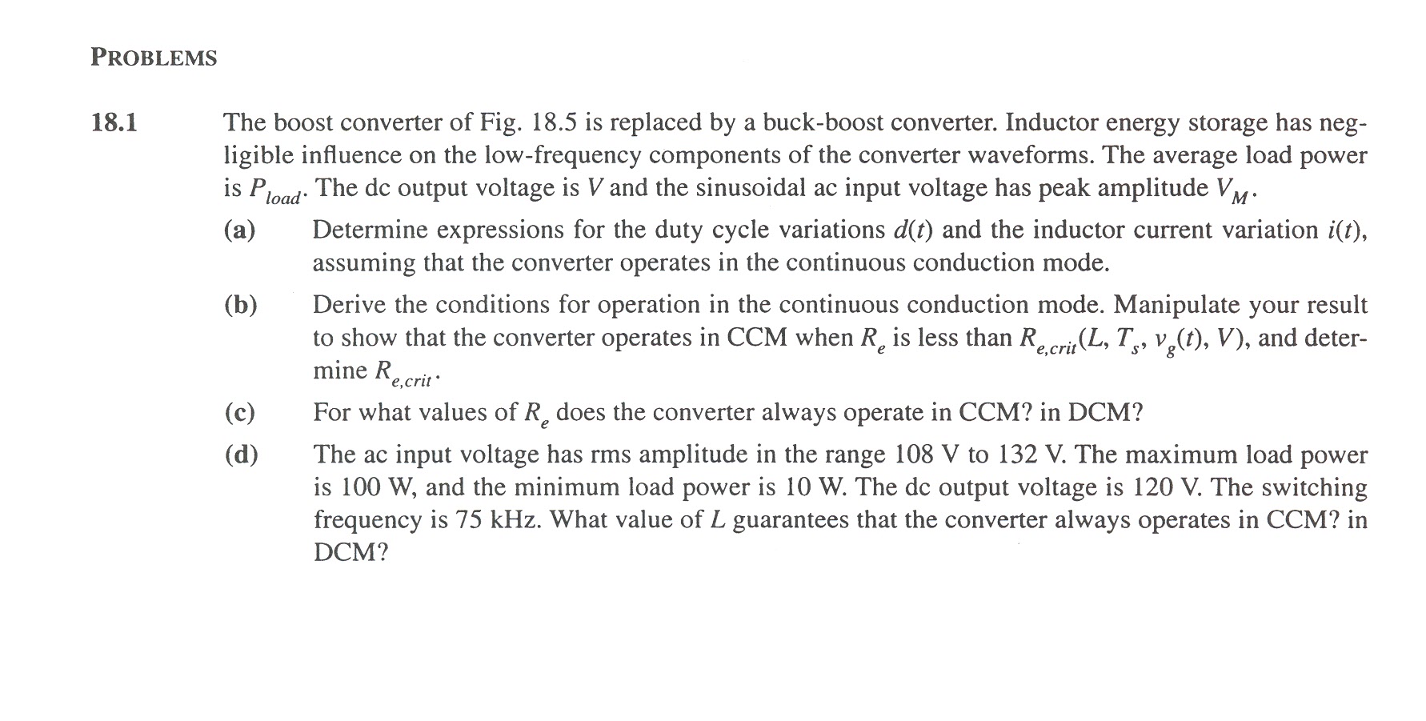
[picture p415: page 1]
