NicolaiFransen/Semester-Project-PED1/Others/EXAMS PED/Old Exam/more exams_lennart/High Voltage and Switch mode Converters/Lek 7 AC Equivalent Circuit Modeling/problem71.pdf

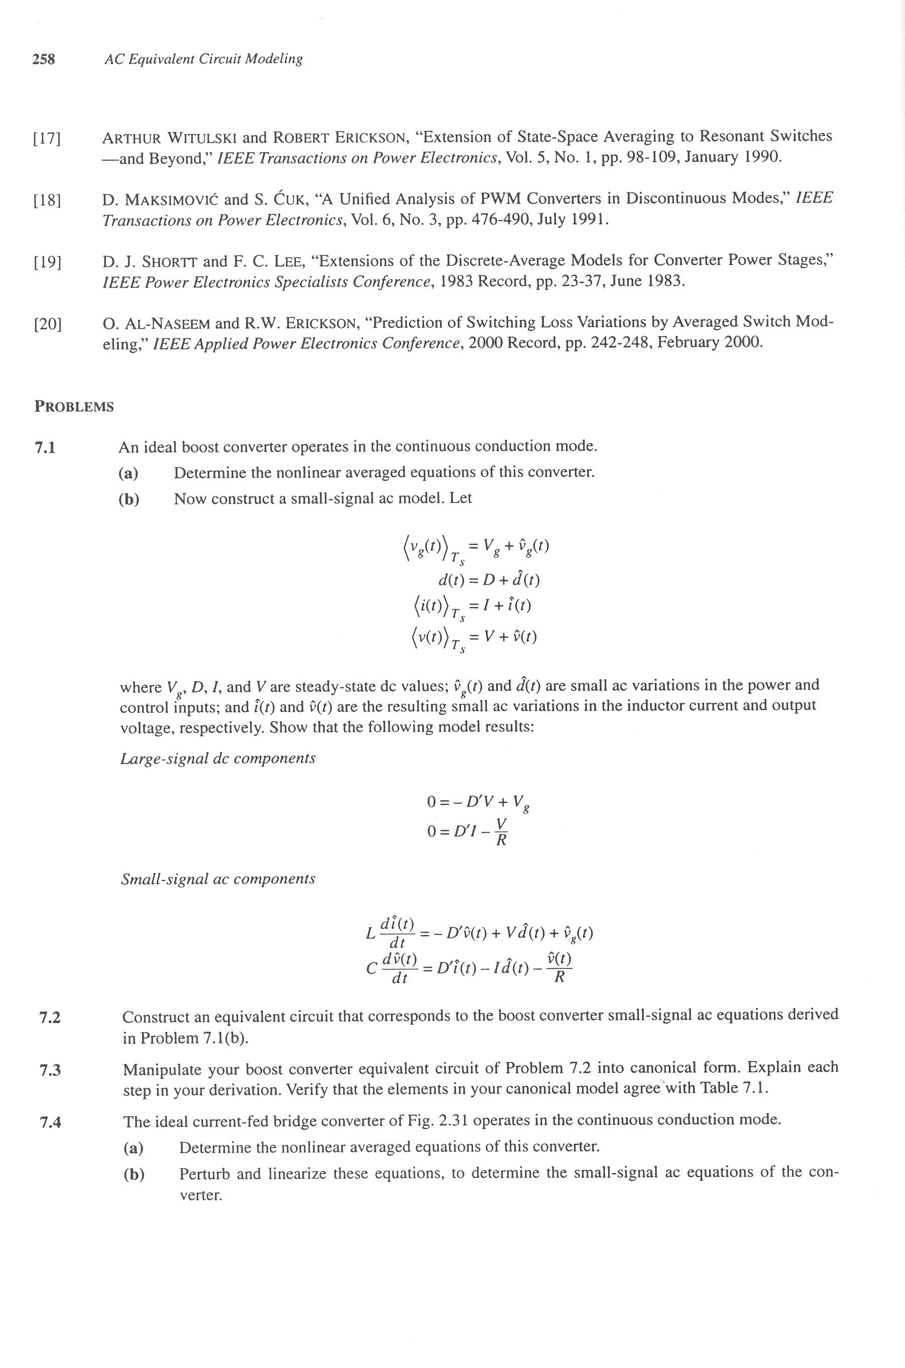
[picture p416: page 1]
