NicolaiFransen/Semester-Project-PED1/Others/EXAMS PED/HV/Exam 2015/2015 exam problem 4.jpg

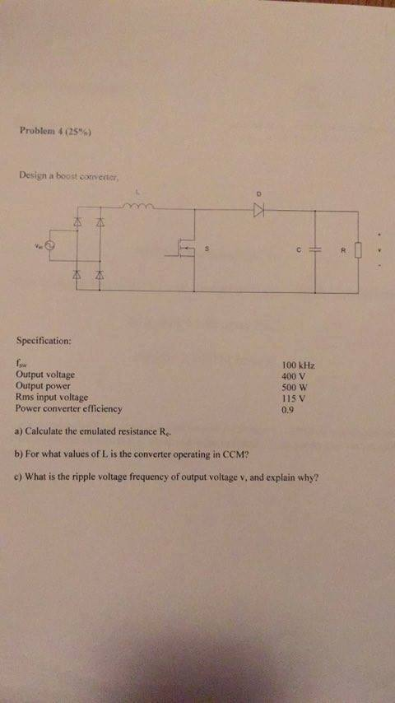
Others/EXAMS PED/HV/Exam 2015/2015 exam problem 4.jpg
