NicolaiFransen/Semester-Project-PED1/Schematic_PCB/MIC_760_V2/MIC_760_V2.pdf

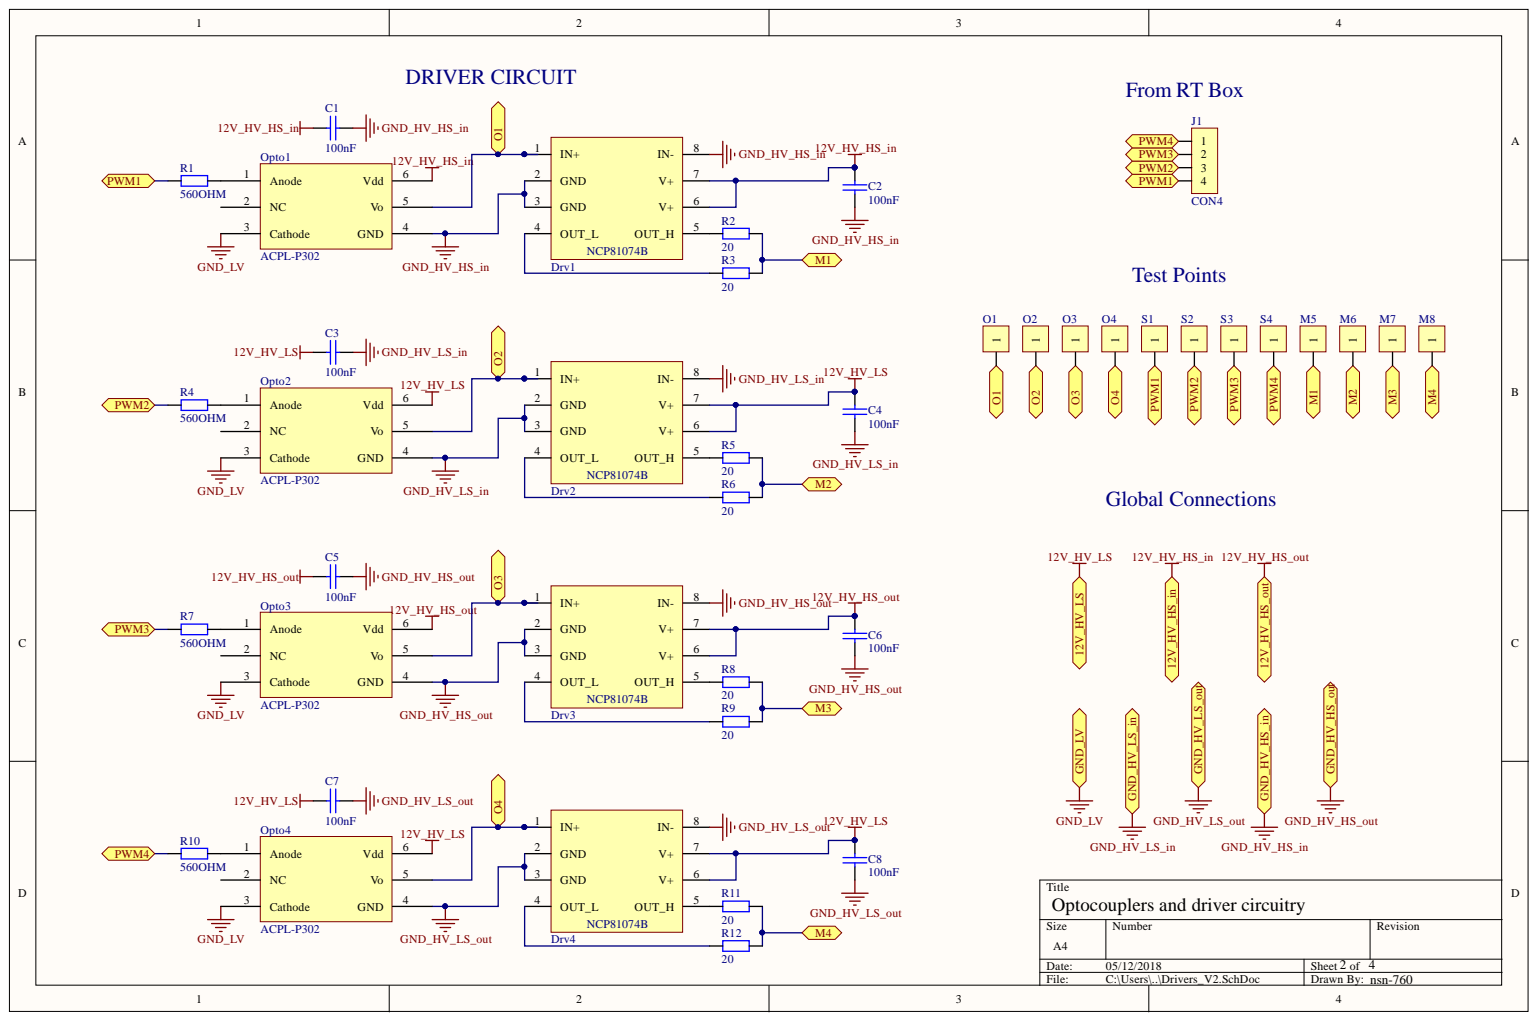
[picture p419: page 1]

NCP8 1 0 7 4 B

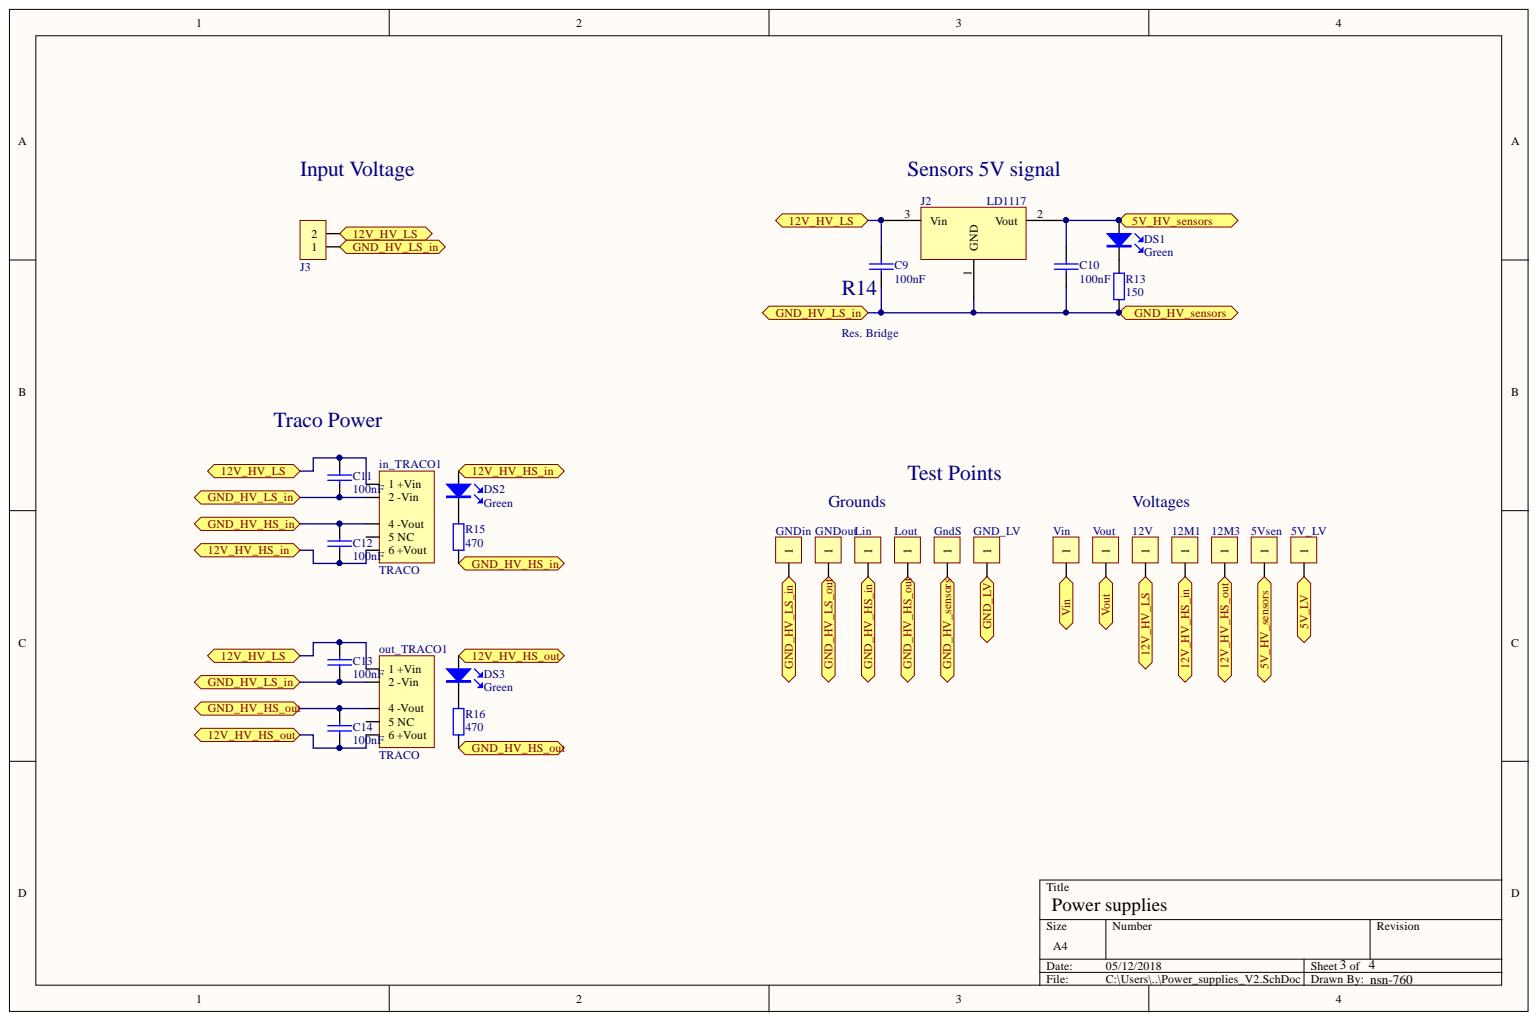
[picture p420: page 2]

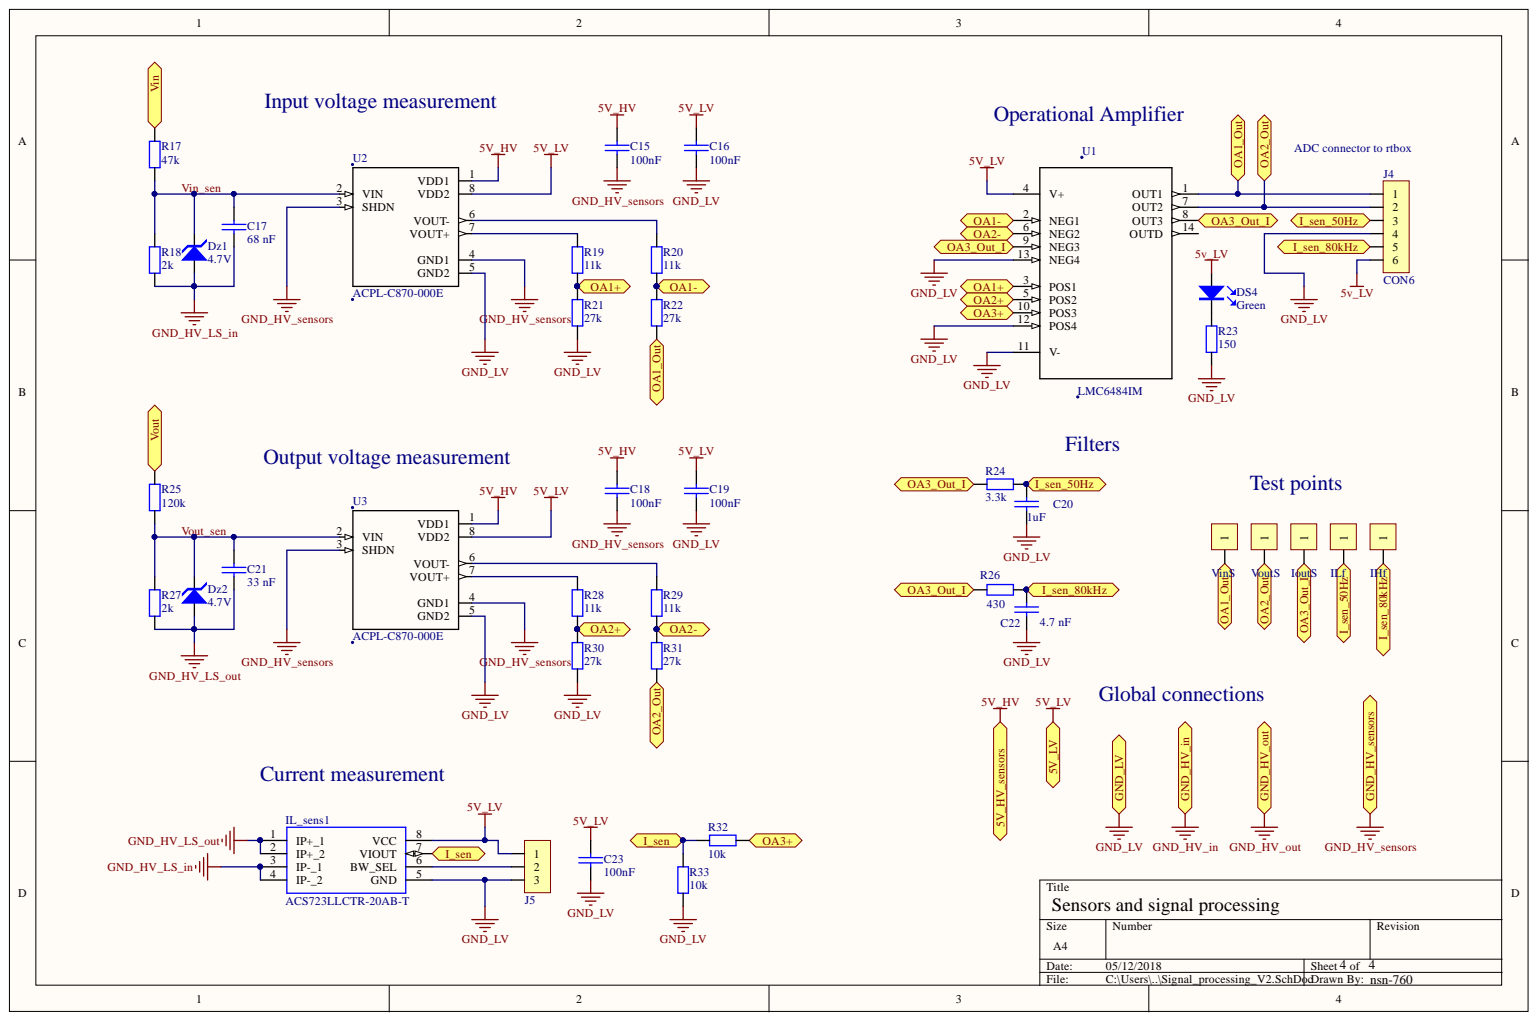
[picture p421: page 3]

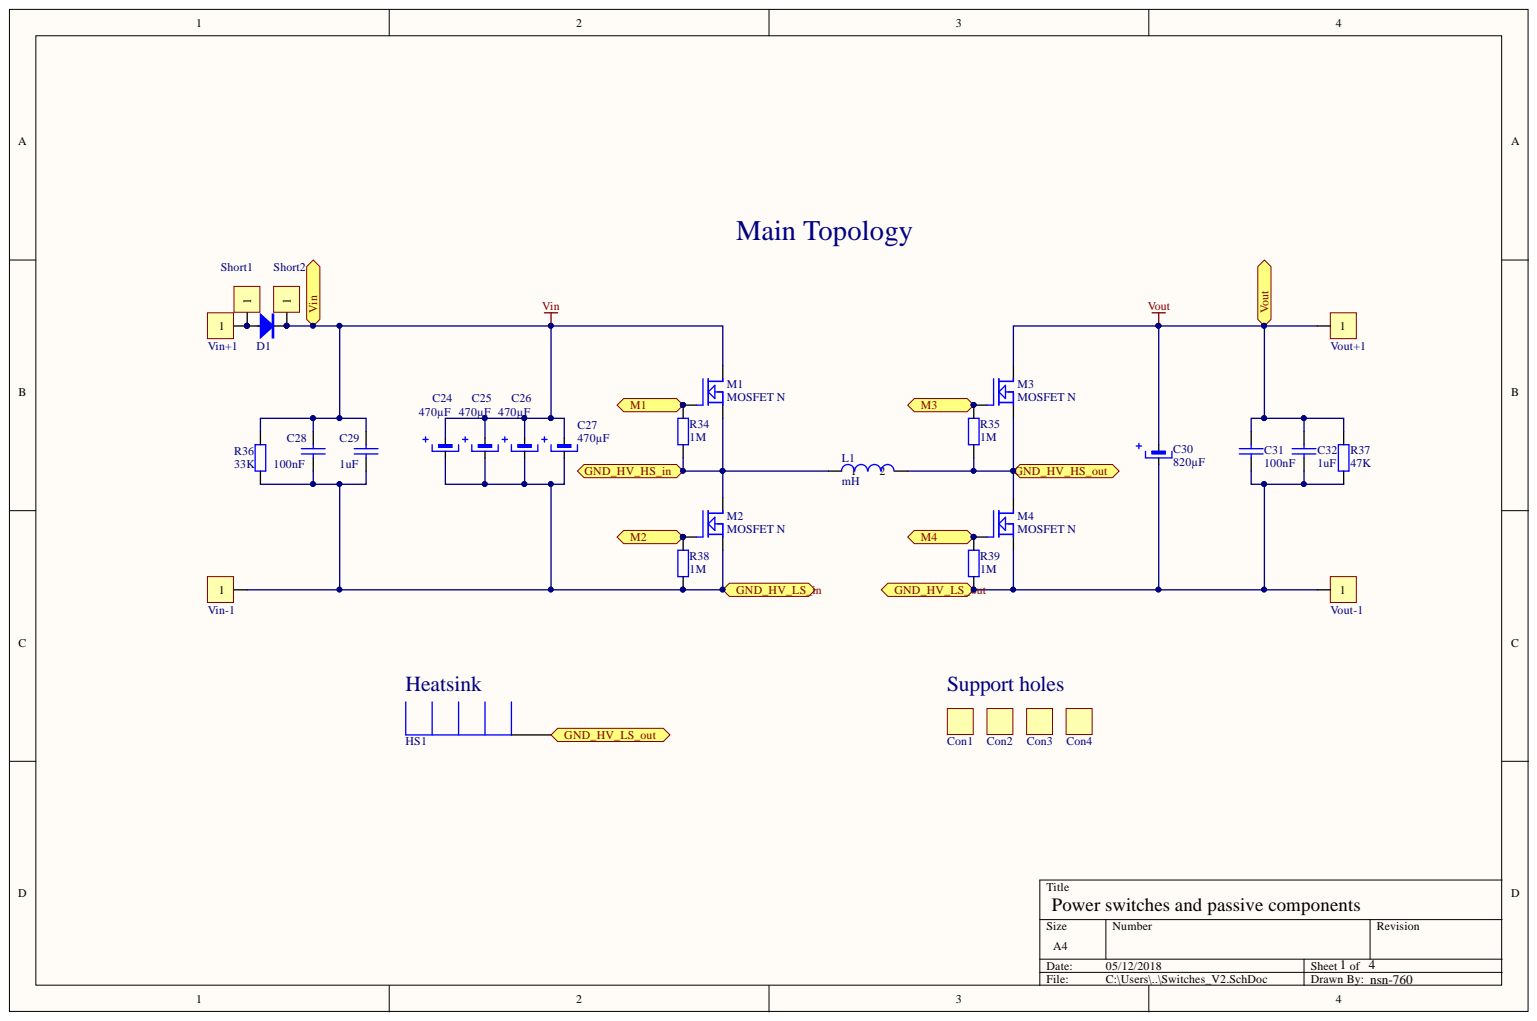
[picture p422: page 4]

Title
Power switches and passive components
