NicolaiFransen/Semester-Project-PED1/Schematic_PCB/MIC_760_V2/Monochrome/MIC_760_V2.pdf

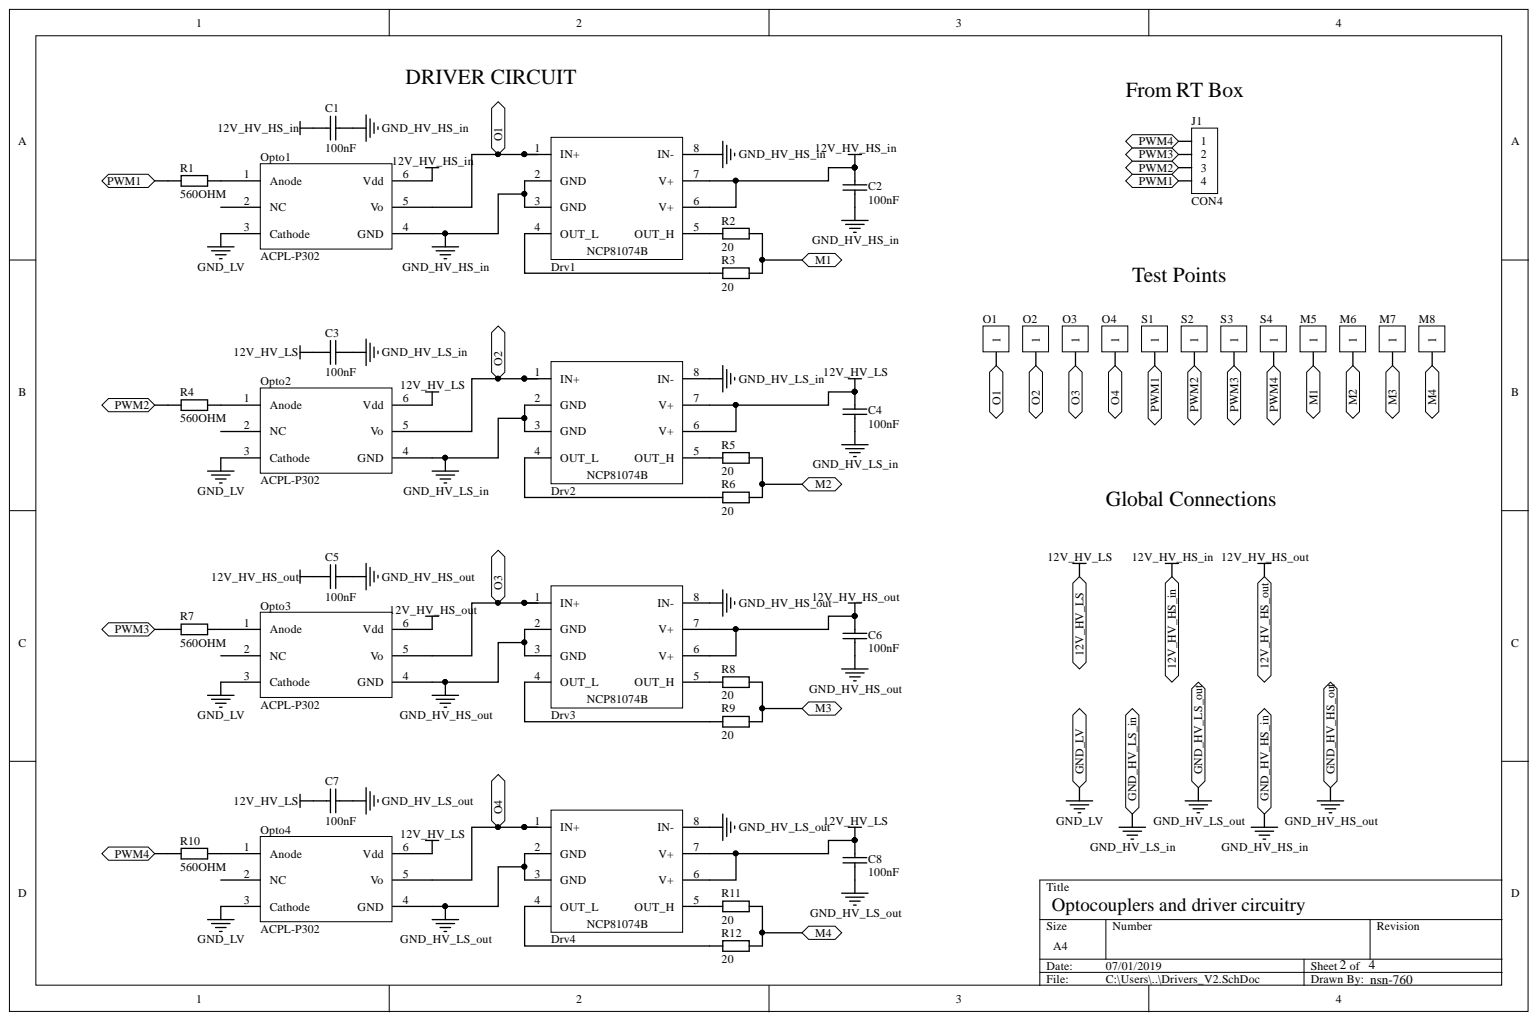
[picture p423: page 1]

NCP8 1 0 7 4 B

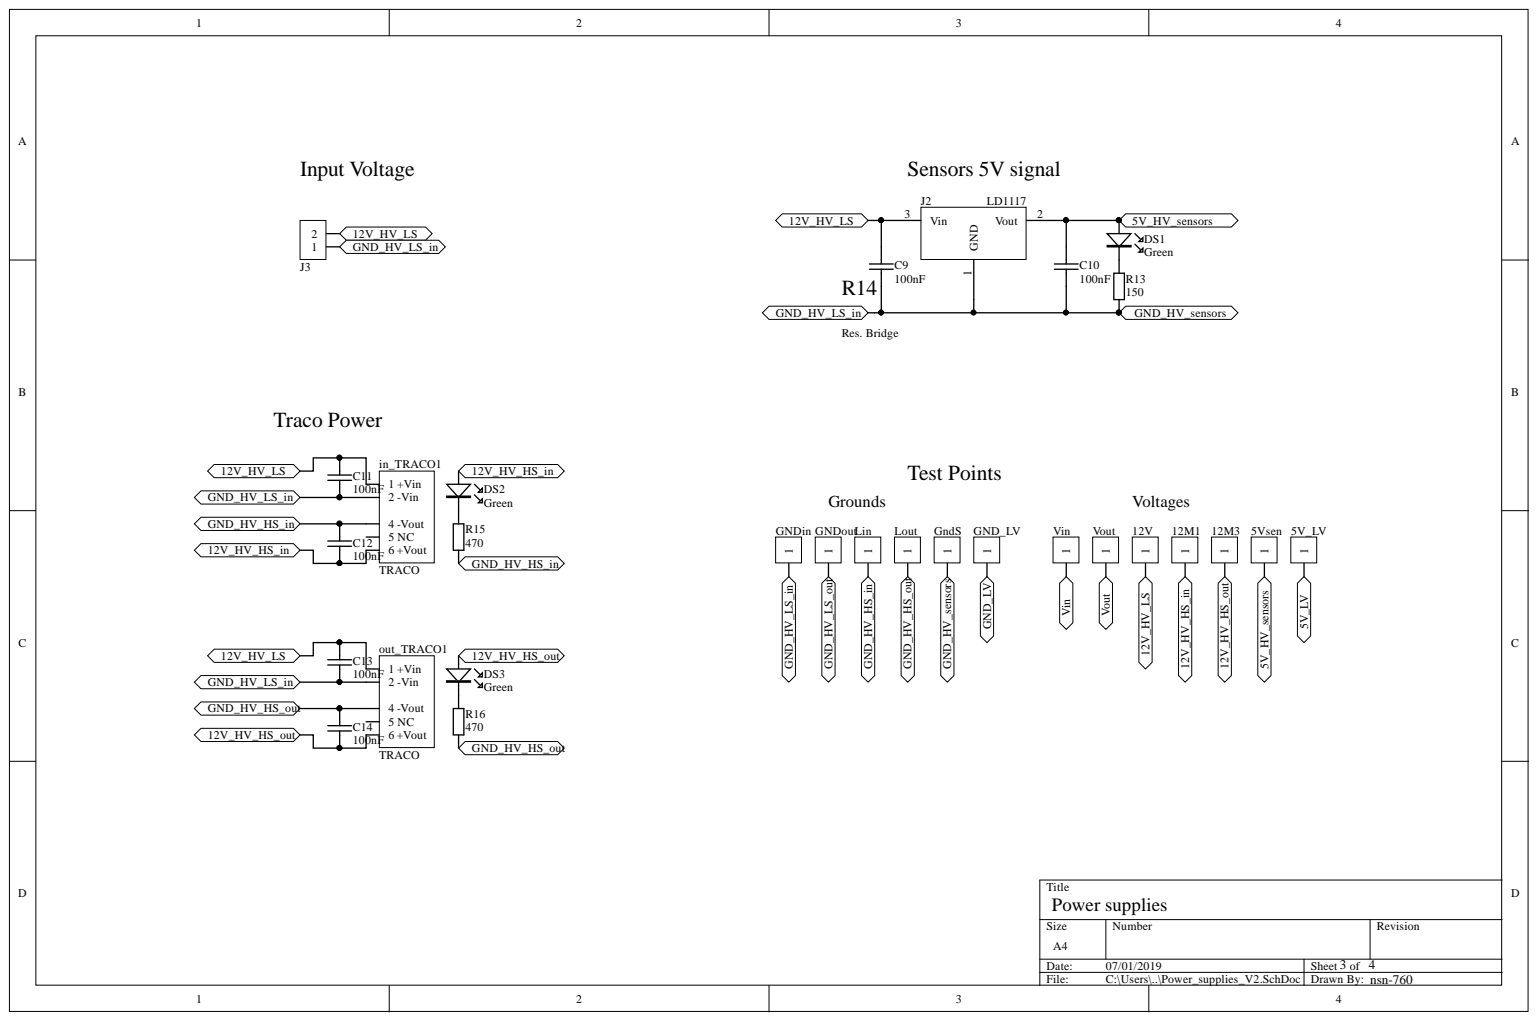
[picture p424: page 2]

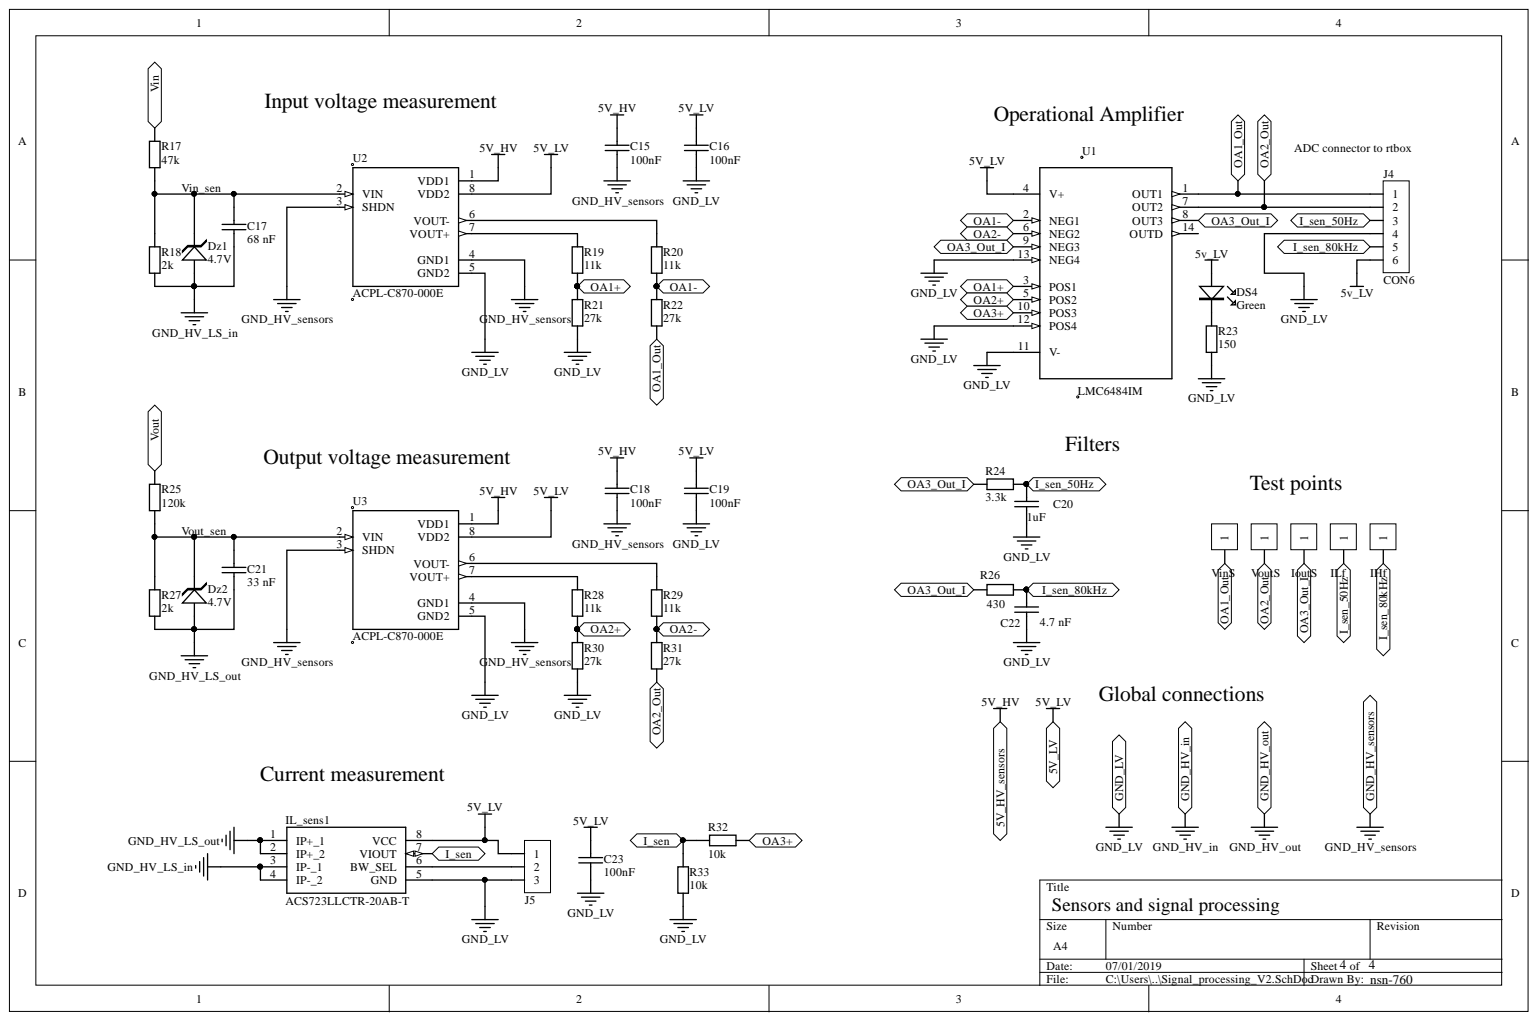
[picture p425: page 3]

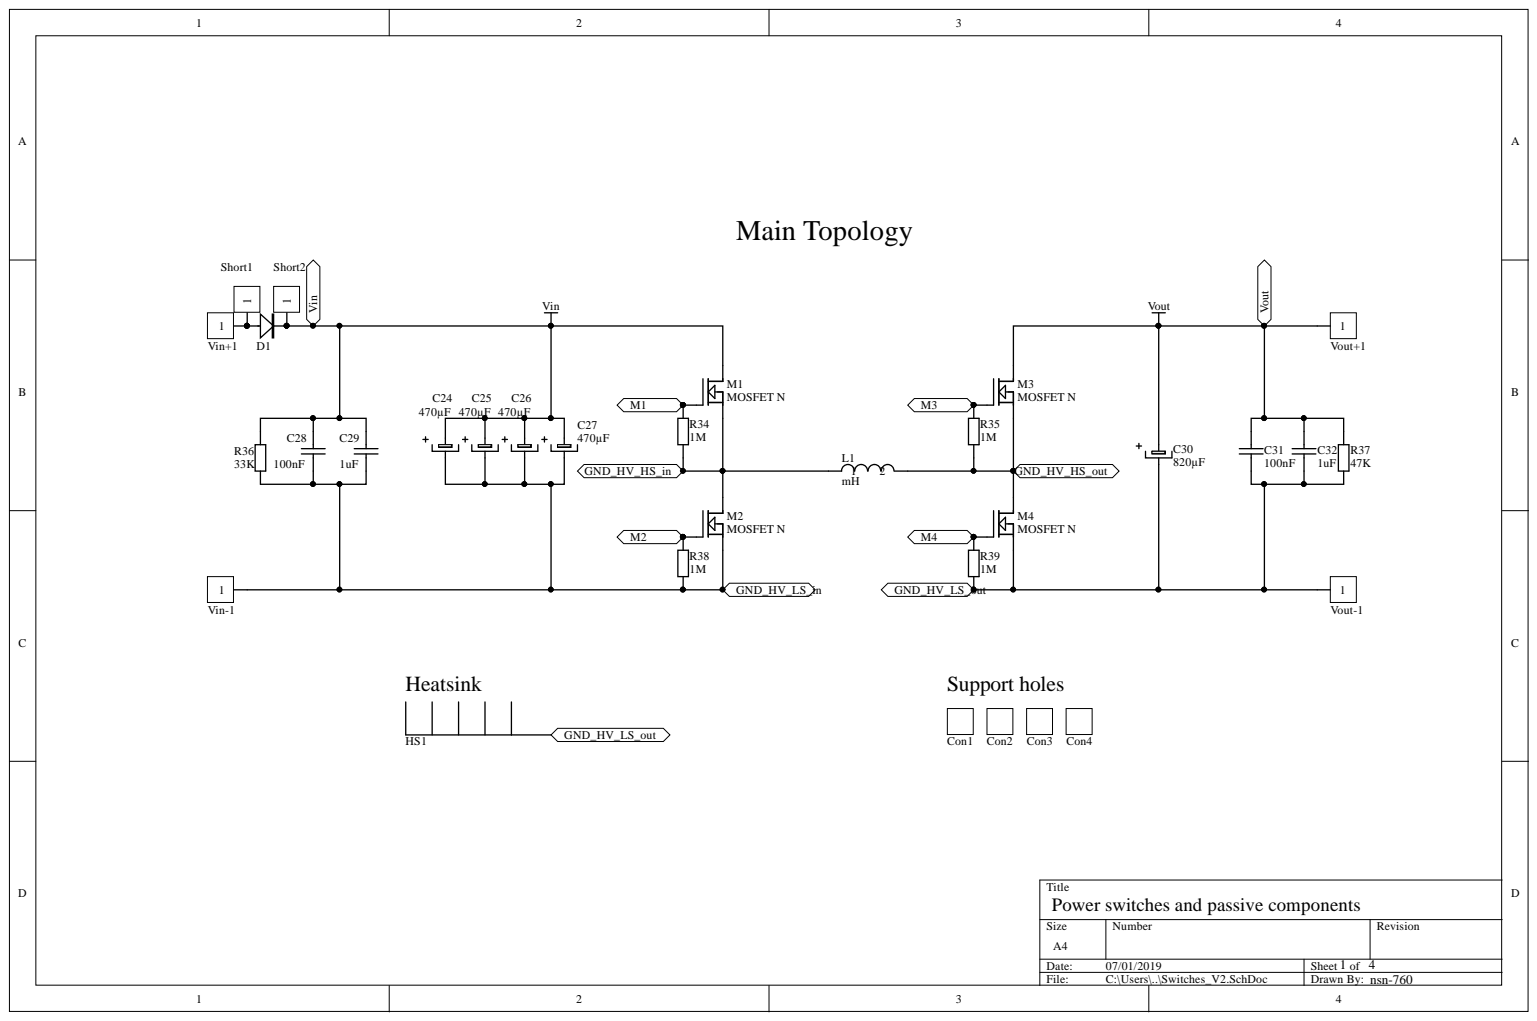
[picture p426: page 4]

Title
Power switches and passive components
