NicolaiFransen/Semester-Project-PED1/Reports/Pictures/P1/Schematics/Drivers.pdf

# DRIVER CIRCUIT From RT Box

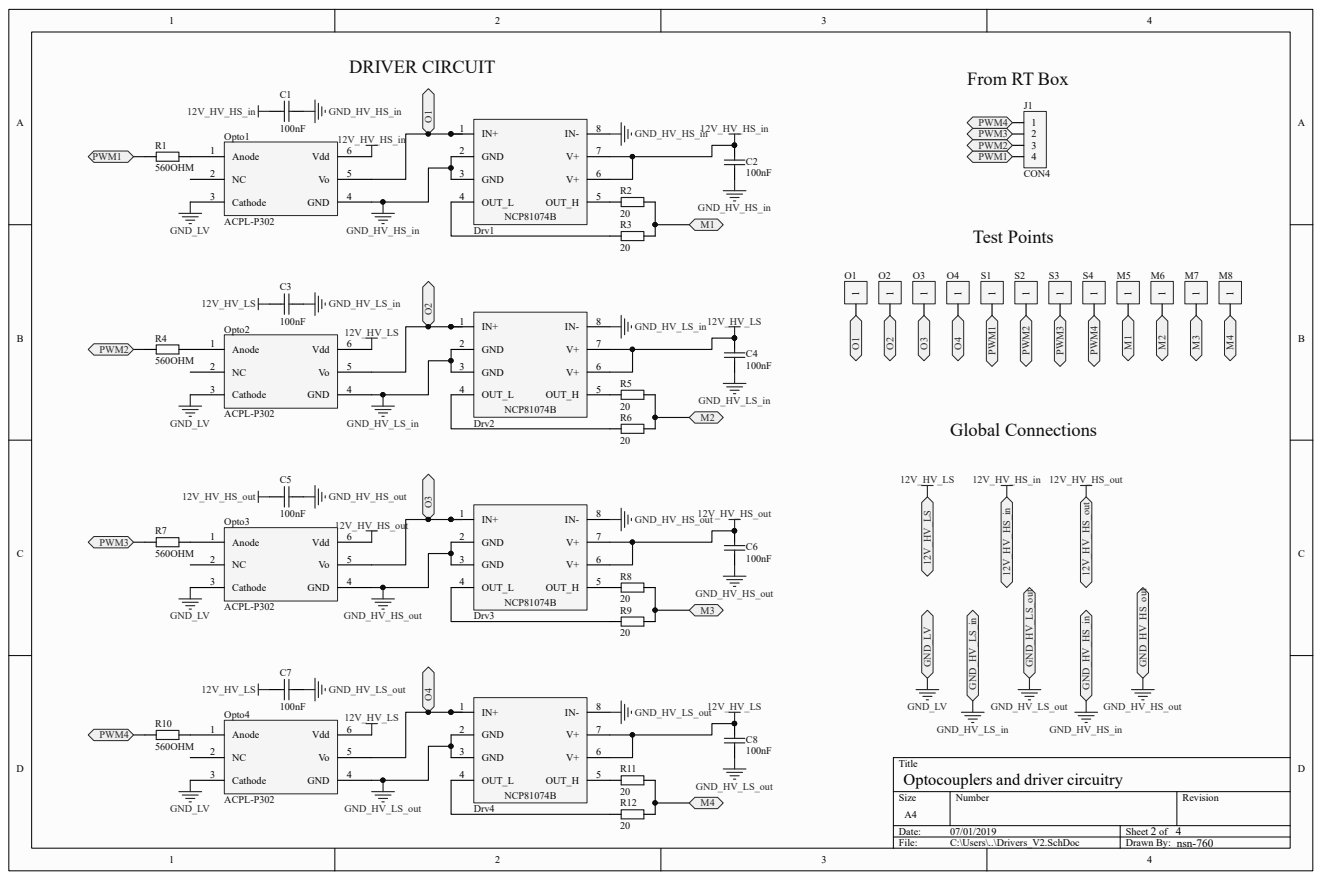
[picture p427: page 1]

Title
Optocouplers and driver circuitry
