NicolaiFransen/Semester-Project-PED1/Reports/Pictures/P1/Schematics/PowerCircuit.pdf

# Main Topology Vin

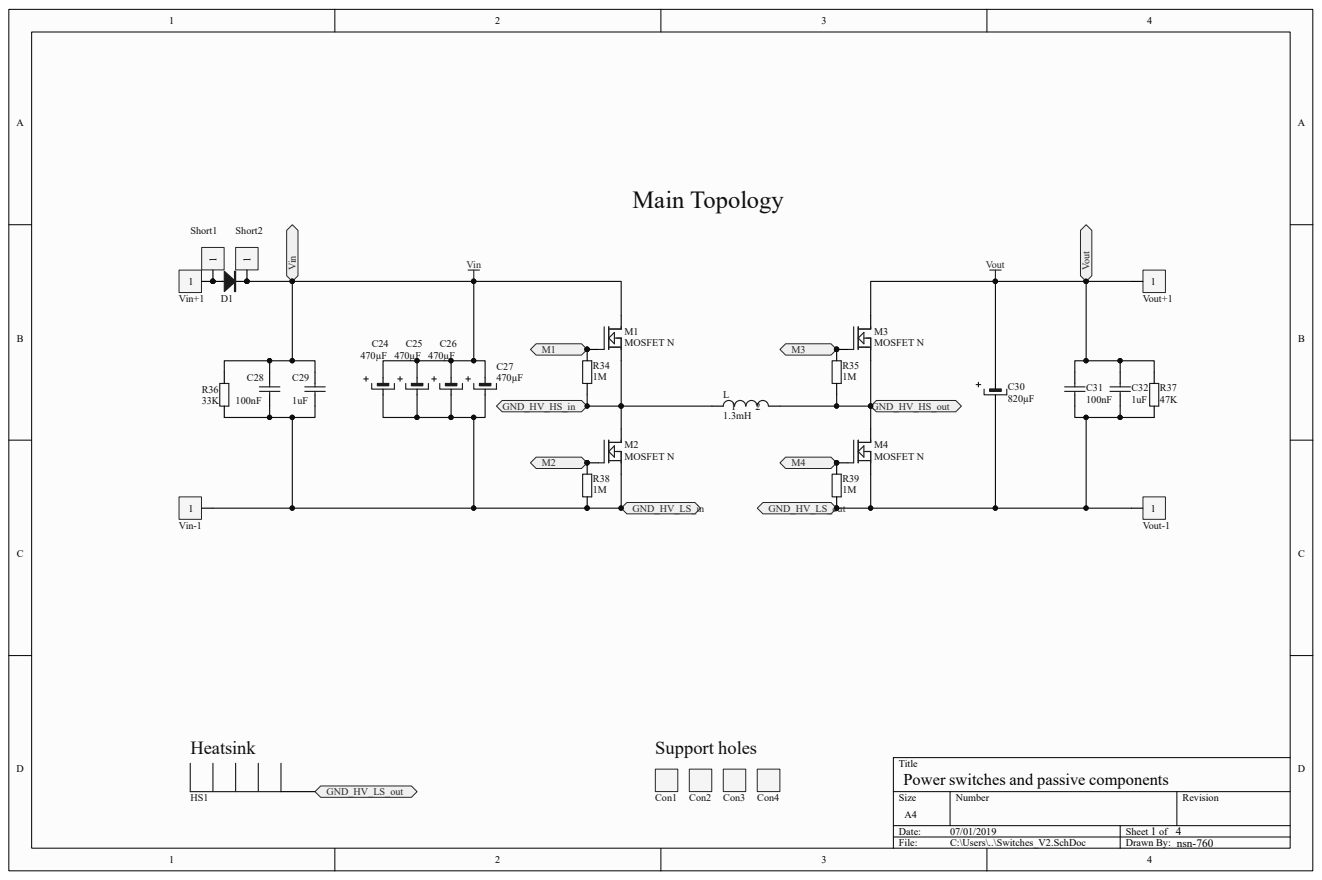
[picture p428: page 1]

Title
Power switches and passive components
