NicolaiFransen/Semester-Project-PED1/Reports/Pictures/P1/Flow_chart/2018_11_15_Flow_chart_MPPT_Buck-Boost_converter.pdf

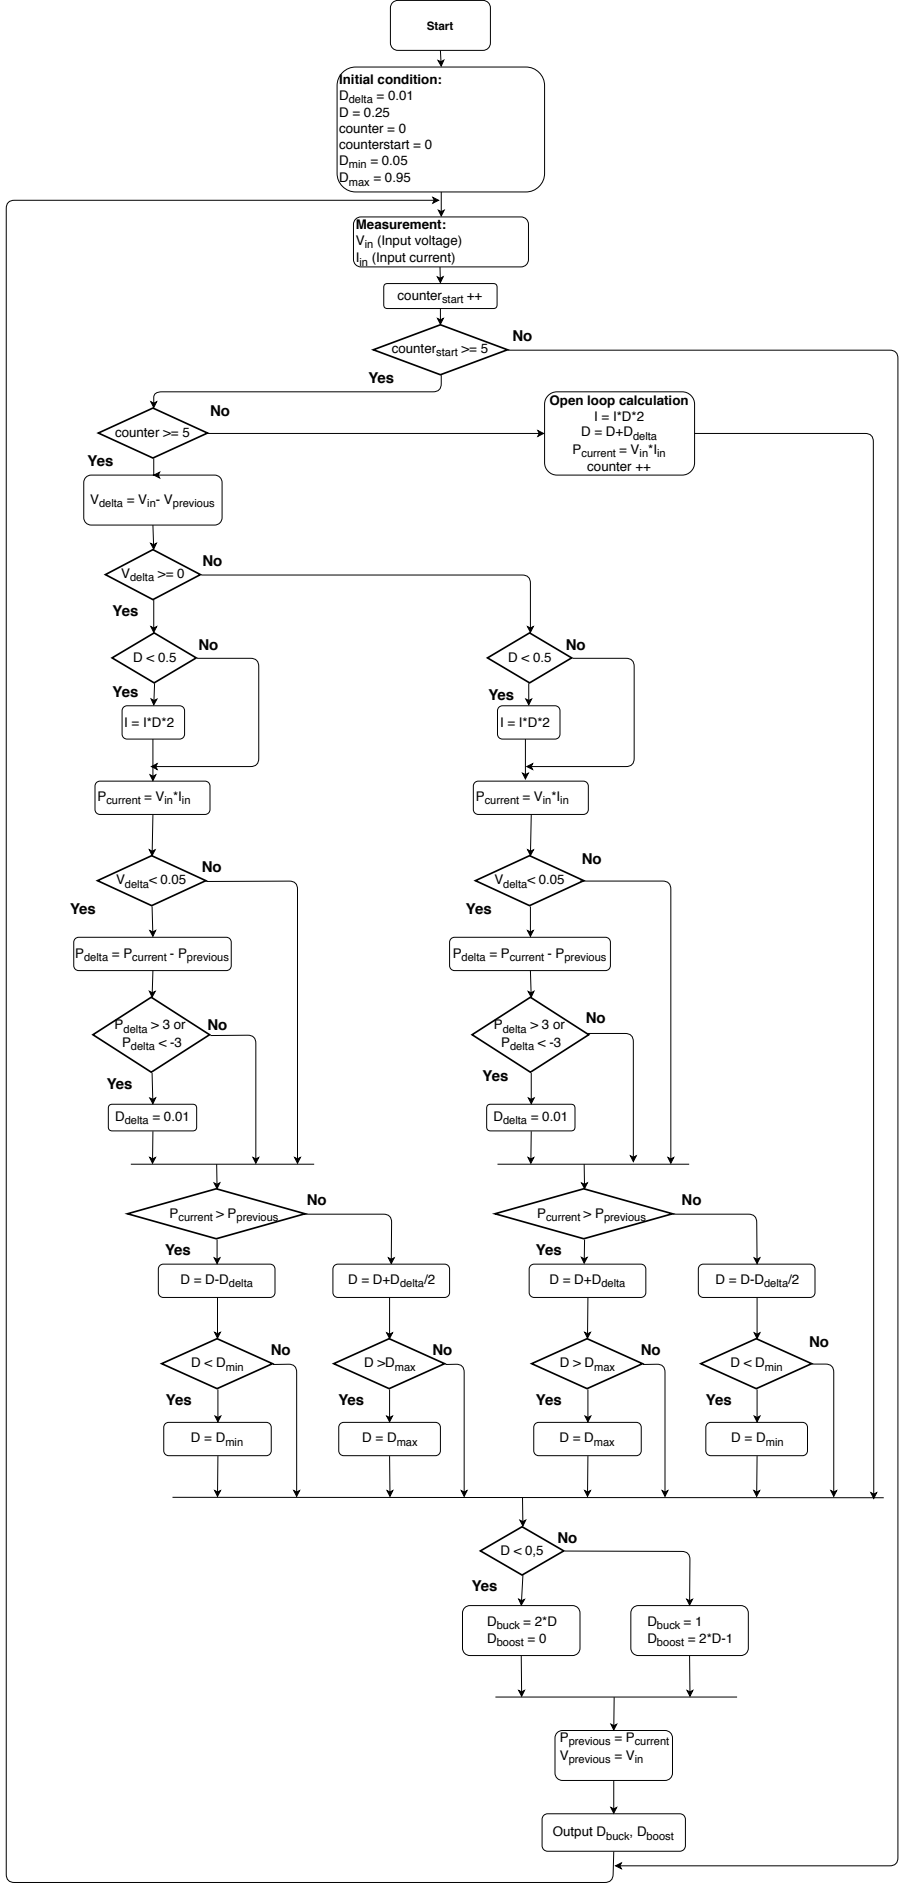
[picture p429: page 1]
Start; Initial condition: Ddelta; = 0.01 D = 0.25 counter = 0 counterstart = 0 Dmin; Dmax; Measurement: Vin; (Input voltage); (Input current); counter >= 5; I = I*D*2 D = D+Ddelta; Pcurrent = Vin; *Iin counter ++; Vdelta; = Vin; - Vprevious; D = D-Ddelta D = D+Ddelta; Yes; Pprevious; = Pcurrent; Vprevious; Output Dbuck; , Dboost; Dbuck = 2*D; Dboost; Dbuck = 1; counterstart ++; Pcurrent > Pprevious; Vdelta< 0.05; Pdelta; - Pprevious; *Iin; Ddelta; D > Dmax; D < Dmin; D = Dmax; D = Dmin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

Open loop calculation
