NicolaiFransen/Semester-Project-PED1/Simulations/PLECS_PV_panelmodel/Flow_chart/2018_11_29_FINITE_STATE_MACHINE.pdf

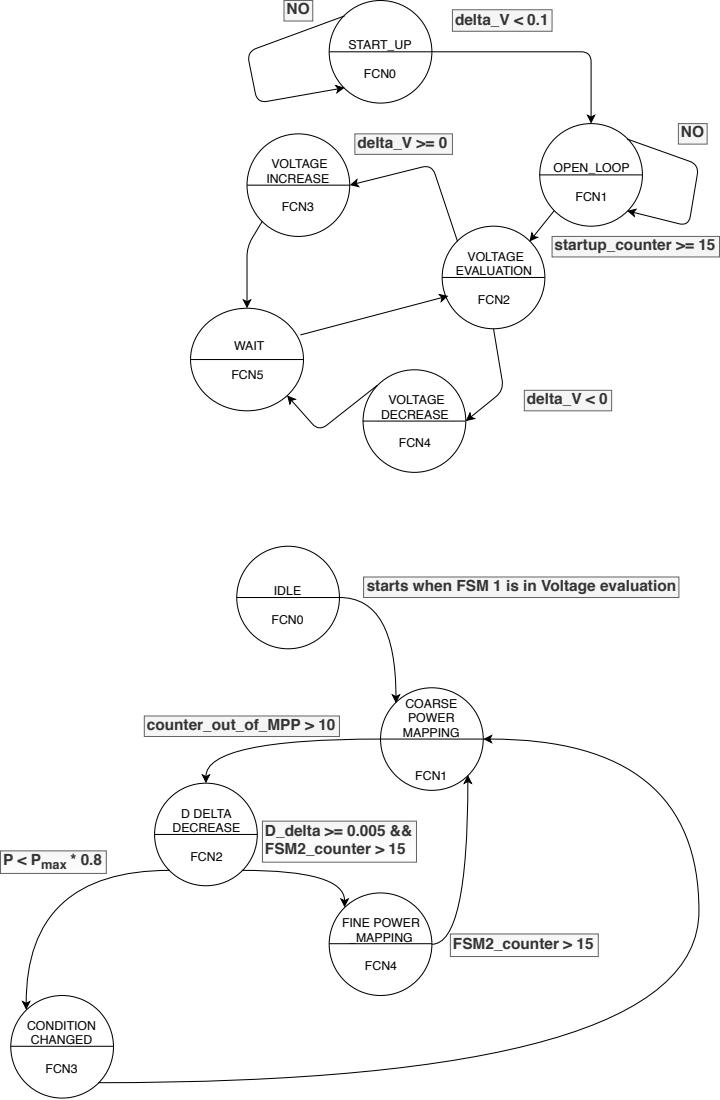
[picture p430: page 1]
START_UP; FCN0; OPEN_LOOP; FCN1; VOLTAGE EVALUATION; FCN2; VOLTAGE INCREASE; FCN3; VOLTAGE DECREASE; FCN4; WAIT; FCN5; IDLE; COARSE POWER MAPPING; D DELTA DECREASE; counter_out_of_MPP > 10; CONDITION CHANGED; P < Pmax * 0.8; FINE POWER _MAPPING; D_delta >= 0.005 && FSM2_counter > 15; FSM2_counter > 15; delta_V < 0.1 NO; startup_counter >= 15; delta_V < 0; delta_V >= 0

starts when FSM 1 is in Voltage evaluation
