NicolaiFransen/Semester-Project-PED1/Simulations/PLECS_PV_panelmodel/Flow_chart/2018_11_12_Flow_chart_MPPT_Buck-Boost_converter.pdf

No

## Yes

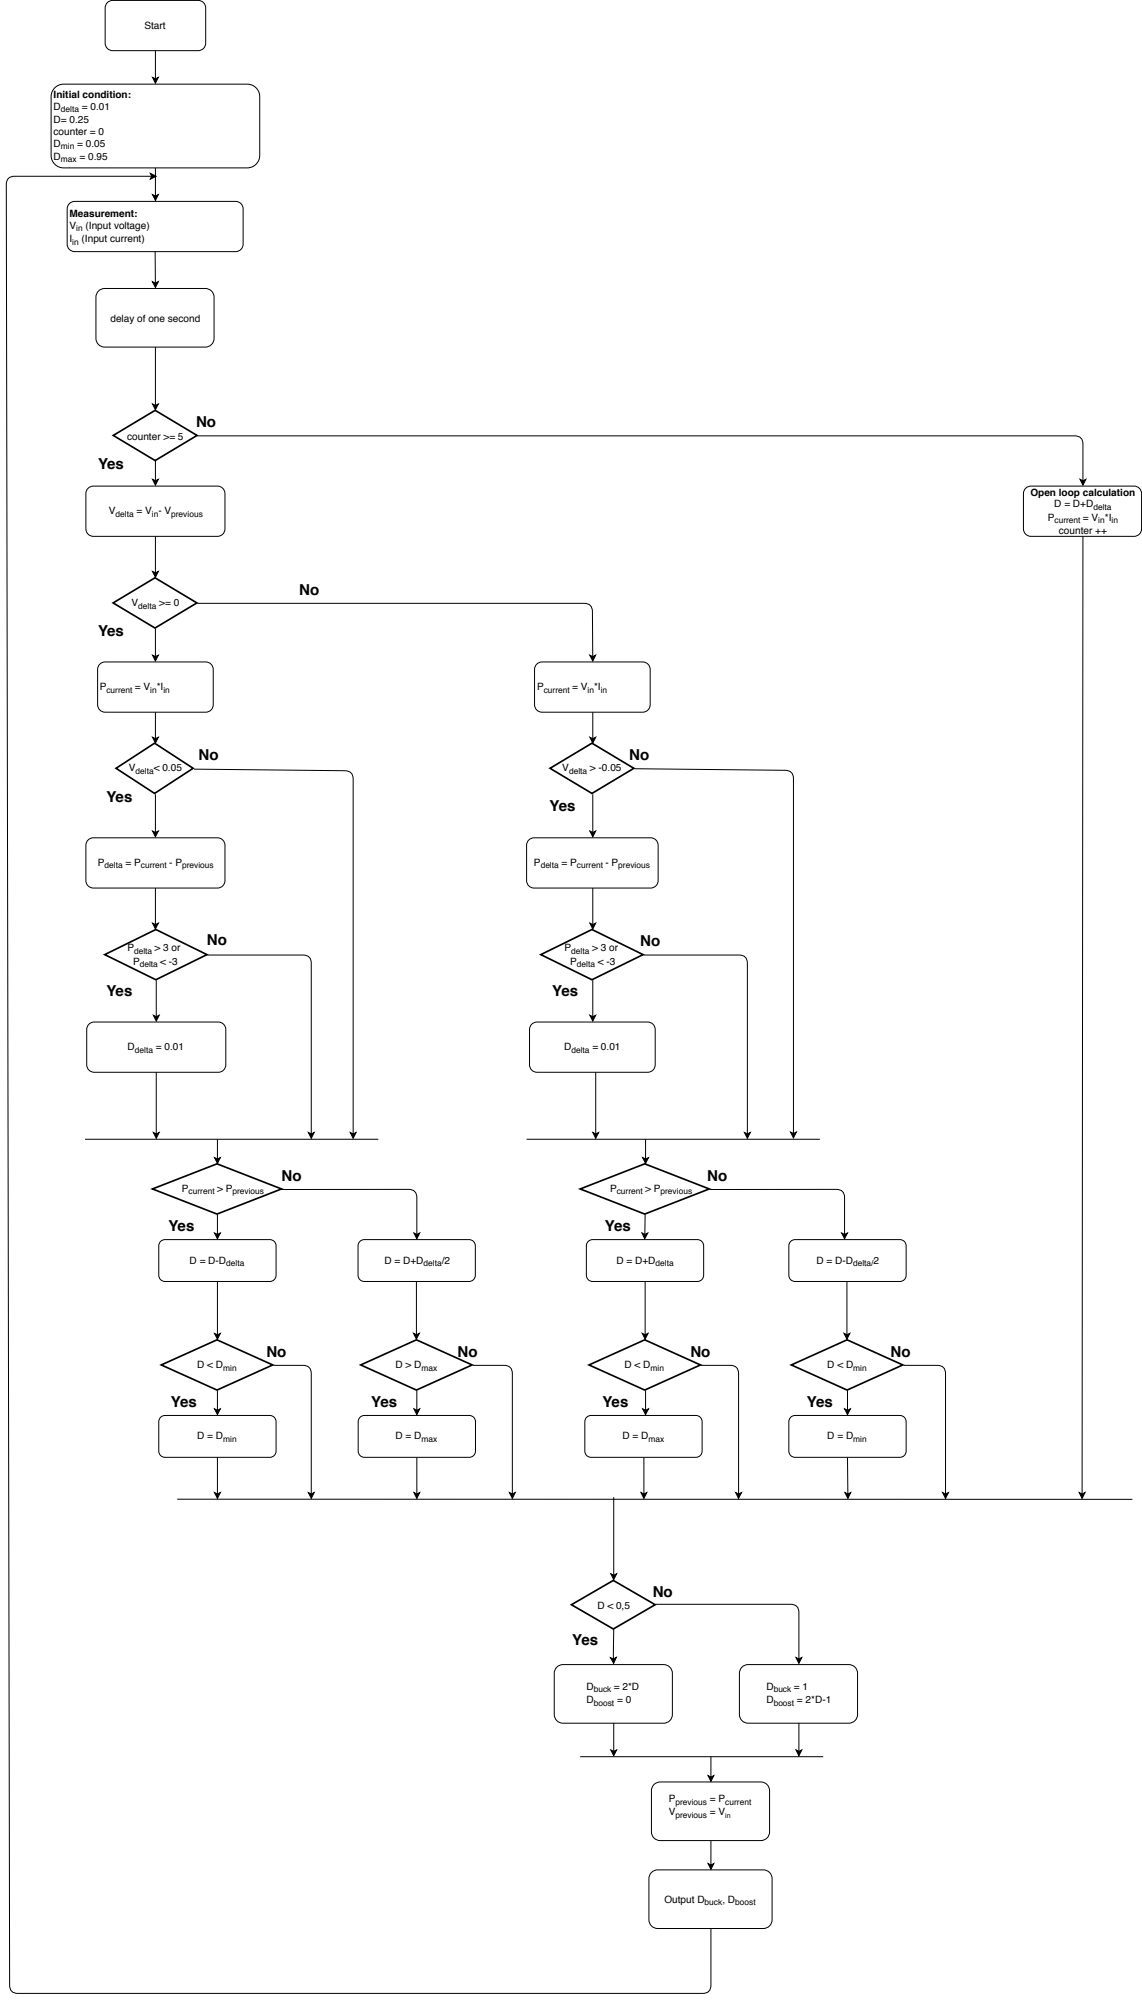
[picture p432: page 1]
Start; Initial condition: Ddelta = 0.01 D= 0.25 counter = 0 Dmin = 0.05 Dmax = 0.95; Pcurrent > Pprevious; D = D-Ddelta; Yes; D = D+Ddelta/2; Measurement: Vin (Input voltage) I; counter >= 5; Vdelta >= 0; D = D+Ddelta; D = D-Ddelta/2; Pprevious = Pcurrent; Vprevious = Vin; Dbuck = 2*D; Dboost = 0; Dbuck = 1 Dboost = 2*D-1; Vdelta< 0.05; Vdelta > -0.05; Pdelta > 3 or; Pdelta < -3; Ddelta = 0.01; D < Dmin; D > Dmax; D = Dmin; D = Dmax

in (Input current)

delay of one second

Open loop calculation
D = D+Ddelta
Pcurrent = Vin*Iin
counter ++

Vdelta = Vin- Vprevious

Pdelta = Pcurrent - Pprevious

Output Dbuck, Dboost
