NicolaiFransen/Semester-Project-PED1/Simulations/PLECS_PV_panelmodel/Flow_chart/2018_11_10_Flow_chart_MPPT_Buck-Boost_converter.pdf

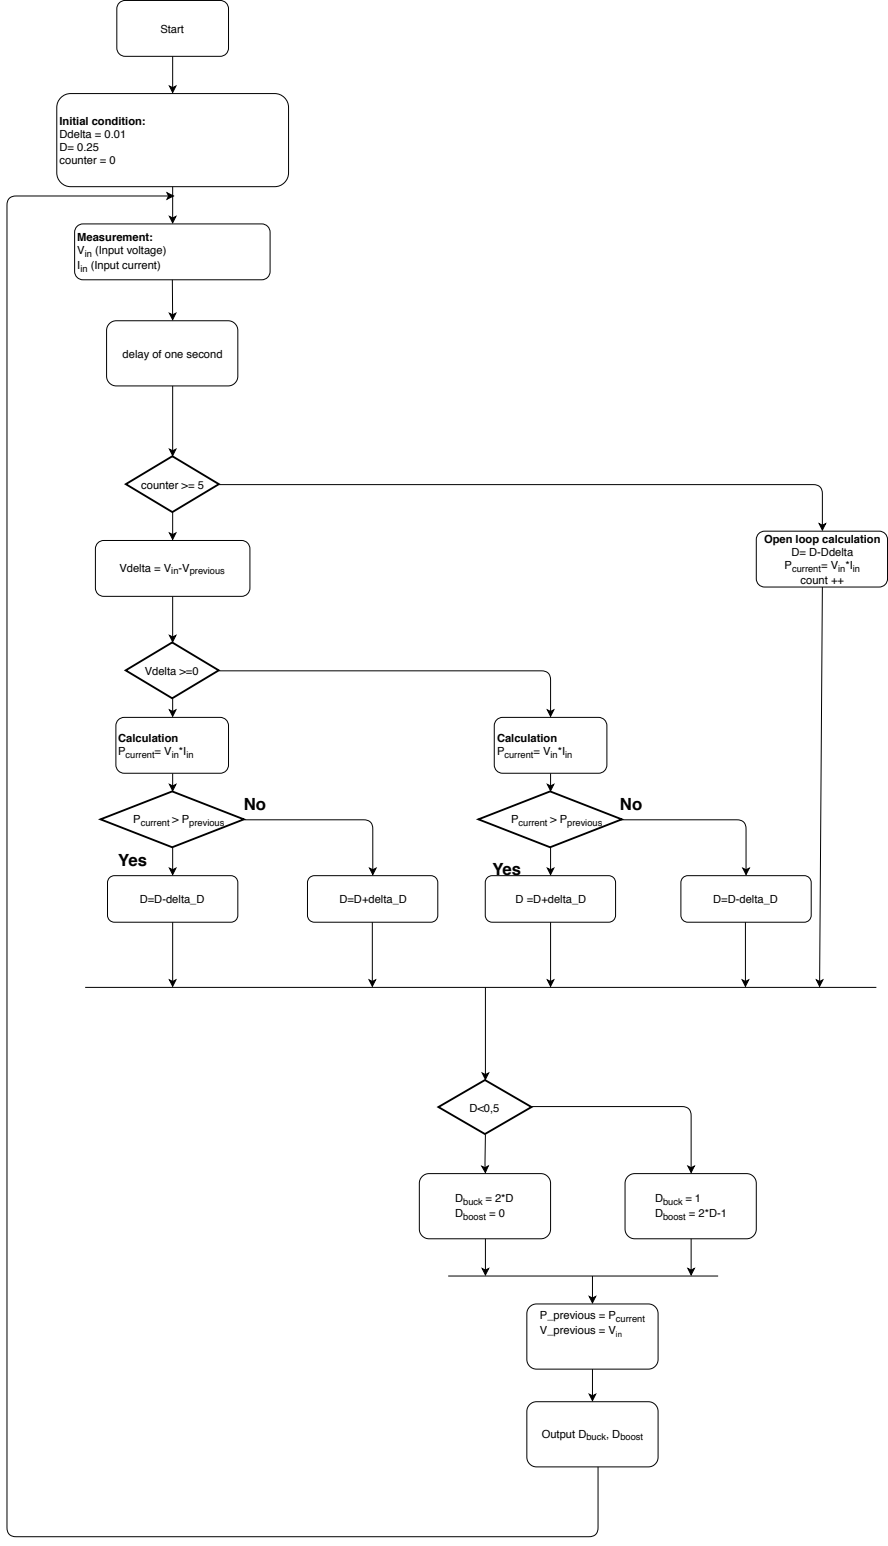
[picture p433: page 1]
Start; Initial condition: Ddelta = 0.01 D= 0.25 counter = 0; Pcurrent > Pprevious; D=D-delta_D; Yes; D=D+delta_D; Measurement: Vin (Input voltage) I; counter >= 5; Vdelta >=0; D =D+delta_D; P_previous = Pcurrent V_previous = Vin; Dbuck = 2*D; Dboost = 0; Dbuck = 1 Dboost = 2*D-1

in (Input current)

delay of one second

Open loop calculation
D= D-Ddelta
Pcurrent= Vin*Iin
count ++

Vdelta = Vin-Vprevious

Calculation

Output Dbuck, Dboost
