NicolaiFransen/Semester-Project-PED1/Simulations/PLECS_PV_panelmodel/Flow_chart/2018_11_04_Flow_chart_MPPT_Buck-converter.pdf

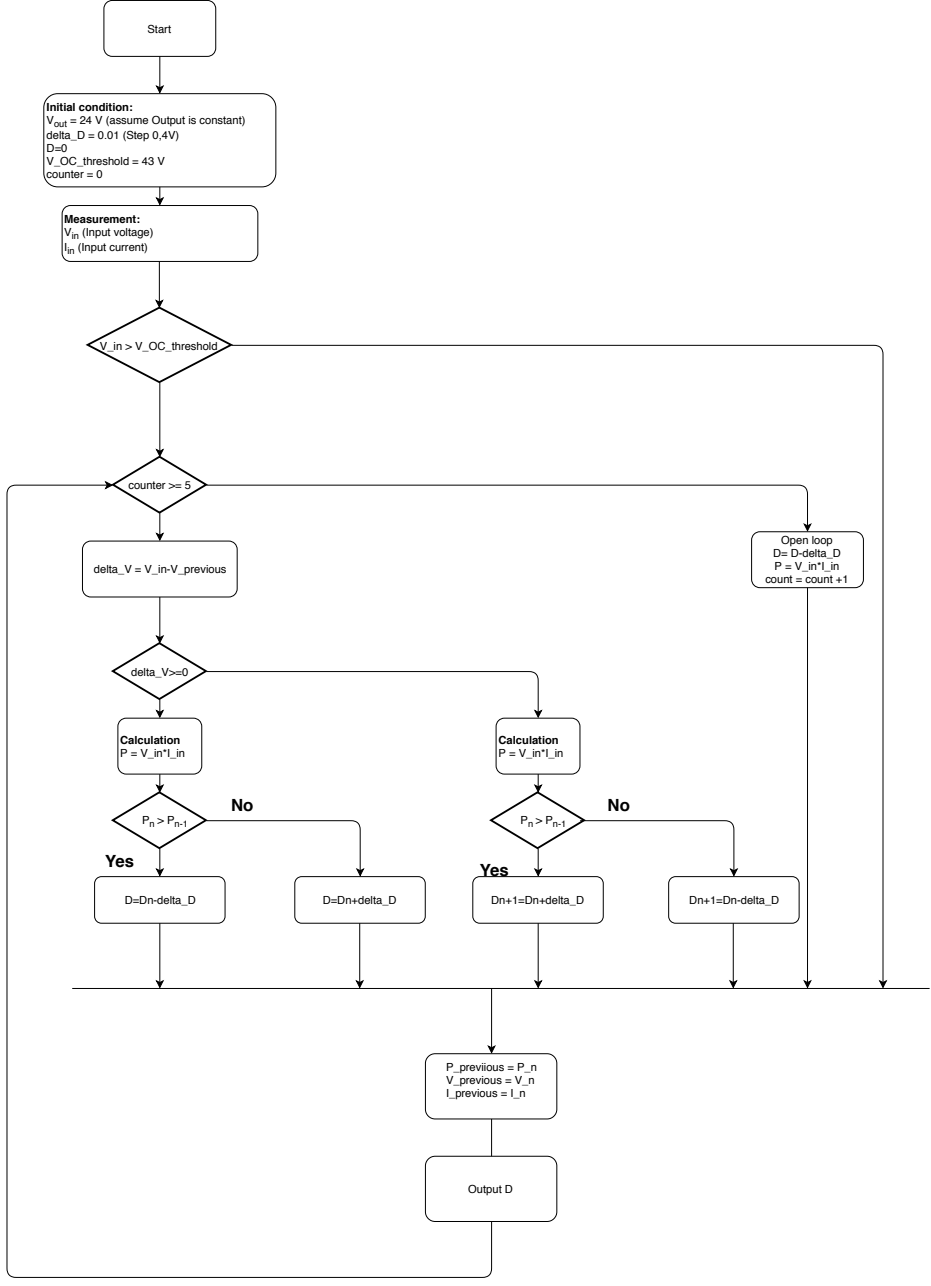
[picture p434: page 1]
Start; D=Dn-delta_D; Yes; D=Dn+delta_D; Measurement: Vin (Input voltage) I; V_in > V_OC_threshold; counter >= 5; Open loop D= D-delta_D P = V_in*I_in count = count +1; delta_V>=0; delta_V = V_in-V_previous; Calculation P = V_in*I_in; Dn+1=Dn+delta_D; Dn+1=Dn-delta_D; P_previious = P_n V_previous = V_n I_previous = I_n; Output D

Initial condition:
Vout = 24 V (assume Output is constant)
delta_D = 0.01 (Step 0,4V)
V_OC_threshold = 43 V
counter = 0

in (Input current)
