NicolaiFransen/Semester-Project-PED1/Schematic_PCB/MIC_760_V2/PCB_BottomLayer.pdf

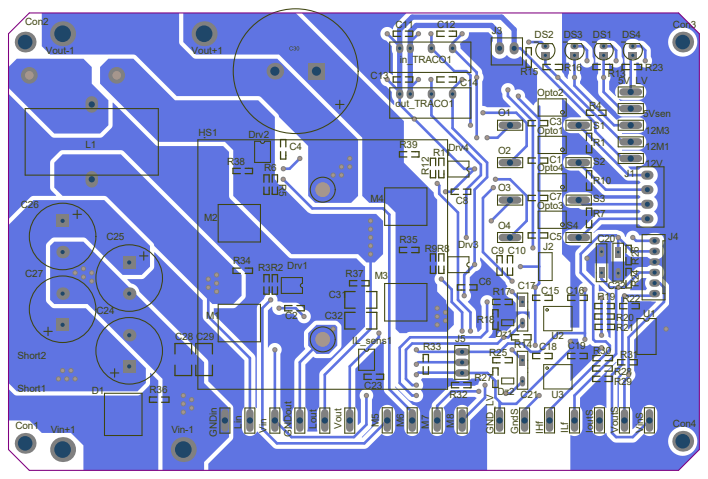
[picture p435: page 1]
