NicolaiFransen/Semester-Project-PED1/Schematic_PCB/MIC_760_V2/PCB_TopLayer.pdf

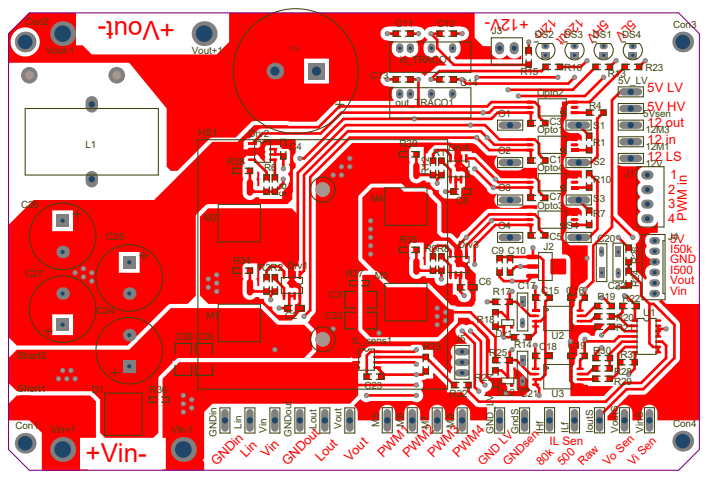
[picture p436: page 1]
