NicolaiFransen/Semester-Project-PED1/Reports/Pictures/P1/Flow_chart/2018_12_17Flow_chart_MPPT_Buck_Boost_converter.pdf

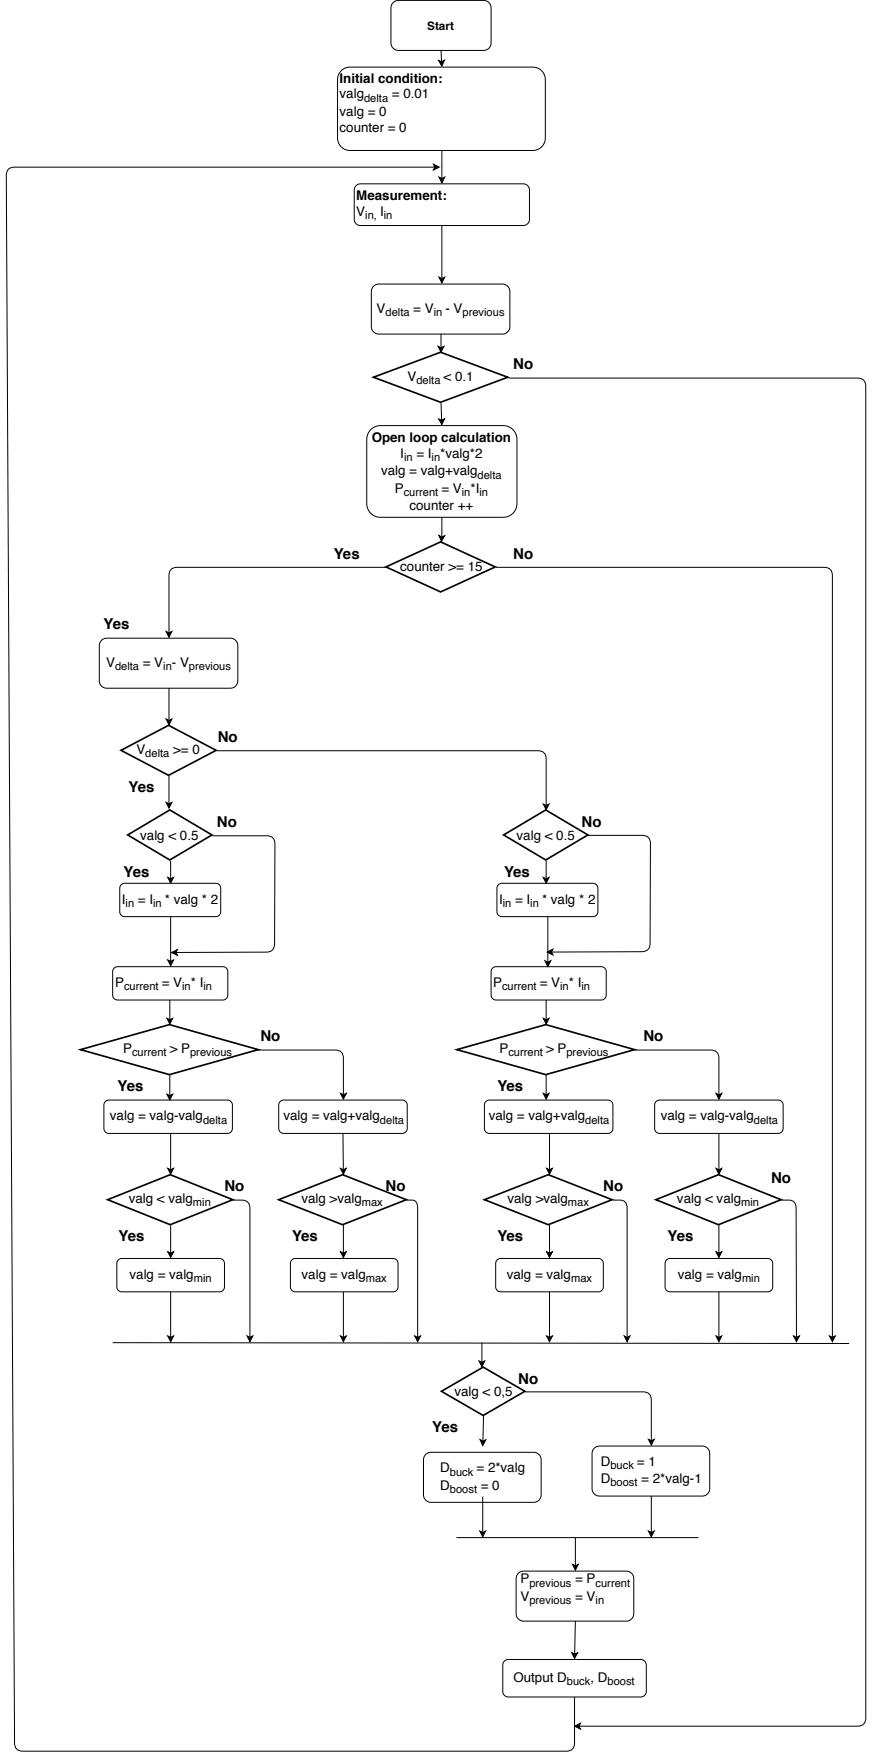
[picture p437: page 1]
Start; Initial condition: valgdelta; valg = 0 counter = 0; Measurement: Vin,; counter >= 15; Vdelta; = Vin; - Vprevious; Yes; Pprevious; = Pcurrent; Vprevious; Output Dbuck; , Dboost; valg < 0,5; Dbuck = 2*valg; Dboost; Dbuck = 1; = 2*valg-1; Pcurrent > Pprevious; Pcurrent = Vin; * Iin; valg = valgmax; valg = valg-valgdelta; valg = valg+valgdelta; valg = valgmin; valg < 0.5; * valg * 2; Vdelta < 0.1; = Iin; *valg*2; *Iin; valg >valgmax; valg < valgmin

Open loop calculation
valg = valg+valgdelta
Pcurrent = Vin
counter ++

valg >valgmax valg < valgmin

valg = valgmin valg = valgmax
