NicolaiFransen/Semester-Project-PED1/Others/HighVoltage/Labexercise3/Single stage impulse generator circuit (b).pdf

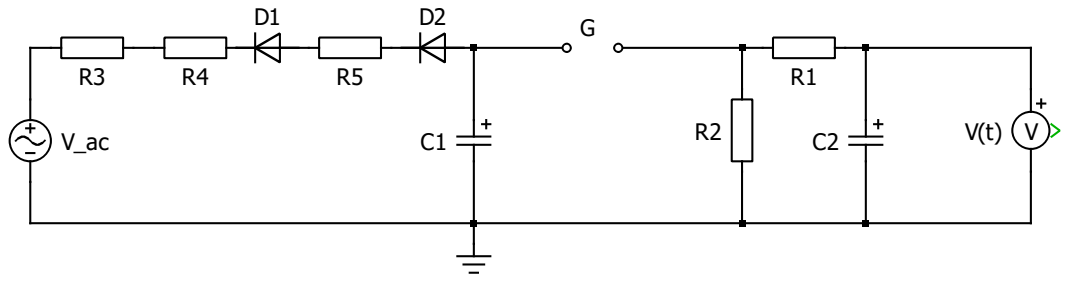
[picture p438: page 1]
