NicolaiFransen/Semester-Project-PED1/Simulations/MOSFET_spice_simulation/LTSpice_simulation/MOSFET_boost.asc

C1: cap; 800e-6
C2: cap; 18n
C4: cap; 5p
L1: ind; 1.7e-3
M1: nmos; IPB200N15N3
M2: nmos; IPB200N15N3
M3: nmos; IPB200N15N3
M4: nmos; IPB200N15N3
R1: res; 25
R2: res; 25
R3: res; 27
R4: res; 25
R5: res; 100
R6: res; 200m
R7: res; 0.1
V1: voltage; 0
V2: voltage; PULSE(0 12 0 10n 10n 12e-6 20e-6 5000)
V3: voltage; 12
V4: voltage; 36
V5: voltage; PULSE(0 12 12.5e-6 10n 10n 7e-6 20e-6 5000)
Named nets: 0, L_out, L_in
.tran 0 4m 0 1e-6
For Boost Duty cycle = 0.6, 36 V -->90 V
