NicolaiFransen/Semester-Project-PED1/Simulations/MOSFET_spice_simulation/LTSpice_simulation/MOSFET_buck.asc

C1: cap; 800e-6
L1: ind; 1e-3
M1: nmos; IPB200N15N3
M2: nmos; IPB200N15N3
M3: nmos; IPB200N15N3
M4: nmos; IPB200N15N3
R1: res; 0.4
R2: res; 25
R3: res; 2
R4: res; 25
R5: res; 25
R6: res; 200m
R7: res; 0.1
R8: res; 20
V1: voltage; PULSE(0 12 13.5e-6 1n 1n 6.33e-6 20e-6 5000)
V2: voltage; 12
V3: voltage; PULSE(0 12 0 1n 1n 13.e-6 20e-6 5000)
V4: voltage; 36
V5: voltage; 0
Named nets: 0, V_gate_M2, V_L_in, V_gate_M1
.tran 0 1m 0 1e-8
