NicolaiFransen/Semester-Project-PED1/Simulations/MOSFET_spice_simulation/LTSpice_simulation/MOSFET.asc

C1: cap; 800e-6
L1: ind; 1e-3
M1: nmos; IPB200N15N3
M2: nmos; IPB200N15N3
R1: res; 25
R2: res; 25
R3: res; 2
V1: voltage; PULSE(0 12 13.5e-6 1n 1n 6.33e-6 20e-6 5000)
V3: voltage; PULSE(0 12 0 1n 1n 13.e-6 20e-6 5000)
V4: voltage; 36
Named nets: 0, Vd_M1, Vg_M1, Vd_M2, Vg_M2
.tran 0 10m 0 1e-8
