NicolaiFransen/Semester-Project-PED1/(list of files, drawings)

Other design files:
Calculation/Sensors/Simulation_voltage_sensor.ms13
Schematic_PCB/Components_models/Resistors/Panasonic_ERJ_1206/Panasonic_ERJ_1206.PcbLib
Schematic_PCB/Components_models/Resistors/Panasonic_ERJ_12061/Panasonic_ERJ_1206.PcbLib
Schematic_PCB/MIC_760/Drivers.SchDoc
Schematic_PCB/MIC_760/MIC_760.PrjPcb
Schematic_PCB/MIC_760/PCB1.PcbDoc
Schematic_PCB/MIC_760/PCB2.PcbDoc
Schematic_PCB/MIC_760/PCB3.PcbDoc
Schematic_PCB/MIC_760/PCB4.PcbDoc
Schematic_PCB/MIC_760/PCB5.PcbDoc
Schematic_PCB/MIC_760/Power_supplies.SchDoc
Schematic_PCB/MIC_760/Signal_processing.SchDoc
Schematic_PCB/MIC_760/Switches.SchDoc
Schematic_PCB/MIC_760_V2/Drivers_V2.SchDoc
Schematic_PCB/MIC_760_V2/HeatSink.SchDoc
Schematic_PCB/MIC_760_V2/MIC_760_V2.PrjPcb
Schematic_PCB/MIC_760_V2/PCB5_V2.PcbDoc
Schematic_PCB/MIC_760_V2/PcbLib1.PcbLib
Schematic_PCB/MIC_760_V2/Power_supplies_V2.SchDoc
Schematic_PCB/MIC_760_V2/Schlib1.SchLib
Schematic_PCB/MIC_760_V2/Signal_processing_V2.SchDoc
Schematic_PCB/MIC_760_V2/Switches_V2.SchDoc
Simulations/MOSFET_spice_simulation/MOSFET.DSN
Simulations/MOSFET_spice_simulation/mosfet.opj
