NicolaiFransen/Semester-Project-PED1/(commit log)

2018-09-11 Init Questions High Voltage
2018-09-13 Fundamentals of Power Electronics
2018-09-20 Graph of Transfer Ratio
    [Transfer Ratio.xlsx]
2018-09-22 Added this book on power electronics and PV, many MPPT algorithms are described
2018-09-23 Buck-Boost converter .tex
    Added the .tex file with the background and introduction to both the unidirectional and bidirectional BuckBoost converter. Also I added 2 images with the schematics. However I'm not sure about the folders where I put everything. Plus, the document I created is set as a standalone file. If the document organizer tells me the name of my section I'll do the appropriate changes
2018-09-24 Added Grid converters for PV and WPS, from Remus Teodorescu.
    It's an excellent resource in power electronics modelling and contorl
2018-09-25 Added paper on BuckBoost modelling and MPPT explanation
2018-09-30 Application note regarding noninverting BB converter
    The main highlights are the component sizing section and the duty cycle calculation with buck boost mode logic
2018-10-04 Buck-Boost mode explanation, SEPIC circuit figure
2018-10-05 Buck and Boost corrections
2018-10-05 Minor corrections in buck and boost sections
2018-10-09 Experimenatl circuit
2018-10-10 TI AN regarding driver circuits
2018-10-20 Updated Script for including boost converter
    Right now the model is created but there's some kind of error and the DC gain is not correct. In any case when the error is solved the scriptting will be ready
2018-10-21 Working script, calculated Line2Output of Buck, Boost converters'
2018-10-24 Derivation of Vo/Vg in buck and boost converters. Vo/D in buck converter.
2018-10-25 Update Others/Semester group meeting/Group_meeting_2.xls
    Group meeting 2
    [Group_meeting_2.xls]
2018-10-26 Datasheets of voltage OPAM and current sensor
2018-10-26 simulation and excel
    [ComponentSizing.xlsx]
2018-10-27 Voltage sensor
2018-10-28 Current sensor circuit explanation
2018-10-28 Voltage sensor simulation
    [Simulation_voltage_sensor.ms13]
2018-10-30 HV reports added. Project system description and datasheets
    [Transfer Ratio.xlsx]
2018-10-30 Input filter for voltage sensor
    [Simulation_voltage_sensor.ms13]
2018-10-31 Updated component list
    [ComponentsNeeded.xlsx]
2018-11-03 New folder for placing PCB and Sch. .gitignore modified for avoiding crappy folders from altium component import
    [MIC_760.PrjPcb, PCB1.PcbDoc, PcbLib1.PcbLib, Schlib1.SchLib, Sheet1.SchDoc]
2018-11-05 footprint update
    [Sheet1.SchDoc]
2018-11-05 Created the schematic sheets
    [Drivers.SchDoc, MIC_760.PrjPcb, Power_supplies.SchDoc, Sheet1.SchDoc, Signal_processing.SchDoc, Switches.SchDoc]
2018-11-05 Voltage sensor latex
2018-11-05 Signal filtering at 80%
    [MIC_760.PrjPcb, Signal_processing.SchDoc, Switches.SchDoc]
2018-11-05 exporting components??
    [Drivers.SchDoc]
2018-11-05 Added current sensor to schematic
    [Drivers.SchDoc, Signal_processing.SchDoc]
2018-11-06 Insert P0 in P1
2018-11-06 SCH Updates
    [Drivers.SchDoc, MIC_760.PrjPcb, Power_supplies.SchDoc, Signal_processing.SchDoc, Switches.SchDoc]
2018-11-07 variable step buck-boost
2018-11-07 Components and latex stuff
    [ComponentsNeeded.xlsx]
2018-11-07 Added calculation for mosfet body diode recovery reverse
2018-11-07 V1.0_Schematic
    First iteration of the schematic with all the values included.
    [Drivers.SchDoc, MIC_760.PrjPcb, Power_supplies.SchDoc, Signal_processing.SchDoc, Switches.SchDoc]
2018-11-07 gate driver caps calculation
2018-11-07 V1.3FootprintsAdded
    First iteration of footprints, error correction and others.
    [Drivers.SchDoc, MIC_760.PrjPcb, PCB1.PcbDoc, Power_supplies.SchDoc, Signal_processing.SchDoc, Switches.SchDoc]
2018-11-08 Recovery of the files that are expected to recover the components values
    [Drivers.SchDoc, MIC_760.PrjPcb, PCB1.PcbDoc, Power_supplies.SchDoc, Signal_processing.SchDoc, Switches.SchDoc]
2018-11-08 V1.4_ValuesTest
    Values of the switches schematic were changed in order to see if the problem persists.
    [Switches.SchDoc]
2018-11-08 V1.4_SchDone
    After seeing that it is working correctly, I have finished the Schematic and it can now be corrected.
    [Switches.SchDoc]
2018-11-09 Schematic comments V1
2018-11-09 PCB test prep
2018-11-09 updated current sensor with higher cutoff freq
2018-11-10 V3.1_LayoutPresented
    All subcircuits are done, power stages are presented, optos outputs still hanging, as well as minor details like LEDs or TestPoints. Coil and electro capacitors are still not located in the board.
    [Drivers.SchDoc, PCB1.PcbDoc, Power_supplies.SchDoc, Signal_processing.SchDoc, Switches.SchDoc]
2018-11-10 PCB_LayoutV1
    First iteration of the PCB, main problem: PWM paths are too close to each other and they are too long. Also there is a Vout line dividing power and control, maybe it isn't optimal...
    [Drivers.SchDoc, MIC_760.PrjPcb, PCB1.PcbDoc, PCB2.PcbDoc, Switches.SchDoc]
2018-11-10 PCB_LayoutV1.1
    Minor changes
    [PCB2.PcbDoc]
2018-11-11 Added necessary trace width for 15 A, 5ºC, copper thickness 2 oz
2018-11-11 First version of current sensor.
2018-11-11 PCB_LayoutV2.1
    Changes after the Nico's fuck me up.
    [MIC_760.PrjPcb, PCB2.PcbDoc, PCB3.PcbDoc, PCB4.PcbDoc, Power_supplies.SchDoc, Signal_processing.SchDoc, Switches.SchDoc]
2018-11-11 MPPT working in buck and boost
2018-11-11 PCB_LayoutV2.2
    El bicho
    [PCB2.PcbDoc, PCB3.PcbDoc, PCB4.PcbDoc]
2018-11-12 PCB_LayoutV2.3
    Second iteration of pcb is partially complited. Power side is finished as well as the optos. Dezso is going to go crazy about it.
    [PCB4.PcbDoc]
2018-11-12 Added component sizing master file and mosfet and driver seed file
2018-11-12 PCB_LayoutV2.4
    Sensors added.
    [Drivers.SchDoc, MIC_760.PrjPcb, PCB4.PcbDoc, Power_supplies.SchDoc, Signal_processing.SchDoc]
2018-11-12 power supplies in P1
2018-11-12 PCB_Layout2.5
    Final version before checklisting.
    [Drivers.SchDoc, MIC_760.PrjPcb, PCB4.PcbDoc, Power_supplies.SchDoc, Signal_processing.SchDoc, Switches.SchDoc]
2018-11-13 PCB_Layout2.6
    I don't know what changes are there here.
    [Drivers.SchDoc, MIC_760.PrjPcb, PCB4.PcbDoc, Signal_processing.SchDoc]
2018-11-13 PDF of schematic
2018-11-13 HV exercise 7, voltage sensor edit
2018-11-13 PCB_Layout3.1
    PCB after checklist.
    [PCB4.PcbDoc]
2018-11-13 Added switch selection references
2018-11-14 Updated schematic of the current sensor
2018-11-14 PCB_LayoutV4.1
    Professional certified.
    [MIC_760.PrjPcb, PCB2.PcbDoc, PCB4.PcbDoc]
2018-11-14 Footprints Checked
    One of the conectors was wrong OMG
    [MIC_760.PrjPcb, PCB1.PcbDoc, PCB2.PcbDoc, PCB3.PcbDoc, PCB4.PcbDoc, Signal_processing.SchDoc]
2018-11-14 Gerber Files
    [MIC_760.PrjPcb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]
2018-11-15 Minor Updates
    [MIC_760.PrjPcb, PCB4.PcbDoc]
2018-11-15 Voltage sensor pics
2018-11-15 PCB_Sent!
    Pray for the wold
    [MIC_760.PrjPcb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]
2018-11-15 sensor edits
    [ComponentsNeeded.xlsx]
2018-11-15 Updated switch sizing and added files for LTSpice simulation. Heat sink sizing started
    [MOSFET.DSN, mosfet.opj]
2018-11-15 new flowchart
2018-11-16 calculations and report of switch sizing and heat sink sizing
2018-11-16 Added current sensor datasheet tto bibliography
2018-11-16 Update filter freq
2018-11-19 Driver writing 40%. Completed FOM mosfet
2018-11-20 move flow chart
2018-11-20 PCB pdf in colors
2018-11-20 Scripts for writing calculations and P1 writing
    [Group_meeting_3.xls]
2018-11-20 Test with PCB fails
2018-11-20 Driver P1 in progress and MOSFET minor corrections.
2018-11-21 LatexCorrections and PCB V2 Start
    [Drivers_V2.SchDoc, MIC_760_V2.PrjPcb, PCB5.PcbDoc, PCB5_V2.PcbDoc, PcbLib1.PcbLib, Power_supplies_V2.SchDoc, Schlib1.SchLib, Signal_processing_V2.SchDoc]
2018-11-21 PCB__IT2_V1.0
    Started with the new PCB, all footprints done.
    [Drivers_V2.SchDoc, MIC_760_V2.PrjPcb, PCB4.PcbDoc, PCB5_V2.PcbDoc, Power_supplies_V2.SchDoc, Signal_processing_V2.SchDoc, Switches_V2.SchDoc]
2018-11-22 PCB_IT2_V1.1
    Power side completed
    [HeatSink.SchDoc, MIC_760_V2.PrjPcb, PCB4.PcbDoc, PCB5_V2.PcbDoc, Switches_V2.SchDoc]
2018-11-22 PCB_IT2_V1.2
    The pro has finished on time as expected.
    [Drivers_V2.SchDoc, PCB4.PcbDoc, PCB5_V2.PcbDoc, Power_supplies_V2.SchDoc, Signal_processing_V2.SchDoc]
2018-11-23 PCB_IT2_V1.3
    Minor corrections after meeting.
    [PCB5_V2.PcbDoc]
2018-11-23 gain calculations of voltage sensors
2018-11-24 Section 5.3
    Modify the graphs and flow chart
2018-11-25 Test of power supplies
2018-11-25 Test of optos and drivers
2018-11-25 PCB_layout writing
    Still missing pictures.
    [PCB5_V2.PcbDoc]
2018-11-25 P1 driver section in da way
2018-11-25 Comments on pcb
2018-11-25 Component request isolation pcb
2018-11-26 Test sensors
2018-11-27 graphs simulations
    [irradiance_input_1ms.csv]
2018-11-27 High voltage
2018-11-28 Draft 1 of MOSFET and driver P1
2018-11-28 Calculation support files for mosfet and driver circuitry
2018-11-28 Updated MPPT algorithm, added model w resistive input
    After discussion with Thassilo and Aitor some comments were added to the code. The new model is a workaround to the PV input as the available lab material is _tight_
2018-11-29 Added software low pass filter plecs model
2018-11-29 Updated Schematic components values and sheet description
    missing stuff: Change signals names that can lead to errors in current sensors, as frequency changed, change driver name, get final implementation values of current sensor LF filter
    [Drivers_V2.SchDoc, HeatSink.SchDoc, Power_supplies_V2.SchDoc, Signal_processing_V2.SchDoc, Switches_V2.SchDoc]
2018-12-03 Edit of sensor ordering
2018-12-03 Correction of Lab 2 ripple voltage calculation
2018-12-04 Create Flow chart_MPPT.pdf
2018-12-04 Thassilo's comments corrected on pcb layout
2018-12-05 Corrected current sensor comments and added connection picture
2018-12-05 PCB and Schematics added to P1
    [Drivers_V2.SchDoc, HeatSink.SchDoc, MIC_760_V2.PrjPcb, PCB5_V2.PcbDoc, Power_supplies_V2.SchDoc, Signal_processing_V2.SchDoc, Switches_V2.SchDoc]
2018-12-05 Fix of Aitors schematic input
2018-12-05 Fixed current sensor placement after Lajos comment
2018-12-05 changing the location for reference advantage buck and boost
2018-12-05 Chapter 3 rewritten.
    [MIC_760_V2.PrjPcb, PCB5_V2.PcbDoc]
2018-12-06 PCB and schematic comments solved and trace sizing
2018-12-06 openloop buck test
2018-12-10 Increased system speed and condition cange conditions
    The speed has been increased by chaging the intiial delta D from 0.01 to 0.05. The power increased condition has been added as it was missing.
2018-12-10 script matlab to plot the buck graphs
    [tek0001CH1.csv, voltages_currents_ALL.csv]
2018-12-10 results boost mode
    [voltages_currents_boost.csv]
2018-12-11 add measurement of today
    [100Hz_all.csv, 10Hz_ALL.csv, Pin.csv, Vin_Iin_STC.csv, tek0000ALL.csv, tek0000CH3Vinripple.csv, tek0000CH4.csv, tek0001ALL.csv]
2018-12-12 data for open loop simulation
    [current_inductor.csv, input_voltage_ripple.csv]
2018-12-12 data MPPT boost 200 irradiance
    [200irr.csv, current_inductor.csv, input_voltage_ripple.csv]
2018-12-12 duty cycles buck mode
    [duty_cycles_buck.csv]
2018-12-12 graphs duty cycles buck mode
2018-12-12 boost data 100Hz
    [voltages_currents_boost_100Hz.csv, voltages_currents_boost_10Hz.csv]
2018-12-12 Switch selections
2018-12-12 Driver request
2018-12-13 measurment from 13.12.18
    [Changing 1 to 0.8.csv, changing 1 to 0.8 using.csv, changing temperature 25 to 15.csv, changing temperature 25 to 20.csv, tek0006.csv, temperature.xlsx]
2018-12-13 Future work - PCB improvements
2018-12-13 Software filtering and algorithm discussion
    [softwarefiltercurrent.csv]
2018-12-14 DIscussion driver
2018-12-14 MPPT test and validation finished
    [15.csv, 240.csv, 25.csv, 300.csv]
2018-12-14 Commented switching frequency and fixed typo
2018-12-14 Remove comment in voltage sensors
2018-12-14 Insert table of figures
2018-12-14 PCB improvements corrected
2018-12-16 Corrections up to PCB design
2018-12-17 paper constant voltage
2018-12-17 change buck-converter picture
2018-12-17 delee flip mosfet 1
2018-12-17 add another reference for constant voltage
2018-12-17 rewrite constant voltage
2018-12-18 Output voltage simulation
2018-12-18 add new reference for the efficiency for buck
2018-12-18 Changed FET to M
2018-12-18 Check buck/boost mode/side
2018-12-18 all figure change to M instead of Fet
2018-12-18 change figure current sensor placement
2018-12-18 Added DSP filtering book to bib
2018-12-18 Rewritten software filter
2018-12-18 Dependencies of software filter
    [2018_12_18_Currentwithfilter.csv, 2018_12_18_Currentwithout.csv]
2018-12-18 Changed sw filter figure
2019-01-06 This is how you create a power point template Nicolai
2019-01-06 Added a paper on bypass diode and partial shading
2019-01-07 Monochrome pdf
    [MIC_760_V2.PrjPcb]
2019-01-08 Thermal test
    [Thermal test final.xlsx]
2019-01-08 AT's amazing questions answers and gif creation
    [MIC_760_V2.PrjPcb]
2019-01-08 MIC over forward diode
